DavidMFlynn/SerialMRRC/Parts.txt

Parts

Controller
===================================================
PIC16F15345-I/SO	Microcontroller	20SOIC
THVD1550DR		RS485 Transciever 8SOIC

296-14844-1-ND	SN74HC251DR 1 of 8 selector
296-14847-1-ND	SN74HC259DR IC 8BIT ADDRESSABLE LATCH 16SOIC

MCP2200T-I/SOCT-ND	USB to Serial 20-SOIC
X1037-ND	ECS-120-20-4X 12MHz
ED2982-ND	USB-B1HSW6 USB B

TB001-500-08BE		Terminal Block 8-pos 5mm pitch
ED2739-ND	OSTTE160104	Terminal Block 16-pos 3.5mm pitch

WM4902-ND	0705530003	Connector Header R/A 4 pin
WM2902-ND	0050579404	Connector Recepticle 4 pin
WM2512-ND	0016020103	Conn Socket 22-24AWG Crimp Gold
WM2512CT-ND	0016020087	Conn Socket 22-24AWG Crimp Gold

2449-J114AF2CS12VDC.53-ND  J114AF2CS12VDC.53 12VDC DPDT Relay
SSM6N7002CFULFCT-ND		SSM6N7002CFU,LF		MOSFET 2N-CH 60V 0.17A US6

Signal Head
===================================================
XZM2MR53W-1	Red 0603 LED
XZM2DG53W-1	Green 0603 LED
XZM2ACY53W-1	Yellow 0603 LED
