DavidMFlynn/SerialMRRC/Datasheets/8-bit PIC MCU-2025-03-23.csv

Device Name | Status | 5K Pricing | Program Memory Size (Kbytes) | RAM (bytes) | EEPROM / HEF | Pin count | Max. CPU Speed MHz | Peripheral Pin Select (PPS) | Internal Oscillator | # of Comparators | Operational Amplifier | Total # of A/D channels | Max A/D Resolution (bits) | ADCC with Computation | Number of D/A Converters | Max D/A Resolution (bits) | Internal Voltage Reference (Bandgap) | Zero Cross detect | Slope Compensation / Programmable Ramp Generator | Data Signal Modulator (DSM) | Max 8 Bit Digital Timers | Max 16 Bit Digital Timers | Signal Measurement Timer | Hardware Limit Timer | Max # PWM outputs (including complementary outputs) | Max PWM Resolution (bits) | Angular Timer | Math Accelerator | UART | SPI? | I2C | Number of USB Modules | Windowed Watchdog Timer (WWDT) | CRC/Scan | Configurable Logic Cell Modules (CLC) | Complementary Waveform Generator (CWG) / Complementary Output Generator (COG) | Numerically Controlled Oscillator (NCO) | Programmable switched mode controller | Cap. Touch Channels | Segment LCD | Temp. Range Min. | Temp. Range Max. | Operation Voltage Min.(V) | Operation Voltage Max.(V) | High Voltage Capable | Packages
PIC10F200 | In Production | $0.43 | 0.375 | 16 | 0 | 6 | 44 | No | 4 MHz | 0 | 0 | 0 | 0 | No | 0 | 0 | No | No | 0 | 0 | 1 | 0 | 0 | 0 | 0 | 0 | No | No | 0 | 0 | 0 | 0 | No | No | 0 | 0 | 0 | 0 | 0 | 0 | -40 | 125 | 2 | 5.5 | No | 6/SOT-23,8/DFN,8/PDIP
PIC10F202 | In Production | $0.47 | 0.75 | 24 | 0 | 6 | 4 | No | 4 MHz | 0 | 0 | 0 | 0 | No | 0 | 0 | No | No | 0 | 0 | 1 | 0 | 0 | 0 | 0 | 0 | No | No | 0 | 0 | 0 | 0 | No | No | 0 | 0 | 0 | 0 | 0 | 0 | -40 | 125 | 2 | 5.5 | No | 6/SOT-23,8/DFN,8/PDIP
PIC10F204 | In Production,Please consider device: PIC10F322 | $0.47 | 0.375 | 16 | 0 | 6 | 4 | No | 4 MHz | 1 | 0 | 0 | 0 | No | 0 | 0 | Yes | No | 0 | 0 | 1 | 0 | 0 | 0 | 0 | 0 | No | No | 0 | 0 | 0 | 0 | No | No | 0 | 0 | 0 | 0 | 0 | 0 | -40 | 125 | 2 | 5.5 | No | 6/SOT-23,8/DFN,8/PDIP
PIC10F220 | In Production | $0.47 | 0.375 | 16 | 0 | 6 | 8 | No | 4 MHz, 8 MHz | 0 | 0 | 2 | 8 | No | 0 | 0 | Yes | No | 0 | 0 | 1 | 0 | 0 | 0 | 0 | 0 | No | No | 0 | 0 | 0 | 0 | No | No | 0 | 0 | 0 | 0 | 2 | 0 | -40 | 125 | 2 | 5.5 | No | 6/SOT-23,8/DFN,8/PDIP
PIC10F320 | In Production | $0.47 | 0.448 | 64 | 0 / HEF | 6 | 16 | No | 16 MHz, 32 kHz | 0 | 0 | 3 | 8 | No | 0 | 0 | Yes | No | 0 | 0 | 2 | 0 | 0 | 0 | 4 | 10 | No | No | 0 | 0 | 0 | 0 | No | No | 1 |  | 1 | 0 | 3 | 0 | -40 | 125 | 1.8 | 5.5 | No | 6/SOT-23,8/DFN,8/PDIP
PIC10F206 | In Production | $0.49 | 0.75 | 24 | 0 | 6 | 4 | No | 4 MHz | 1 | 0 | 0 | 0 | No | 0 | 0 | Yes | No | 0 | 0 | 1 | 0 | 0 | 0 | 0 | 0 | No | No | 0 | 0 | 0 | 0 | No | No | 0 | 0 | 0 | 0 | 1 | 0 | -40 | 125 | 2 | 5.5 | No | 6/SOT-23,8/DFN,8/PDIP
PIC10F222 | In Production,Please consider device: PIC10F322 | $0.49 | 0.75 | 23 | 0 | 6 | 8 | No | 4 MHz, 8 MHz | 0 | 0 | 2 | 8 | No | 0 | 0 | Yes | No | 0 | 0 | 1 | 0 | 0 | 0 | 0 | 0 | No | No | 0 | 0 | 0 | 0 | No | No | 0 | 0 | 0 | 0 | 2 | 0 | -40 | 125 | 2 | 5.5 | No | 6/SOT-23,8/DFN,8/PDIP
PIC10F322 | In Production | $0.50 | 0.896 | 64 | 0 / HEF | 6 | 16 | No | 16 MHz, 32 kHz | 0 | 0 | 3 | 8 | No | 0 | 0 | Yes | No | 0 | 0 | 2 | 0 | 0 | 0 | 4 | 10 | No | No | 0 | 0 | 0 | 0 | No | No | 1 |  | 1 | 0 | 3 | 0 | -40 | 125 | 1.8 | 5.5 | No | 6/SOT-23,8/DFN,8/PDIP,14/PDIP
PIC12F1571 | In Production | $0.50 | 1.75 | 128 | 0 / HEF | 8 | 32 | No | 32 MHz, 32 kHz | 1 | 0 | 4 | 10 | No | 1 | 5 | Yes | No | 0 | 0 | 2 | 4 | 0 | 0 | 4 | 16 | No | No | 0 | 0 | 0 | 0 | No | No | 0 |  | 0 | 0 | 4 | 0 | -40 | 125 | 1.8 | 5.5 | No | 8/DFN,8/MSOP,8/PDIP,8/SOIC,8/UDFN
PIC16F54 | In Production | $0.55 | 0.75 | 25 | 0 | 18 | 20 | No | No | 0 | 0 | 0 | 0 | No | 0 | 0 | No | No | 0 | 0 | 1 | 0 | 0 | 0 | 0 | 0 | No | No | 0 | 0 | 0 | 0 | No | No | 0 | 0 | 0 | 0 | 0 | 0 | -40 | 125 | 2 | 5.5 | No | 18/PDIP,18/SOIC,20/SSOP
PIC12F1501 | In Production | $0.56 | 1.75 | 64 | 0 / HEF | 8 | 20 | No | 16 MHz, 32 kHz | 1 | 0 | 4 | 10 | No | 1 | 5 | Yes | No | 0 | 0 | 2 | 1 | 0 | 0 | 5 | 10 | No | No | 0 | 0 | 0 | 0 | No | No | 2 |  | 1 | 0 | 4 | 0 | -40 | 125 | 1.8 | 5.5 | No | 8/DFN,8/MSOP,8/PDIP,8/SOIC,8/UDFN
PIC12F1572 | In Production | $0.56 | 3.5 | 256 | 0 / HEF | 8 | 32 | No | 32 MHz, 32 kHz | 1 | 0 | 4 | 10 | No | 1 | 5 | Yes | No | 0 | 0 | 2 | 4 | 0 | 0 | 4 | 16 | No | No | 1 | 0 | 0 | 0 | No | No | 0 |  | 0 | 0 | 4 | 0 | -40 | 125 | 1.8 | 5.5 | No | 8/DFN,8/MSOP,8/PDIP,8/SOIC,8/UDFN
PIC16F15313 | In Production | $0.56 | 3.5 | 256 | 0 / HEF | 8 | 32 | Yes | 32 MHz, 32 kHz | 1 | 0 | 5 | 10 | No | 1 | 5 | No | Yes | 0 | 0 | 1 | 2 | 0 | 1 | 10 | 10 | No | No | 1 | 1 | 1 | 0 | No | No | 4 | 1 | 1 | 0 | 0 | 0 | -40 | 125 | 1.8 | 5.5 | No | 8/PDIP,8/SOIC,8/UDFN
PIC12F508 | In Production,Please consider device: PIC16F15313 | $0.57 | 0.75 | 25 | 0 | 8 | 4 | No | 4 MHz | 0 | 0 | 0 | 0 | No | 0 | 0 | No | No | 0 | 0 | 1 | 0 | 0 | 0 | 0 | 0 | No | No | 0 | 0 | 0 | 0 | No | No | 0 | 0 | 0 | 0 | 0 | 0 | -40 | 125 | 2 | 5.5 | No | 8/DFN,8/MSOP,8/PDIP,8/SOIC
PIC16F527 | In Production | $0.59 | 1.5 | 68 | 64 / HEF | 20 | 20 | No | 4 MHz, 8 MHz | 2 | 2 | 8 | 8 | No | 0 | 0 | Yes | No | 0 | 0 | 1 | 0 | 0 | 0 | 0 | 0 | No | No | 0 | 0 | 0 | 0 | No | No | 0 | 0 | 0 | 0 | 8 | 0 | -40 | 125 | 2 | 5.5 | No | 20/PDIP,20/QFN,20/SOIC,20/SSOP,20/UQFN
PIC16F15323 | In Production | $0.61 | 3.5 | 256 | 0 / HEF | 14 | 32 | Yes | 32 MHz, 32 kHz | 2 | 0 | 11 | 10 | No | 1 | 5 | No | Yes | 0 | 0 | 1 | 2 | 0 | 1 | 10 | 10 | No | No | 1 | 1 | 1 | 0 | No | No | 4 | 1 | 1 | 0 | 0 | 0 | -40 | 125 | 1.8 | 5.5 | No | 14/PDIP,14/SOIC,14/TSSOP,16/UQFN,16/VQFN
PIC12F509 | In Production,Please consider device: PIC16F15313 | $0.62 | 1.5 | 41 | 0 | 8 | 4 | No | 4 MHz | 0 | 0 | 0 | 0 | No | 0 | 0 | No | No | 0 | 0 | 1 | 0 | 0 | 0 | 0 | 0 | No | No | 0 | 0 | 0 | 0 | No | No | 0 | 0 | 0 | 0 | 0 | 0 | -40 | 125 | 2 | 5.5 | No | 8/DFN,8/MSOP,8/PDIP,8/SOIC,8/SOIJ
PIC12F519 | In Production | $0.64 | 1.5 | 41 | 64 | 8 | 8 | No | 4 MHz, 8 MHz | 0 | 0 | 0 | 0 | No | 0 | 0 | No | No | 0 | 0 | 1 | 0 | 0 | 0 | 0 | 0 | No | No | 0 | 0 | 0 | 0 | No | No | 0 | 0 | 0 | 0 | 0 | 0 | -40 | 125 | 2 | 5.5 | No | 8/DFN,8/MSOP,8/PDIP,8/SOIC
PIC12LF1552 | In Production | $0.64 | 3.5 | 256 | 0 / HEF | 8 | 32 | No | 16 MHz, 32 kHz | 0 | 0 | 5 | 10 | No | 0 | 0 | No | No | 0 | 0 | 1 | 0 | 0 | 0 | 0 | 0 | No | No | 0 | 1 | 1 | 0 | No | No | 0 | 0 | 0 | 0 | 4 | 0 | -40 | 85 | 1.8 | 3.6 | No | 8/MSOP,8/PDIP,8/SOIC,8/UDFN
PIC16F18313 | In Production | $0.64 | 3.5 | 256 | 256 | 8 | 32 | Yes | 32 MHz, 32 kHz | 1 | 0 | 5 | 10 | No | 1 | 5 | Yes | No | 0 | 2 | 2 | 1 | 0 | 0 | 8 | 10 | No | No | 1 | 1 | 1 | 0 | No | No | 2 |  | 1 | 0 | 5 | 0 | -40 | 125 | 1.8 | 5.5 | No | 8/PDIP,8/SOIC,8/UDFN
PIC18F24Q10 | In Production | $0.65 | 16 | 1024 | 256 | 28 | 64 | Yes | 64MHZ, 64KHz | 2 | 0 | 24 | 10 | Yes | 1 | 5 | Yes | Yes | 0 | 1 | 3 | 4 | 0 | 1 | 0 | 10 | No | No | 1 | 1 | 1 | 0 | No | Yes | 0 | 1 | 0 | 0 | 24 | 0 | -40 | 125 | 1.8 | 5.5 | No | 28/QFN,28/SOIC,28/SPDIP,28/SSOP,28/UQFN,28/VQFN
PIC16F15324 | In Production | $0.67 | 7 | 512 | 0 / HEF | 14 | 32 | Yes | 32 MHz, 32 kHz | 2 | 0 | 11 | 10 | No | 1 | 5 | No | Yes | 0 | 0 | 1 | 2 | 0 | 1 | 10 | 10 | No | No | 2 | 1 | 1 | 0 | No | No | 4 | 1 | 1 | 0 | 0 | 0 | -40 | 125 | 1.8 | 5.5 | No | 14/PDIP,14/SOIC,14/TSSOP,16/UQFN,16/VQFN
PIC16F505 | In Production,Please consider device: PIC16F15324 | $0.67 | 1.5 | 72 | 0 | 14 | 20 | No | 4 MHz | 0 | 0 | 0 | 0 | No | 0 | 0 | No | No | 0 | 0 | 1 | 0 | 0 | 0 | 0 | 0 | No | No | 0 | 0 | 0 | 0 | No | No | 0 | 0 | 0 | 0 | 0 | 0 | -40 | 125 | 2 | 5.5 | No | 14/PDIP,14/SOIC,14/TSSOP,16/QFN
PIC12F510 | In Production,Please consider device: PIC16F15313 | $0.68 | 1.5 | 38 | 0 | 8 | 8 | No | 4 MHz, 8 MHz | 1 | 0 | 3 | 8 | No | 0 | 0 | Yes | No | 0 | 0 | 1 | 0 | 0 | 0 | 0 | 0 | No | No | 0 | 0 | 0 | 0 | No | No | 0 | 0 | 0 | 0 | 3 | 0 | -40 | 125 | 2 | 5.5 | No | 8/DFN,8/MSOP,8/PDIP,8/SOIC
PIC12F609 | In Production | $0.68 | 1.75 | 64 | 0 | 8 | 20 | No | 4 MHz, 8 MHz | 1 | 0 | 0 | 0 | No | 0 | 0 | Yes | No | 0 | 0 | 1 | 1 | 0 | 0 | 0 | 0 | No | No | 0 | 0 | 0 | 0 | No | No | 0 | 0 | 0 | 0 | 0 | 0 | -40 | 125 | 2 | 15 | Yes | 8/DFN,8/MSOP,8/PDIP,8/SOIC
PIC16F506 | In Production,Please consider device: PIC16F15324 | $0.68 | 1.5 | 67 | 0 | 14 | 20 | No | 4 MHz, 8 MHz | 2 | 0 | 3 | 8 | No | 0 | 0 | Yes | No | 0 | 0 | 1 | 0 | 0 | 0 | 0 | 0 | No | No | 0 | 0 | 0 | 0 | No | No | 0 | 0 | 0 | 0 | 3 | 0 | -40 | 125 | 2 | 5.5 | No | 14/PDIP,14/SOIC,14/TSSOP
PIC16F1503 | In Production | $0.70 | 3.5 | 128 | 0 / HEF | 14 | 20 | No | 16 MHz | 2 | 0 | 8 | 10 | No | 1 | 5 | Yes | No | 0 | 0 | 2 | 1 | 0 | 0 | 5 | 10 | No | No | 0 | 1 | 1 | 0 | No | No | 2 |  | 1 | 0 | 8 | 0 | -40 | 125 | 1.8 | 5.5 | No | 14/PDIP,14/SOIC,14/TSSOP,16/QFN,16/UQFN
PIC16F18323 | In Production | $0.70 | 3.5 | 256 | 256 | 14 | 32 | Yes | 32 MHz, 32 kHz | 2 | 0 | 11 | 10 | No | 1 | 5 | Yes | No | 0 | 2 | 2 | 1 | 0 | 0 | 8 | 10 | No | No | 1 | 1 | 1 | 0 | No | No | 2 |  | 1 | 0 | 8 | 0 | -40 | 125 | 1.8 | 5.5 | No | 14/PDIP,14/SOIC,14/TSSOP,16/UQFN,16/VQFN
PIC18F25Q10 | In Production | $0.70 | 32 | 2048 | 256 | 28 | 64 | Yes | 64MHZ, 64KHz | 2 | 0 | 24 | 10 | Yes | 1 | 5 | Yes | Yes | 0 | 1 | 3 | 4 | 0 | 1 | 0 | 10 | No | No | 1 | 1 | 1 | 0 | No | Yes | 0 | 1 | 0 | 0 | 24 | 0 | -40 | 125 | 1.8 | 5.5 | No | 28/QFN,28/SOIC,28/SPDIP,28/SSOP,28/VQFN
PIC16F526 | In Production,Please consider device: PIC16F15323 | $0.71 | 1.5 | 67 | 64 | 14 | 20 | No | 4 MHz, 8 MHz | 2 | 0 | 3 | 8 | No | 0 | 0 | Yes | No | 0 | 0 | 1 | 0 | 0 | 0 | 0 | 0 | No | No | 0 | 0 | 0 | 0 | No | No | 0 | 0 | 0 | 0 | 3 | 0 | -40 | 125 | 2 | 5.5 | No | 14/PDIP,14/SOIC,14/TSSOP,16/QFN
PIC16F57 | In Production | $0.71 | 3 | 72 | 0 | 28 | 20 | No | No | 0 | 0 | 0 | 0 | No | 0 | 0 | No | No | 0 | 0 | 1 | 0 | 0 | 0 | 0 | 0 | No | No | 0 | 0 | 0 | 0 | No | No | 0 | 0 | 0 | 0 | 0 | 0 | -40 | 125 | 2 | 5.5 | No | 28/PDIP,28/SOIC,28/SPDIP,28/SSOP
PIC12F1612 | In Production | $0.72 | 3.5 | 256 | 0 / HEF | 8 | 32 | No | 32 MHz, 32 kHz | 1 | 0 | 4 | 10 | No | 0 | 0 | No | Yes | 0 | 0 | 4 | 1 | 2 | 3 | 0 | 0 | No | No | 0 | 0 | 0 | 0 | Yes | Yes | 0 |  | 0 | 0 | 0 | 0 | -40 | 125 | 2.3 | 5.5 | No | 8/DFN,8/PDIP,8/SOIC
PIC12F615 | In Production | $0.77 | 1.75 | 64 | 0 | 8 | 20 | No | 4 MHz, 8 MHz | 1 | 0 | 4 | 10 | No | 0 | 0 | Yes | No | 0 | 0 | 2 | 1 | 0 | 0 | 0 | 10 | No | No | 0 | 0 | 0 | 0 | No | No | 0 | 0 | 0 | 0 | 4 | 0 | -40 | 150 | 2 | 15 | Yes | 8/DFN,8/MSOP,8/PDIP,8/SOIC
PIC12F617 | In Production | $0.77 | 3.5 | 128 | 0 / HEF | 8 | 20 | No | 4 MHz, 8 MHz | 1 | 0 | 4 | 10 | No | 0 | 0 | Yes | No | 0 | 0 | 2 | 1 | 0 | 0 | 0 | 10 | No | No | 0 | 0 | 0 | 0 | No | No | 0 | 0 | 0 | 0 | 4 | 0 | -40 | 125 | 2 | 5.5 | No | 8/DFN,8/MSOP,8/PDIP,8/SOIC
PIC12F752 | In Production,Please consider device: PIC16F1703 | $0.77 | 1.8 | 64 | 0 / HEF | 8 | 20 | No | 8 MHz | 2 | 0 | 4 | 10 | No | 1 | 5 | Yes | No | 0 | 0 | 2 | 1 | 0 | 1 | 2 | 0 | No | No | 0 | 0 | 0 | 0 | No | No | 0 |  | 0 | 0 | 4 | 0 | -40 | 125 | 2 | 5.5 | Yes | 8/DFN,8/PDIP,8/SOIC
PIC16F15325 | In Production | $0.77 | 14 | 1024 | 0 / HEF | 14 | 32 | Yes | 32 MHz, 32 kHz | 2 | 0 | 11 | 10 | No | 1 | 5 | No | Yes | 0 | 0 | 1 | 2 | 0 | 1 | 10 | 10 | No | No | 2 | 1 | 1 | 0 | No | No | 4 | 1 | 1 | 0 | 0 | 0 | -40 | 125 | 1.8 | 5.5 | No | 14/PDIP,14/SOIC,14/TSSOP,16/UQFN,16/VQFN
PIC16F15344 | In Production | $0.77 | 7 | 512 | 0 / HEF | 20 | 32 | Yes | 32 MHz, 32 kHz | 2 | 0 | 17 | 10 | No | 1 | 5 | No | Yes | 0 | 0 | 1 | 2 | 0 | 1 | 10 | 10 | No | No | 2 | 1 | 1 | 0 | No | No | 4 | 1 | 1 | 0 | 0 | 0 | -40 | 125 | 1.8 | 5.5 | No | 20/PDIP,20/QFN,20/SOIC,20/SSOP,20/UQFN
PIC16F1613 | In Production | $0.78 | 3.5 | 256 | 0 / HEF | 14 | 32 | No | 32 MHz, 32 kHz | 2 | 0 | 8 | 10 | No | 1 | 8 | Yes | Yes | 0 | 0 | 4 | 1 | 2 | 3 | 6 | 10 | No | No | 0 | 0 | 0 | 0 | Yes | Yes | 0 | 1 | 0 | 0 | 8 | 0 | -40 | 125 | 1.8 | 5.5 | No | 14/PDIP,14/SOIC,14/TSSOP,16/QFN
PIC16F18324 | In Production | $0.78 | 7 | 512 | 256 | 14 | 32 | Yes | 32 MHz, 32 kHz | 2 | 0 | 11 | 10 | No | 1 | 5 | Yes | No | 0 | 4 | 4 | 3 | 0 | 0 | 14 | 10 | No | No | 1 | 1 | 1 | 0 | No | No | 4 |  | 1 | 0 | 11 | 0 | -40 | 125 | 1.8 | 5.5 | No | 14/PDIP,14/SOIC,14/TSSOP,16/UQFN
PIC16F570 | In Production,Please consider device: PIC16F15354 | $0.78 | 3 | 132 | 64 / HEF | 28 | 20 | No | 4 MHz, 8 MHz | 2 | 2 | 8 | 8 | No | 0 | 0 | Yes | No | 0 | 0 | 1 | 0 | 0 | 0 | 0 | 0 | No | No | 0 | 0 | 0 | 0 | No | No | 0 | 0 | 0 | 0 | 8 | 0 | -40 | 125 | 2 | 5.5 | No | 28/SOIC,28/SPDIP,28/SSOP,28/UQFN
PIC16LF1554 | In Production | $0.78 | 7 | 256 | 0 / HEF | 14 | 32 | No | 32 MHz, 32 kHz | 0 | 0 | 11 | 10 | No | 0 | 0 | No | No | 0 | 0 | 2 | 1 | 0 | 0 | 0 | 0 | No | No | 1 | 1 | 1 | 0 | No | No | 0 | 0 | 0 | 0 | 11 | 0 | -40 | 85 | 1.8 | 3.6 | No | 14/PDIP,14/SOIC,14/TSSOP,16/QFN
PIC18F26Q10 | In Production | $0.78 | 64 | 3615 | 1024 | 28 | 64 | Yes | 64MHZ, 64KHz | 2 | 0 | 24 | 10 | Yes | 1 | 5 | Yes | Yes | 0 | 1 | 3 | 4 | 0 | 1 | 0 | 10 | No | No | 2 | 2 | 2 | 0 | No | Yes | 8 | 1 | 0 | 0 | 24 | 0 | -40 | 125 | 1.8 | 5.5 | No | 28/QFN,28/SOIC,28/SPDIP,28/SSOP,28/VQFN
PIC16F1703 | In Production | $0.81 | 3.5 | 256 | 0 / HEF | 14 | 32 | Yes | 32 MHz, 32 kHz | 0 | 2 | 8 | 10 | No | 0 | 0 | Yes | Yes | 0 | 0 | 2 | 1 | 0 | 0 | 2 | 10 | No | No | 0 | 1 | 1 | 0 | No | No | 0 | 0 | 0 | 0 | 8 | 0 | -40 | 125 | 1.8 | 5.5 | No | 14/PDIP,14/SOIC,14/TSSOP,16/QFN
PIC16F610 | In Production | $0.82 | 1.75 | 64 | 0 | 14 | 20 | No | 4 MHz, 8 MHz | 2 | 0 | 0 | 0 | No | 0 | 0 | Yes | No | 0 | 0 | 1 | 1 | 0 | 0 | 0 | 0 | No | No | 0 | 0 | 0 | 0 | No | No | 0 | 0 | 0 | 0 | 4 | 0 | -40 | 125 | 2 | 15 | Yes | 14/PDIP,14/SOIC,14/TSSOP,16/QFN
PIC16F753 | In Production,Please consider device: PIC16F1703 | $0.82 | 3.5 | 128 | 0 / HEF | 14 | 20 | No | 8 MHz | 2 | 1 | 8 | 10 | No | 1 | 9 | Yes | No | Yes | 0 | 3 | 1 | 0 | 2 | 0 | 0 | No | No | 0 | 0 | 0 | 0 | No | No | 0 | 1 | 0 | 0 | 8 | 0 | -40 | 125 | 2 | 5.5 | Yes | 14/PDIP,14/SOIC,14/TSSOP,16/QFN
PIC16F1574 | In Production | $0.83 | 7 | 512 | 0 / HEF | 14 | 32 | Yes | 32 MHz, 32 kHz | 2 | 0 | 8 | 10 | No | 1 | 5 | Yes | No | 0 | 0 | 2 | 9 | 0 | 0 | 6 | 16 | No | No | 1 | 0 | 0 | 0 | No | No | 0 |  | 0 | 0 | 8 | 0 | -40 | 125 | 1.8 | 5.5 | No | 14/PDIP,14/SOIC,14/TSSOP,16/UQFN
PIC16F15345 | In Production | $0.85 | 14 | 1024 | 0 / HEF | 20 | 32 | Yes | 32 MHz, 32 kHz | 2 | 0 | 17 | 10 | No | 1 | 5 | No | Yes | 0 | 0 | 1 | 2 | 0 | 1 | 10 | 10 | No | No | 2 | 1 | 1 | 0 | No | No | 4 | 1 | 1 | 0 | 0 | 0 | -40 | 125 | 1.8 | 5.5 | No | 20/PDIP,20/QFN,20/SOIC,20/SSOP,20/UQFN,20/VQFN
PIC16F18344 | In Production | $0.85 | 7 | 512 | 256 | 20 | 32 | Yes | 32 MHz, 32 kHz | 2 | 0 | 17 | 10 | No | 1 | 5 | Yes | No | 0 | 4 | 4 | 3 | 0 | 0 | 14 | 10 | No | No | 1 | 1 | 1 | 0 | Yes | No | 4 |  | 1 | 0 | 17 | 0 | -40 | 125 | 1.8 | 5.5 | No | 0/SSOP,20/PDIP,20/SOIC,20/SSOP,20/UQFN,20/VQFN
PIC16F18325 | In Production | $0.86 | 14 | 1024 | 256 | 14 | 32 | Yes | 32 MHz, 32 kHz | 2 | 0 | 11 | 10 | No | 1 | 5 | Yes | No | 0 | 4 | 4 | 3 | 0 | 0 | 14 | 10 | No | No | 1 | 2 | 2 | 0 | Yes | No | 4 |  | 1 | 0 | 11 | 0 | -40 | 125 | 1.8 | 5.5 | No | 14/PDIP,14/SOIC,14/TSSOP,16/UQFN,16/VQFN
PIC16F18424 | In Production | $0.86 | 7 | 512 | 256 | 14 | 32 | Yes | 32 MHz, 32 kHz | 2 | 0 | 11 | 12 | Yes | 1 | 5 | Yes | Yes | 0 | 1 | 4 | 4 | 1 | 3 | 0 | 10 | No | No | 1 | 1 | 1 | 0 | No | No | 4 | 2 | 1 | 0 | 0 | 0 | -40 | 125 | 1.8 | 5.5 | No | 14/PDIP,14/SOIC,14/TSSOP,16/UQFN
PIC12F1822 | In Production | $0.87 | 3.5 | 128 | 256 | 8 | 32 | No | 32 MHz, 32 kHz | 1 | 0 | 4 | 10 | No | 1 | 5 | Yes | No | 0 | 0 | 2 | 1 | 0 | 0 | 2 | 10 | No | No | 1 | 1 | 1 | 0 | No | No | 0 | 0 | 0 | 0 | 4 | 0 | -40 | 125 | 1.8 | 5.5 | No | 8/DFN,8/PDIP,8/SOIC,8/UDFN
PIC16F1704 | In Production | $0.87 | 7 | 512 | 0 / HEF | 14 | 32 | Yes | 32 MHz, 32 kHz | 2 | 2 | 8 | 10 | No | 1 | 8 | Yes | Yes | 0 | 0 | 4 | 1 | 0 | 0 | 8 | 10 | No | No | 1 | 1 | 1 | 0 | No | No | 3 | 1 | 0 | 0 | 8 | 0 | -40 | 125 | 1.8 | 5.5 | No | 14/PDIP,14/SOIC,14/TSSOP,16/QFN
PIC16F1507 | In Production | $0.88 | 3.5 | 128 | 0 / HEF | 20 | 20 | No | 16 MHz, 32 kHz | 0 | 0 | 12 | 10 | No | 1 | 5 | Yes | No | 0 | 0 | 2 | 1 | 0 | 0 | 5 | 10 | No | No | 0 | 0 | 0 | 0 | No | No | 2 |  | 1 | 0 | 12 | 0 | -40 | 125 | 1.8 | 5.5 | No | 20/PDIP,20/QFN,20/SOIC,20/SSOP,20/UQFN
PIC16F15354 | In Production | $0.88 | 7 | 512 | 0 / HEF | 28 | 32 | Yes | 32 MHz, 32 kHz | 2 | 0 | 24 | 10 | No | 1 | 5 | No | Yes | 0 | 0 | 1 | 2 | 0 | 1 | 10 | 10 | No | No | 2 | 2 | 2 | 0 | Yes | No | 4 | 1 | 1 | 0 | 0 | 0 | -40 | 125 | 1.8 | 5.5 | No | 28/QFN,28/SOIC,28/SPDIP,28/SSOP,28/UQFN,28/VQFN
PIC18F27Q10 | In Production | $0.89 | 128 | 3615 | 1024 | 28 | 64 | Yes | 64MHZ, 64KHz | 2 | 0 | 24 | 10 | Yes | 1 | 5 | Yes | Yes | 0 | 1 | 3 | 4 | 0 | 1 | 0 | 10 | No | No | 2 | 2 | 2 | 0 | No | Yes | 8 | 1 | 0 | 0 | 24 | 0 | -40 | 125 | 1.8 | 5.5 | No | 28/QFN,28/SOIC,28/SPDIP,28/SSOP,28/VQFN
PIC12F629 | In Production,Please consider device: PIC16F18313 | $0.91 | 1.75 | 64 | 128 | 8 | 20 | No | 4 MHz | 1 | 0 | 0 | 0 | No | 0 | 0 | No | No | 0 | 0 | 1 | 1 | 0 | 0 | 0 | 0 | No | No | 0 | 0 | 0 | 0 | No | No | 0 | 0 | 0 | 0 | 0 | 0 | -40 | 125 | 2 | 5.5 | No | 8/DFN,8/DFN-S,8/PDIP,8/SOIC
PIC16F1578 | In Production | $0.91 | 7 | 512 | 0 / HEF | 20 | 32 | Yes | 32 MHz, 32 kHz | 2 | 0 | 12 | 10 | No | 1 | 5 | Yes | No | 0 | 0 | 2 | 9 | 0 | 0 | 6 | 16 | No | No | 1 | 0 | 0 | 0 | No | No | 0 |  | 0 | 0 | 12 | 0 | -40 | 125 | 1.8 | 5.5 | No | 20/PDIP,20/SOIC,20/SSOP,20/UQFN
PIC16F1614 | In Production | $0.91 | 7 | 512 | 0 / HEF | 14 | 32 | Yes | 32 MHz, 32 kHz | 2 | 0 | 8 | 10 | No | 1 | 8 | Yes | Yes | 0 | 0 | 4 | 3 | 2 | 3 | 8 | 10 | Yes | Yes | 1 | 1 | 1 | 0 | Yes | Yes | 2 | 1 | 0 | 0 | 8 | 0 | -40 | 125 | 1.8 | 5.5 | No | 14/PDIP,14/SOIC,14/TSSOP,16/QFN
PIC12HV615 | In Production | $0.92 | 1.75 | 64 | 0 | 8 | 20 | No | 4 MHz, 8 MHz | 1 | 0 | 4 | 10 | No | 0 | 0 | Yes | No | 0 | 0 | 2 | 1 | 0 | 0 | 0 | 10 | No | No | 0 | 0 | 0 | 0 | No | No | 0 | 0 | 0 | 0 | 4 | 0 | -40 | 125 | 2 | 15 | Yes | 8/SOIC
PIC16F1575 | In Production | $0.92 | 14 | 1024 | 0 / HEF | 14 | 32 | Yes | 32 MHz, 32 kHz | 2 | 0 | 8 | 10 | No | 1 | 5 | Yes | No | 0 | 0 | 2 | 9 | 0 | 0 | 6 | 16 | No | No | 1 | 0 | 0 | 0 | No | No | 0 |  | 0 | 0 | 8 | 0 | -40 | 125 | 1.8 | 5.5 | No | 14/PDIP,14/SOIC,14/TSSOP,16/UQFN
PIC16F720 | In Production | $0.92 | 3.5 | 128 | 0 / HEF | 20 | 16 | No | 16 MHz | 0 | 0 | 12 | 8 | No | 0 | 0 | Yes | No | 0 | 0 | 2 | 1 | 0 | 0 | 0 | 10 | No | No | 0 | 1 | 1 | 0 | No | No | 0 | 0 | 0 | 0 | 12 | 0 | -40 | 125 | 1.8 | 5.5 | No | 20/PDIP,20/QFN,20/SOIC,20/SSOP
PIC18F25Q43 | In Production | $0.92 | 32 | 2048 | 1024 | 28 | 64 | Yes | 64MHZ | 2 | 0 | 24 | 12 | Yes | 1 | 8 | Yes | Yes | 0 | 1 | 3 | 4 | 1 | 3 | 6 | 16 | No | No | 5 | 2 | 1 | 0 | No | Yes | 8 | 3 | 3 | 0 |  | 0 | -40 | 125 | 1.8 | 5.5 | No | 28/SOIC,28/SPDIP,28/SSOP,28/VQFN
PIC16F18345 | In Production | $0.93 | 14 | 1024 | 256 | 20 | 32 | Yes | 32 MHz, 32 kHz | 2 | 0 | 17 | 10 | No | 1 | 5 | Yes | No | 0 | 4 | 4 | 3 | 0 | 0 | 14 | 10 | No | No | 1 | 2 | 2 | 0 | Yes | No | 4 |  | 1 | 0 | 17 | 0 | -40 | 125 | 1.8 | 5.5 | No | 20/PDIP,20/SOIC,20/SSOP,20/UQFN,20/VQFN
PIC16F18425 | In Production | $0.94 | 14 | 1024 | 256 | 14 | 32 | Yes | 32 MHz, 32 kHz | 2 | 0 | 11 | 12 | Yes | 1 | 5 | Yes | Yes | 0 | 1 | 4 | 4 | 1 | 3 | 0 | 10 | No | No | 1 | 2 | 2 | 0 | No | No | 4 | 2 | 1 | 0 | 0 | 0 | -40 | 125 | 1.8 | 5.5 | No | 14/PDIP,14/SOIC,14/TSSOP,16/UQFN
PIC16F18854 | In Production | $0.94 | 7 | 512 | 256 | 28 | 32 | Yes | 32 MHz, 32 kHz | 2 | 0 | 24 | 10 | Yes | 1 | 5 | Yes | Yes | 0 | 1 | 3 | 4 | 2 | 3 | 19 | 10 | No | No | 1 | 2 | 2 | 0 | No | Yes | 4 | 3 | 1 | 0 | 24 | 0 | -40 | 125 | 1.8 | 5.5 | No | 28/QFN,28/SOIC,28/SPDIP,28/SSOP,28/UQFN,28/VQFN
PIC16F1705 | In Production | $0.95 | 14 | 1024 | 0 / HEF | 14 | 32 | Yes | 32 MHz, 32 kHz | 2 | 2 | 8 | 10 | No | 1 | 8 | Yes | Yes | 0 | 0 | 4 | 1 | 0 | 0 | 8 | 10 | No | No | 1 | 1 | 1 | 0 | No | No | 3 | 1 | 0 | 0 | 8 | 0 | -40 | 125 | 1.8 | 5.5 | No | 0/TSSOP,14/PDIP,14/SOIC,14/TSSOP,16/QFN
PIC16F616 | In Production,Please consider device: PIC16F15323 | $0.95 | 3.5 | 128 | 0 | 14 | 20 | No | 4 MHz, 8 MHz | 2 | 0 | 8 | 10 | No | 0 | 0 | Yes | No | 0 | 0 | 2 | 1 | 0 | 0 | 0 | 10 | No | No | 0 | 0 | 0 | 0 | No | No | 0 | 0 | 0 | 0 | 4 | 0 | -40 | 150 | 2 | 15 | Yes | 14/PDIP,14/SOIC,14/TSSOP,16/QFN
PIC16LF1559 | In Production | $0.95 | 14 | 512 | 0 | 20 | 32 | No | 16 MHz | 0 | 0 | 17 | 10 | No | 0 | 0 | No | No | 0 | 0 | 2 | 1 | 0 | 0 | 0 | 0 | No | No | 1 | 1 | 1 | 0 | No | No | 0 | 0 | 0 | 0 | 17 | 0 | -40 | 85 | 1.8 | 3.6 | No | 20/PDIP,20/QFN,20/SSOP,20/UQFN
PIC16F15355 | In Production | $0.96 | 14 | 1024 | 0 / HEF | 28 | 32 | Yes | 32 MHz, 32 kHz | 2 | 0 | 24 | 10 | No | 1 | 5 | No | Yes | 0 | 0 | 1 | 2 | 0 | 1 | 10 | 10 | No | No | 2 | 2 | 2 | 0 | No | No | 4 | 1 | 1 | 0 | 0 | 0 | -40 | 125 | 1.8 | 5.5 | No | 28/QFN,28/SOIC,28/SPDIP,28/SSOP,28/UQFN,28/VQFN
PIC16F1618 | In Production | $0.96 | 7 | 512 | 0 / HEF | 20 | 32 | Yes | 32 MHz, 32 kHz | 2 | 0 | 12 | 10 | No | 1 | 8 | Yes | Yes | 0 | 0 | 4 | 3 | 2 | 3 | 8 | 10 | Yes | Yes | 1 | 1 | 1 | 0 | Yes | Yes | 2 | 1 | 0 | 0 | 12 | 0 | -40 | 125 | 1.8 | 5.5 | No | 14/PDIP,20/PDIP,20/QFN,20/SOIC,20/SSOP,20/UQFN
PIC16F721 | In Production | $0.96 | 7 | 256 | 0 / HEF | 20 | 16 | No | 16 MHz | 0 | 0 | 12 | 8 | No | 0 | 0 | Yes | No | 0 | 0 | 2 | 1 | 0 | 0 | 0 | 10 | No | No | 1 | 1 | 1 | 0 | No | No | 0 | 0 | 0 | 0 | 12 | 0 | -40 | 125 | 1.8 | 5.5 | No | 20/PDIP,20/QFN,20/SOIC,20/SSOP
PIC18F45Q10 | In Production | $0.97 | 32 | 2048 | 256 | 40 | 64 | Yes | 64MHZ, 64KHz | 2 | 0 | 35 | 10 | Yes | 1 | 5 | Yes | Yes | 0 | 1 | 3 | 4 | 0 | 1 | 0 | 10 | No | No | 2 | 2 | 2 | 0 | No | Yes | 8 | 1 | 0 | 0 | 35 | 0 | -40 | 125 | 1.8 | 5.5 | No | 40/PDIP,40/QFN,44/TQFP
PIC16F18444 | In Production | $0.98 | 7 | 512 | 256 | 20 | 32 | Yes | 32 MHz, 32 kHz | 2 | 0 | 17 | 12 | Yes | 1 | 5 | Yes | Yes | 0 | 1 | 4 | 4 | 1 | 3 | 0 | 10 | No | No | 1 | 1 | 1 | 0 | No | No | 4 | 2 | 1 | 0 | 0 | 0 | -40 | 125 | 1.8 | 5.5 | No | 20/PDIP,20/SOIC,20/SSOP,20/UQFN
PIC16F1508 | In Production | $1.00 | 7 | 256 | 0 / HEF | 20 | 20 | No | 16 MHz, 32 kHz | 2 | 0 | 12 | 10 | No | 1 | 5 | Yes | No | 0 | 0 | 2 | 1 | 0 | 0 | 5 | 10 | No | No | 1 | 1 | 1 | 0 | No | No | 4 |  | 1 | 0 | 12 | 0 | -40 | 125 | 1.8 | 5.5 | No | 20/PDIP,20/QFN,20/SOIC,20/SSOP,20/UQFN
PIC16F1824 | In Production | $1.00 | 7 | 256 | 256 | 14 | 32 | No | 32 MHz, 32 kHz | 2 | 0 | 8 | 10 | No | 1 | 5 | Yes | No | 0 | 1 | 4 | 1 | 0 | 0 | 8 | 0 | No | No | 1 | 1 | 1 | 0 | Yes | No | 0 | 0 | 0 | 0 | 8 | 0 | -40 | 150 | 1.8 | 5.5 | No | 14/PDIP,14/SOIC,14/TSSOP,16/QFN,16/UQFN,28/UQFN
PIC18F46Q10 | In Production | $1.00 | 64 | 3615 | 1024 | 40 | 64 | Yes | 64MHZ, 64KHz | 2 | 0 | 35 | 10 | Yes | 1 | 5 | Yes | Yes | 0 | 1 | 3 | 4 | 0 | 1 | 0 | 10 | No | No | 2 | 2 | 2 | 0 | No | Yes | 8 | 1 | 0 | 0 | 35 | 0 | -40 | 125 | 1.8 | 5.5 | No | 40/PDIP,40/QFN,44/TQFP
PIC12F1840 | In Production | $1.01 | 7 | 256 | 256 | 8 | 32 | No | 32 MHz, 32 kHz | 1 | 0 | 4 | 10 | No | 1 | 5 | Yes | No | 0 | 0 | 2 | 1 | 0 | 0 | 2 | 10 | No | No | 1 | 1 | 1 | 0 | No | No | 0 | 0 | 0 | 0 | 4 | 0 | -40 | 125 | 1.8 | 5.5 | No | 8/DFN,8/PDIP,8/SOIC,8/UDFN
PIC12F675 | In Production,Please consider device: PIC16F18313 | $1.01 | 1.75 | 64 | 128 | 8 | 20 | No | 4 MHz | 1 | 0 | 4 | 10 | No | 0 | 0 | No | No | 0 | 0 | 1 | 1 | 0 | 0 | 0 | 0 | No | No | 0 | 0 | 0 | 0 | No | No | 0 | 0 | 0 | 0 | 4 | 0 | -40 | 125 | 2 | 5.5 | No | 8/DFN,8/DFN-S,8/PDIP,8/SOIC
PIC16F1579 | In Production | $1.01 | 14 | 1024 | 0 / HEF | 20 | 32 | Yes | 32 MHz, 32 kHz | 2 | 0 | 12 | 10 | No | 1 | 5 | Yes | No | 0 | 0 | 2 | 9 | 0 | 0 | 6 | 16 | No | No | 1 | 0 | 0 | 0 | No | No | 0 |  | 0 | 0 | 12 | 0 | -40 | 125 | 1.8 | 5.5 | No | 20/PDIP,20/SOIC,20/SSOP,20/UQFN
PIC16F1707 | In Production | $1.01 | 3.5 | 256 | 0 / HEF | 20 | 32 | Yes | 32 MHz, 32 kHz | 0 | 2 | 12 | 10 | No | 0 | 0 | Yes | Yes | 0 | 0 | 2 | 1 | 0 | 0 | 2 | 10 | No | No | 0 | 1 | 1 | 0 | No | No | 0 | 0 | 0 | 0 | 12 | 0 | -40 | 125 | 1.8 | 5.5 | No | 20/PDIP,20/QFN,20/SOIC,20/SSOP
PIC16F1823 | In Production | $1.01 | 3.5 | 128 | 256 | 14 | 32 | No | 32 MHz, 32 kHz | 2 | 0 | 8 | 10 | No | 1 | 5 | Yes | No | 0 | 1 | 2 | 1 | 0 | 0 | 4 | 0 | No | No | 1 | 1 | 1 | 0 | No | No | 0 | 0 | 0 | 0 | 8 | 0 | -40 | 125 | 1.8 | 5.5 | No | 14/PDIP,14/SOIC,14/TSSOP,16/QFN,16/UQFN
PIC16F18346 | In Production | $1.02 | 28 | 2048 | 256 | 20 | 32 | Yes | 32 MHz, 32 kHz | 2 | 0 | 17 | 10 | Yes | 1 | 5 | Yes | Yes | 0 | 1 | 4 | 3 | 1 | 3 | 0 | 10 | No | No | 1 | 2 | 2 | 0 | No | No | 4 | 2 | 1 | 0 | 17 | 0 | -40 | 125 | 1.8 | 5.5 | No | 0/SSOP,20/PDIP,20/QFN,20/SOIC,20/SSOP,20/UQFN,20/VQFN
PIC16F722A | In Production | $1.02 | 3.5 | 128 | 0 / HEF | 28 | 20 | No | 16 MHz | 0 | 0 | 11 | 8 | No | 0 | 0 | Yes | No | 0 | 0 | 2 | 1 | 0 | 0 | 0 | 10 | No | No | 1 | 1 | 1 | 0 | No | No | 0 | 0 | 0 | 0 | 8 | 0 | -40 | 125 | 1.8 | 5.5 | No | 28/QFN,28/SOIC,28/SPDIP,28/SSOP,28/UQFN
PIC16LF1902 | In Production | $1.02 | 3.5 | 128 | 0 / HEF | 28 | 20 | No | 16 MHz, 32 kHz | 0 | 0 | 11 | 10 | No | 0 | 0 | No | No | 0 | 0 | 1 | 1 | 0 | 0 | 0 | 0 | No | No | 0 | 0 | 0 | 0 | No | No | 0 | 0 | 0 | 0 | 11 | 72 | -40 | 125 | 1.8 | 3.6 | No | 28/SOIC,28/SPDIP,28/SSOP,28/UQFN
PIC18F26Q43 | In Production | $1.02 | 64 | 4096 | 1024 | 28 | 64 | Yes | 64MHZ | 2 | 0 | 24 | 12 | Yes | 1 | 8 | Yes | Yes | 0 | 1 | 3 | 4 | 1 | 3 | 6 | 16 | No | No | 5 | 2 | 1 | 0 | No | Yes | 8 | 3 | 3 | 0 |  | 0 | -40 | 125 | 1.8 | 5.5 | No | 28/SOIC,28/SPDIP,28/SSOP,28/VQFN
PIC16F1509 | In Production | $1.04 | 14 | 512 | 0 / HEF | 20 | 20 | No | 16 MHz, 32 kHz | 2 | 0 | 12 | 10 | No | 1 | 5 | Yes | No | 0 | 0 | 2 | 1 | 0 | 0 | 5 | 10 | No | No | 1 | 1 | 1 | 0 | No | No | 4 |  | 1 | 0 | 12 | 0 | -40 | 125 | 1.8 | 5.5 | No | 20/PDIP,20/QFN,20/SOIC,20/SSOP,20/UQFN,28/SPDIP
PIC16F18426 | In Production | $1.04 | 28 | 2048 | 256 | 14 | 32 | Yes | 32 MHz, 32 kHz | 2 | 0 | 11 | 12 | Yes | 1 | 5 | Yes | Yes | 0 | 1 | 4 | 4 | 1 | 3 | 0 | 10 | No | No | 1 | 2 | 2 | 0 | No | No | 4 | 2 | 1 | 0 | 0 | 0 | -40 | 125 | 1.8 | 5.5 | No | 14/PDIP,14/SOIC,14/TSSOP,16/QFN,16/UQFN
PIC16F18855 | In Production | $1.04 | 14 | 1024 | 256 | 28 | 32 | Yes | 32 MHz, 32 kHz | 2 | 0 | 24 | 10 | Yes | 1 | 5 | Yes | Yes | 0 | 1 | 3 | 4 | 2 | 3 | 19 | 10 | No | No | 1 | 2 | 2 | 0 | No | Yes | 4 | 3 | 1 | 0 | 24 | 0 | -40 | 125 | 1.8 | 5.5 | No | 28/QFN,28/SOIC,28/SPDIP,28/SSOP,28/UQFN
PIC16F1512 | In Production | $1.05 | 3.5 | 128 | 0 / HEF | 28 | 20 | No | 16 MHz, 32 kHz | 0 | 0 | 17 | 10 | No | 0 | 0 | Yes | No | 0 | 0 | 2 | 1 | 0 | 0 | 0 | 0 | No | No | 1 | 1 | 1 | 0 | No | No | 0 | 0 | 0 | 0 | 17 | 0 | -40 | 125 | 1.8 | 5.5 | No | 28/SOIC,28/SPDIP,28/SSOP,28/UQFN
PIC16F1615 | In Production | $1.05 | 14 | 1024 | 0 / HEF | 14 | 32 | Yes | 32 MHz, 32 kHz | 2 | 0 | 8 | 10 | No | 1 | 8 | Yes | Yes | 0 | 0 | 4 | 3 | 2 | 3 | 8 | 10 | Yes | Yes | 1 | 1 | 1 | 0 | Yes | Yes | 4 | 1 | 0 | 0 | 8 | 0 | -40 | 125 | 1.8 | 5.5 | No | 14/PDIP,14/SOIC,14/TSSOP,16/QFN
PIC16F15356 | In Production | $1.06 | 28 | 2048 | 0 / HEF | 28 | 32 | Yes | 32 MHz, 32 kHz | 2 | 0 | 24 | 10 | No | 1 | 5 | No | Yes | 0 | 0 | 1 | 2 | 0 | 1 | 10 | 10 | No | No | 2 | 2 | 2 | 0 | No | No | 4 | 1 | 1 | 0 | 0 | 0 | -40 | 125 | 1.8 | 5.5 | No | 28/QFN,28/SOIC,28/SPDIP,28/SSOP,28/UQFN,28/VQFN
PIC16F18445 | In Production | $1.06 | 14 | 1024 | 256 | 20 | 32 | Yes | 32 MHz, 32 kHz | 2 | 0 | 17 | 12 | Yes | 1 | 5 | Yes | Yes | 0 | 1 | 4 | 4 | 1 | 3 | 0 | 10 | No | No | 1 | 2 | 2 | 0 | No | No | 4 | 2 | 1 | 0 | 0 | 0 | -40 | 125 | 1.8 | 5.5 | No | 20/PDIP,20/SOIC,20/SSOP,20/UQFN
PIC18F24K40 | In Production | $1.06 | 16 | 1024 | 256 | 28 | 64 | Yes | 64MHZ, 64KHz | 2 | 0 | 24 | 10 | Yes | 1 | 5 | Yes | Yes | 0 | 1 | 3 | 4 | 0 | 1 | 0 | 10 | No | No | 1 | 1 | 1 | 0 | Yes | Yes | 0 | 1 | 0 | 0 | 24 | 0 | -40 | 125 | 1.8 | 5.5 | No | 28/QFN,28/SOIC,28/SPDIP,28/SSOP,28/UQFN
PIC16F1708 | In Production | $1.07 | 7 | 512 | 0 / HEF | 20 | 32 | Yes | 32 MHz, 32 kHz | 2 | 2 | 12 | 10 | No | 1 | 8 | Yes | Yes | 0 | 0 | 4 | 1 | 0 | 0 | 8 | 10 | No | No | 1 | 1 | 1 | 0 | No | No | 3 | 1 | 0 | 0 | 12 | 0 | -40 | 125 | 1.8 | 5.5 | No | 20/PDIP,20/QFN,20/SOIC,20/SSOP,20/UQFN
PIC16LF1566 | In Production | $1.08 | 14 | 1024 | 0 | 28 | 32 | No | 16 MHz | 0 | 0 | 23 | 10 | No | 0 | 0 | No | No | 0 | 0 | 3 | 1 | 0 | 0 | 0 | 0 | No | No | 1 | 2 | 2 | 0 | No | No | 0 | 0 | 0 | 0 | 23 | 0 | -40 | 85 | 1.8 | 3.6 | No | 28/SOIC,28/SPDIP,28/SSOP,28/UQFN
PIC18F47Q10 | In Production | $1.08 | 128 | 3615 | 1024 | 40 | 64 | Yes | 64MHZ, 64KHz | 2 | 0 | 35 | 10 | Yes | 1 | 5 | Yes | Yes | 0 | 1 | 3 | 4 | 0 | 1 | 6 | 10 | No | No | 2 | 2 | 2 | 0 | No | Yes | 8 | 1 | 0 | 0 | 35 | 0 | -40 | 125 | 1.8 | 5.5 | No | 40/PDIP,40/QFN,44/TQFP
PIC16F18446 | In Production | $1.09 | 28 | 2048 | 256 | 20 | 32 | Yes | 32 MHz, 32 kHz | 2 | 0 | 17 | 12 | Yes | 1 | 5 | Yes | Yes | 0 | 1 | 4 | 4 | 1 | 3 | 0 | 10 | No | No | 1 | 2 | 2 | 0 | No | No | 4 | 2 | 1 | 0 | 0 | 0 | -40 | 125 | 1.8 | 5.5 | No | 20/PDIP,20/SOIC,20/SSOP,20/UQFN
PIC16F1619 | In Production | $1.10 | 14 | 1024 | 0 / HEF | 20 | 32 | Yes | 32 MHz, 32 kHz | 2 | 0 | 12 | 10 | No | 1 | 8 | Yes | Yes | 0 | 0 | 4 | 3 | 2 | 3 | 8 | 10 | Yes | Yes | 1 | 1 | 1 | 0 | Yes | Yes | 4 | 1 | 0 | 0 | 12 | 0 | -40 | 125 | 1.8 | 5.5 | No | 20/PDIP,20/QFN,20/SOIC,20/SSOP,20/UQFN,100/TQFP
PIC16F723A | In Production | $1.10 | 7 | 192 | 0 / HEF | 28 | 20 | No | 16 MHz | 0 | 0 | 11 | 8 | No | 0 | 0 | Yes | No | 0 | 0 | 2 | 1 | 0 | 0 | 0 | 10 | No | No | 1 | 1 | 1 | 0 | No | No | 0 | 0 | 0 | 0 | 8 | 0 | -40 | 125 | 1.8 | 5.5 | No | 28/QFN,28/SOIC,28/SPDIP,28/SSOP,28/UQFN
PIC16LF1903 | In Production | $1.10 | 7 | 256 | 0 / HEF | 28 | 20 | No | 16 MHz, 32 kHz | 0 | 0 | 11 | 10 | No | 0 | 0 | No | No | 0 | 0 | 1 | 1 | 0 | 0 | 0 | 0 | No | No | 0 | 0 | 0 | 0 | No | No | 0 | 0 | 0 | 0 | 11 | 72 | -40 | 125 | 1.8 | 3.6 | No | 28/SOIC,28/SPDIP,28/SSOP,28/UQFN
PIC12C508A | Not Recommended for new designs,Please consider device: PIC12F508 | $1.12 | 0.75 | 25 | 0 | 8 | 4 | No | 5 MHz | 0 | 0 | 0 | 0 | No | 0 | 0 | No | No | 0 | 0 | 1 | 0 | 0 | 0 | 0 | 0 | No | No | 0 | 0 | 0 | 0 | No | No | 0 | 0 | 0 | 0 | 0 | 0 | -40 | 125 | 2.5 | 5.5 | No | 8/PDIP,8/SOIC,8/SOIJ
PIC16F1454 | In Production | $1.12 | 14 | 1024 | 0 / HEF | 14 | 48 | No | 16 MHz, 32 kHz | 0 | 0 | 0 | 0 | No | 0 | 0 | No | No | 0 | 0 | 1 | 1 | 0 | 0 | 2 | 0 | No | No | 1 | 1 | 1 | 1 | No | No | 0 | 0 | 0 | 0 | 0 | 0 | -40 | 125 | 1.8 | 5.5 | No | 14/PDIP,14/SOIC,14/TSSOP,16/QFN,16/UQFN
PIC16F15385 | In Production | $1.12 | 14 | 1024 | 0 / HEF | 48 | 32 | Yes | 32 MHz, 32 kHz | 2 | 0 | 43 | 10 | No | 1 | 5 | No | Yes | 0 | 0 | 1 | 2 | 0 | 1 | 10 | 10 | No | No | 2 | 2 | 2 | 0 | No | No | 4 | 1 | 1 | 0 | 0 | 0 | -40 | 125 | 1.8 | 5.5 | No | 48/TQFP,48/UQFN
PIC16F15386 | In Production | $1.12 | 28 | 2048 | 0 / HEF | 48 | 32 | Yes | 32 MHz, 32 kHz | 2 | 0 | 43 | 10 | No | 1 | 5 | No | Yes | 0 | 0 | 1 | 2 | 0 | 1 | 10 | 10 | No | No | 2 | 2 | 2 | 0 | No | No | 4 | 1 | 1 | 0 | 0 | 0 | -40 | 125 | 1.8 | 5.5 | No | 48/TQFP,48/UQFN,48/VQFN
PIC16F1513 | In Production | $1.13 | 7 | 256 | 0 / HEF | 28 | 20 | No | 16 MHz, 32 kHz | 0 | 0 | 17 | 10 | No | 0 | 0 | Yes | No | 0 | 0 | 2 | 1 | 0 | 0 | 0 | 0 | No | No | 1 | 1 | 1 | 0 | No | No | 0 | 0 | 0 | 0 | 17 | 0 | -40 | 125 | 1.8 | 5.5 | No | 28/SOIC,28/SPDIP,28/SSOP,28/UQFN
PIC16F1709 | In Production | $1.13 | 14 | 1024 | 0 / HEF | 20 | 32 | Yes | 32 MHz, 32 kHz | 2 | 2 | 12 | 10 | No | 1 | 8 | Yes | Yes | 0 | 0 | 4 | 1 | 0 | 0 | 8 | 10 | No | No | 1 | 1 | 1 | 0 | No | No | 3 | 1 | 0 | 0 | 12 | 0 | -40 | 125 | 1.8 | 5.5 | No | 20/PDIP,20/QFN,20/SOIC,20/SSOP
PIC16F18326 | In Production | $1.13 | 28 | 2048 | 256 | 14 | 32 | Yes | 32 MHz, 32 kHz | 2 | 0 | 11 | 10 | No | 1 | 5 | Yes | No | 0 | 4 | 4 | 3 | 0 | 0 | 14 | 10 | No | No | 1 | 2 | 2 | 0 | No | No | 4 |  | 1 | 0 | 15 | 0 | -40 | 125 | 1.8 | 5.5 | No | 14/PDIP,14/SOIC,14/TSSOP,16/UQFN,16/VQFN
PIC16F18856 | In Production | $1.13 | 28 | 2048 | 256 | 28 | 32 | Yes | 32 MHz, 32 kHz | 2 | 0 | 24 | 10 | Yes | 1 | 5 | Yes | Yes | 0 | 1 | 3 | 4 | 2 | 3 | 19 | 10 | No | No | 1 | 2 | 2 | 0 | No | Yes | 4 | 3 | 1 | 0 | 24 | 0 | -40 | 125 | 1.8 | 5.5 | No | 28/QFN,28/SOIC,28/SPDIP,28/SSOP,28/UQFN,28/VQFN
PIC18F25K40 | In Production | $1.13 | 32 | 2048 | 256 | 28 | 64 | Yes | 64MHZ, 64KHz | 2 | 0 | 24 | 10 | Yes | 1 | 5 | Yes | Yes | 0 | 1 | 3 | 4 | 0 | 1 | 0 | 10 | No | No | 1 | 1 | 1 | 0 | Yes | Yes | 0 | 1 | 0 | 0 | 24 | 0 | -40 | 125 | 1.8 | 5.5 | No | 28/QFN,28/SOIC,28/SPDIP,28/SSOP,28/UQFN
PIC16F15375 | In Production | $1.14 | 14 | 1024 | 0 / HEF | 40 | 32 | Yes | 32 MHz, 32 kHz | 2 | 0 | 35 | 10 | No | 1 | 5 | No | Yes | 0 | 0 | 1 | 2 | 0 | 1 | 10 | 10 | No | No | 2 | 2 | 2 | 0 | No | No | 4 | 1 | 1 | 0 | 0 | 0 | -40 | 125 | 1.8 | 5.5 | No | 40/PDIP,40/UQFN,44/QFN,44/TQFP
PIC18F27Q43 | In Production | $1.14 | 128 | 8192 | 1024 | 28 | 64 | Yes | 64MHZ | 2 | 0 | 24 | 12 | Yes | 1 | 8 | Yes | Yes | 0 | 1 | 3 | 4 | 1 | 3 | 6 | 16 | No | No | 5 | 2 | 1 | 0 | No | Yes | 8 | 3 | 3 | 0 |  | 0 | -40 | 125 | 1.8 | 5.5 | No | 28/SOIC,28/SPDIP,28/SSOP,28/VQFN
PIC12F635 | In Production,Please consider device: PIC16F18323 | $1.16 | 1.75 | 64 | 128 | 8 | 20 | No | 8 MHz, 32 kHz | 1 | 0 | 0 | 0 | No | 0 | 0 | No | No | 0 | 0 | 1 | 1 | 0 | 0 | 0 | 0 | No | No | 0 | 0 | 0 | 0 | No | No | 0 | 0 | 0 | 0 | 0 | 0 | -40 | 125 | 2 | 5.5 | No | 8/DFN,8/DFN-S,8/PDIP,8/SOIC
PIC16F18455 | In Production | $1.16 | 14 | 1024 | 256 | 28 | 32 | Yes | 32 MHz, 32 kHz | 2 | 0 | 24 | 12 | Yes | 1 | 5 | Yes | Yes | 0 | 1 | 4 | 4 | 2 | 3 | 0 | 10 | No | No | 2 | 2 | 2 | 0 | No | No | 4 | 3 | 1 | 0 | 0 | 0 | -40 | 125 | 1.8 | 5.5 | No | 28/SOIC,28/SPDIP,28/SSOP,28/VQFN
PIC18F45Q43 | In Production | $1.16 | 32 | 2048 | 1024 | 40 | 64 | Yes | 64MHZ | 2 | 0 | 35 | 12 | Yes | 1 | 8 | Yes | Yes | 0 | 1 | 3 | 4 | 1 | 3 | 6 | 16 | No | No | 5 | 2 | 1 | 0 | No | Yes | 8 | 3 | 3 | 0 |  | 0 | -40 | 125 | 1.8 | 5.5 | No | 40/PDIP,40/QFN,44/TQFP
PIC12C509A | Not Recommended for new designs,Please consider device: PIC12F509 | $1.18 | 1.5 | 41 | 0 | 8 | 4 | No | 7 MHz | 0 | 0 | 0 | 0 | No | 0 | 0 | No | No | 0 | 0 | 1 | 0 | 0 | 0 | 0 | 0 | No | No | 0 | 0 | 0 | 0 | No | No | 0 | 0 | 0 | 0 | 0 | 0 | -40 | 125 | 2.5 | 5.5 | No | 8/PDIP,8/SOIC,8/SOIJ
PIC16F1764 | In Production | $1.19 | 7 | 512 | 0 / HEF | 14 | 32 | Yes | 32 MHz, 32 kHz | 2 | 1 | 8 | 10 | No | 2 | 10 | Yes | Yes | Yes | 1 | 4 | 3 | 0 | 3 | 6 | 16 | No | No | 1 | 1 | 1 | 0 | No | No | 3 | 1 | 0 | 0 | 0 | 0 | -40 | 125 | 1.8 | 5.5 | No | 14/PDIP,14/SOIC,14/TSSOP,16/QFN
PIC16F1825 | In Production | $1.19 | 14 | 1024 | 256 | 14 | 32 | No | 32 MHz, 32 kHz | 2 | 0 | 8 | 10 | No | 1 | 5 | Yes | No | 0 | 1 | 4 | 1 | 0 | 0 | 8 | 10 | No | No | 1 | 1 | 1 | 0 | No | No | 0 | 0 | 0 | 0 | 12 | 0 | -40 | 125 | 1.8 | 5.5 | No | 14/PDIP,14/SOIC,14/TSSOP,16/QFN,16/UQFN
PIC16LF1906 | In Production | $1.19 | 14 | 512 | 0 / HEF | 28 | 20 | No | 16 MHz, 32 kHz | 0 | 0 | 11 | 10 | No | 0 | 0 | No | No | 0 | 0 | 1 | 1 | 0 | 0 | 0 | 0 | No | No | 1 | 0 | 0 | 0 | No | No | 0 | 0 | 0 | 0 | 11 | 72 | -40 | 125 | 1.8 | 3.6 | No | 28/SOIC,28/SPDIP,28/SSOP,28/UQFN
PIC16F1713 | In Production | $1.20 | 7 | 512 | 0 / HEF | 28 | 32 | Yes | 32 MHz, 32 kHz | 2 | 2 | 17 | 10 | No | 2 | 8 | Yes | Yes | 0 | 0 | 4 | 1 | 0 | 0 | 0 | 10 | No | No | 1 | 1 | 1 | 0 | No | No | 4 | 1 | 1 | 0 | 17 | 0 | -40 | 125 | 1.8 | 5.5 | No | 28/QFN,28/SOIC,28/SPDIP,28/SSOP,28/UQFN
PIC16F59 | In Production | $1.22 | 3 | 134 | 0 | 40 | 20 | No | No | 0 | 0 | 0 | 0 | No | 0 | 0 | No | No | 0 | 0 | 1 | 0 | 0 | 0 | 0 | 0 | No | No | 0 | 0 | 0 | 0 | No | No | 0 | 0 | 0 | 0 | 0 | 0 | -40 | 125 | 2 | 5.5 | No | 40/PDIP,44/TQFP
PIC16F1516 | In Production | $1.24 | 14 | 512 | 0 / HEF | 28 | 20 | No | 16 MHz, 32 kHz | 0 | 0 | 17 | 10 | No | 0 | 0 | Yes | No | 0 | 0 | 2 | 1 | 0 | 0 | 0 | 0 | No | No | 1 | 1 | 1 | 0 | No | No | 0 | 0 | 0 | 0 | 17 | 0 | -40 | 125 | 1.8 | 5.5 | No | 28/QFN,28/SOIC,28/SPDIP,28/SSOP,28/UQFN
PIC16F18456 | In Production | $1.24 | 28 | 2048 | 256 | 28 | 32 | Yes | 32 MHz, 32 kHz | 2 | 0 | 24 | 12 | Yes | 1 | 5 | Yes | Yes | 0 | 1 | 4 | 4 | 2 | 3 | 0 | 10 | No | No | 2 | 2 | 2 | 0 | No | No | 4 | 3 | 1 | 0 | 0 | 0 | -40 | 125 | 1.8 | 5.5 | No | 28/SOIC,28/SPDIP,28/SSOP,28/VQFN
PIC16F18875 | In Production | $1.24 | 14 | 1024 | 256 | 40 | 32 | Yes | 32 MHz, 32 kHz | 2 | 0 | 35 | 10 | Yes | 1 | 5 | Yes | Yes | 0 | 1 | 3 | 4 | 2 | 3 | 19 | 10 | No | No | 1 | 2 | 2 | 0 | No | Yes | 4 | 3 | 1 | 0 | 35 | 0 | -40 | 125 | 1.8 | 5.5 | No | 40/PDIP,40/UQFN,44/QFN,44/TQFP
PIC16F722 | In Production,Please consider device: PIC16F722A | $1.24 | 3.5 | 128 | 0 / HEF | 28 | 20 | No | 16 MHz | 0 | 0 | 11 | 8 | No | 0 | 0 | Yes | No | 0 | 0 | 2 | 1 | 0 | 0 | 0 | 10 | No | No | 1 | 1 | 1 | 0 | No | No | 0 | 0 | 0 | 0 | 8 | 0 | -40 | 125 | 1.8 | 5.5 | No | 28/QFN,28/SOIC,28/SPDIP,28/SSOP
PIC18F26K40 | In Production | $1.24 | 64 | 3728 | 1024 | 28 | 64 | Yes | 64MHZ, 64KHz | 2 | 0 | 24 | 10 | Yes | 1 | 5 | Yes | Yes | 0 | 1 | 3 | 4 | 0 | 1 | 0 | 10 | No | No | 2 | 2 | 2 | 0 | Yes | Yes | 0 | 1 | 0 | 0 | 24 | 0 | -40 | 125 | 1.8 | 5.5 | No | 28/QFN,28/SOIC,28/SPDIP,28/SSOP,28/UQFN
PIC18F55Q43 | In Production | $1.24 | 32 | 8192 | 1024 | 48 | 64 | Yes | 64MHZ | 2 | 0 | 43 | 12 | Yes | 1 | 8 | Yes | Yes | 0 | 1 | 3 | 4 | 1 | 3 | 6 | 16 | No | No | 5 | 2 | 1 | 0 | No | Yes | 8 | 3 | 3 | 0 |  | 0 | -40 | 125 | 1.8 | 5.5 | No | 48/TQFP,48/VQFN
PIC16F15376 | In Production | $1.25 | 28 | 2048 | 0 / HEF | 40 | 32 | Yes | 32 MHz, 32 kHz | 2 | 0 | 35 | 10 | No | 1 | 5 | No | Yes | 0 | 0 | 1 | 2 | 0 | 1 | 10 | 10 | No | No | 2 | 2 | 2 | 0 | No | No | 4 | 1 | 1 | 0 | 0 | 0 | -40 | 125 | 1.8 | 5.5 | No | 40/PDIP,40/QFN,40/UQFN,40/VQFN,44/QFN,44/TQFP
PIC18F46Q43 | In Production | $1.25 | 64 | 4096 | 1024 | 40 | 64 | Yes | 64MHZ | 2 | 0 | 35 | 12 | Yes | 1 | 8 | Yes | Yes | 0 | 1 | 3 | 4 | 1 | 3 | 6 | 16 | No | No | 5 | 2 | 1 | 0 | No | Yes | 8 | 3 | 3 | 0 |  | 0 | -40 | 125 | 1.8 | 5.5 | No | 0/QFN,0/TQFP,40/PDIP,40/QFN,44/TQFP
PIC12F683 | In Production,Please consider device: PIC16F18323 | $1.26 | 3.5 | 128 | 256 | 8 | 20 | No | 8 MHz, 32 kHz | 1 | 0 | 4 | 10 | No | 0 | 0 | No | No | 0 | 0 | 2 | 1 | 0 | 0 | 0 | 10 | No | No | 0 | 0 | 0 | 0 | No | No | 0 | 0 | 0 | 0 | 4 | 0 | -40 | 125 | 2 | 5.5 | No | 8/DFN,8/DFN-S,8/PDIP,8/SOIC
PIC16F1826 | In Production | $1.26 | 3.5 | 256 | 256 | 18 | 32 | No | 32 MHz, 32 kHz | 2 | 0 | 12 | 10 | No | 1 | 5 | Yes | No | 0 | 1 | 2 | 1 | 0 | 0 | 4 | 10 | No | No | 1 | 1 | 1 | 0 | No | No | 0 | 0 | 0 | 0 | 12 | 0 | -40 | 125 | 1.8 | 5.5 | No | 18/PDIP,18/SOIC,20/SSOP,28/QFN,28/UQFN
PIC16F630 | In Production,Please consider device: PIC16F18324 | $1.26 | 1.75 | 64 | 128 | 14 | 20 | No | 4 MHz | 1 | 0 | 0 | 0 | No | 0 | 0 | No | No | 0 | 0 | 1 | 1 | 0 | 0 | 0 | 0 | No | No | 0 | 0 | 0 | 0 | No | No | 0 | 0 | 0 | 0 | 0 | 0 | -40 | 125 | 2 | 5.5 | No | 14/PDIP,14/SOIC,14/TSSOP,16/QFN
PIC16F631 | In Production,Please consider device: PIC16F18344 | $1.26 | 1.75 | 64 | 128 | 20 | 20 | No | 8 MHz, 32 kHz | 2 | 0 | 0 | 0 | No | 0 | 0 | Yes | No | 0 | 0 | 1 | 1 | 0 | 0 | 0 | 0 | No | No | 0 | 0 | 0 | 0 | No | No | 0 | 0 | 0 | 0 | 0 | 0 | -40 | 125 | 2 | 5.5 | No | 20/PDIP,20/QFN,20/SOIC,20/SSOP
PIC16F1455 | In Production | $1.27 | 14 | 1024 | 0 / HEF | 14 | 48 | No | 16 MHz, 32 kHz | 2 | 0 | 5 | 10 | No | 1 | 5 | Yes | No | 0 | 0 | 2 | 1 | 0 | 0 | 3 | 10 | No | No | 1 | 1 | 1 | 1 | No | No | 0 |  | 0 | 0 | 5 | 0 | -40 | 125 | 1.8 | 5.5 | No | 14/PDIP,14/SOIC,14/TSSOP,16/QFN,16/UQFN
PIC16F1716 | In Production | $1.27 | 14 | 1024 | 0 / HEF | 28 | 32 | Yes | 32 MHz, 32 kHz | 2 | 2 | 17 | 10 | No | 2 | 8 | Yes | Yes | 0 | 0 | 4 | 1 | 0 | 0 | 0 | 10 | No | No | 1 | 1 | 1 | 0 | No | No | 4 | 1 | 1 | 0 | 17 | 0 | -40 | 125 | 1.8 | 5.5 | No | 28/QFN,28/SOIC,28/SPDIP,28/SSOP,28/UQFN
PIC16F1765 | In Production | $1.27 | 14 | 1024 | 0 / HEF | 14 | 32 | Yes | 32 MHz, 32 kHz | 2 | 1 | 8 | 10 | No | 2 | 10 | Yes | Yes | Yes | 1 | 4 | 3 | 0 | 3 | 6 | 16 | No | No | 1 | 1 | 1 | 0 | No | No | 3 | 1 | 0 | 0 | 0 | 0 | -40 | 125 | 1.8 | 5.5 | No | 14/PDIP,14/SOIC,14/TSSOP,16/QFN
PIC16F1828 | In Production | $1.27 | 7 | 256 | 256 | 20 | 32 | No | 32 MHz, 32 kHz | 2 | 0 | 12 | 10 | No | 1 | 5 | Yes | No | 0 | 1 | 4 | 1 | 0 | 0 | 8 | 10 | No | No | 1 | 1 | 1 | 0 | Yes | No | 0 | 0 | 0 | 0 | 12 | 0 | -40 | 125 | 1.8 | 5.5 | No | 20/PDIP,20/QFN,20/SOIC,20/SSOP,20/UQFN
PIC16F636 | In Production,Please consider device: PIC16F18323 | $1.27 | 3.5 | 128 | 256 | 14 | 20 | No | 8 MHz, 32 kHz | 2 | 0 | 0 | 0 | No | 0 | 0 | No | No | 0 | 0 | 1 | 1 | 0 | 0 | 0 | 0 | No | No | 0 | 0 | 0 | 0 | No | No | 0 | 0 | 0 | 0 | 0 | 0 | -40 | 125 | 2 | 5.5 | No | 14/PDIP,14/SOIC,14/TSSOP ,16/QFN
PIC16F676 | In Production,Please consider device: PIC16F18324 | $1.27 | 1.75 | 64 | 128 | 14 | 20 | No | 4 MHz | 1 | 0 | 8 | 10 | No | 0 | 0 | No | No | 0 | 0 | 1 | 1 | 0 | 0 | 0 | 0 | No | No | 0 | 0 | 0 | 0 | No | No | 0 | 0 | 0 | 0 | 8 | 0 | -40 | 125 | 2 | 5.5 | No | 14/PDIP,14/SOIC,14/TSSOP,16/QFN
PIC16LF1567 | In Production | $1.27 | 14 | 1024 | 0 | 40 | 32 | No | 16 MHz | 0 | 0 | 23 | 10 | No | 0 | 0 | No | No | 0 | 0 | 3 | 1 | 0 | 0 | 0 | 0 | No | No | 1 | 2 | 2 | 0 | No | No | 0 | 0 | 0 | 0 | 34 | 0 | -40 | 85 | 1.8 | 3.6 | No | 40/PDIP,40/UQFN,44/TQFP
PIC12F529T39A | Not Recommended for new designs | $1.29 | 2.3 | 201 | 64 | 8 | 8 | No | 8 MHz | 0 | 0 | 0 | 0 | No | 0 | 0 | No | No | 0 | 0 | 1 | 0 | 0 | 0 | 0 | 0 | No | No | 0 | 0 | 0 | 0 | No | No | 0 | 0 | 0 | 0 | 0 | 0 | -40 | 85 | 2 | 3.7 | No | 14/TSSOP
PIC16F19155 | In Production | $1.29 | 14 | 1024 | 256 | 28 | 32 | Yes | 32 MHz, 32 kHz | 2 | 0 | 20 | 12 | Yes | 1 | 5 | No | Yes |  | 0 | 2 | 2 | 0 | 0 | 0 | 0 | No | No | 2 | 1 | 1 | 0 | No | No | 4 | 1 | 0 | 0 | 0 | 96 | -40 | 125 | 1.8 | 5.5 | No | 28/SOIC,28/SPDIP,28/SSOP,28/UQFN
PIC18F56Q43 | In Production | $1.29 | 64 | 4096 | 1024 | 48 | 64 | Yes | 64MHZ | 2 | 0 | 43 | 12 | Yes | 1 | 8 | Yes | Yes | 0 | 1 | 3 | 4 | 1 | 3 | 6 | 16 | No | No | 5 | 2 | 1 | 0 | No | Yes | 8 | 3 | 3 | 0 |  | 0 | -40 | 125 | 1.8 | 5.5 | No | 48/TQFP,48/VQFN
PIC16F716 | In Production,Please consider device: PIC16F18344 | $1.30 | 3.5 | 128 | 0 | 18 | 20 | No | None | 0 | 0 | 4 | 8 | No | 0 | 0 | No | No | 0 | 0 | 2 | 1 | 0 | 0 | 4 | 10 | No | No | 0 | 0 | 0 | 0 | No | No | 0 | 0 | 0 | 0 | 0 | 0 | -40 | 125 | 2 | 5.5 | No | 18/PDIP,18/SOIC,20/SSOP,28/QFN
PIC16F18857 | In Production | $1.31 | 56 | 4096 | 256 | 28 | 32 | Yes | 32 MHz, 32 kHz | 2 | 0 | 24 | 10 | Yes | 1 | 5 | Yes | Yes | 0 | 1 | 3 | 4 | 2 | 3 | 19 | 10 | No | No | 1 | 2 | 2 | 0 | No | Yes | 4 | 3 | 1 | 0 | 24 | 0 | -40 | 125 | 1.8 | 5.5 | No | 28/QFN,28/SOIC,28/SPDIP,28/SSOP
PIC18F24K42 | In Production | $1.32 | 16 | 1024 | 256 | 28 | 64 | Yes | 64MHZ, 64KHz | 2 | 0 | 24 | 12 | Yes | 1 | 5 | Yes | Yes | 0 | 1 | 3 | 4 | 1 | 3 | 0 | 10 | No | No | 2 | 1 | 2 | 0 | Yes | Yes | 4 | 3 | 1 | 0 | 24 | 0 | -40 | 125 | 1.8 | 5.5 | No | 28/QFN,28/SOIC,28/SPDIP,28/SSOP,28/UQFN,28/VQFN
PIC16F18876 | In Production | $1.34 | 28 | 2048 | 256 | 40 | 32 | Yes | 32 MHz, 32 kHz | 2 | 0 | 35 | 10 | Yes | 1 | 5 | Yes | Yes | 0 | 1 | 3 | 4 | 2 | 3 | 19 | 10 | No | No | 1 | 2 | 2 | 0 | No | Yes | 4 | 3 | 1 | 0 | 35 | 0 | -40 | 125 | 1.8 | 5.5 | No | 40/PDIP,40/UQFN,44/QFN,44/TQFP
PIC16F1827 | In Production | $1.35 | 7 | 384 | 256 | 18 | 32 | No | 32 MHz, 32 kHz | 2 | 0 | 12 | 10 | No | 1 | 5 | Yes | No | 0 | 1 | 4 | 1 | 0 | 0 | 8 | 10 | No | No | 1 | 2 | 2 | 0 | No | No | 0 | 0 | 0 | 0 | 12 | 0 | -40 | 125 | 1.8 | 5.5 | No | 18/PDIP,18/SOIC,20/SSOP,28/QFN,28/UQFN
PIC16F1829 | In Production | $1.35 | 14 | 1024 | 256 | 20 | 32 | No | 32 MHz, 32 kHz | 2 | 0 | 12 | 10 | No | 1 | 5 | Yes | No | 0 | 1 | 4 | 1 | 0 | 0 | 8 | 10 | No | No | 1 | 2 | 2 | 0 | Yes | No | 0 | 0 | 0 | 0 | 12 | 0 | -40 | 125 | 1.8 | 5.5 | No | 20/PDIP,20/QFN,20/SOIC,20/SSOP,20/UQFN,28/SPDIP
PIC16F684 | In Production,Please consider device: PIC16F18324 | $1.35 | 3.5 | 128 | 256 | 14 | 20 | No | 8 MHz, 32 kHz | 2 | 0 | 8 | 10 | No | 0 | 0 | No | No | 0 | 0 | 2 | 1 | 0 | 0 | 4 | 10 | No | No | 0 | 0 | 0 | 0 | No | No | 0 | 0 | 0 | 0 | 8 | 0 | -40 | 125 | 2 | 5.5 | No | 14/PDIP,14/SOIC,14/TSSOP,16/QFN
PIC16F1718 | In Production | $1.37 | 28 | 2048 | 0 / HEF | 28 | 32 | Yes | 32 MHz, 32 kHz | 2 | 2 | 17 | 10 | No | 2 | 8 | Yes | Yes | 0 | 0 | 4 | 1 | 0 | 0 | 0 | 10 | No | No | 1 | 1 | 1 | 0 | No | No | 4 | 1 | 1 | 0 | 17 | 0 | -40 | 125 | 1.8 | 5.5 | No | 28/QFN,28/SOIC,28/SPDIP,28/SSOP,28/UQFN
PIC16F677 | In Production | $1.37 | 3.5 | 128 | 256 | 20 | 20 | No | 8 MHz, 32 kHz | 2 | 0 | 12 | 10 | No | 0 | 0 | Yes | No | 0 | 0 | 1 | 1 | 0 | 0 | 0 | 0 | No | No | 0 | 1 | 1 | 0 | No | No | 0 | 0 | 0 | 0 | 12 | 0 | -40 | 125 | 2 | 5.5 | No | 20/PDIP,20/QFN,20/SOIC,20/SSOP
PIC16F19156 | In Production | $1.38 | 28 | 2048 | 256 | 28 | 32 | Yes | 32 MHz, 32 kHz | 2 | 0 | 20 | 12 | Yes | 1 | 5 | No | Yes |  | 0 | 2 | 2 | 0 | 0 | 0 | 0 | No | No | 2 | 1 | 1 | 0 | No | No | 4 | 1 | 0 | 0 | 0 | 96 | -40 | 125 | 1.8 | 5.5 | No | 28/SOIC,28/SPDIP,28/SSOP,28/UQFN
PIC18F25K42 | In Production | $1.38 | 32 | 2048 | 256 | 28 | 64 | Yes | 64MHZ | 2 | 0 | 24 | 12 | Yes | 1 | 8 | Yes | Yes | 0 | 1 | 3 | 4 | 1 | 3 | 0 | 10 | No | No | 2 | 1 | 2 | 0 | No | Yes | 4 | 3 | 1 | 0 | 24 | 0 | -40 | 125 | 1.8 | 5.5 | No | 28/QFN,28/SOIC,28/SPDIP,28/SSOP,28/UQFN
PIC16F1768 | In Production | $1.40 | 7 | 512 | 0 / HEF | 20 | 32 | Yes | 32 MHz, 32 kHz | 4 | 2 | 12 | 10 | No | 4 | 10 | Yes | Yes | Yes | 2 | 4 | 3 | 0 | 3 | 12 | 16 | No | No | 1 | 1 | 1 | 0 | No | No | 3 | 2 | 0 | 0 | 0 | 0 | -40 | 125 | 1.8 | 5.5 | No | 20/PDIP,20/QFN,20/SOIC,20/SSOP,20/VQFN
PIC18F47Q43 | In Production | $1.40 | 128 | 8192 | 1024 | 40 | 64 | Yes | 64MHZ | 2 | 0 | 35 | 12 | Yes | 1 | 8 | Yes | Yes | 0 | 1 | 3 | 4 | 1 | 3 | 6 | 16 | No | No | 5 | 2 | 1 | 0 | No | Yes | 8 | 3 | 3 | 0 |  | 0 | -40 | 125 | 1.8 | 5.5 | No | 40/PDIP,40/QFN,44/TQFP
PIC16F1847 | In Production | $1.41 | 14 | 1024 | 256 | 18 | 32 | No | 32 MHz, 32 kHz | 2 | 0 | 12 | 10 | No | 1 | 5 | Yes | No | 0 | 1 | 4 | 1 | 0 | 0 | 8 | 10 | No | No | 1 | 2 | 2 | 0 | No | No | 0 | 0 | 0 | 0 | 12 | 0 | -40 | 125 | 1.8 | 5.5 | No | 18/PDIP,18/SOIC,20/SSOP,28/QFN,28/SPDIP,28/UQFN,28/VQFN
PIC16F723 | In Production,Please consider device: PIC16F723A | $1.41 | 7 | 192 | 0 / HEF | 28 | 20 | No | 16 MHz | 0 | 0 | 11 | 8 | No | 0 | 0 | Yes | No | 0 | 0 | 2 | 1 | 0 | 0 | 0 | 10 | No | No | 1 | 1 | 1 | 0 | No | No | 0 | 0 | 0 | 0 | 8 | 0 | -40 | 125 | 1.8 | 5.5 | No | 28/SOIC,28/SPDIP,28/SSOP
PIC18F57Q43 | In Production | $1.41 | 128 | 8196 | 1024 | 48 | 64 | Yes | 64MHZ | 2 | 0 | 43 | 12 | Yes | 1 | 8 | Yes | Yes | 0 | 1 | 2 | 3 | 1 | 2 | 6 | 16 | No | No | 5 | 2 | 1 | 0 | Yes | Yes | 8 | 3 | 1 | 0 |  | 0 | -40 | 125 | 1.8 | 5.5 | No | 48/TQFP,48/VQFN
PIC18F45K40 | In Production | $1.42 | 32 | 2048 | 256 | 40 | 64 | Yes | 64MHZ, 64KHz | 2 | 0 | 35 | 10 | Yes | 1 | 5 | Yes | Yes | 0 | 1 | 3 | 4 | 0 | 1 | 0 | 10 | No | No | 2 | 2 | 2 | 0 | Yes | Yes | 0 | 1 | 0 | 0 | 35 | 0 | -40 | 125 | 1.8 | 5.5 | No | 40/PDIP,40/UQFN,44/QFN,44/TQFP
PIC16F688 | In Production,Please consider device: PIC16F18325 | $1.45 | 7 | 256 | 256 | 14 | 20 | No | 8 MHz, 32 kHz | 2 | 0 | 8 | 10 | No | 0 | 0 | No | No | 0 | 0 | 1 | 1 | 0 | 0 | 0 | 0 | No | No | 1 | 1 | 1 | 0 | No | No | 0 | 0 | 0 | 0 | 8 | 0 | -40 | 125 | 2 | 5.5 | No | 14/PDIP,14/SOIC,14/TSSOP,16/QFN
PIC16F1459 | In Production | $1.46 | 14 | 1024 | 0 / HEF | 20 | 48 | No | 16 MHz, 32 kHz | 2 | 0 | 9 | 10 | No | 1 | 5 | Yes | No | 0 | 0 | 2 | 1 | 0 | 0 | 3 | 10 | No | No | 1 | 1 | 1 | 1 | No | No | 0 |  | 0 | 0 | 9 | 0 | -40 | 125 | 1.8 | 5.5 | No | 20/PDIP,20/QFN,20/SOIC,20/SSOP,20/UQFN,28/SOIC
PIC16C505 | Not Recommended for new designs,Please consider device: PIC16F505 | $1.47 | 1.5 | 72 | 0 | 14 | 20 | No | 4 MHz | 0 | 0 | 0 | 0 | No | 0 | 0 | No | No | 0 | 0 | 1 | 0 | 0 | 0 | 0 | 0 | No | No | 0 | 0 | 0 | 0 | No | No | 0 | 0 | 0 | 0 | 0 | 0 | -40 | 85 | 2.5 | 5.5 | No | 14/PDIP,14/SOIC
PIC16F18877 | In Production | $1.48 | 56 | 4096 | 256 | 40 | 32 | Yes | 32 MHz, 32 kHz | 2 | 0 | 35 | 10 | Yes | 1 | 5 | Yes | Yes | 0 | 1 | 3 | 4 | 2 | 3 | 19 | 10 | No | No | 1 | 2 | 2 | 0 | No | Yes | 4 | 3 | 1 | 0 | 35 | 0 | -40 | 125 | 1.8 | 5.5 | No | 40/PDIP,40/UQFN,40/VQFN,44/QFN,44/TQFP
PIC16F1938 | In Production,Please consider device: PIC16F19156 | $1.48 | 28 | 1024 | 256 | 28 | 32 | No | 32 MHz, 32 kHz | 2 | 0 | 11 | 10 | No | 1 | 5 | Yes | No | 0 | 0 | 4 | 1 | 0 | 0 | 14 | 10 | No | No | 1 | 1 | 1 | 0 | Yes | No | 0 | 0 | 0 | 0 | 8 | 60 | -40 | 125 | 1.8 | 5.5 | No | 28/QFN,28/SOIC,28/SPDIP,28/SSOP,28/UQFN,28/VQFN
PIC16F687 | In Production,Please consider device: PIC16F18344 | $1.48 | 3.5 | 128 | 256 | 20 | 20 | No | 8 MHz, 32 kHz | 2 | 0 | 12 | 10 | No | 0 | 0 | Yes | No | 0 | 0 | 1 | 1 | 0 | 0 | 0 | 0 | No | No | 1 | 1 | 1 | 0 | No | No | 0 | 0 | 0 | 0 | 12 | 0 | -40 | 125 | 2 | 5.5 | No | 20/PDIP,20/QFN,20/SOIC,20/SSOP
PIC16F1518 | In Production | $1.49 | 28 | 1024 | 0 / HEF | 28 | 20 | No | 16 MHz, 32 kHz | 0 | 0 | 17 | 10 | No | 0 | 0 | Yes | No | 0 | 0 | 2 | 1 | 0 | 0 | 2 | 10 | No | No | 1 | 1 | 1 | 0 | Yes | No | 0 | 0 | 0 | 0 | 17 | 0 | -40 | 125 | 1.8 | 5.5 | No | 0/SSOP,28/QFN,28/SOIC,28/SPDIP,28/SSOP,28/UQFN
PIC16F1769 | In Production | $1.49 | 14 | 1024 | 0 / HEF | 20 | 32 | Yes | 32 MHz, 32 kHz | 4 | 2 | 12 | 10 | No | 4 | 10 | Yes | Yes | Yes | 2 | 4 | 3 | 0 | 3 | 12 | 16 | No | No | 1 | 1 | 1 | 0 | No | No | 3 | 2 | 0 | 0 | 0 | 0 | -40 | 125 | 1.8 | 5.5 | No | 20/PDIP,20/QFN,20/SOIC,20/SSOP,20/VQFN
PIC18F46K40 | In Production | $1.49 | 64 | 3728 | 1024 | 40 | 64 | Yes | 64MHZ, 64KHz | 2 | 0 | 35 | 10 | Yes | 1 | 5 | Yes | Yes | 0 | 1 | 3 | 4 | 0 | 1 | 0 | 10 | No | No | 2 | 2 | 2 | 0 | Yes | Yes | 0 | 1 | 0 | 0 | 35 | 0 | -40 | 125 | 1.8 | 5.5 | No | 40/PDIP,40/UQFN,44/QFN,44/TQFP
PIC12CE518 | Not Recommended for new designs,Please consider device: PIC12F629 | $1.51 | 0.75 | 25 | 16 | 8 | 4 | No | 10 MHz | 0 | 0 | 0 | 0 | No | 0 | 0 | No | No | 0 | 0 | 1 | 0 | 0 | 0 | 0 | 0 | No | No | 0 | 0 | 0 | 0 | No | No | 0 | 0 | 0 | 0 | 0 | 0 | -40 | 125 | 3 | 5.5 | No | 8/PDIP,8/SOIC,8/SOIJ
PIC16F19175 | In Production | $1.51 | 14 | 1024 | 256 | 40 | 32 | Yes | 32 MHz, 32 kHz | 2 | 0 | 35 | 12 | Yes | 1 | 5 | No | Yes |  | 0 | 2 | 2 | 0 | 0 | 0 | 0 | No | No | 2 | 1 | 1 | 0 | No | No | 4 | 1 | 0 | 0 | 0 | 184 | -40 | 125 | 1.8 | 5.5 | No | 40/PDIP,40/UQFN,44/TQFP
PIC16F882 | In Production | $1.51 | 3.5 | 128 | 128 | 28 | 20 | No | 8 MHz, 32 kHz | 2 | 0 | 11 | 10 | No | 0 | 0 | Yes | No | 0 | 0 | 2 | 1 | 0 | 0 | 0 | 10 | No | No | 1 | 1 | 1 | 0 | No | No | 0 | 0 | 0 | 0 | 11 | 0 | -40 | 125 | 2 | 5.5 | No | 28/QFN,28/SOIC,28/SPDIP,28/SSOP
PIC18F13K22 | In Production,Please consider device: PIC18F24Q10 | $1.51 | 8 | 256 | 256 / HEF | 20 | 64 | No | 16 MHz, 32 kHz | 2 | 0 | 12 | 10 | No | 0 | 0 | Yes | No | 0 | 0 | 1 | 3 | 0 | 0 | 0 | 10 | No | No | 1 | 1 | 1 | 0 | No | No | 0 | 0 | 0 | 0 | 12 | 0 | -40 | 125 | 1.8 | 5.5 | No | 20/PDIP,20/QFN,20/SOIC,20/SSOP
PIC18F27K40 | In Production | $1.52 | 128 | 3728 | 1024 | 28 | 64 | Yes | 64MHZ, 64KHz | 2 | 0 | 24 | 10 | Yes | 1 | 5 | Yes | Yes | 0 | 1 | 3 | 4 | 0 | 1 | 0 | 10 | No | No | 2 | 2 | 2 | 0 | Yes | Yes | 0 | 1 | 0 | 0 | 24 | 0 | -40 | 125 | 1.8 | 5.5 | No | 28/QFN,28/SOIC,28/SPDIP,28/SSOP
PIC16LF1904 | In Production | $1.53 | 7 | 256 | 0 / HEF | 40 | 20 | No | 16 MHz, 32 kHz | 0 | 0 | 14 | 10 | No | 0 | 0 | No | No | 0 | 0 | 1 | 1 | 0 | 0 | 0 | 0 | No | No | 1 | 0 | 0 | 0 | No | No | 0 | 0 | 0 | 0 | 14 | 116 | -40 | 125 | 1.8 | 3.6 | No | 40/PDIP,40/UQFN,44/TQFP
PIC16F19176 | In Production | $1.54 | 28 | 2048 | 256 | 40 | 32 | Yes | 32 MHz, 32 kHz | 2 | 0 | 35 | 12 | Yes | 1 | 5 | No | Yes |  | 0 | 2 | 2 | 0 | 0 | 0 | 0 | No | No | 2 | 1 | 1 | 0 | No | No | 4 | 1 | 0 | 0 | 0 | 184 | -40 | 125 | 1.8 | 5.5 | No | 40/PDIP,40/UQFN,44/TQFP
PIC16F785 | In Production,Please consider device: PIC16F1709 | $1.54 | 3.5 | 128 | 256 | 20 | 20 | No | 8 MHz, 32 kHz | 2 | 2 | 12 | 10 | No | 0 | 0 | Yes | No | 0 | 0 | 2 | 1 | 0 | 0 | 0 | 10 | No | No | 0 | 0 | 0 | 0 | No | No | 0 | 0 | 0 | 0 | 12 | 0 | -40 | 125 | 2 | 5.5 | No | 20/PDIP,20/QFN,20/SOIC,20/SSOP
PIC16F685 | In Production,Please consider device: PIC16F18344 | $1.56 | 7 | 256 | 256 | 20 | 20 | No | 8 MHz, 32 kHz | 2 | 0 | 12 | 10 | No | 0 | 0 | Yes | No | 0 | 0 | 2 | 1 | 0 | 0 | 4 | 10 | No | No | 0 | 0 | 0 | 0 | No | No | 0 | 0 | 0 | 0 | 12 | 0 | -40 | 125 | 2 | 5.5 | No | 20/PDIP,20/QFN,20/SOIC,20/SSOP
PIC16F689 | In Production,Please consider device: PIC16F18344 | $1.56 | 7 | 256 | 256 | 20 | 20 | No | 8 MHz, 32 kHz | 2 | 0 | 12 | 10 | No | 0 | 0 | Yes | No | 0 | 0 | 1 | 1 | 0 | 0 | 0 | 0 | No | No | 1 | 1 | 1 | 0 | No | No | 0 | 0 | 0 | 0 | 12 | 0 | -40 | 125 | 2 | 5.5 | No | 20/PDIP,20/QFN,20/SOIC,20/SSOP
PIC18F26K42 | In Production | $1.56 | 64 | 4096 | 1024 | 28 | 64 | Yes | 64MHZ, 64KHz | 2 | 0 | 24 | 12 | Yes | 1 | 5 | Yes | Yes | 0 | 1 | 3 | 4 | 1 | 3 | 0 | 10 | No | No | 2 | 1 | 2 | 0 | Yes | Yes | 4 | 3 | 1 | 0 | 24 | 0 | -40 | 125 | 1.8 | 5.5 | No | 28/QFN,28/SOIC,28/SPDIP,28/SSOP,28/UQFN
PIC16F1717 | In Production | $1.58 | 14 | 1024 | 0 / HEF | 40 | 32 | Yes | 32 MHz, 32 kHz | 2 | 2 | 28 | 10 | No | 2 | 8 | Yes | Yes | 0 | 0 | 4 | 1 | 0 | 0 | 0 | 10 | No | No | 1 | 1 | 1 | 0 | No | No | 4 | 1 | 1 | 0 | 28 | 0 | -40 | 125 | 1.8 | 5.5 | No | 40/PDIP,40/QFN,40/UQFN,44/QFN,44/TQFP
PIC12CE519 | Not Recommended for new designs,Please consider device: PIC12F629 | $1.59 | 1.5 | 41 | 16 | 8 | 4 | No | 11 MHz | 0 | 0 | 0 | 0 | No | 0 | 0 | No | No | 0 | 0 | 1 | 0 | 0 | 0 | 0 | 0 | No | No | 0 | 0 | 0 | 0 | No | No | 0 | 0 | 0 | 0 | 0 | 0 | -40 | 125 | 3 | 5.5 | No | 8/PDIP,8/SOIC,8/SOIJ
PIC16F1782 | In Production | $1.60 | 3.5 | 256 | 256 | 28 | 32 | No | 32 MHz, 32 kHz | 3 | 2 | 11 | 12 | No | 1 | 8 | Yes | No | 0 | 0 | 2 | 1 | 0 | 0 | 14 | 16 | No | No | 0 | 0 | 0 | 0 | No | No | 0 | 0 | 0 | 2 | 11 | 0 | -40 | 125 | 1.8 | 5.5 | No | 28/QFN,28/SOIC,28/SPDIP,28/SSOP,28/UQFN
PIC16F1933 | In Production,Please consider device: PIC16F19155 | $1.60 | 7 | 256 | 256 | 28 | 32 | No | 32 MHz, 32 kHz | 2 | 0 | 11 | 10 | No | 1 | 5 | Yes | No | 0 | 0 | 4 | 1 | 0 | 0 | 14 | 10 | No | No | 1 | 1 | 1 | 0 | No | No | 0 | 0 | 0 | 0 | 8 | 60 | -40 | 125 | 1.8 | 5.5 | No | 28/QFN,28/SOIC,28/SPDIP,28/SSOP,28/UQFN
PIC16F726 | In Production | $1.60 | 14 | 368 | 0 / HEF | 28 | 20 | No | 16 MHz | 0 | 0 | 11 | 8 | No | 0 | 0 | Yes | No | 0 | 0 | 2 | 1 | 0 | 0 | 0 | 10 | No | No | 1 | 1 | 1 | 0 | No | No | 0 | 0 | 0 | 0 | 8 | 0 | -40 | 125 | 1.8 | 5.5 | No | 28/QFN,28/SOIC,28/SPDIP,28/SSOP,28/UQFN
PIC16LF1907 | In Production | $1.60 | 14 | 512 | 0 / HEF | 40 | 20 | No | 16 MHz, 32 kHz | 0 | 0 | 14 | 10 | No | 0 | 0 | No | No | 0 | 0 | 1 | 1 | 0 | 0 | 0 | 0 | No | No | 1 | 0 | 0 | 0 | No | No | 0 | 0 | 0 | 0 | 14 | 116 | -40 | 125 | 1.8 | 3.6 | No | 40/PDIP,40/UQFN,44/TQFP
PIC18F23K20 | In Production | $1.60 | 8 | 512 | 256 / HEF | 28 | 64 | No | 16 MHz, 32 kHz | 2 | 0 | 10 | 10 | No | 0 | 0 | Yes | No | 0 | 0 | 1 | 3 | 0 | 0 | 0 | 10 | No | No | 1 | 1 | 1 | 0 | No | No | 0 | 0 | 0 | 0 | 10 | 0 | -40 | 125 | 1.8 | 3.6 | No | 28/QFN,28/SOIC,28/SPDIP,28/SSOP,28/UQFN
PIC16F627A | In Production,Please consider device: PIC16F18444 | $1.61 | 1.75 | 224 | 128 | 18 | 20 | No | 4 MHz | 2 | 0 | 0 | 0 | No | 0 | 0 | No | No | 0 | 0 | 2 | 1 | 0 | 0 | 1 | 10 | No | No | 1 | 0 | 0 | 0 | No | No | 0 | 0 | 0 | 0 | 0 | 0 | -40 | 125 | 2 | 5.5 | No | 18/PDIP,18/SOIC,20/SSOP,28/QFN
PIC18F14K22 | In Production,Please consider device: PIC18F24Q10 | $1.63 | 16 | 512 | 256 / HEF | 20 | 64 | No | 16 MHz, 32 kHz | 2 | 0 | 12 | 10 | No | 0 | 0 | Yes | No | 0 | 0 | 1 | 3 | 0 | 0 | 0 | 10 | No | No | 1 | 1 | 1 | 0 | No | No | 0 | 0 | 0 | 0 | 12 | 0 | -40 | 125 | 1.8 | 5.5 | No | 20/PDIP,20/QFN,20/SOIC,20/SSOP,28/SOIC
PIC16C620A | Not Recommended for new designs,Please consider device: PIC16F627A | $1.64 | 0.875 | 96 | 0 | 18 | 40 | No | 4 MHz | 2 | 0 | 0 | 0 | No | 0 | 0 | No | No | 0 | 0 | 1 | 0 | 0 | 0 | 0 | 0 | No | No | 0 | 0 | 0 | 0 | No | No | 0 | 0 | 0 | 0 | 0 | 0 | -40 | 85 | 2.5 | 5.5 | No | 18/PDIP,18/SOIC,20/SSOP
PIC18F45K42 | In Production | $1.64 | 32 | 2048 | 256 | 40 | 64 | Yes | 64MHZ, 64KHz | 2 | 0 | 35 | 12 | Yes | 1 | 5 | Yes | Yes | 0 | 1 | 3 | 4 | 1 | 3 | 0 | 10 | No | No | 2 | 1 | 2 | 0 | Yes | Yes | 4 | 3 | 1 | 0 | 24 | 0 | -40 | 125 | 1.8 | 5.5 | No | 40/PDIP,40/UQFN,44/QFN,44/TQFP
PIC16F690 | In Production,Please consider device: PIC16F18344 | $1.65 | 7 | 256 | 256 | 20 | 20 | No | 8 MHz, 32 kHz | 2 | 0 | 12 | 10 | No | 0 | 0 | Yes | No | 0 | 0 | 2 | 1 | 0 | 0 | 4 | 10 | No | No | 1 | 1 | 1 | 0 | No | No | 0 | 0 | 0 | 0 | 12 | 0 | -40 | 125 | 2 | 5.5 | No | 20/PDIP,20/QFN,20/SOIC,20/SSOP
PIC16C54C | Not Recommended for new designs,Please consider device: PIC16F54 | $1.70 | 0.75 | 25 | 0 | 18 | 40 | No | 4 MHz | 0 | 0 | 0 | 0 | No | 0 | 0 | No | No | 0 | 0 | 1 | 0 | 0 | 0 | 0 | 0 | No | No | 0 | 0 | 0 | 0 | No | No | 0 | 0 | 0 | 0 | 0 | 0 | -40 | 85 | 2.5 | 5.5 | No | 18/PDIP,18/SOIC,20/SSOP
PIC16F1783 | In Production | $1.70 | 7 | 512 | 256 | 28 | 32 | No | 32 MHz, 32 kHz | 3 | 2 | 11 | 12 | No | 1 | 8 | Yes | No | 0 | 0 | 2 | 1 | 0 | 0 | 14 | 16 | No | No | 1 | 1 | 1 | 0 | Yes | No | 0 | 0 | 0 | 2 | 11 | 0 | -40 | 125 | 1.8 | 5.5 | No | 28/QFN,28/SOIC,28/SPDIP,28/SSOP,28/UQFN
PIC16F1936 | In Production,Please consider device: PIC16F19155 | $1.70 | 14 | 512 | 256 / HEF | 28 | 32 | No | 32 MHz, 32 kHz | 2 | 0 | 11 | 10 | No | 1 | 5 | Yes | No | 0 | 0 | 4 | 1 | 0 | 0 | 14 | 10 | No | No | 1 | 1 | 1 | 0 | No | No | 0 | 0 | 0 | 0 | 8 | 60 | -40 | 125 | 1.8 | 5.5 | No | 28/QFN,28/SOIC,28/SPDIP,28/SSOP,28/UQFN
PIC18F24K20 | In Production | $1.70 | 16 | 768 | 256 / HEF | 28 | 64 | No | 16 MHz, 32 kHz | 2 | 0 | 10 | 10 | No | 0 | 0 | Yes | No | 0 | 0 | 1 | 3 | 0 | 0 | 0 | 10 | No | No | 1 | 1 | 1 | 0 | No | No | 0 | 0 | 0 | 0 | 10 | 0 | -40 | 125 | 1.8 | 3.6 | No | 28/QFN,28/SOIC,28/SPDIP,28/SSOP
PIC18F47K40 | In Production | $1.70 | 128 | 3728 | 1024 | 40 | 64 | Yes | 64MHZ, 64KHz | 2 | 0 | 35 | 10 | Yes | 1 | 5 | Yes | Yes | 0 | 1 | 3 | 4 | 0 | 1 | 0 | 10 | No | No | 2 | 2 | 2 | 0 | Yes | Yes | 0 | 1 | 0 | 0 | 35 | 0 | -40 | 125 | 1.8 | 5.5 | No | 40/PDIP,40/UQFN,44/QFN,44/TQFP
PIC18F55K42 | In Production | $1.70 | 32 | 2048 | 256 | 48 | 64 | Yes | 64MHZ, 64KHz | 2 | 0 | 43 | 12 | Yes | 1 | 5 | Yes | Yes | 0 | 1 | 3 | 4 | 1 | 3 | 0 | 10 | No | No | 2 | 1 | 2 | 0 | Yes | Yes | 4 | 3 | 1 | 0 | 24 | 0 | -40 | 125 | 1.8 | 5.5 | No | 48/TQFP,48/UQFN
PIC16F1517 | In Production | $1.72 | 14 | 512 | 0 / HEF | 40 | 20 | No | 16 MHz, 32 kHz | 0 | 0 | 28 | 10 | No | 0 | 0 | Yes | No | 0 | 0 | 2 | 1 | 0 | 0 | 2 | 10 | No | No | 1 | 1 | 1 | 0 | No | No | 0 | 0 | 0 | 0 | 28 | 0 | -40 | 125 | 1.8 | 5.5 | No | 40/PDIP,40/UQFN,44/TQFP
PIC16F19185 | In Production | $1.72 | 14 | 1024 | 256 | 48 | 32 | Yes | 32 MHz, 32 kHz | 2 | 0 | 43 | 12 | Yes | 1 | 5 | No | Yes |  | 0 | 2 | 2 | 0 | 0 | 0 | 0 | No | No | 2 | 1 | 1 | 0 | No | No | 4 | 1 | 0 | 0 | 0 | 248 | -40 | 125 | 1.8 | 5.5 | No | 48/TQFP,48/UQFN
PIC18F27K42 | In Production | $1.72 | 128 | 8192 | 1024 | 28 | 64 | Yes | 64MHZ, 64KHz | 2 | 0 | 24 | 12 | Yes | 1 | 5 | Yes | Yes | 0 | 1 | 3 | 4 | 1 | 3 | 0 | 10 | No | No | 2 | 1 | 2 | 0 | Yes | Yes | 4 | 3 | 1 | 0 | 24 | 0 | -40 | 125 | 1.8 | 5.5 | No | 0/QFN,28/QFN,28/SOIC,28/SPDIP,28/SSOP
PIC18F23K22 | In Production,Please consider device: PIC18F24Q10 | $1.74 | 8 | 512 | 256 / HEF | 28 | 64 | No | 16 MHz, 32 kHz | 2 | 0 | 17 | 10 | No | 1 | 5 | Yes | No | 0 | 0 | 1 | 3 | 0 | 0 | 0 | 0 | No | No | 2 | 2 | 2 | 0 | No | No | 0 | 0 | 0 | 0 | 17 | 0 | -40 | 125 | 1.8 | 5.5 | No | 28/QFN,28/SOIC,28/SPDIP,28/SSOP,28/UQFN
PIC18F44K22 | In Production,Please consider device: PIC18F45Q10 | $1.74 | 16 | 768 | 256 / HEF | 40 | 64 | No | 16 MHz, 32 kHz | 2 | 0 | 28 | 10 | No | 1 | 5 | Yes | No | 0 | 0 | 1 | 3 | 0 | 0 | 0 | 0 | No | No | 2 | 2 | 2 | 0 | No | No | 0 | 0 | 0 | 0 | 28 | 0 | -40 | 125 | 1.8 | 5.5 | No | 40/PDIP,40/UQFN,44/QFN,44/TQFP
PIC16F1519 | In Production | $1.77 | 28 | 1024 | 0 / HEF | 40 | 20 | No | 16 MHz, 32 kHz | 0 | 0 | 28 | 10 | No | 0 | 0 | Yes | No | 0 | 0 | 2 | 1 | 0 | 0 | 2 | 10 | No | No | 1 | 1 | 1 | 0 | No | No | 0 | 0 | 0 | 0 | 28 | 0 | -40 | 125 | 1.8 | 5.5 | No | 40/PDIP,40/UQFN,44/TQFP
PIC16F1786 | In Production | $1.77 | 14 | 1024 | 256 | 28 | 32 | No | 32 MHz, 32 kHz | 4 | 2 | 11 | 12 | No | 1 | 8 | Yes | No | 0 | 0 | 2 | 1 | 0 | 0 | 21 | 16 | No | No | 1 | 1 | 1 | 0 | No | No | 0 | 0 | 0 | 3 | 11 | 0 | -40 | 125 | 1.8 | 5.5 | No | 28/QFN,28/SOIC,28/SPDIP,28/SSOP
PIC18F25K20 | In Production | $1.77 | 32 | 1536 | 256 / HEF | 28 | 64 | No | 16 MHz, 32 kHz | 2 | 0 | 10 | 10 | No | 0 | 0 | Yes | No | 0 | 0 | 1 | 3 | 0 | 0 | 0 | 10 | No | No | 1 | 1 | 1 | 0 | No | No | 0 | 0 | 0 | 0 | 10 | 0 | -40 | 125 | 1.8 | 3.6 | No | 28/QFN,28/SOIC,28/SPDIP,28/SSOP
PIC18F46K42 | In Production | $1.77 | 64 | 4096 | 1024 | 40 | 64 | Yes | 64MHZ, 64KHz | 2 | 0 | 35 | 12 | Yes | 1 | 5 | Yes | Yes | 0 | 1 | 3 | 4 | 1 | 3 | 0 | 10 | No | No | 2 | 1 | 2 | 0 | Yes | Yes | 4 | 3 | 1 | 0 | 24 | 0 | -40 | 125 | 1.8 | 5.5 | No | 40/PDIP,40/UQFN,44/QFN,44/TQFP
PIC16HV540 | In Production | $1.80 | 1.5 | 25 | 0 | 18 | 20 | No | No | 0 | 0 | 0 | 0 | No | 0 | 0 | No | No | 0 | 0 | 1 | 0 | 0 | 0 | 0 | 0 | No | No | 1 | 1 | 1 | 0 | No | No | 0 | 0 | 0 | 0 | 0 | 0 | -40 | 85 | 3.5 | 15 | No | 18/PDIP,18/SOIC,20/SSOP
PIC18F13K50 | In Production | $1.81 | 8 | 512 | 256 / HEF | 20 | 48 | No | 16 MHz, 32 kHz | 2 | 0 | 9 | 10 | No | 0 | 0 | Yes | No | 0 | 0 | 1 | 3 | 0 | 0 | 0 | 10 | No | No | 1 | 1 | 1 | 1 | No | No | 0 | 0 | 0 | 0 | 9 | 0 | -40 | 125 | 1.8 | 5.5 | No | 20/PDIP,20/QFN,20/SOIC,20/SSOP
PIC18F24J10 | In Production | $1.81 | 16 | 1024 | 0 / HEF | 28 | 40 | No | 32 kHz | 2 | 0 | 10 | 10 | No | 0 | 0 | No | No | 0 | 0 | 1 | 2 | 0 | 0 | 0 | 10 | No | No | 1 | 1 | 1 | 0 | No | No | 0 | 0 | 0 | 0 | 0 | 0 | -40 | 85 | 2 | 3.6 | No | 28/QFN,28/SOIC,28/SPDIP,28/SSOP
PIC12C508 | Not Recommended for new designs,Please consider device: PIC12F508 | $1.82 | 0.75 | 25 | 0 | 8 | 4 | No | 4 MHz | 0 | 0 | 0 | 0 | No | 0 | 0 | No | No | 0 | 0 | 1 | 0 | 0 | 0 | 0 | 0 | No | No | 0 | 0 | 0 | 0 | No | No | 0 | 0 | 0 | 0 | 0 | 0 | -40 | 125 | 2.5 | 5.5 | No | 8/PDIP,8/SOIJ
PIC16F724 | In Production | $1.82 | 7 | 192 | 0 / HEF | 40 | 20 | No | 16 MHz | 0 | 0 | 14 | 8 | No | 0 | 0 | Yes | No | 0 | 0 | 2 | 1 | 0 | 0 | 0 | 10 | No | No | 1 | 1 | 1 | 0 | No | No | 0 | 0 | 0 | 0 | 16 | 0 | -40 | 125 | 1.8 | 5.5 | No | 40/PDIP,44/QFN,44/TQFP
PIC16F1719 | In Production | $1.83 | 28 | 2048 | 0 / HEF | 40 | 32 | Yes | 32 MHz, 32 kHz | 2 | 2 | 28 | 10 | No | 2 | 8 | Yes | Yes | 0 | 0 | 4 | 1 | 0 | 0 | 0 | 10 | No | No | 1 | 1 | 1 | 0 | No | No | 4 | 1 | 1 | 0 | 28 | 0 | -40 | 125 | 1.8 | 5.5 | No | 40/PDIP,40/QFN,40/UQFN,44/QFN,44/TQFP
PIC16F1773 | In Production | $1.83 | 7 | 512 | 0 / HEF | 28 | 32 | Yes | 32 MHz, 32 kHz | 6 | 3 | 17 | 10 | No | 6 | 10 | Yes | Yes | Yes | 3 | 5 | 3 | 0 | 4 | 21 | 16 | No | No | 1 | 1 | 1 | 0 | No | No | 4 | 3 | 0 | 0 | 17 | 0 | -40 | 125 | 1.8 | 5.5 | No | 28/SOIC,28/SPDIP,28/SSOP,28/UQFN
PIC18F56K42 | In Production | $1.83 | 64 | 4096 | 1024 | 48 | 64 | Yes | 64MHZ, 64KHz | 2 | 0 | 43 | 12 | Yes | 1 | 5 | Yes | Yes | 0 | 1 | 3 | 4 | 1 | 3 | 0 | 10 | No | No | 2 | 1 | 2 | 0 | Yes | Yes | 4 | 3 | 1 | 0 | 24 | 0 | -40 | 125 | 1.8 | 5.5 | No | 48/TQFP,48/UQFN
PIC16C621A | Not Recommended for new designs,Please consider device: PIC16F627A | $1.84 | 1.75 | 96 | 0 | 18 | 40 | No | 4 MHz | 2 | 0 | 0 | 0 | No | 0 | 0 | No | No | 0 | 0 | 1 | 0 | 0 | 0 | 0 | 0 | No | No | 0 | 0 | 0 | 0 | No | No | 0 | 0 | 0 | 0 | 0 | 0 | -40 | 85 | 2.5 | 5.5 | No | 18/PDIP,18/SOIC,20/SSOP
PIC16F19186 | In Production | $1.84 | 28 | 2048 | 256 | 48 | 32 | Yes | 32 MHz, 32 kHz | 2 | 0 | 43 | 12 | Yes | 1 | 5 | No | Yes |  | 0 | 2 | 2 | 0 | 0 | 0 | 0 | No | No | 2 | 1 | 1 | 0 | No | No | 4 | 1 | 0 | 0 | 0 | 248 | -40 | 125 | 1.8 | 5.5 | No | 48/TQFP,48/UQFN
PIC18F65K40 | In Production | $1.84 | 32 | 2048 | 1024 | 64 | 64 | Yes | 64MHZ, 64KHz | 3 | 0 | 47 | 10 | Yes | 1 | 5 | Yes | Yes | 0 | 1 | 5 | 4 | 2 | 1 | 0 | 10 | No | No | 5 | 2 | 2 | 0 | Yes | Yes | 0 | 1 | 0 | 0 | 47 | 0 | -40 | 125 | 1.8 | 5.5 | No | 64/QFN,64/TQFP
PIC16F1788 | In Production | $1.87 | 28 | 2048 | 256 | 28 | 32 | No | 32 MHz, 32 kHz | 4 | 2 | 11 | 12 | No | 4 | 8 | Yes | No | 0 | 0 | 2 | 1 | 0 | 0 | 21 | 16 | No | No | 1 | 1 | 1 | 0 | No | No | 0 | 0 | 0 | 4 | 11 | 0 | -40 | 125 | 1.8 | 5.5 | No | 28/QFN,28/SOIC,28/SPDIP,28/SSOP
PIC16C56A | Not Recommended for new designs,Please consider device: PIC16F54 | $1.89 | 1.5 | 25 | 0 | 18 | 40 | No | 4 MHz | 0 | 0 | 0 | 0 | No | 0 | 0 | No | No | 0 | 0 | 1 | 0 | 0 | 0 | 0 | 0 | No | No | 0 | 0 | 0 | 0 | No | No | 0 | 0 | 0 | 0 | 0 | 0 | -40 | 85 | 2.5 | 5.5 | No | 18/PDIP,18/SOIC,20/SSOP
PIC16F1934 | In Production,Please consider device: PIC16F19175 | $1.89 | 7 | 256 | 256 / HEF | 40 | 32 | No | 32 MHz, 32 kHz | 2 | 0 | 14 | 10 | No | 1 | 5 | Yes | No | 0 | 0 | 4 | 1 | 0 | 0 | 14 | 10 | No | No | 1 | 1 | 1 | 0 | No | No | 0 | 0 | 0 | 0 | 16 | 96 | -40 | 125 | 1.8 | 5.5 | No | 40/PDIP,40/UQFN,44/QFN,44/TQFP
PIC16F883 | In Production | $1.89 | 7 | 256 | 256 / HEF | 28 | 20 | No | 8 MHz, 32 kHz | 2 | 0 | 11 | 10 | No | 0 | 0 | Yes | No | 0 | 0 | 2 | 1 | 0 | 0 | 0 | 10 | No | No | 1 | 1 | 1 | 0 | No | No | 0 | 0 | 0 | 0 | 11 | 0 | -40 | 125 | 2 | 5.5 | No | 28/QFN,28/SOIC,28/SPDIP,28/SSOP
PIC18F46K20 | In Production | $1.90 | 64 | 3936 | 1024 | 40 | 64 | No | 16 MHz, 32 kHz | 2 | 0 | 13 | 10 | No | 0 | 0 | Yes | No | 0 | 0 | 1 | 3 | 0 | 0 | 0 | 10 | No | No | 1 | 1 | 1 | 0 | No | No | 0 | 0 | 0 | 0 | 14 | 0 | -40 | 125 | 1.8 | 3.6 | No | 40/PDIP,40/UQFN,44/QFN,44/TQFP
PIC18F66K40 | In Production | $1.90 | 64 | 3562 | 1024 | 64 | 64 | Yes | 64MHZ, 64KHz | 3 | 0 | 47 | 10 | Yes | 1 | 5 | Yes | Yes | 0 | 1 | 5 | 4 | 2 | 1 | 5 | 10 | No | No | 5 | 2 | 2 | 0 | Yes | Yes | 0 | 1 | 0 | 0 | 47 | 0 | -40 | 125 | 1.8 | 5.5 | No | 64/QFN,64/TQFP
PIC16F1526 | In Production | $1.91 | 14 | 768 | 0 / HEF | 64 | 20 | No | 16 MHz, 32 kHz | 0 | 0 | 30 | 10 | No | 0 | 0 | Yes | No | 0 | 0 | 6 | 3 | 0 | 0 | 10 | 10 | No | No | 2 | 2 | 2 | 0 | No | No | 0 | 0 | 0 | 0 | 30 | 0 | -40 | 125 | 1.8 | 5.5 | No | 64/QFN,64/TQFP
PIC16F1937 | In Production,Please consider device: PIC16F19175 | $1.91 | 14 | 512 | 256 / HEF | 40 | 32 | No | 32 MHz, 32 kHz | 2 | 0 | 14 | 10 | No | 1 | 5 | Yes | No | 0 | 0 | 4 | 1 | 0 | 0 | 14 | 10 | No | No | 1 | 1 | 1 | 0 | No | No | 0 | 0 | 0 | 0 | 16 | 96 | -40 | 125 | 1.8 | 5.5 | No | 40/PDIP,40/QFN,40/UQFN,44/QFN,44/TQFP
PIC18F25J10 | In Production | $1.91 | 32 | 1024 | 0 / HEF | 28 | 40 | No | 32 kHz | 2 | 0 | 10 | 10 | No | 0 | 0 | No | No | 0 | 0 | 1 | 2 | 0 | 0 | 0 | 10 | No | No | 1 | 1 | 1 | 0 | No | No | 0 | 0 | 0 | 0 | 0 | 0 | -40 | 85 | 2 | 3.6 | No | 28/QFN,28/SOIC,28/SPDIP,28/SSOP
PIC18F43K20 | In Production | $1.91 | 8 | 512 | 256 / HEF | 40 | 64 | No | 16 MHz, 32 kHz | 2 | 0 | 13 | 10 | No | 0 | 0 | Yes | No | 0 | 0 | 1 | 3 | 0 | 0 | 0 | 10 | No | No | 1 | 1 | 1 | 0 | No | No | 0 | 0 | 0 | 0 | 14 | 0 | -40 | 125 | 1.8 | 3.6 | No | 40/PDIP,44/QFN,44/TQFP
PIC16F1776 | In Production | $1.92 | 14 | 1024 | 0 / HEF | 28 | 32 | Yes | 32 MHz, 32 kHz | 6 | 3 | 17 | 10 | No | 6 | 10 | Yes | Yes | Yes | 3 | 5 | 3 | 0 | 4 | 21 | 16 | No | No | 1 | 1 | 1 | 0 | No | No | 4 | 3 | 0 | 0 | 17 | 0 | -40 | 125 | 1.8 | 5.5 | No | 28/SOIC,28/SPDIP,28/SSOP,28/UQFN
PIC18F24K22 | In Production | $1.92 | 16 | 768 | 256 / HEF | 28 | 64 | No | 16 MHz, 32 kHz | 2 | 0 | 17 | 10 | No | 1 | 5 | Yes | No | 0 | 0 | 1 | 3 | 0 | 0 | 0 | 0 | No | No | 2 | 2 | 2 | 0 | No | No | 0 | 0 | 0 | 0 | 17 | 0 | -40 | 125 | 1.8 | 5.5 | No | 28/QFN,28/SOIC,28/SPDIP,28/SSOP,28/UQFN
PIC18F47K42 | In Production | $1.95 | 128 | 8192 | 1024 | 40 | 64 | Yes | 64MHZ, 64KHz | 2 | 0 | 35 | 12 | Yes | 1 | 5 | Yes | Yes | 0 | 1 | 3 | 4 | 1 | 3 | 0 | 10 | No | No | 2 | 1 | 2 | 0 | Yes | Yes | 4 | 3 | 1 | 0 | 24 | 0 | -40 | 125 | 1.8 | 5.5 | No | 40/PDIP,40/UQFN,44/QFN,44/TQFP
PIC16F19195 | In Production | $1.98 | 14 | 1024 | 256 | 64 | 32 | Yes | 32 MHz, 32 kHz | 2 | 0 | 45 | 12 | Yes | 1 | 5 | No | Yes |  | 0 | 2 | 2 | 0 | 0 | 0 | 0 | No | No | 2 | 1 | 1 | 0 | No | No | 4 | 1 | 0 | 0 | 0 | 360 | -40 | 125 | 1.8 | 5.5 | No | 64/QFN,64/TQFP
PIC16F727 | In Production | $1.98 | 14 | 368 | 0 / HEF | 40 | 20 | No | 16 MHz | 0 | 0 | 14 | 8 | No | 0 | 0 | Yes | No | 0 | 0 | 2 | 1 | 0 | 0 | 0 | 10 | No | No | 1 | 1 | 1 | 0 | No | No | 0 | 0 | 0 | 0 | 16 | 0 | -40 | 125 | 1.8 | 5.5 | No | 40/PDIP,40/UQFN,44/QFN,44/TQFP
PIC18F14K50 | In Production | $1.98 | 16 | 768 | 256 / HEF | 20 | 48 | No | 16 MHz, 32 kHz | 2 | 0 | 9 | 10 | No | 0 | 0 | Yes | No | 0 | 0 | 1 | 3 | 0 | 0 | 0 | 10 | No | No | 1 | 1 | 1 | 1 | No | No | 0 | 0 | 0 | 0 | 9 | 0 | -40 | 125 | 1.8 | 5.5 | No | 20/PDIP,20/QFN,20/SOIC,20/SSOP,28/SOIC
PIC16F1527 | In Production | $2.00 | 28 | 1536 | 0 / HEF | 64 | 20 | No | 16 MHz, 32 kHz | 0 | 0 | 30 | 10 | No | 0 | 0 | Yes | No | 0 | 0 | 6 | 3 | 0 | 0 | 10 | 10 | No | No | 2 | 2 | 2 | 0 | No | No | 0 | 0 | 0 | 0 | 30 | 0 | -40 | 125 | 1.8 | 5.5 | No | 64/QFN,64/TQFP
PIC16F1784 | In Production | $2.00 | 7 | 512 | 256 | 40 | 32 | No | 32 MHz, 32 kHz | 4 | 3 | 15 | 12 | No | 1 | 8 | Yes | No | 0 | 0 | 2 | 1 | 0 | 0 | 21 | 16 | No | No | 1 | 1 | 1 | 0 | No | No | 0 | 0 | 0 | 3 | 14 | 0 | -40 | 125 | 1.8 | 5.5 | No | 40/PDIP,40/UQFN,44/QFN,44/TQFP
PIC18F44K20 | In Production | $2.00 | 16 | 768 | 256 / HEF | 40 | 64 | No | 16 MHz, 32 kHz | 2 | 0 | 13 | 10 | No | 0 | 0 | Yes | No | 0 | 0 | 1 | 3 | 0 | 0 | 0 | 10 | No | No | 1 | 1 | 1 | 0 | No | No | 0 | 0 | 0 | 0 | 14 | 0 | -40 | 125 | 1.8 | 3.6 | No | 40/PDIP,44/QFN,44/TQFP
PIC12C509 | Not Recommended for new designs,Please consider device: PIC12F509 | $2.01 | 1.5 | 41 | 0 | 8 | 4 | No | 6 MHz | 0 | 0 | 0 | 0 | No | 0 | 0 | No | No | 0 | 0 | 1 | 0 | 0 | 0 | 0 | 0 | No | No | 0 | 0 | 0 | 0 | No | No | 0 | 0 | 0 | 0 | 0 | 0 | -40 | 125 | 2.5 | 5.5 | No | 8/PDIP,8/SOIJ
PIC16C58B | Not Recommended for new designs,Please consider device: PIC16F57 | $2.01 | 3 | 73 | 0 | 18 | 40 | No | 4 MHz | 0 | 0 | 0 | 0 | No | 0 | 0 | No | No | 0 | 0 | 1 | 0 | 0 | 0 | 0 | 0 | No | No | 0 | 0 | 0 | 0 | No | No | 0 | 0 | 0 | 0 | 0 | 0 | -40 | 85 | 2.5 | 5.5 | No | 18/PDIP,18/SOIC,20/SSOP
PIC18F57K42 | In Production | $2.01 | 128 | 8192 | 1024 | 48 | 64 | Yes | 64MHZ, 64KHz | 2 | 0 | 43 | 12 | Yes | 1 | 5 | Yes | Yes | 0 | 1 | 3 | 4 | 1 | 3 | 0 | 10 | No | No | 2 | 1 | 2 | 0 | Yes | Yes | 4 | 3 | 1 | 0 | 24 | 0 | -40 | 125 | 1.8 | 5.5 | No | 48/TQFP,48/UQFN
PIC16F19196 | In Production | $2.03 | 28 | 2048 | 256 | 64 | 32 | Yes | 32 MHz, 32 kHz | 2 | 0 | 45 | 12 | Yes | 1 | 5 | No | Yes |  | 0 | 2 | 2 | 0 | 0 | 0 | 0 | No | No | 2 | 1 | 1 | 0 | No | No | 4 | 1 | 0 | 0 | 0 | 360 | -40 | 125 | 1.8 | 5.5 | No | 64/QFN,64/TQFP,64/VQFN
PIC16F1939 | In Production,Please consider device: PIC16F19176 | $2.03 | 28 | 1024 | 256 | 40 | 32 | No | 32 MHz, 32 kHz | 2 | 0 | 14 | 10 | No | 1 | 5 | Yes | No | 0 | 0 | 4 | 1 | 0 | 0 | 14 | 10 | No | No | 1 | 1 | 1 | 0 | No | No | 0 | 0 | 0 | 0 | 16 | 96 | -40 | 125 | 1.8 | 5.5 | No | 40/PDIP,40/QFN,40/UQFN,44/QFN,44/TQFP,100/TQFP
PIC16F1778 | In Production | $2.05 | 28 | 2048 | 0 / HEF | 28 | 32 | Yes | 32 MHz, 32 kHz | 6 | 3 | 17 | 10 | No | 6 | 10 | Yes | Yes | Yes | 3 | 5 | 3 | 0 | 4 | 21 | 16 | No | No | 1 | 1 | 1 | 0 | Yes | No | 4 | 4 | 0 | 0 | 17 | 0 | -40 | 125 | 1.8 | 5.5 | No | 28/SOIC,28/SPDIP,28/SSOP,28/UQFN
PIC16F818 | In Production | $2.07 | 1.75 | 128 | 128 | 18 | 20 | No | None | 0 | 0 | 5 | 10 | No | 0 | 0 | No | No | 0 | 0 | 2 | 1 | 0 | 0 | 0 | 10 | No | No | 0 | 0 | 0 | 0 | No | No | 0 | 0 | 0 | 0 | 5 | 0 | -40 | 125 | 2 | 5.5 | No | 18/PDIP,18/SOIC,20/SSOP,28/QFN
PIC16F886 | In Production | $2.07 | 14 | 368 | 256 / HEF | 28 | 20 | No | 8 MHz, 32 kHz | 2 | 0 | 11 | 10 | No | 0 | 0 | Yes | No | 0 | 0 | 2 | 1 | 0 | 0 | 0 | 10 | No | No | 1 | 1 | 1 | 0 | No | No | 0 | 0 | 0 | 0 | 11 | 0 | -40 | 125 | 2 | 5.5 | No | 28/QFN,28/SOIC,28/SPDIP,28/SSOP
PIC16C622A | Not Recommended for new designs,Please consider device: PIC16F628A | $2.08 | 3.5 | 128 | 0 | 18 | 40 | No | 4 MHz | 2 | 0 | 0 | 0 | No | 0 | 0 | No | No | 0 | 0 | 1 | 0 | 0 | 0 | 0 | 0 | No | No | 0 | 0 | 0 | 0 | No | No | 0 | 0 | 0 | 0 | 0 | 0 | -40 | 85 | 2.5 | 5.5 | No | 18/PDIP,18/SOIC,20/SSOP
PIC16F628A | In Production,Please consider device: PIC16F18444 | $2.08 | 3.5 | 224 | 128 | 18 | 20 | No | 4 MHz | 2 | 0 | 0 | 0 | No | 0 | 0 | No | No | 0 | 0 | 2 | 1 | 0 | 0 | 1 | 10 | No | No | 1 | 0 | 0 | 0 | No | No | 0 | 0 | 0 | 0 | 0 | 0 | -40 | 125 | 2 | 5.5 | No | 18/PDIP,18/SOIC,20/SSOP,28/QFN
PIC18F43K22 | In Production,Please consider device: PIC18F45Q10 | $2.08 | 8 | 512 | 256 / HEF | 40 | 64 | No | 16 MHz, 32 kHz | 2 | 0 | 28 | 10 | No | 1 | 5 | No | No | 0 | 0 | 1 | 3 | 0 | 0 | 0 | 0 | No | No | 2 | 2 | 2 | 0 | No | No | 0 | 0 | 0 | 0 | 28 | 0 | -40 | 125 | 1.8 | 5.5 | No | 40/PDIP,40/QFN,40/UQFN,44/QFN,44/TQFP
PIC16F1787 | In Production | $2.09 | 14 | 1024 | 256 | 40 | 32 | No | 32 MHz, 32 kHz | 4 | 3 | 15 | 12 | No | 1 | 8 | Yes | No | 0 | 0 | 2 | 1 | 0 | 0 | 21 | 16 | No | No | 1 | 1 | 1 | 0 | No | No | 0 | 0 | 0 | 3 | 15 | 0 | -40 | 125 | 1.8 | 5.5 | No | 40/PDIP,40/UQFN,44/QFN,44/TQFP
PIC16F1789 | In Production | $2.09 | 28 | 2048 | 256 | 40 | 32 | No | 32 MHz, 32 kHz | 4 | 3 | 15 | 12 | No | 4 | 8 | Yes | No | 0 | 0 | 2 | 1 | 0 | 0 | 21 | 16 | No | No | 1 | 1 | 1 | 0 | No | No | 0 | 0 | 0 | 4 | 15 | 0 | -40 | 125 | 1.8 | 5.5 | No | 40/PDIP,40/UQFN,44/QFN,44/TQFP
PIC16C55A | Not Recommended for new designs,Please consider device: PIC16F57 | $2.10 | 0.75 | 24 | 0 | 28 | 40 | No | 4 MHz | 0 | 0 | 0 | 0 | No | 0 | 0 | No | No | 0 | 0 | 1 | 0 | 0 | 0 | 0 | 0 | No | No | 0 | 0 | 0 | 0 | No | No | 0 | 0 | 0 | 0 | 0 | 0 | -40 | 85 | 2.5 | 5.5 | No | 28/PDIP,28/SOIC,28/SPDIP,28/SSOP
PIC18F25K22 | In Production,Please consider device: PIC18F25Q10 | $2.10 | 32 | 1536 | 256 / HEF | 28 | 64 | No | 16 MHz, 32 kHz | 2 | 0 | 17 | 10 | No | 1 | 5 | Yes | No | 0 | 0 | 3 | 4 | 0 | 0 | 0 | 10 | No | No | 2 | 2 | 2 | 0 | No | No | 0 | 0 | 0 | 0 | 17 | 0 | -40 | 125 | 1.8 | 5.5 | No | 28/QFN,28/SOIC,28/SPDIP,28/SSOP
PIC18F45K20 | In Production | $2.11 | 32 | 1536 | 256 / HEF | 40 | 64 | No | 16 MHz, 32 kHz | 2 | 0 | 13 | 10 | No | 0 | 0 | Yes | No | 0 | 0 | 1 | 3 | 0 | 0 | 0 | 10 | No | No | 1 | 1 | 1 | 0 | No | No | 0 | 0 | 0 | 0 | 14 | 0 | -40 | 125 | 1.8 | 3.6 | No | 40/PDIP,40/UQFN,44/QFN,44/TQFP
PIC18F67K40 | In Production | $2.13 | 128 | 3562 | 1024 | 64 | 64 | Yes | 64MHZ, 64KHz | 3 | 0 | 47 | 10 | Yes | 1 | 5 | Yes | Yes | 0 | 1 | 5 | 4 | 2 | 1 | 5 | 10 | No | No | 5 | 2 | 2 | 0 | Yes | Yes | 0 | 1 | 0 | 0 | 47 | 0 | -40 | 125 | 1.8 | 5.5 | No | 64/QFN,64/TQFP
PIC18F24K50 | In Production | $2.14 | 16 | 2048 | 256 / HEF | 28 | 48 | No | 16 MHz, 32 kHz | 2 | 0 | 14 | 10 | No | 1 | 5 | Yes | No | 0 | 0 | 2 | 2 | 0 | 0 | 0 | 10 | No | No | 1 | 1 | 1 | 1 | No | No | 0 | 0 | 0 | 0 | 14 | 0 | -40 | 125 | 1.8 | 5.5 | No | 28/QFN,28/SOIC,28/SPDIP,28/SSOP
PIC18F26K20 | In Production | $2.14 | 64 | 3936 | 1024 | 28 | 64 | No | 16 MHz, 32 kHz | 2 | 0 | 10 | 10 | No | 0 | 0 | Yes | No | 0 | 0 | 1 | 3 | 0 | 0 | 0 | 10 | No | No | 1 | 1 | 1 | 0 | No | No | 0 | 0 | 0 | 0 | 10 | 0 | -40 | 125 | 1.8 | 3.6 | No | 28/QFN,28/SOIC,28/SPDIP,28/SSOP
PIC18F44J10 | In Production | $2.14 | 16 | 1024 | 0 / HEF | 40 | 40 | No | 32 kHz | 2 | 0 | 13 | 10 | No | 0 | 0 | No | No | 0 | 0 | 1 | 2 | 0 | 0 | 0 | 10 | No | No | 1 | 2 | 2 | 0 | No | No | 0 | 0 | 0 | 0 | 0 | 0 | -40 | 85 | 2 | 3.6 | No | 40/PDIP,44/QFN,44/TQFP
PIC12C671 | Not Recommended for new designs,Please consider device: PIC12F675 | $2.15 | 1.75 | 128 | 0 | 8 | 10 | No | 8 MHz | 0 | 0 | 4 | 8 | No | 0 | 0 | No | No | 0 | 0 | 1 | 0 | 0 | 0 | 0 | 0 | No | No | 0 | 0 | 0 | 0 | No | No | 0 | 0 | 0 | 0 | 0 | 0 | -40 | 125 | 2.5 | 5.5 | No | 8/PDIP,8/SOIJ
PIC16C712 | Not Recommended for new designs,Please consider device: PIC16F716 | $2.15 | 1.75 | 128 | 0 | 18 | 20 | No | 4 MHz | 0 | 0 | 4 | 8 | No | 0 | 0 | No | No | 0 | 0 | 2 | 1 | 0 | 0 | 0 | 0 | No | No | 0 | 0 | 0 | 0 | No | No | 0 | 0 | 0 | 0 | 0 | 0 | -40 | 85 | 2.5 | 5.5 | No | 18/PDIP,18/SOIC,20/SSOP
PIC16F19197 | In Production | $2.15 | 56 | 4096 | 256 | 64 | 32 | Yes | 32 MHz, 32 kHz | 2 | 0 | 45 | 12 | Yes | 1 | 5 | No | Yes |  | 0 | 2 | 2 | 0 | 0 | 0 | 0 | No | No | 2 | 1 | 1 | 0 | No | No | 4 | 1 | 0 | 0 | 0 | 360 | -40 | 125 | 1.8 | 5.5 | No | 64/QFN,64/TQFP,64/VQFN
PIC16F707 | In Production | $2.17 | 14 | 368 | 0 / HEF | 40 | 20 | No | 16 MHz | 0 | 0 | 14 | 8 | No | 0 | 0 | Yes | No | 0 | 0 | 3 | 1 | 0 | 0 | 2 | 10 | No | No | 1 | 1 | 1 | 0 | No | No | 0 | 0 | 0 | 0 | 32 | 0 | -40 | 125 | 1.8 | 5.5 | No | 40/PDIP,44/QFN,44/TQFP
PIC16F1946 | In Production,Please consider device: PIC16F19195 | $2.28 | 14 | 512 | 256 / HEF | 64 | 32 | No | 32 MHz, 32 kHz | 3 | 0 | 17 | 10 | No | 1 | 5 | Yes | No | 0 | 0 | 4 | 1 | 0 | 0 | 14 | 10 | No | No | 2 | 2 | 2 | 0 | No | No | 0 | 0 | 0 | 0 | 17 | 184 | -40 | 125 | 1.8 | 5.5 | No | 64/QFN,64/TQFP
PIC18F45J10 | In Production | $2.28 | 32 | 1024 | 0 / HEF | 40 | 40 | No | 32 kHz | 2 | 0 | 13 | 10 | No | 0 | 0 | No | No | 0 | 0 | 1 | 2 | 0 | 0 | 0 | 10 | No | No | 1 | 2 | 2 | 0 | No | No | 0 | 0 | 0 | 0 | 0 | 0 | -40 | 85 | 2 | 3.6 | No | 40/PDIP,44/QFN,44/TQFP
PIC16F884 | In Production | $2.29 | 7 | 256 | 256 / HEF | 40 | 20 | No | 8 MHz, 32 kHz | 2 | 0 | 14 | 10 | No | 0 | 0 | Yes | No | 0 | 0 | 2 | 1 | 0 | 0 | 0 | 10 | No | No | 1 | 1 | 1 | 0 | No | No | 0 | 0 | 0 | 0 | 11 | 0 | -40 | 125 | 2 | 5.5 | No | 40/PDIP,44/QFN,44/TQFP
PIC18F25K50 | In Production | $2.29 | 32 | 2048 | 256 / HEF | 28 | 48 | No | 16 MHz | 2 | 0 | 14 | 10 | No | 1 | 5 | Yes | No | 0 | 0 | 2 | 2 | 0 | 0 | 0 | 10 | No | No | 1 | 1 | 1 | 1 | No | No | 0 | 0 | 0 | 0 | 14 | 0 | -40 | 125 | 1.8 | 5.5 | No | 28/QFN,28/SOIC,28/SPDIP,28/SSOP
PIC12C672 | Not Recommended for new designs,Please consider device: PIC12F683 | $2.30 | 3.5 | 128 | 0 | 8 | 10 | No | 9 MHz | 0 | 0 | 4 | 8 | No | 0 | 0 | No | No | 0 | 0 | 1 | 0 | 0 | 0 | 0 | 0 | No | No | 0 | 0 | 0 | 0 | No | No | 0 | 0 | 0 | 0 | 0 | 0 | -40 | 125 | 2.5 | 5.5 | No | 8/PDIP,8/SOIJ
PIC16F627 | Not Recommended for new designs,Please consider device: PIC16F18444 | $2.33 | 1.75 | 224 | 128 | 18 | 20 | No | No | 2 | 0 | 0 | 0 | No | 0 | 0 | No | No | 0 | 0 | 2 | 1 | 0 | 0 | 0 | 0 | No | No | 0 | 0 | 0 | 0 | No | No | 0 | 0 | 0 | 0 | 0 | 0 | -40 | 85 | 3 | 5.5 | No | 18/PDIP,18/SOIC,20/SSOP
PIC16F819 | In Production | $2.33 | 3.5 | 256 | 256 | 18 | 20 | No | None | 0 | 0 | 5 | 10 | No | 0 | 0 | No | No | 0 | 0 | 2 | 1 | 0 | 0 | 0 | 10 | No | No | 0 | 1 | 1 | 0 | No | No | 0 | 0 | 0 | 0 | 5 | 0 | -40 | 125 | 2 | 5.5 | No | 18/PDIP,18/SOIC,20/SSOP,28/QFN
PIC18F24J11 | In Production | $2.33 | 16 | 3800 | 0 / HEF | 28 | 48 | Yes | 8 MHz, 32 kHz | 2 | 0 | 10 | 10 | No | 0 | 0 | No | No | 0 | 0 | 2 | 3 | 0 | 0 | 0 | 10 | No | No | 2 | 2 | 2 | 0 | No | No | 0 | 0 | 0 | 0 | 10 | 0 | -40 | 85 | 2 | 3.6 | No | 28/QFN,28/SOIC,28/SPDIP,28/SSOP
PIC16F1947 | In Production,Please consider device: PIC16F19196 | $2.35 | 28 | 1024 | 256 / HEF | 64 | 32 | No | 32 MHz, 32 kHz | 3 | 0 | 17 | 10 | No | 1 | 5 | Yes | No | 0 | 0 | 4 | 1 | 0 | 0 | 14 | 10 | No | No | 2 | 2 | 2 | 0 | No | No | 0 | 0 | 0 | 0 | 17 | 184 | -40 | 125 | 1.8 | 5.5 | No | 64/QFN,64/TQFP
PIC16F648A | In Production,Please consider device: PIC16F18444 | $2.35 | 7 | 256 | 256 | 18 | 20 | No | 4 MHz | 2 | 0 | 0 | 0 | No | 0 | 0 | No | No | 0 | 0 | 2 | 1 | 0 | 0 | 1 | 10 | No | No | 0 | 0 | 0 | 0 | No | No | 0 | 0 | 0 | 0 | 0 | 0 | -40 | 125 | 2 | 5.5 | No | 18/PDIP,18/SOIC,20/SSOP,28/QFN
PIC16F1777 | In Production | $2.37 | 14 | 1024 | 0 / HEF | 40 | 32 | Yes | 32 MHz, 32 kHz | 8 | 4 | 28 | 10 | No | 8 | 10 | Yes | Yes | Yes | 4 | 5 | 3 | 0 | 4 | 28 | 16 | No | No | 1 | 1 | 1 | 0 | No | No | 4 | 4 | 0 | 0 | 28 | 0 | -40 | 125 | 1.8 | 5.5 | No | 40/PDIP,40/UQFN,44/QFN,44/TQFP
PIC16F913 | In Production | $2.37 | 7 | 256 | 256 | 28 | 20 | No | 8 MHz, 32 kHz | 2 | 0 | 5 | 10 | No | 0 | 0 | No | No | 0 | 0 | 2 | 1 | 0 | 0 | 0 | 10 | No | No | 1 | 1 | 1 | 0 | No | No | 0 | 0 | 0 | 0 | 5 | 60 | -40 | 125 | 2 | 5.5 | No | 28/QFN,28/SOIC,28/SPDIP,28/SSOP
PIC16C716 | Not Recommended for new designs,Please consider device: PIC16F716 | $2.42 | 3.5 | 128 | 0 | 18 | 20 | No | 4 MHz | 0 | 0 | 4 | 8 | No | 0 | 0 | No | No | 0 | 0 | 2 | 1 | 0 | 0 | 0 | 0 | No | No | 0 | 0 | 0 | 0 | No | No | 0 | 0 | 0 | 0 | 0 | 0 | -40 | 85 | 2.5 | 5.5 | No | 18/PDIP,18/SOIC,20/SSOP
PIC18F45K22 | In Production,Please consider device: PIC18F45Q10 | $2.44 | 32 | 1536 | 256 / HEF | 40 | 64 | No | 16 MHz, 32 kHz | 2 | 0 | 28 | 10 | No | 1 | 5 | Yes | No | 0 | 0 | 3 | 4 | 0 | 0 | 0 | 10 | No | No | 2 | 2 | 2 | 0 | No | No | 0 | 0 | 0 | 0 | 28 | 0 | -40 | 125 | 1.8 | 5.5 | No | 40/PDIP,40/UQFN,44/QFN,44/TQFP
PIC16C57C | Not Recommended for new designs,Please consider device: PIC16F57 | $2.45 | 3 | 72 | 0 | 28 | 40 | No | 4 MHz | 0 | 0 | 0 | 0 | No | 0 | 0 | No | No | 0 | 0 | 1 | 0 | 0 | 0 | 0 | 0 | No | No | 0 | 0 | 0 | 0 | No | No | 0 | 0 | 0 | 0 | 0 | 0 | -40 | 85 | 2.5 | 5.5 | No | 28/PDIP,28/SOIC,28/SPDIP,28/SSOP
PIC16C770 | Not Recommended for new designs,Please consider device: PIC16F819 | $2.45 | 3.5 | 256 | 0 | 20 | 20 | No | 4 MHz | 0 | 0 | 6 | 12 | No | 0 | 0 | No | No | 0 | 0 | 2 | 1 | 0 | 0 | 0 | 0 | No | No | 0 | 1 | 1 | 0 | No | No | 0 | 0 | 0 | 0 | 0 | 0 | -40 | 85 | 2.5 | 5.5 | No | 20/PDIP,20/SOIC,20/SSOP
PIC18F25K80 | In Production | $2.47 | 32 | 3648 | 1024 | 28 | 64 | No | 16 MHz, 32 kHz | 2 | 0 | 8 | 12 | No | 0 | 0 | No | No | 0 | 0 | 2 | 3 | 0 | 0 | 0 | 10 | No | No | 2 | 1 | 1 | 0 | Yes | No | 0 | 0 | 0 | 0 | 8 | 0 | -40 | 125 | 1.8 | 5.5 | No | 28/QFN-S,28/SOIC,28/SPDIP,28/SSOP
PIC18F26K22 | In Production,Please consider device: PIC18F26Q10 | $2.47 | 64 | 3896 | 1024 | 28 | 64 | No | 16 MHz, 32 kHz | 2 | 0 | 17 | 10 | No | 1 | 5 | Yes | No | 0 | 0 | 3 | 4 | 0 | 0 | 0 | 0 | No | No | 2 | 2 | 2 | 0 | No | No | 0 | 0 | 0 | 0 | 17 | 0 | -40 | 125 | 1.8 | 5.5 | No | 28/QFN,28/SOIC,28/SPDIP,28/SSOP
PIC18F66J11 | In Production | $2.47 | 64 | 3904 | 0 / HEF | 64 | 48 | No | 8 MHz, 32 kHz | 2 | 0 | 11 | 10 | No | 0 | 0 | No | No | 0 | 0 | 2 | 3 | 0 | 0 | 14 | 10 | No | No | 2 | 2 | 2 | 0 | No | No | 0 | 0 | 0 | 0 | 0 | 0 | -40 | 85 | 2 | 3.6 | No | 64/TQFP
PIC16C717 | Not Recommended for new designs,Please consider device: PIC16F690 | $2.49 | 3.5 | 256 | 0 | 18 | 20 | No | 4 MHz | 0 | 0 | 6 | 10 | No | 0 | 0 | No | No | 0 | 0 | 2 | 1 | 0 | 0 | 0 | 0 | No | No | 0 | 1 | 1 | 0 | No | No | 0 | 0 | 0 | 0 | 0 | 0 | -40 | 85 | 2.5 | 5.5 | No | 18/PDIP,18/SOIC,20/SSOP
PIC16F72 | In Production | $2.49 | 3.5 | 128 | 0 | 28 | 20 | No | No | 0 | 0 | 5 | 8 | No | 0 | 0 | No | No | 0 | 0 | 2 | 1 | 0 | 0 | 0 | 10 | No | No | 0 | 0 | 0 | 0 | No | No | 0 | 0 | 0 | 0 | 0 | 0 | -40 | 125 | 2 | 5.5 | No | 28/QFN,28/SOIC,28/SPDIP,28/SSOP
PIC16F1779 | In Production | $2.50 | 28 | 2048 | 0 / HEF | 40 | 32 | Yes | 32 MHz, 32 kHz | 8 | 4 | 28 | 10 | No | 8 | 10 | Yes | Yes | Yes | 4 | 5 | 3 | 0 | 4 | 28 | 16 | No | No | 1 | 1 | 1 | 0 | No | No | 4 | 4 | 0 | 0 | 28 | 0 | -40 | 125 | 1.8 | 5.5 | No | 40/PDIP,40/QFN,40/UQFN,40/VQFN,44/QFN,44/TQFP
PIC16F887 | In Production,Please consider device: PIC16F18877 | $2.50 | 14 | 368 | 256 / HEF | 40 | 20 | No | 8 MHz, 32 kHz | 2 | 0 | 14 | 10 | No | 0 | 0 | Yes | No | 0 | 0 | 2 | 1 | 0 | 0 | 0 | 10 | No | No | 1 | 1 | 1 | 0 | No | No | 0 | 0 | 0 | 0 | 11 | 0 | -40 | 125 | 2 | 5.5 | No | 40/PDIP,44/QFN,44/TQFP
PIC18F25J11 | In Production | $2.53 | 32 | 3800 | 0 / HEF | 28 | 48 | Yes | 8 MHz, 32 kHz | 2 | 0 | 10 | 10 | No | 0 | 0 | No | No | 0 | 0 | 2 | 3 | 0 | 0 | 0 | 10 | No | No | 2 | 2 | 2 | 0 | No | No | 0 | 0 | 0 | 0 | 10 | 0 | -40 | 85 | 2 | 3.6 | No | 28/QFN,28/SOIC,28/SPDIP,28/SSOP
PIC18F1220 | In Production | $2.54 | 4 | 256 | 256 / HEF | 18 | 40 | No | 8 MHz, 32 kHz | 0 | 0 | 7 | 10 | No | 0 | 0 | No | No | 0 | 0 | 1 | 3 | 0 | 0 | 0 | 10 | No | No | 1 | 0 | 0 | 0 | No | No | 0 | 0 | 0 | 0 | 0 | 0 | -40 | 125 | 2 | 5.5 | No | 18/PDIP,18/SOIC,20/SSOP,28/QFN
PIC16CE623 | Not Recommended for new designs,Please consider device: PIC16F627A | $2.58 | 0.875 | 96 | 128 | 18 | 30 | No | 4 MHz | 2 | 0 | 0 | 0 | No | 0 | 0 | No | No | 0 | 0 | 1 | 0 | 0 | 0 | 0 | 0 | No | No | 0 | 0 | 0 | 0 | No | No | 0 | 0 | 0 | 0 | 0 | 0 | -40 | 85 | 2.5 | 5.5 | No | 18/PDIP,20/SSOP
PIC18F45K50 | In Production | $2.58 | 32 | 2048 | 256 | 40 | 48 | No | 16 MHz | 2 | 0 | 25 | 10 | No | 1 | 5 | Yes | No | 0 | 0 | 2 | 2 | 0 | 0 | 0 | 10 | No | No | 1 | 1 | 1 | 1 | No | No | 0 | 0 | 0 | 0 | 25 | 0 | -40 | 125 | 1.8 | 5.5 | No | 40/PDIP,40/UQFN,44/TQFP
PIC16C710 | Not Recommended for new designs,Please consider device: PIC16F716 | $2.61 | 0.875 | 36 | 0 | 18 | 20 | No | 4 MHz | 0 | 0 | 4 | 8 | No | 0 | 0 | No | No | 0 | 0 | 1 | 0 | 0 | 0 | 0 | 0 | No | No | 0 | 0 | 0 | 0 | No | No | 0 | 0 | 0 | 0 | 0 | 0 | -40 | 85 | 2.5 | 5.5 | No | 18/PDIP,18/SOIC,20/SSOP
PIC18F63J11 | In Production | $2.63 | 8 | 1024 | 0 / HEF | 64 | 40 | No | 8 MHz, 32 kHz | 2 | 0 | 12 | 10 | No | 0 | 0 | No | No | 0 | 0 | 1 | 3 | 0 | 0 | 0 | 10 | No | No | 2 | 1 | 1 | 0 | No | No | 0 | 0 | 0 | 0 | 0 | 0 | -40 | 85 | 2 | 3.6 | No | 64/TQFP
PIC18F24J50 | In Production | $2.64 | 16 | 3800 | 0 / HEF | 28 | 48 | Yes | 8 MHz, 32 kHz | 2 | 0 | 10 | 10 | No | 0 | 0 | No | No | 0 | 0 | 2 | 3 | 0 | 0 | 0 | 10 | No | No | 2 | 2 | 2 | 1 | No | No | 0 | 0 | 0 | 0 | 10 | 0 | -40 | 85 | 2 | 3.6 | No | 28/QFN,28/SOIC,28/SPDIP,28/SSOP
PIC18F66J16 | In Production | $2.64 | 96 | 3904 | 0 / HEF | 64 | 48 | No | 8 MHz, 32 kHz | 2 | 0 | 11 | 10 | No | 0 | 0 | No | No | 0 | 0 | 2 | 3 | 0 | 0 | 14 | 10 | No | No | 2 | 2 | 2 | 0 | No | No | 0 | 0 | 0 | 0 | 0 | 0 | -40 | 85 | 2 | 3.6 | No | 64/TQFP
PIC16F628 | Not Recommended for new designs,Please consider device: PIC16F18444 | $2.65 | 3.5 | 224 | 128 | 18 | 20 | No | No | 2 | 0 | 0 | 0 | No | 0 | 0 | No | No | 0 | 0 | 2 | 1 | 0 | 0 | 0 | 0 | No | No | 1 | 0 | 0 | 0 | No | No | 0 | 0 | 0 | 0 | 0 | 0 | -40 | 85 | 3 | 5.5 | No | 18/PDIP,18/SOIC,20/SSOP
PIC16C711 | Not Recommended for new designs,Please consider device: PIC16F716 | $2.67 | 1.75 | 68 | 0 | 18 | 20 | No | 4 MHz | 0 | 0 | 4 | 8 | No | 0 | 0 | No | No | 0 | 0 | 1 | 0 | 0 | 0 | 0 | 0 | No | No | 0 | 0 | 0 | 0 | No | No | 0 | 0 | 0 | 0 | 0 | 0 | -40 | 85 | 2.5 | 5.5 | No | 18/PDIP,18/SOIC,20/SSOP
PIC16F916 | In Production | $2.67 | 14 | 352 | 256 | 28 | 20 | No | 8 MHz, 32 kHz | 2 | 0 | 5 | 10 | No | 0 | 0 | No | No | 0 | 0 | 2 | 1 | 0 | 0 | 0 | 10 | No | No | 1 | 1 | 1 | 0 | No | No | 0 | 0 | 0 | 0 | 5 | 60 | -40 | 125 | 2 | 5.5 | No | 28/QFN,28/SOIC,28/SPDIP,28/SSOP
PIC18F2221 | In Production | $2.67 | 4 | 512 | 256 / HEF | 28 | 40 | No | 8 MHz, 32 kHz | 2 | 0 | 10 | 10 | No | 0 | 0 | No | No | 0 | 0 | 1 | 3 | 0 | 0 | 0 | 10 | No | No | 1 | 1 | 1 | 0 | No | No | 0 | 0 | 0 | 0 | 0 | 0 | -40 | 125 | 2 | 5.5 | No | 28/QFN,28/SOIC,28/SPDIP,28/SSOP
PIC18F1230 | In Production | $2.68 | 4 | 256 | 128 | 18 | 40 | No | 8 MHz, 32 kHz | 3 | 0 | 4 | 10 | No | 0 | 0 | No | No | 0 | 0 | 0 | 2 | 0 | 0 | 0 | 0 | No | No | 1 | 0 | 0 | 0 | No | No | 0 | 0 | 0 | 0 | 0 | 0 | -40 | 125 | 2 | 5.5 | No | 18/PDIP,18/SOIC,20/SSOP,28/QFN
PIC12CE673 | Not Recommended for new designs,Please consider device: PIC12F675 | $2.70 | 1.75 | 128 | 16 | 8 | 10 | No | 12 MHz | 0 | 0 | 4 | 8 | No | 0 | 0 | No | No | 0 | 0 | 1 | 0 | 0 | 0 | 0 | 0 | No | No | 0 | 0 | 0 | 0 | No | No | 0 | 0 | 0 | 0 | 0 | 0 | -40 | 125 | 2.5 | 5.5 | No | 8/PDIP
PIC12CE674 | Not Recommended for new designs,Please consider device: PIC12F683 | $2.70 | 3.5 | 128 | 16 | 8 | 10 | No | 13 MHz | 0 | 0 | 4 | 8 | No | 0 | 0 | No | No | 0 | 0 | 1 | 0 | 0 | 0 | 0 | 0 | No | No | 0 | 0 | 0 | 0 | No | No | 0 | 0 | 0 | 0 | 0 | 0 | -40 | 125 | 2.5 | 5.5 | No | 8/PDIP
PIC18F64J11 | In Production | $2.72 | 16 | 1024 | 0 / HEF | 64 | 40 | No | 8 MHz, 32 kHz | 2 | 0 | 12 | 10 | No | 0 | 0 | No | No | 0 | 0 | 1 | 3 | 0 | 0 | 0 | 10 | No | No | 2 | 1 | 1 | 0 | No | No | 0 | 0 | 0 | 0 | 0 | 0 | -40 | 85 | 2 | 3.6 | No | 64/TQFP
PIC16C771 | Not Recommended for new designs | $2.75 | 7 | 256 | 0 | 20 | 20 | No | 4 MHz | 0 | 0 | 6 | 12 | No | 0 | 0 | No | No | 0 | 0 | 2 | 1 | 0 | 0 | 0 | 0 | No | No | 0 | 1 | 1 | 0 | No | No | 0 | 0 | 0 | 0 | 0 | 0 | -40 | 85 | 2.5 | 5.5 | No | 20/PDIP,20/SOIC,20/SSOP
PIC18F65J10 | In Production | $2.75 | 32 | 2048 | 0 / HEF | 64 | 40 | No | 32 kHz | 2 | 0 | 11 | 10 | No | 0 | 0 | No | No | 0 | 0 | 2 | 3 | 0 | 0 | 0 | 10 | No | No | 2 | 2 | 2 | 0 | No | No | 0 | 0 | 0 | 0 | 0 | 0 | -40 | 85 | 2 | 3.6 | No | 64/TQFP
PIC18F44J11 | In Production | $2.76 | 16 | 3800 | 0 / HEF | 44 | 48 | Yes | 8 MHz, 32 kHz | 2 | 0 | 13 | 10 | No | 0 | 0 | No | No | 0 | 0 | 2 | 3 | 0 | 0 | 0 | 10 | No | No | 2 | 2 | 2 | 0 | No | No | 0 | 0 | 0 | 0 | 13 | 0 | -40 | 85 | 2 | 3.6 | No | 44/QFN,44/TQFP
PIC18F67J11 | In Production | $2.76 | 128 | 3904 | 0 / HEF | 64 | 48 | No | 8 MHz, 32 kHz | 2 | 0 | 11 | 10 | No | 0 | 0 | No | No | 0 | 0 | 2 | 3 | 0 | 0 | 14 | 10 | No | No | 2 | 2 | 2 | 0 | No | No | 0 | 0 | 0 | 0 | 0 | 0 | -40 | 85 | 2 | 3.6 | No | 64/TQFP
PIC16CE624 | Not Recommended for new designs,Please consider device: PIC16F627A | $2.80 | 1.75 | 96 | 128 | 18 | 30 | No | 4 MHz | 2 | 0 | 0 | 0 | No | 0 | 0 | No | No | 0 | 0 | 1 | 0 | 0 | 0 | 0 | 0 | No | No | 0 | 0 | 0 | 0 | No | No | 0 | 0 | 0 | 0 | 0 | 0 | -40 | 85 | 2.5 | 5.5 | No | 18/SOIC,20/SSOP
PIC16F914 | In Production | $2.80 | 7 | 256 | 256 | 40 | 20 | No | 8 MHz, 32 kHz | 2 | 0 | 8 | 10 | No | 0 | 0 | No | No | 0 | 0 | 2 | 1 | 0 | 0 | 0 | 10 | No | No | 1 | 1 | 1 | 0 | No | No | 0 | 0 | 0 | 0 | 8 | 96 | -40 | 125 | 2 | 5.5 | No | 40/PDIP,44/QFN,44/TQFP
PIC18F46K22 | In Production,Please consider device: PIC18F46Q10 | $2.80 | 64 | 3896 | 1024 | 40 | 64 | No | 16 MHz, 32 kHz | 2 | 0 | 28 | 10 | No | 1 | 5 | Yes | No | 0 | 0 | 3 | 4 | 0 | 0 | 0 | 0 | No | No | 2 | 2 | 2 | 0 | No | No | 0 | 0 | 0 | 0 | 28 | 0 | -40 | 125 | 1.8 | 5.5 | No | 40/PDIP,40/UQFN,44/QFN,44/TQFP
PIC18F1320 | In Production | $2.81 | 8 | 256 | 256 / HEF | 18 | 40 | No | 8 MHz, 32 kHz | 0 | 0 | 7 | 10 | No | 0 | 0 | No | No | 0 | 0 | 1 | 3 | 0 | 0 | 0 | 10 | No | No | 1 | 0 | 0 | 0 | No | No | 0 | 0 | 0 | 0 | 0 | 0 | -40 | 125 | 2 | 5.5 | No | 18/PDIP,18/SOIC,20/SSOP,28/QFN
PIC18F45K80 | In Production | $2.81 | 32 | 3648 | 1024 | 44 | 64 | No | 16 MHz, 32 kHz | 2 | 0 | 11 | 12 | No | 0 | 0 | No | No | 0 | 0 | 2 | 3 | 0 | 0 | 0 | 10 | No | No | 2 | 1 | 1 | 0 | No | No | 0 | 0 | 0 | 0 | 11 | 0 | -40 | 125 | 1.8 | 5.5 | No | 40/PDIP,44/QFN,44/TQFP
PIC18F25J50 | In Production | $2.84 | 32 | 3800 | 0 / HEF | 28 | 48 | Yes | 8 MHz, 32 kHz | 2 | 0 | 10 | 10 | No | 0 | 0 | No | No | 0 | 0 | 2 | 3 | 0 | 0 | 0 | 10 | No | No | 2 | 2 | 2 | 1 | No | No | 0 | 0 | 0 | 0 | 10 | 0 | -40 | 85 | 2 | 3.6 | No | 28/QFN,28/SOIC,28/SPDIP,28/SSOP
PIC18F26K80 | In Production | $2.84 | 64 | 3648 | 1024 | 28 | 64 | No | 16 MHz, 32 kHz | 2 | 0 | 8 | 12 | No | 0 | 0 | No | No | 0 | 0 | 2 | 3 | 0 | 0 | 0 | 10 | No | No | 2 | 1 | 1 | 0 | No | No | 0 | 0 | 0 | 0 | 8 | 0 | -40 | 125 | 1.8 | 5.5 | No | 28/QFN-S,28/SOIC,28/SPDIP,28/SSOP
PIC18F63J90 | In Production | $2.84 | 8 | 1024 | 0 / HEF | 64 | 40 | No | 8 MHz, 32 kHz | 2 | 0 | 12 | 10 | No | 0 | 0 | No | No | 0 | 0 | 1 | 3 | 0 | 0 | 0 | 10 | No | No | 2 | 1 | 1 | 0 | No | No | 0 | 0 | 0 | 0 | 0 | 132 | -40 | 85 | 2 | 3.6 | No | 64/TQFP
PIC18F2321 | In Production | $2.85 | 8 | 512 | 256 / HEF | 28 | 40 | No | 8 MHz, 32 kHz | 2 | 0 | 10 | 10 | No | 0 | 0 | No | No | 0 | 0 | 1 | 3 | 0 | 0 | 0 | 10 | No | No | 1 | 1 | 1 | 0 | No | No | 0 | 0 | 0 | 0 | 0 | 0 | -40 | 125 | 2 | 5.5 | No | 28/QFN,28/SOIC,28/SPDIP,28/SSOP
PIC18F65J11 | In Production | $2.86 | 32 | 2048 | 0 / HEF | 64 | 40 | No | 8 MHz, 32 kHz | 2 | 0 | 12 | 10 | No | 0 | 0 | No | No | 0 | 0 | 1 | 3 | 0 | 0 | 0 | 10 | No | No | 2 | 1 | 1 | 0 | No | No | 0 | 0 | 0 | 0 | 0 | 0 | -40 | 85 | 2 | 3.6 | No | 64/TQFP
PIC16C54A | Not Recommended for new designs,Please consider device: PIC16F54 | $2.89 | 0.75 | 25 | 0 | 18 | 20 | No | 4 MHz | 0 | 0 | 0 | 0 | No | 0 | 0 | No | No | 0 | 0 | 1 | 0 | 0 | 0 | 0 | 0 | No | No | 0 | 0 | 0 | 0 | No | No | 0 | 0 | 0 | 0 | 0 | 0 | -40 | 85 | 2 | 6.3 | No | 18/PDIP,18/SOIC,20/SSOP
PIC16F87 | In Production | $2.90 | 7 | 368 | 256 | 18 | 20 | No | 8 MHz | 2 | 0 | 0 | 0 | No | 0 | 0 | No | No | 0 | 0 | 2 | 1 | 0 | 0 | 0 | 10 | No | No | 0 | 0 | 0 | 0 | No | No | 0 | 0 | 0 | 0 | 0 | 0 | -40 | 125 | 2 | 5.5 | No | 18/PDIP,18/SOIC,20/SSOP,28/QFN
PIC18F64J90 | In Production | $2.91 | 16 | 1024 | 0 / HEF | 64 | 40 | No | 8 MHz, 32 kHz | 2 | 0 | 12 | 10 | No | 0 | 0 | No | No | 0 | 0 | 1 | 3 | 0 | 0 | 0 | 10 | No | No | 2 | 1 | 1 | 0 | No | No | 0 | 0 | 0 | 0 | 0 | 132 | -40 | 85 | 2 | 3.6 | No | 64/TQFP
PIC18F26J11 | In Production | $2.92 | 64 | 3800 | 0 / HEF | 28 | 48 | Yes | 8 MHz, 32 kHz | 2 | 0 | 10 | 10 | No | 0 | 0 | No | No | 0 | 0 | 2 | 3 | 0 | 0 | 0 | 10 | No | No | 2 | 2 | 2 | 0 | No | No | 0 | 0 | 0 | 0 | 10 | 0 | -40 | 85 | 2 | 3.6 | No | 28/QFN,28/SOIC,28/SPDIP,28/SSOP
PIC18F45J11 | In Production | $2.95 | 32 | 3800 | 0 / HEF | 44 | 48 | Yes | 8 MHz, 32 kHz | 2 | 0 | 13 | 10 | No | 0 | 0 | No | No | 0 | 0 | 2 | 3 | 0 | 0 | 0 | 10 | No | No | 2 | 2 | 2 | 0 | No | No | 0 | 0 | 0 | 0 | 13 | 0 | -40 | 85 | 2 | 3.6 | No | 44/QFN,44/TQFP
PIC18F65J15 | In Production | $2.95 | 48 | 2048 | 0 / HEF | 64 | 40 | No | 32 kHz | 2 | 0 | 11 | 10 | No | 0 | 0 | No | No | 0 | 0 | 2 | 3 | 0 | 0 | 0 | 10 | No | No | 2 | 2 | 2 | 0 | No | No | 0 | 0 | 0 | 0 | 0 | 0 | -40 | 85 | 2 | 3.6 | No | 64/TQFP
PIC18F1330 | In Production | $2.96 | 8 | 256 | 128 | 18 | 40 | No | 8 MHz, 32 kHz | 3 | 0 | 4 | 10 | No | 0 | 0 | No | No | 0 | 0 | 0 | 2 | 0 | 0 | 0 | 0 | No | No | 1 | 0 | 0 | 0 | No | No | 0 | 0 | 0 | 0 | 0 | 0 | -40 | 125 | 2 | 5.5 | No | 18/PDIP,18/SOIC,20/SSOP,28/QFN
PIC18F4221 | In Production | $2.96 | 4 | 512 | 256 / HEF | 40 | 40 | No | 8 MHz, 32 kHz | 2 | 0 | 13 | 10 | No | 0 | 0 | No | No | 0 | 0 | 1 | 3 | 0 | 0 | 0 | 10 | No | No | 1 | 1 | 1 | 0 | No | No | 0 | 0 | 0 | 0 | 0 | 0 | -40 | 85 | 2 | 5.5 | No | 40/PDIP,44/QFN,44/TQFP
PIC16F639 | In Production,Please consider device: PIC16F18344 | $3.00 | 3.5 | 128 | 256 | 20 | 20 | No | 8 MHz, 32 kHz | 2 | 0 | 0 | 0 | No | 0 | 0 | No | No | 0 | 0 | 1 | 1 | 0 | 0 | 0 | 0 | No | No | 0 | 0 | 0 | 0 | No | No | 0 | 0 | 0 | 0 | 0 | 0 | -40 | 125 | 2 | 5.5 | No | 20/SSOP
PIC16F917 | In Production | $3.00 | 14 | 352 | 256 | 40 | 20 | No | 8 MHz, 32 kHz | 2 | 0 | 8 | 10 | No | 0 | 0 | No | No | 0 | 0 | 2 | 1 | 0 | 0 | 0 | 10 | No | No | 1 | 1 | 1 | 0 | No | No | 0 | 0 | 0 | 0 | 8 | 96 | -40 | 125 | 2 | 5.5 | No | 40/PDIP,44/QFN,44/TQFP
PIC18F83J11 | In Production | $3.00 | 8 | 1024 | 0 / HEF | 80 | 40 | No | 8 MHz, 32 kHz | 2 | 0 | 12 | 10 | No | 0 | 0 | No | No | 0 | 0 | 1 | 3 | 0 | 0 | 2 | 10 | No | No | 2 | 1 | 1 | 0 | No | No | 0 | 0 | 0 | 0 | 0 | 0 | -40 | 85 | 2 | 3.6 | No | 80/TQFP
PIC16C715 | Not Recommended for new designs,Please consider device: PIC16F716 | $3.01 | 3.5 | 128 | 0 | 18 | 20 | No | 4 MHz | 0 | 0 | 4 | 8 | No | 0 | 0 | No | No | 0 | 0 | 1 | 0 | 0 | 0 | 0 | 0 | No | No | 0 | 0 | 0 | 0 | No | No | 0 | 0 | 0 | 0 | 0 | 0 | -40 | 85 | 2.5 | 5.5 | No | 18/PDIP,18/SOIC,20/SSOP
PIC18F2450 | In Production | $3.03 | 16 | 768 | 0 / HEF | 28 | 48 | No | 32 kHz | 0 | 0 | 10 | 10 | No | 0 | 0 | No | No | 0 | 0 | 1 | 2 | 0 | 0 | 0 | 10 | No | No | 1 | 0 | 0 | 1 | No | No | 0 | 0 | 0 | 0 | 0 | 0 | -40 | 85 | 2 | 5.5 | No | 28/QFN,28/SOIC,28/SPDIP
PIC18F44J50 | In Production | $3.07 | 16 | 3800 | 0 / HEF | 44 | 48 | Yes | 8 MHz, 32 kHz | 2 | 0 | 13 | 10 | No | 0 | 0 | No | No | 0 | 0 | 2 | 3 | 0 | 0 | 0 | 10 | No | No | 2 | 2 | 2 | 1 | No | No | 0 | 0 | 0 | 0 | 13 | 0 | -40 | 85 | 2 | 3.6 | No | 44/QFN,44/TQFP
PIC16C54 | Not Recommended for new designs,Please consider device: PIC16F54 | $3.08 | 0.75 | 25 | 0 | 18 | 20 | No | 4 MHz | 0 | 0 | 0 | 0 | No | 0 | 0 | No | No | 0 | 0 | 1 | 0 | 0 | 0 | 0 | 0 | No | No | 0 | 0 | 0 | 0 | No | No | 0 | 0 | 0 | 0 | 0 | 0 | -40 | 85 | 2.5 | 6.3 | No | 18/PDIP,18/SOIC,20/SSOP
PIC18F65J90 | In Production | $3.08 | 32 | 2048 | 0 / HEF | 64 | 40 | No | 8 MHz, 32 kHz | 2 | 0 | 12 | 10 | No | 0 | 0 | No | No | 0 | 0 | 1 | 3 | 0 | 0 | 0 | 10 | No | No | 2 | 1 | 1 | 0 | No | No | 0 | 0 | 0 | 0 | 0 | 132 | -40 | 85 | 2 | 3.6 | No | 64/TQFP
PIC18F84J11 | In Production | $3.09 | 16 | 1024 | 0 / HEF | 80 | 40 | No | 8 MHz, 32 kHz | 2 | 0 | 12 | 10 | No | 0 | 0 | No | No | 0 | 0 | 1 | 3 | 0 | 0 | 2 | 10 | No | No | 2 | 1 | 1 | 0 | No | No | 0 | 0 | 0 | 0 | 0 | 0 | -40 | 85 | 2 | 3.6 | No | 80/TQFP
PIC18F65J94 | In Production | $3.10 | 32 | 3862 | 0 / HEF | 64 | 64 | No | 8 MHz, 32 kHz | 3 | 0 | 16 | 12 | No | 0 | 0 | Yes | No | 0 | 0 | 0 | 4 | 0 | 0 | 0 | 0 | No | No | 4 | 2 | 2 | 1 | No | No | 0 | 0 | 0 | 0 | 0 | 256 | -40 | 85 | 2 | 3.6 | No | 64/QFN,64/TQFP
PIC18F85J10 | In Production | $3.10 | 32 | 2048 | 0 / HEF | 80 | 40 | No | 32 kHz | 2 | 0 | 15 | 10 | No | 0 | 0 | No | No | 0 | 0 | 2 | 3 | 0 | 0 | 14 | 10 | No | No | 2 | 2 | 2 | 0 | No | No | 0 | 0 | 0 | 0 | 0 | 0 | -40 | 85 | 2 | 3.6 | No | 80/TQFP
PIC18F65K22 | In Production | $3.11 | 32 | 2048 | 1024 | 64 | 64 | No | 16 MHz, 32 kHz | 3 | 0 | 16 | 12 | No | 0 | 0 | Yes | No | 0 | 0 | 4 | 4 | 0 | 0 | 0 | 0 | No | No | 2 | 2 | 2 | 0 | Yes | No | 0 | 0 | 0 | 0 | 16 | 0 | -40 | 125 | 1.8 | 5.5 | No | 64/QFN,64/TQFP
PIC16C554 | Not Recommended for new designs,Please consider device: PIC16F627A | $3.12 | 0.875 | 80 | 0 | 18 | 20 | No | 4 MHz | 0 | 0 | 0 | 0 | No | 0 | 0 | No | No | 0 | 0 | 1 | 0 | 0 | 0 | 0 | 0 | No | No | 0 | 0 | 0 | 0 | No | No | 0 | 0 | 0 | 0 | 0 | 0 | -40 | 85 | 2.5 | 5.5 | No | 18/PDIP,18/SOIC,20/SSOP
PIC16F88 | In Production | $3.12 | 7 | 368 | 256 | 18 | 20 | No | None | 2 | 0 | 7 | 10 | No | 0 | 0 | No | No | 0 | 0 | 2 | 1 | 0 | 0 | 0 | 10 | No | No | 1 | 1 | 1 | 0 | No | No | 0 | 0 | 0 | 0 | 0 | 0 | -40 | 125 | 2 | 5.5 | No | 18/PDIP,18/SOIC,20/SSOP,28/QFN
PIC18F26J13 | In Production | $3.13 | 64 | 3800 | 0 / HEF | 28 | 48 | Yes | 8 MHz, 32 kHz | 3 | 0 | 10 | 12 | No | 0 | 0 | No | No | 0 | 0 | 4 | 4 | 0 | 0 | 0 | 10 | No | No | 2 | 2 | 2 | 0 | No | No | 0 | 0 | 0 | 0 | 10 | 0 | -40 | 85 | 2 | 3.6 | No | 28/QFN,28/SOIC,28/SPDIP,28/SSOP
PIC16C62B | Not Recommended for new designs,Please consider device: PIC16F722A | $3.15 | 3.5 | 128 | 0 | 28 | 20 | No | 4 MHz | 0 | 0 | 0 | 0 | No | 0 | 0 | No | No | 0 | 0 | 2 | 1 | 0 | 0 | 0 | 0 | No | No | 0 | 1 | 1 | 0 | No | No | 0 | 0 | 0 | 0 | 0 | 0 | -40 | 85 | 2.5 | 6 | No | 28/SOIC,28/SPDIP,28/SSOP
PIC18F66J10 | In Production | $3.16 | 64 | 2048 | 0 / HEF | 64 | 40 | No | 32 kHz | 2 | 0 | 11 | 10 | No | 0 | 0 | No | No | 0 | 0 | 2 | 3 | 0 | 0 | 14 | 10 | No | No | 2 | 2 | 2 | 0 | No | No | 0 | 0 | 0 | 0 | 0 | 0 | -40 | 85 | 2 | 3.6 | No | 64/TQFP
PIC18F4321 | In Production | $3.18 | 8 | 512 | 256 / HEF | 40 | 40 | No | 8 MHz, 32 kHz | 2 | 0 | 13 | 10 | No | 0 | 0 | No | No | 0 | 0 | 1 | 3 | 0 | 0 | 0 | 10 | No | No | 1 | 1 | 1 | 0 | No | No | 0 | 0 | 0 | 0 | 0 | 0 | -40 | 85 | 2 | 5.5 | No | 40/PDIP,44/QFN,44/TQFP
PIC18F46K80 | In Production | $3.18 | 64 | 3648 | 1024 | 44 | 64 | No | 16 MHz, 32 kHz | 2 | 0 | 11 | 12 | No | 0 | 0 | No | No | 0 | 0 | 2 | 3 | 0 | 0 | 0 | 10 | No | No | 2 | 1 | 1 | 0 | No | No | 0 | 0 | 0 | 0 | 11 | 0 | -40 | 125 | 1.8 | 5.5 | No | 40/PDIP,44/QFN,44/TQFP
PIC16F946 | In Production | $3.19 | 14 | 336 | 256 | 64 | 20 | No | 8 MHz, 32 kHz | 2 | 0 | 8 | 10 | No | 0 | 0 | No | No | 0 | 0 | 2 | 1 | 0 | 0 | 0 | 10 | No | No | 1 | 1 | 1 | 0 | No | No | 0 | 0 | 0 | 0 | 8 | 168 | -40 | 125 | 2 | 5.5 | No | 64/TQFP
PIC18F83J90 | In Production | $3.21 | 8 | 1024 | 0 / HEF | 80 | 40 | No | 8 MHz, 32 kHz | 2 | 0 | 12 | 10 | No | 0 | 0 | No | No | 0 | 0 | 1 | 3 | 0 | 0 | 2 | 10 | No | No | 2 | 1 | 1 | 0 | No | No | 0 | 0 | 0 | 0 | 0 | 192 | -40 | 85 | 2 | 3.6 | No | 80/TQFP
PIC18F26J50 | In Production | $3.22 | 64 | 3800 | 0 / HEF | 28 | 48 | Yes | 8 MHz, 32 kHz | 2 | 0 | 10 | 10 | No | 0 | 0 | No | No | 0 | 0 | 2 | 3 | 0 | 0 | 0 | 10 | No | No | 2 | 2 | 2 | 1 | No | No | 0 | 0 | 0 | 0 | 10 | 0 | -40 | 85 | 2 | 3.6 | No | 28/QFN,28/SOIC,28/SPDIP,28/SSOP
PIC18F85J11 | In Production | $3.22 | 32 | 2048 | 0 / HEF | 80 | 40 | No | 8 MHz, 32 kHz | 2 | 0 | 12 | 10 | No | 0 | 0 | No | No | 0 | 0 | 1 | 3 | 0 | 0 | 2 | 10 | No | No | 2 | 1 | 1 | 0 | No | No | 0 | 0 | 0 | 0 | 0 | 0 | -40 | 85 | 2 | 3.6 | No | 80/TQFP
PIC18F45J50 | In Production | $3.27 | 32 | 3800 | 0 / HEF | 44 | 48 | Yes | 8 MHz, 32 kHz | 2 | 0 | 13 | 10 | No | 0 | 0 | No | No | 0 | 0 | 2 | 3 | 0 | 0 | 0 | 10 | No | No | 2 | 2 | 2 | 1 | No | No | 0 | 0 | 0 | 0 | 13 | 0 | -40 | 85 | 2 | 3.6 | No | 44/QFN,44/TQFP
PIC18F65J50 | In Production | $3.29 | 32 | 3904 | 0 / HEF | 64 | 48 | No | 8 MHz, 32 kHz | 2 | 0 | 8 | 10 | No | 0 | 0 | No | No | 0 | 0 | 2 | 3 | 0 | 0 | 0 | 10 | No | No | 2 | 2 | 2 | 1 | No | No | 0 | 0 | 0 | 0 | 0 | 0 | -40 | 85 | 2 | 3.6 | No | 64/TQFP
PIC18F84J90 | In Production | $3.29 | 16 | 1024 | 0 / HEF | 80 | 40 | No | 8 MHz, 32 kHz | 2 | 0 | 12 | 10 | No | 0 | 0 | No | No | 0 | 0 | 1 | 3 | 0 | 0 | 2 | 10 | No | No | 2 | 1 | 1 | 0 | No | No | 0 | 0 | 0 | 0 | 0 | 192 | -40 | 85 | 2 | 3.6 | No | 80/TQFP
PIC18F65K90 | In Production | $3.30 | 32 | 2048 | 1024 | 64 | 64 | No | 16 MHz, 32 kHz | 3 | 0 | 16 | 12 | No | 0 | 0 | Yes | No | 0 | 0 | 4 | 4 | 0 | 0 | 0 | 0 | No | No | 2 | 2 | 2 | 0 | No | No | 0 | 0 | 0 | 0 | 16 | 132 | -40 | 125 | 1.8 | 5.5 | No | 64/QFN,64/TQFP
PIC18F4450 | In Production | $3.32 | 16 | 768 | 0 / HEF | 40 | 48 | No | 32 kHz | 0 | 0 | 13 | 10 | No | 0 | 0 | No | No | 0 | 0 | 1 | 2 | 0 | 0 | 0 | 10 | No | No | 1 | 0 | 0 | 1 | No | No | 0 | 0 | 0 | 0 | 0 | 0 | -40 | 85 | 2 | 5.5 | No | 40/PDIP,44/TQFP
PIC18F66J15 | In Production | $3.32 | 96 | 3936 | 0 / HEF | 64 | 40 | No | 32 kHz | 2 | 0 | 11 | 10 | No | 0 | 0 | No | No | 0 | 0 | 2 | 3 | 0 | 0 | 14 | 10 | No | No | 2 | 2 | 2 | 0 | No | No | 0 | 0 | 0 | 0 | 0 | 0 | -40 | 85 | 2 | 3.6 | No | 64/TQFP
PIC18F85J15 | In Production | $3.32 | 48 | 2048 | 0 / HEF | 80 | 40 | No | 32 kHz | 2 | 0 | 15 | 10 | No | 0 | 0 | No | No | 0 | 0 | 2 | 3 | 0 | 0 | 14 | 10 | No | No | 2 | 2 | 2 | 0 | No | No | 0 | 0 | 0 | 0 | 0 | 0 | -40 | 85 | 2 | 3.6 | No | 80/TQFP
PIC16F870 | Not Recommended for new designs,Please consider device: 16F883 | $3.33 | 3.5 | 128 | 64 | 28 | 20 | No | No | 0 | 0 | 5 | 10 | No | 0 | 0 | No | No | 0 | 0 | 2 | 1 | 0 | 0 | 0 | 10 | No | No | 1 | 1 | 1 | 0 | No | No | 0 | 0 | 0 | 0 | 0 | 0 | -40 | 125 | 2 | 5.5 | No | 28/SOIC,28/SPDIP,28/SSOP
PIC16F872 | Not Recommended for new designs,Please consider device: PIC16F882 | $3.33 | 3.5 | 128 | 64 | 28 | 20 | No | No | 0 | 0 | 5 | 10 | No | 0 | 0 | No | No | 0 | 0 | 2 | 1 | 0 | 0 | 0 | 10 | No | No | 1 | 0 | 0 | 0 | No | No | 0 | 0 | 0 | 0 | 0 | 0 | -40 | 125 | 2 | 5.5 | No | 28/SOIC,28/SPDIP,28/SSOP
PIC18F2410 | In Production | $3.33 | 16 | 768 | 0 | 28 | 40 | No | 8 MHz, 32 kHz | 2 | 0 | 10 | 10 | No | 0 | 0 | No | No | 0 | 0 | 1 | 3 | 0 | 0 | 0 | 10 | No | No | 1 | 1 | 1 | 0 | No | No | 0 | 0 | 0 | 0 | 0 | 0 | -40 | 125 | 2 | 5.5 | No | 28/QFN,28/SOIC,28/SPDIP
PIC18F46J11 | In Production | $3.35 | 64 | 3800 | 0 / HEF | 44 | 48 | Yes | 8 MHz, 32 kHz | 2 | 0 | 13 | 10 | No | 0 | 0 | No | No | 0 | 0 | 2 | 3 | 0 | 0 | 0 | 10 | No | No | 2 | 2 | 2 | 0 | No | No | 0 | 0 | 0 | 0 | 13 | 0 | -40 | 85 | 2 | 3.6 | No | 44/QFN,44/TQFP
PIC18F26J53 | In Production | $3.42 | 64 | 3800 | 0 / HEF | 28 | 48 | No | 8 MHz, 32 kHz | 3 | 0 | 13 | 12 | No | 0 | 0 | No | No | 0 | 0 | 4 | 4 | 0 | 0 | 0 | 10 | No | No | 2 | 2 | 2 | 1 | No | No | 0 | 0 | 0 | 0 | 10 | 0 | -40 | 85 | 2 | 3.6 | No | 28/QFN,28/SOIC,28/SPDIP,28/SSOP
PIC18F85J94 | In Production | $3.43 | 32 | 3862 | 0 / HEF | 80 | 64 | No | 8 MHz, 32 kHz | 3 | 0 | 24 | 12 | No | 0 | 0 | Yes | No | 0 | 0 | 4 | 4 | 0 | 0 | 19 | 10 | No | No | 4 | 2 | 2 | 1 | No | No | 0 | 0 | 0 | 0 | 0 | 368 | -40 | 85 | 2 | 3.6 | No | 80/TQFP
PIC18F85J90 | In Production | $3.45 | 32 | 2048 | 0 / HEF | 80 | 40 | No | 8 MHz, 32 kHz | 2 | 0 | 12 | 10 | No | 0 | 0 | No | No | 0 | 0 | 1 | 3 | 0 | 0 | 2 | 10 | No | No | 2 | 1 | 1 | 0 | No | No | 0 | 0 | 0 | 0 | 0 | 192 | -40 | 85 | 2 | 3.6 | No | 80/TQFP
PIC18F85K22 | In Production | $3.45 | 32 | 2048 | 1024 | 80 | 64 | No | 16 MHz, 32 kHz | 3 | 0 | 24 | 12 | No | 0 | 0 | Yes | No | 0 | 0 | 4 | 4 | 0 | 0 | 17 | 10 | No | No | 2 | 2 | 2 | 0 | No | No | 0 | 0 | 0 | 0 | 24 | 0 | -40 | 125 | 1.8 | 5.5 | No | 80/TQFP
PIC18F27J13 | In Production | $3.47 | 128 | 3800 | 0 / HEF | 28 | 48 | Yes | 8 MHz, 32 kHz | 3 | 0 | 10 | 12 | No | 0 | 0 | No | No | 0 | 0 | 4 | 4 | 0 | 0 | 0 | 10 | No | No | 2 | 2 | 2 | 0 | No | No | 0 | 0 | 0 | 0 | 10 | 0 | -40 | 85 | 2 | 3.6 | No | 28/QFN,28/SOIC,28/SPDIP,28/SSOP
PIC18F6310 | In Production | $3.48 | 8 | 768 | 0 | 64 | 40 | No | 8 MHz, 32 kHz | 2 | 0 | 12 | 10 | No | 0 | 0 | No | No | 0 | 0 | 1 | 3 | 0 | 0 | 0 | 10 | No | No | 2 | 1 | 1 | 0 | No | No | 0 | 0 | 0 | 0 | 0 | 0 | -40 | 125 | 2 | 5.5 | No | 64/TQFP
PIC18F67J10 | In Production | $3.48 | 128 | 3936 | 0 / HEF | 64 | 40 | No | 32 kHz | 2 | 0 | 11 | 10 | No | 0 | 0 | No | No | 0 | 0 | 2 | 3 | 0 | 0 | 14 | 10 | No | No | 2 | 2 | 2 | 0 | No | No | 0 | 0 | 0 | 0 | 0 | 0 | -40 | 85 | 2 | 3.6 | No | 64/TQFP
PIC18F66J94 | In Production | $3.49 | 64 | 3862 | 0 / HEF | 64 | 64 | No | 8 MHz, 32 kHz | 3 | 0 | 16 | 12 | No | 0 | 0 | Yes | No | 0 | 0 | 4 | 4 | 0 | 0 | 19 | 10 | No | No | 4 | 2 | 2 | 1 | No | No | 0 | 0 | 0 | 0 | 16 | 256 | -40 | 85 | 2 | 3.6 | No | 64/QFN,64/TQFP
PIC18F86J10 | In Production | $3.49 | 64 | 2048 | 0 / HEF | 80 | 40 | No | 32 kHz | 2 | 0 | 15 | 10 | No | 0 | 0 | No | No | 0 | 0 | 2 | 3 | 0 | 0 | 14 | 10 | No | No | 2 | 2 | 2 | 0 | No | No | 0 | 0 | 0 | 0 | 0 | 0 | -40 | 85 | 2 | 3.6 | No | 80/TQFP
PIC18F65K80 | In Production | $3.51 | 32 | 3648 | 1024 | 64 | 64 | No | 16 MHz, 32 kHz | 2 | 0 | 11 | 12 | No | 0 | 0 | No | No | 0 | 0 | 2 | 3 | 0 | 0 | 0 | 10 | No | No | 2 | 1 | 1 | 0 | No | No | 0 | 0 | 0 | 0 | 11 | 0 | -40 | 125 | 1.8 | 5.5 | No | 64/QFN,64/TQFP
PIC18F66J90 | In Production | $3.51 | 64 | 3900 | 0 / HEF | 64 | 48 | No | 8 MHz, 32 kHz | 2 | 0 | 12 | 10 | No | 0 | 0 | No | No | 0 | 0 | 1 | 3 | 0 | 0 | 2 | 10 | No | No | 2 | 1 | 1 | 0 | No | No | 0 | 0 | 0 | 0 | 12 | 132 | -40 | 85 | 2 | 3.6 | No | 64/TQFP
PIC18F66K22 | In Production | $3.51 | 64 | 3862 | 1024 | 64 | 64 | No | 16 MHz, 32 kHz | 3 | 0 | 16 | 12 | No | 0 | 0 | Yes | No | 0 | 0 | 6 | 5 | 0 | 0 | 19 | 10 | No | No | 2 | 2 | 2 | 0 | No | No | 0 | 0 | 0 | 0 | 16 | 0 | -40 | 125 | 1.8 | 5.5 | No | 64/QFN,64/TQFP
PIC16C620 | Not Recommended for new designs,Please consider device: PIC16C620A | $3.55 | 0.875 | 80 | 0 | 18 | 20 | No | 4 MHz | 2 | 0 | 0 | 0 | No | 0 | 0 | No | No | 0 | 0 | 1 | 0 | 0 | 0 | 0 | 0 | No | No | 0 | 0 | 0 | 0 | No | No | 0 | 0 | 0 | 0 | 0 | 0 | -40 | 85 | 2.5 | 5.5 | No | 18/PDIP,18/SOIC
PIC18F46J13 | In Production | $3.58 | 64 | 3800 | 0 / HEF | 44 | 48 | Yes | 8 MHz, 32 kHz | 3 | 0 | 13 | 12 | No | 0 | 0 | No | No | 0 | 0 | 4 | 4 | 0 | 0 | 0 | 10 | No | No | 2 | 2 | 2 | 0 | No | No | 0 | 0 | 0 | 0 | 13 | 0 | -40 | 85 | 2 | 3.6 | No | 44/QFN,44/TQFP
PIC16C745 | Not Recommended for new designs,Please consider device: PIC18F4450 | $3.60 | 14 | 256 | 0 | 28 | 24 | No | 4 MHz | 0 | 0 | 5 | 8 | No | 0 | 0 | No | No | 0 | 0 | 2 | 1 | 0 | 0 | 0 | 0 | No | No | 1 | 0 | 0 | 0 | No | No | 0 | 0 | 0 | 0 | 0 | 0 | -40 | 85 | 2.5 | 5.5 | No | 28/SOIC,28/SPDIP
PIC18F85K90 | In Production | $3.64 | 32 | 2048 | 1024 | 80 | 64 | No | 16 MHz, 32 kHz | 3 | 0 | 24 | 12 | No | 0 | 0 | Yes | No | 0 | 0 | 4 | 4 | 0 | 0 | 17 | 10 | No | No | 2 | 2 | 2 | 0 | No | No | 0 | 0 | 0 | 0 | 24 | 192 | -40 | 125 | 1.8 | 5.5 | No | 80/TQFP
PIC18F46J50 | In Production | $3.65 | 64 | 3800 | 0 / HEF | 44 | 48 | Yes | 8 MHz, 32 kHz | 2 | 0 | 13 | 10 | No | 0 | 0 | No | No | 0 | 0 | 2 | 3 | 0 | 0 | 0 | 10 | No | No | 2 | 2 | 2 | 1 | No | No | 0 | 0 | 0 | 0 | 13 | 0 | -40 | 85 | 2 | 3.6 | No | 44/QFN,44/TQFP
PIC18F66J50 | In Production | $3.66 | 64 | 3904 | 0 / HEF | 64 | 48 | No | 8 MHz, 32 kHz | 2 | 0 | 8 | 10 | No | 0 | 0 | No | No | 0 | 0 | 2 | 3 | 0 | 0 | 14 | 10 | No | No | 2 | 2 | 2 | 1 | No | No | 0 | 0 | 0 | 0 | 0 | 0 | -40 | 85 | 2 | 3.6 | No | 64/TQFP
PIC18F85J50 | In Production | $3.66 | 32 | 3904 | 0 / HEF | 80 | 48 | No | 8 MHz, 32 kHz | 2 | 0 | 12 | 10 | No | 0 | 0 | No | No | 0 | 0 | 2 | 3 | 0 | 0 | 14 | 10 | No | No | 2 | 2 | 2 | 1 | No | No | 0 | 0 | 0 | 0 | 0 | 0 | -40 | 85 | 2 | 3.6 | No | 80/TQFP
PIC18F86J11 | In Production | $3.66 | 64 | 3904 | 0 / HEF | 80 | 48 | No | 8 MHz, 32 kHz | 2 | 0 | 12 | 10 | No | 0 | 0 | No | No | 0 | 0 | 2 | 3 | 0 | 0 | 14 | 10 | No | No | 2 | 2 | 2 | 0 | No | No | 0 | 0 | 0 | 0 | 0 | 0 | -40 | 85 | 2 | 3.6 | No | 80/TQFP
PIC18F6390 | In Production | $3.68 | 8 | 768 | 0 | 64 | 40 | No | 8 MHz, 32 kHz | 2 | 0 | 12 | 10 | No | 0 | 0 | No | No | 0 | 0 | 1 | 3 | 0 | 0 | 0 | 10 | No | No | 2 | 1 | 1 | 0 | No | No | 0 | 0 | 0 | 0 | 0 | 128 | -40 | 125 | 2 | 5.5 | No | 64/TQFP
PIC18F86J15 | In Production | $3.68 | 96 | 3936 | 0 / HEF | 80 | 40 | No | 32 kHz | 2 | 0 | 15 | 10 | No | 0 | 0 | No | No | 0 | 0 | 2 | 3 | 0 | 0 | 14 | 10 | No | No | 2 | 2 | 2 | 0 | No | No | 0 | 0 | 0 | 0 | 0 | 0 | -40 | 85 | 2 | 3.6 | No | 80/TQFP
PIC18F95J94 | In Production | $3.68 | 32 | 3862 | 0 / HEF | 100 | 64 | No | 8 MHz, 32 kHz | 3 | 0 | 24 | 12 | No | 0 | 0 | No | No | 0 | 0 | 4 | 4 | 0 | 0 | 19 | 10 | No | No | 4 | 2 | 2 | 1 | No | No | 0 | 0 | 0 | 0 | 24 | 480 | -40 | 85 | 2 | 3.6 | No | 100/TQFP
PIC18F66K90 | In Production | $3.69 | 64 | 3828 | 1024 | 64 | 64 | No | 16 MHz, 32 kHz | 3 | 0 | 16 | 12 | No | 0 | 0 | Yes | No | 0 | 0 | 6 | 5 | 0 | 0 | 19 | 10 | No | No | 2 | 2 | 2 | 0 | No | No | 0 | 0 | 0 | 0 | 16 | 132 | -40 | 125 | 1.8 | 5.5 | No | 64/QFN,64/TQFP
PIC18F66J93 | In Production | $3.71 | 64 | 3900 | 0 / HEF | 64 | 48 | No | 8 MHz, 32 kHz | 2 | 0 | 12 | 12 | No | 0 | 0 | No | No | 0 | 0 | 1 | 3 | 0 | 0 | 2 | 10 | No | No | 2 | 1 | 1 | 0 | No | No | 0 | 0 | 0 | 0 | 12 | 132 | -40 | 85 | 2 | 3.6 | No | 64/TQFP
PIC16C72A | Not Recommended for new designs,Please consider device: PIC16F72 | $3.74 | 3.5 | 128 | 0 | 28 | 20 | No | 4 MHz | 0 | 0 | 5 | 8 | No | 0 | 0 | No | No | 0 | 0 | 2 | 1 | 0 | 0 | 0 | 0 | No | No | 0 | 1 | 1 | 0 | No | No | 0 | 0 | 0 | 0 | 0 | 0 | -40 | 85 | 2.5 | 5.5 | No | 28/SOIC,28/SPDIP,28/SSOP
PIC16C781 | Not Recommended for new designs | $3.77 | 1.75 | 128 | 0 | 20 | 20 | No | 4 MHz | 2 | 1 | 8 | 8 | No | 0 | 0 | No | No | 0 | 0 | 2 | 1 | 0 | 0 | 0 | 0 | No | No | 0 | 0 | 0 | 0 | No | No | 0 | 0 | 0 | 0 | 0 | 0 | -40 | 85 | 2.5 | 5.5 | No | 20/PDIP,20/SOIC,20/SSOP
PIC18F27J53 | In Production | $3.77 | 128 | 3800 | 0 / HEF | 28 | 48 | Yes | 8 MHz, 32 kHz | 3 | 0 | 10 | 12 | No | 0 | 0 | No | No | 0 | 0 | 4 | 4 | 0 | 0 | 0 | 10 | No | No | 2 | 2 | 2 | 1 | No | No | 0 | 0 | 0 | 0 | 10 | 0 | -40 | 85 | 2 | 3.6 | No | 28/QFN,28/SOIC,28/SPDIP,28/SSOP
PIC18F2420 | In Production | $3.78 | 16 | 768 | 256 / HEF | 28 | 40 | No | 8 MHz, 32 kHz | 2 | 0 | 10 | 10 | No | 0 | 0 | No | No | 0 | 0 | 1 | 3 | 0 | 0 | 0 | 10 | No | No | 1 | 1 | 1 | 0 | No | No | 0 | 0 | 0 | 0 | 0 | 0 | -40 | 125 | 2 | 5.5 | No | 28/QFN,28/SOIC,28/SPDIP
PIC18F4410 | In Production | $3.78 | 16 | 768 | 0 | 40 | 40 | No | 8 MHz, 32 kHz | 2 | 0 | 13 | 10 | No | 0 | 0 | No | No | 0 | 0 | 1 | 3 | 0 | 0 | 0 | 10 | No | No | 1 | 1 | 1 | 0 | No | No | 0 | 0 | 0 | 0 | 0 | 0 | -40 | 125 | 2 | 5.5 | No | 40/PDIP,44/QFN,44/TQFP
PIC16C782 | Not Recommended for new designs | $3.79 | 3.5 | 128 | 0 | 20 | 20 | No | 4 MHz | 2 | 1 | 8 | 8 | No | 0 | 0 | No | No | 0 | 0 | 2 | 1 | 0 | 0 | 0 | 0 | No | No | 0 | 0 | 0 | 0 | No | No | 0 | 0 | 0 | 0 | 0 | 0 | -40 | 85 | 2.5 | 5.5 | No | 20/PDIP,20/SOIC
PIC18F67J94 | In Production | $3.81 | 128 | 3862 | 0 / HEF | 64 | 64 | No | 8 MHz, 32 kHz | 3 | 0 | 16 | 12 | No | 0 | 0 | Yes | No | 0 | 0 | 4 | 4 | 0 | 0 | 19 | 10 | No | No | 4 | 2 | 2 | 1 | No | No | 0 | 0 | 0 | 0 | 0 | 256 | -40 | 85 | 2 | 3.6 | No | 64/QFN,64/TQFP
PIC18F67K22 | In Production | $3.82 | 128 | 3862 | 1024 | 64 | 64 | No | 16 MHz, 32 kHz | 3 | 0 | 16 | 12 | No | 0 | 0 | Yes | No | 0 | 0 | 6 | 5 | 0 | 0 | 19 | 10 | No | No | 2 | 2 | 2 | 0 | No | No | 0 | 0 | 0 | 0 | 16 | 0 | -40 | 125 | 1.8 | 5.5 | No | 64/QFN,64/TQFP
PIC18F86J16 | In Production | $3.83 | 96 | 3904 | 0 / HEF | 80 | 48 | No | 8 MHz, 32 kHz | 2 | 0 | 12 | 10 | No | 0 | 0 | No | No | 0 | 0 | 2 | 3 | 0 | 0 | 14 | 10 | No | No | 2 | 2 | 2 | 0 | No | No | 0 | 0 | 0 | 0 | 0 | 0 | -40 | 85 | 2 | 3.6 | No | 80/TQFP
PIC18F86J94 | In Production | $3.83 | 64 | 3862 | 0 / HEF | 80 | 64 | No | 8 MHz, 32 kHz | 3 | 0 | 24 | 12 | No | 0 | 0 | Yes | No | 0 | 0 | 4 | 4 | 0 | 0 | 19 | 10 | No | No | 4 | 2 | 2 | 1 | No | No | 0 | 0 | 0 | 0 | 24 | 368 | -40 | 85 | 2 | 3.6 | No | 80/TQFP
PIC16C63A | Not Recommended for new designs,Please consider device: PIC16F723A | $3.85 | 7 | 192 | 0 | 28 | 20 | No | 4 MHz | 0 | 0 | 0 | 0 | No | 0 | 0 | No | No | 0 | 0 | 2 | 1 | 0 | 0 | 0 | 0 | No | No | 1 | 1 | 1 | 0 | No | No | 0 | 0 | 0 | 0 | 0 | 0 | -40 | 85 | 2.5 | 6 | No | 28/SOIC,28/SPDIP,28/SSOP
PIC16F73 | In Production | $3.85 | 7 | 192 | 0 | 28 | 20 | No | None | 0 | 0 | 5 | 8 | No | 0 | 0 | No | No | 0 | 0 | 2 | 1 | 0 | 0 | 0 | 10 | No | No | 1 | 1 | 1 | 0 | No | No | 0 | 0 | 0 | 0 | 0 | 0 | -40 | 125 | 2 | 5.5 | No | 28/QFN,28/SOIC,28/SPDIP,28/SSOP
PIC18F66J55 | In Production | $3.85 | 96 | 3904 | 0 / HEF | 64 | 48 | No | 8 MHz, 32 kHz | 2 | 0 | 8 | 10 | No | 0 | 0 | No | No | 0 | 0 | 2 | 3 | 0 | 0 | 14 | 10 | No | No | 2 | 2 | 2 | 1 | No | No | 0 | 0 | 0 | 0 | 0 | 0 | -40 | 85 | 2 | 3.6 | No | 64/TQFP
PIC18F67J90 | In Production | $3.85 | 128 | 3900 | 0 / HEF | 64 | 48 | No | 8 MHz, 32 kHz | 2 | 0 | 12 | 10 | No | 0 | 0 | No | No | 0 | 0 | 1 | 3 | 0 | 0 | 2 | 10 | No | No | 2 | 1 | 1 | 0 | No | No | 0 | 0 | 0 | 0 | 12 | 132 | -40 | 85 | 2 | 3.6 | No | 64/TQFP
PIC18F86K22 | In Production | $3.85 | 64 | 3862 | 1024 | 80 | 64 | No | 16 MHz, 32 kHz | 3 | 0 | 24 | 12 | No | 0 | 0 | Yes | No | 0 | 0 | 6 | 5 | 0 | 0 | 19 | 10 | No | No | 2 | 2 | 2 | 0 | No | No | 0 | 0 | 0 | 0 | 24 | 0 | -40 | 125 | 1.8 | 5.5 | No | 80/TQFP
PIC18F87J10 | In Production | $3.85 | 128 | 3936 | 0 / HEF | 80 | 40 | No | 32 kHz | 2 | 0 | 15 | 10 | No | 0 | 0 | No | No | 0 | 0 | 2 | 3 | 0 | 0 | 14 | 10 | No | No | 2 | 2 | 2 | 0 | No | No | 0 | 0 | 0 | 0 | 0 | 0 | -40 | 85 | 2 | 3.6 | No | 80/TQFP
PIC18F46J53 | In Production | $3.86 | 64 | 3800 | 0 / HEF | 44 | 48 | Yes | 8 MHz, 32 kHz | 3 | 0 | 13 | 12 | No | 0 | 0 | No | No | 0 | 0 | 4 | 4 | 0 | 0 | 0 | 10 | No | No | 2 | 2 | 2 | 1 | No | No | 0 | 0 | 0 | 0 | 13 | 0 | -40 | 85 | 2 | 3.6 | No | 44/QFN,44/TQFP
PIC18F86J90 | In Production | $3.86 | 64 | 3900 | 0 / HEF | 80 | 48 | No | 8 MHz, 32 kHz | 2 | 0 | 12 | 10 | No | 0 | 0 | No | No | 0 | 0 | 1 | 3 | 0 | 0 | 2 | 10 | No | No | 2 | 1 | 1 | 0 | No | No | 0 | 0 | 0 | 0 | 12 | 192 | -40 | 85 | 2 | 3.6 | No | 80/TQFP
PIC16C55 | Not Recommended for new designs,Please consider device: PIC16C55A | $3.87 | 0.75 | 24 | 0 | 28 | 20 | No | 4 MHz | 0 | 0 | 0 | 0 | No | 0 | 0 | No | No | 0 | 0 | 1 | 0 | 0 | 0 | 0 | 0 | No | No | 0 | 0 | 0 | 0 | No | No | 0 | 0 | 0 | 0 | 0 | 0 | -40 | 85 | 2.5 | 6.3 | No | 28/PDIP,28/SOIC,28/SPDIP
PIC18F66K80 | In Production | $3.87 | 64 | 3648 | 1024 | 64 | 64 | No | 16 MHz, 32 kHz | 2 | 0 | 11 | 12 | No | 0 | 0 | No | No | 0 | 0 | 2 | 3 | 0 | 0 | 8 | 10 | No | No | 2 | 1 | 1 | 0 | No | No | 0 | 0 | 0 | 0 | 11 | 0 | -40 | 125 | 1.8 | 5.5 | No | 64/QFN,64/TQFP
PIC18F47J13 | In Production | $3.91 | 128 | 3800 | 0 / HEF | 44 | 48 | Yes | 8 MHz, 32 kHz | 3 | 0 | 13 | 12 | No | 0 | 0 | No | No | 0 | 0 | 4 | 4 | 0 | 0 | 0 | 10 | No | No | 2 | 2 | 2 | 0 | No | No | 0 | 0 | 0 | 0 | 13 | 0 | -40 | 85 | 2 | 3.6 | No | 44/QFN,44/TQFP
PIC16F871 | Not Recommended for new designs,Please consider device: PIC16F884 | $3.92 | 3.5 | 128 | 64 | 40 | 20 | No | No | 0 | 0 | 8 | 10 | No | 0 | 0 | No | No | 0 | 0 | 2 | 1 | 0 | 0 | 0 | 10 | No | No | 1 | 0 | 0 | 0 | No | No | 0 | 0 | 0 | 0 | 0 | 0 | -40 | 125 | 2 | 5.5 | No | 40/PDIP,44/PLCC,44/TQFP
PIC16C56 | Not Recommended for new designs,Please consider device: PIC16F54 | $3.96 | 1.5 | 25 | 0 | 18 | 20 | No | 4 MHz | 0 | 0 | 0 | 0 | No | 0 | 0 | No | No | 0 | 0 | 1 | 0 | 0 | 0 | 0 | 0 | No | No | 0 | 0 | 0 | 0 | No | No | 0 | 0 | 0 | 0 | 0 | 0 | -40 | 85 | 2.5 | 6.3 | No | 18/PDIP,18/SOIC
PIC18F6410 | In Production | $3.96 | 16 | 768 | 0 | 64 | 40 | No | 8 MHz, 32 kHz | 2 | 0 | 12 | 10 | No | 0 | 0 | No | No | 0 | 0 | 1 | 3 | 0 | 0 | 0 | 10 | No | No | 2 | 1 | 1 | 0 | No | No | 0 | 0 | 0 | 0 | 0 | 0 | -40 | 125 | 2 | 5.5 | No | 64/TQFP
PIC18F67K90 | In Production | $4.00 | 128 | 3828 | 1024 | 64 | 64 | No | 16 MHz, 32 kHz | 3 | 0 | 16 | 12 | No | 0 | 0 | Yes | No | 0 | 0 | 6 | 5 | 0 | 0 | 19 | 10 | No | No | 2 | 2 | 2 | 0 | No | No | 0 | 0 | 0 | 0 | 16 | 132 | -40 | 125 | 1.8 | 5.5 | No | 64/QFN,64/TQFP
PIC18F67J50 | In Production | $4.01 | 128 | 3904 | 0 / HEF | 64 | 48 | No | 8 MHz, 32 kHz | 2 | 0 | 8 | 10 | No | 0 | 0 | No | No | 0 | 0 | 2 | 3 | 0 | 0 | 14 | 10 | No | No | 2 | 2 | 2 | 1 | No | No | 0 | 0 | 0 | 0 | 0 | 0 | -40 | 85 | 2 | 3.6 | No | 64/TQFP
PIC18F87J11 | In Production | $4.01 | 128 | 3904 | 0 / HEF | 80 | 48 | No | 8 MHz, 32 kHz | 2 | 0 | 12 | 10 | No | 0 | 0 | No | No | 0 | 0 | 2 | 3 | 0 | 0 | 14 | 10 | No | No | 2 | 2 | 2 | 0 | No | No | 0 | 0 | 0 | 0 | 0 | 0 | -40 | 85 | 2 | 3.6 | No | 80/TQFP
PIC18F67J93 | In Production | $4.04 | 128 | 3900 | 0 / HEF | 64 | 48 | No | 8 MHz, 32 kHz | 2 | 0 | 12 | 12 | No | 0 | 0 | No | No | 0 | 0 | 3 | 1 | 0 | 0 | 2 | 10 | No | No | 2 | 1 | 1 | 0 | No | No | 0 | 0 | 0 | 0 | 12 | 132 | -40 | 85 | 2 | 3.6 | No | 64/TQFP
PIC18F86J50 | In Production | $4.04 | 64 | 3904 | 0 / HEF | 80 | 48 | No | 8 MHz, 32 kHz | 2 | 0 | 12 | 10 | No | 0 | 0 | No | No | 0 | 0 | 2 | 3 | 0 | 0 | 14 | 10 | No | No | 2 | 2 | 2 | 1 | No | No | 0 | 0 | 0 | 0 | 0 | 0 | -40 | 85 | 2 | 3.6 | No | 80/TQFP
PIC18F86K90 | In Production | $4.04 | 64 | 3828 | 1024 | 80 | 64 | No | 16 MHz, 32 kHz | 3 | 0 | 24 | 12 | No | 0 | 0 | Yes | No | 0 | 0 | 6 | 5 | 0 | 0 | 19 | 10 | No | No | 2 | 2 | 2 | 0 | No | No | 0 | 0 | 0 | 0 | 24 | 192 | -40 | 125 | 1.8 | 5.5 | No | 80/TQFP
PIC18F4420 | In Production | $4.06 | 16 | 768 | 256 / HEF | 40 | 40 | No | 8 MHz, 32 kHz | 2 | 0 | 13 | 10 | No | 0 | 0 | No | No | 0 | 0 | 1 | 3 | 0 | 0 | 0 | 10 | No | No | 1 | 1 | 1 | 0 | No | No | 0 | 0 | 0 | 0 | 0 | 0 | -40 | 125 | 2 | 5.5 | No | 40/PDIP,44/QFN,44/TQFP
PIC16C558 | Not Recommended for new designs,Please consider device: PIC16F628A | $4.07 | 3.5 | 128 | 0 | 18 | 20 | No | 4 MHz | 0 | 0 | 0 | 0 | No | 0 | 0 | No | No | 0 | 0 | 1 | 0 | 0 | 0 | 0 | 0 | No | No | 0 | 0 | 0 | 0 | No | No | 0 | 0 | 0 | 0 | 0 | 0 | -40 | 85 | 2.5 | 5.5 | No | 18/PDIP,18/SOIC
PIC18F86J93 | In Production | $4.07 | 64 | 3900 | 0 / HEF | 80 | 48 | No | 8 MHz, 32 kHz | 2 | 0 | 12 | 12 | No | 0 | 0 | No | No | 0 | 0 | 1 | 3 | 0 | 0 | 2 | 10 | No | No | 2 | 1 | 1 | 0 | No | No | 0 | 0 | 0 | 0 | 12 | 192 | -40 | 85 | 2 | 3.6 | No | 80/TQFP
PIC18F96J94 | In Production | $4.07 | 64 | 3862 | 0 / HEF | 100 | 64 | No | 8 MHz, 32 kHz | 3 | 0 | 24 | 12 | No | 0 | 0 | Yes | No | 0 | 0 | 4 | 4 | 0 | 0 | 19 | 10 | No | No | 4 | 2 | 2 | 1 | No | No | 0 | 0 | 0 | 0 | 24 | 480 | -40 | 85 | 2 | 3.6 | No | 100/TQFP
PIC16F84A | In Production | $4.11 | 1.75 | 68 | 64 | 18 | 20 | No | No | 0 | 0 | 0 | 0 | No | 0 | 0 | No | No | 0 | 0 | 1 | 0 | 0 | 0 | 0 | 0 | No | No | 0 | 0 | 0 | 0 | No | No | 0 | 0 | 0 | 0 | 0 | 0 | -40 | 85 | 2 | 6 | No | 18/PDIP,18/SOIC,20/SSOP
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
