DavidMFlynn/SerialMRRC/USB PCB/MCP2200_DLL_2014-10-10/Unmanaged/Release Notes.txt

-------------------------------------------------------------------
              Readme for the MCP2200 DLL (Unmanaged)
-------------------------------------------------------------------

                  Microchip Technology, Inc.

-------------------------------------------------------------------
System Requirements
-------------------------------------------------------------------
Operating System: 	
	Windows XP SP3 or later
Other: 	
	Microsoft Visual C++ 2010 Redistributable Package

-------------------------------------------------------------------
Versioning History
-------------------------------------------------------------------
Version 1.4.0 (Released 10/10/2014):
 - Improvements to performance and memory management
 - Added function to set VID/PID of the part

Version 1.3.0 (Released 01/28/2013):
 - Added support for inverting UART polarity through ConfigureMCP2200() function
 - Added dedicated function for inverting UART polarity: fnInvertUartPol()

Version 1.2.1 (Released 08/16/2012):
 - Corrected issue that could cause incorrect number to be returned
   by the GetNoOfDevices() function on some systems
 - Resolved issue that caused baud rate to change when the function 
   ConfigureMCP2200() was used

Version 1.2.0:
 - Dropped requirement of Visual C++ 2010 redistributable to the 
   2008 version of the redistributable thereby expanding the
   compatibility of the DLL.

Version 1.1.0:
 - Resolved bug in DLL memory management

Version 1.0.0:
 - Initial release

-------------------------------------------------------------------
Contact Information
-------------------------------------------------------------------
Main Website: 		http://www.microchip.com
Technical Support: 	http://support.microchip.com
