DavidMFlynn/SerialMRRC/Block Relay PCB/BlockRelay.kicad_pcb.pdf

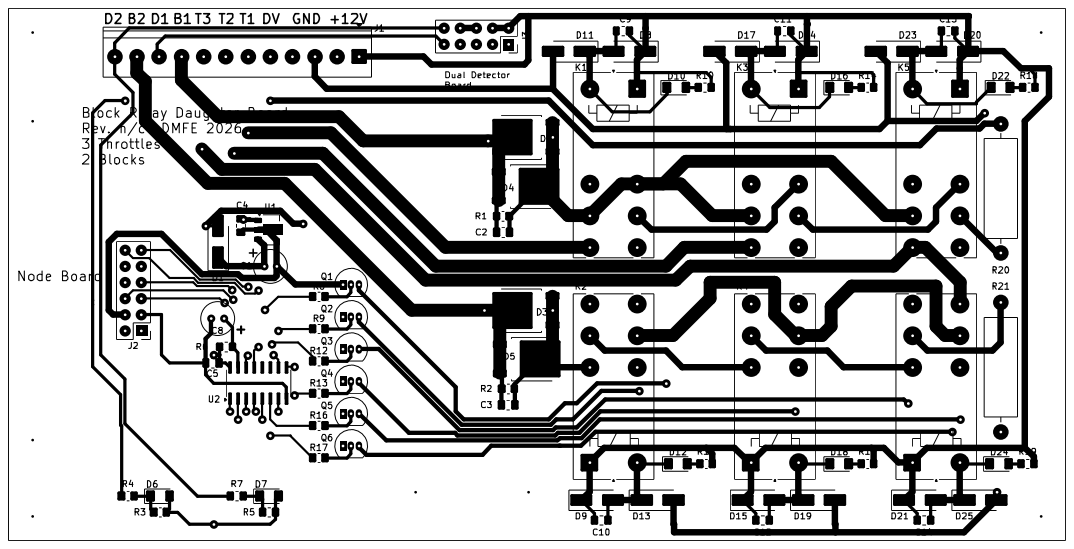
[picture p1: page 1]
