DavidMFlynn/SerialMRRC/Block Relay PCB/BlockRelay.kicad_sch.pdf

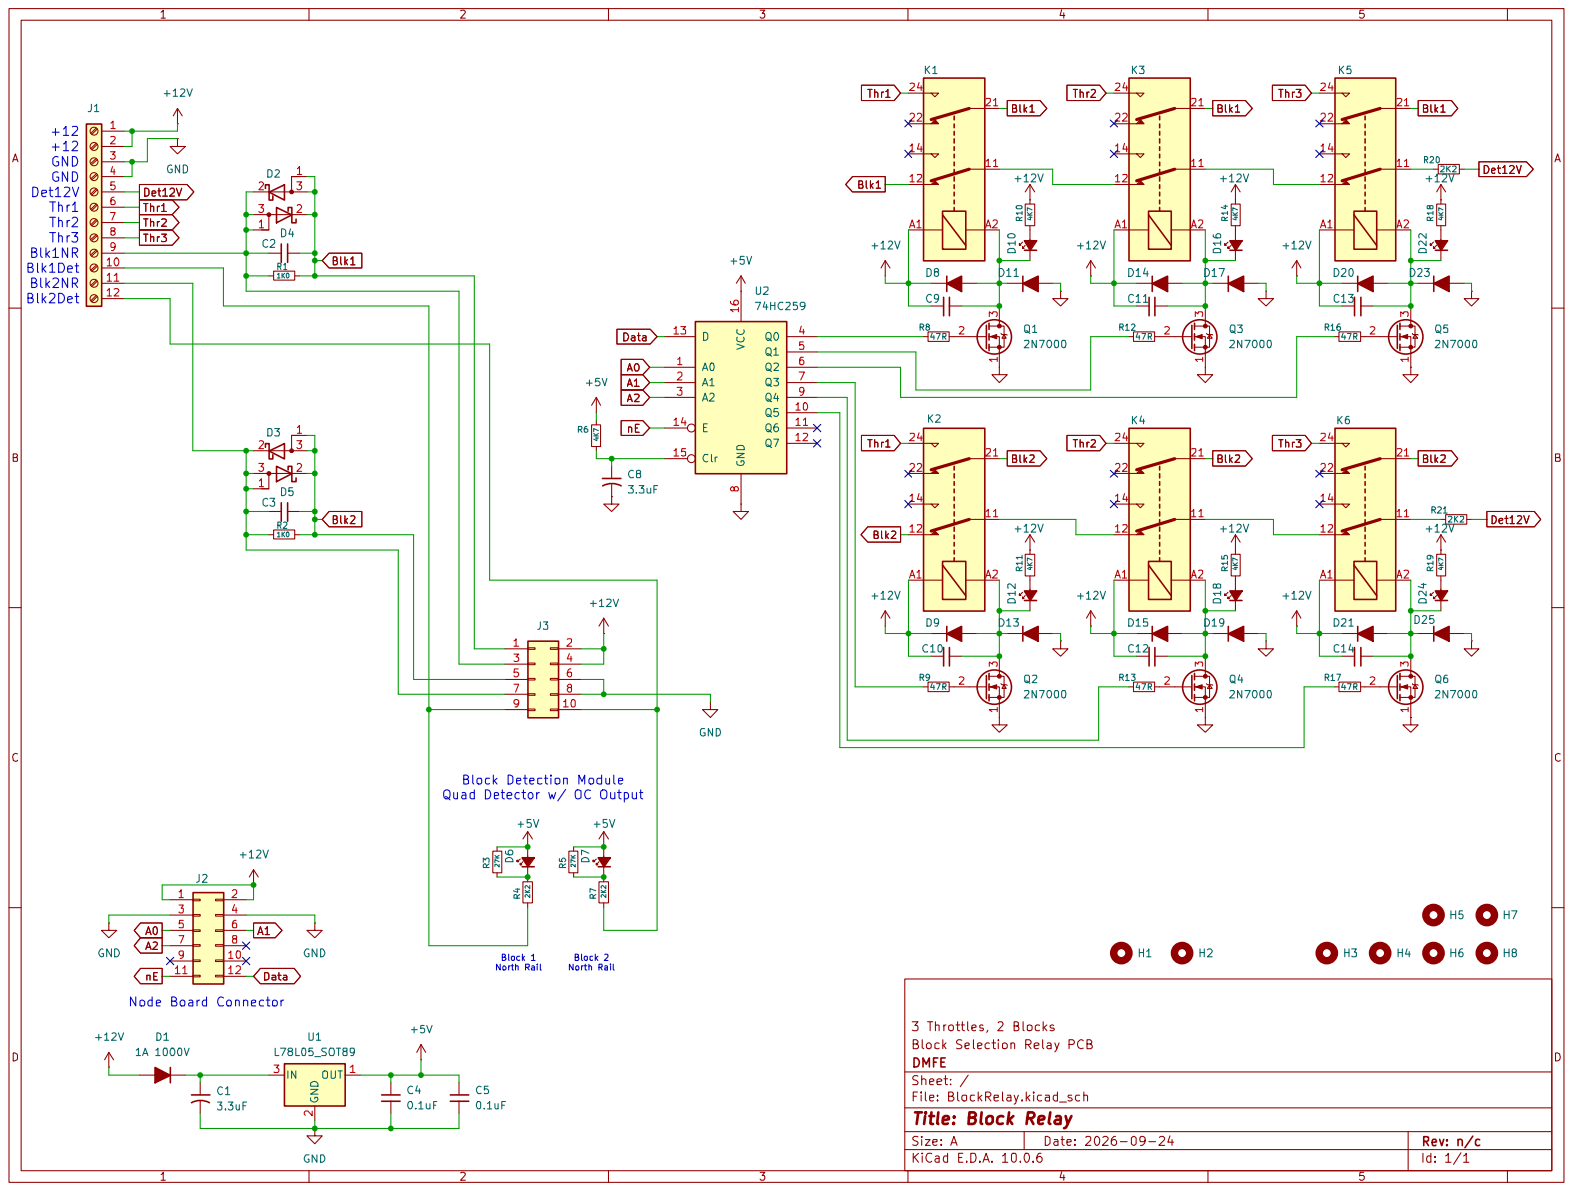
[picture p2: page 1]
