DavidMFlynn/SerialMRRC/Node Board PCB/SMRRCrA.kicad_sch.pdf

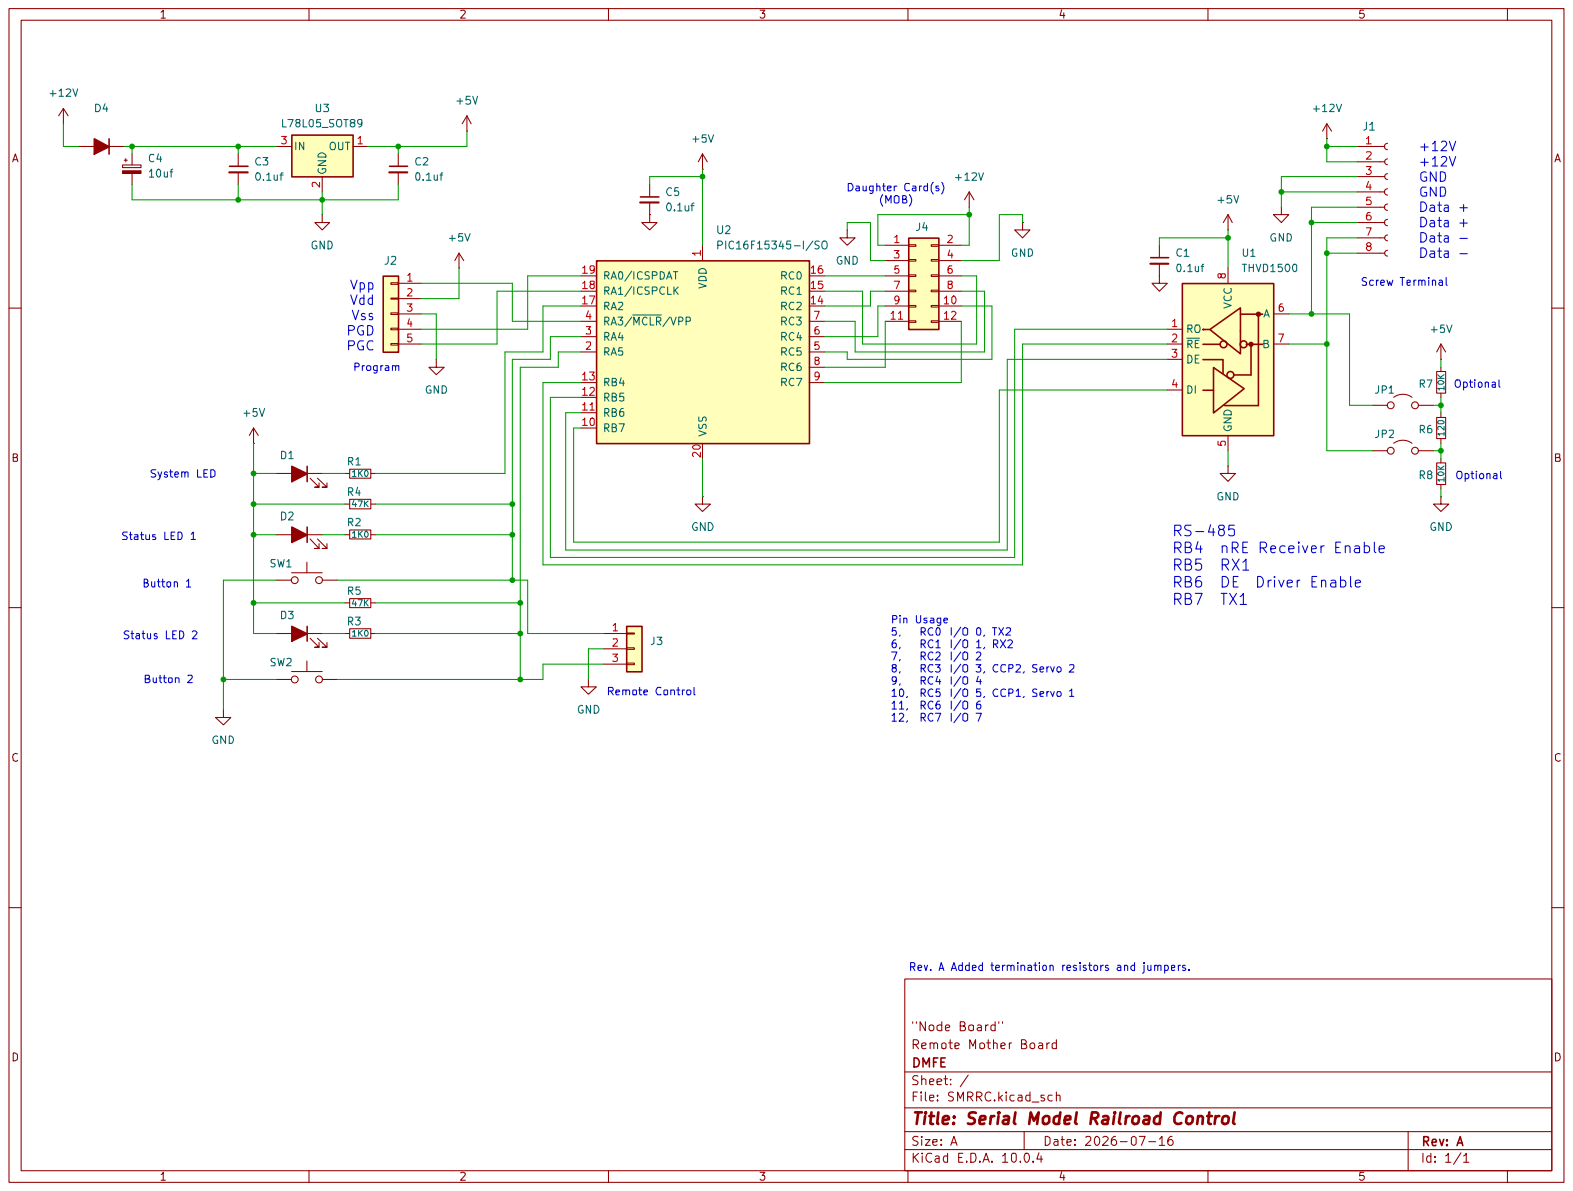
[picture p3: page 1]
