DavidMFlynn/SerialMRRC/Servo 8 Daughter PCB/SMRRC_Servo8.kicad_sch.pdf

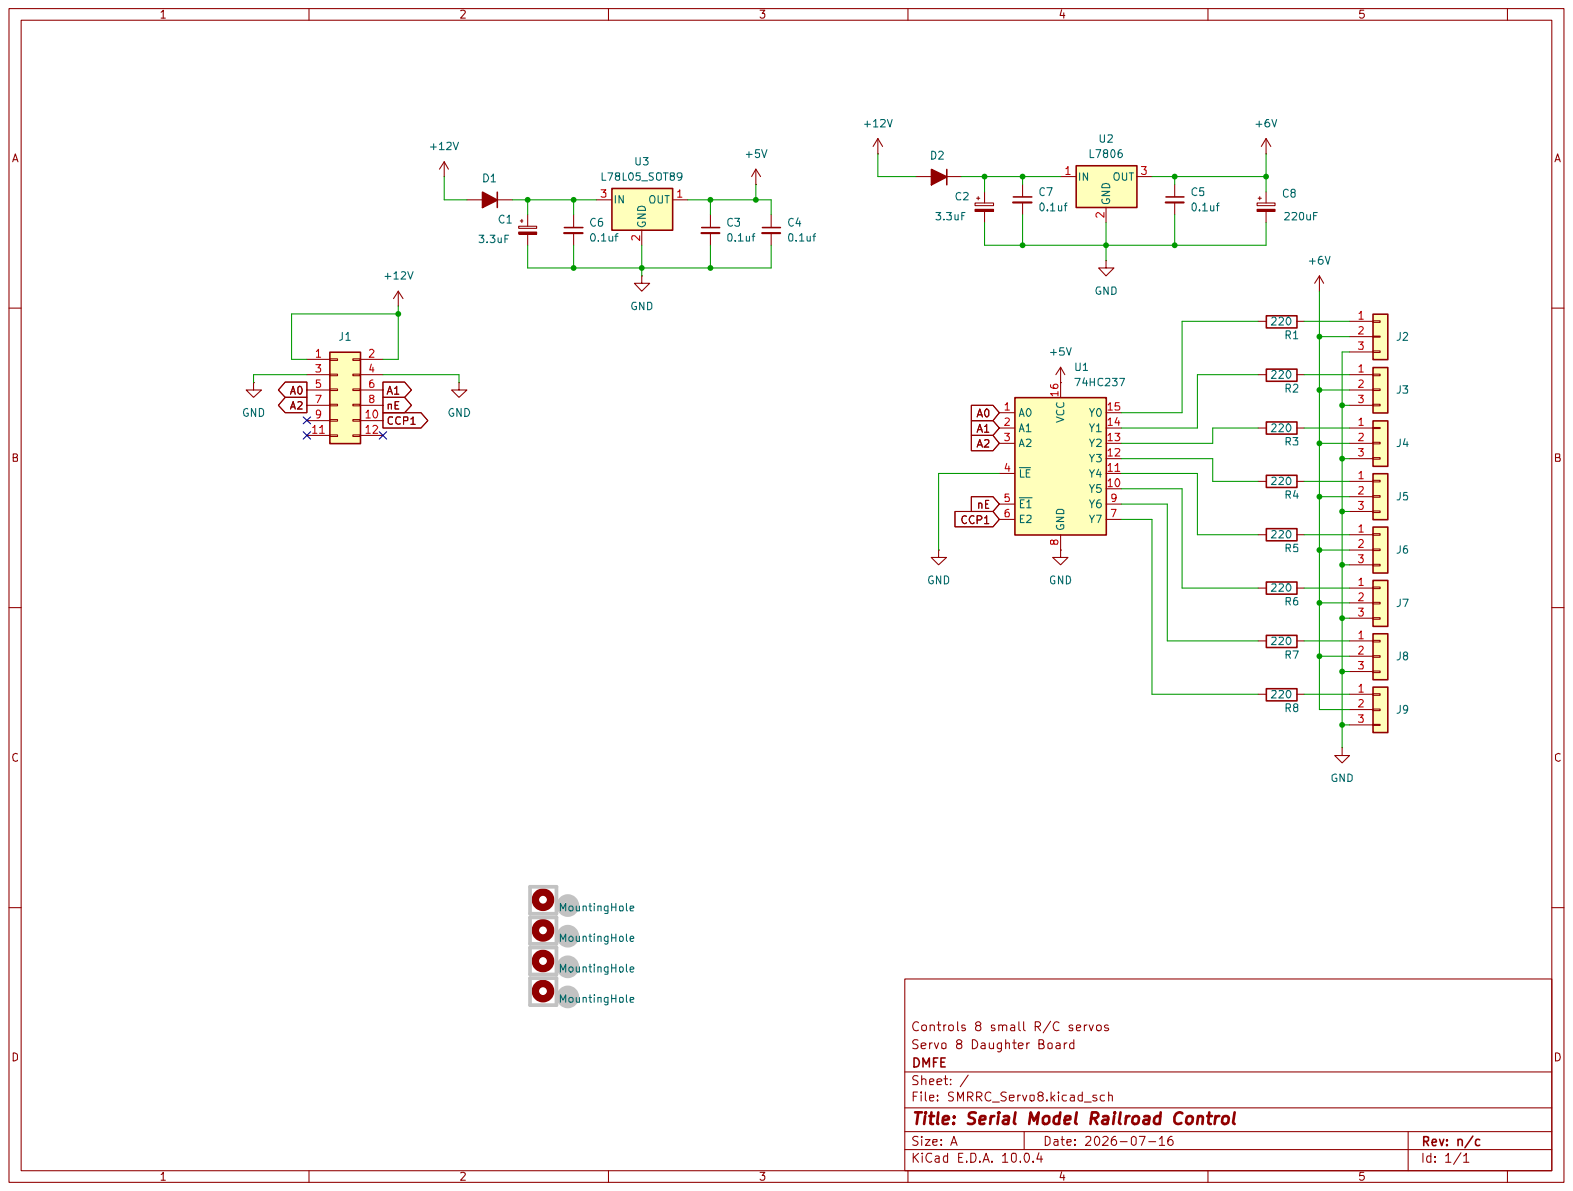
[picture p4: page 1]
