DavidMFlynn/SerialMRRC/Servo 8 Daughter PCB/SMRRC_Servo8Top.kicad_pcb.pdf

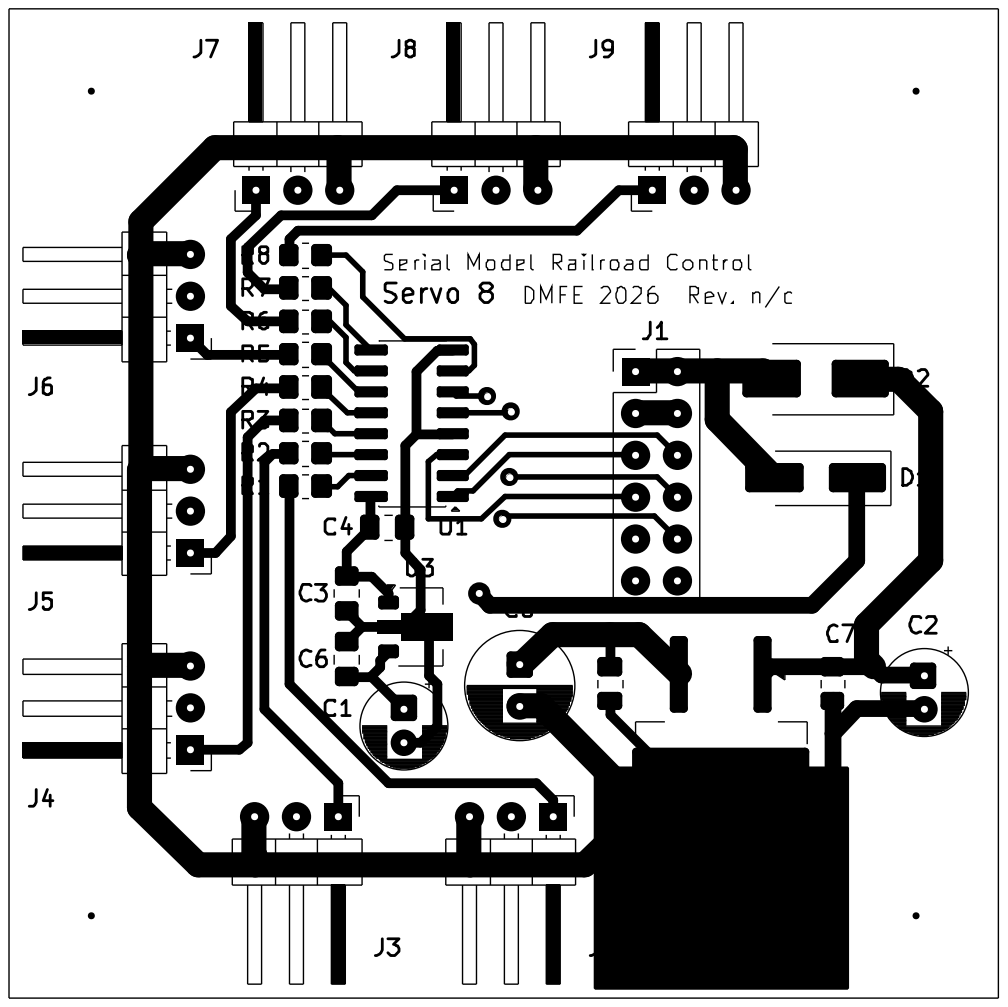
[picture p5: page 1]
