DavidMFlynn/SerialMRRC/Output 32 Daughter PCB/Output32DCBot.kicad_pcb.pdf

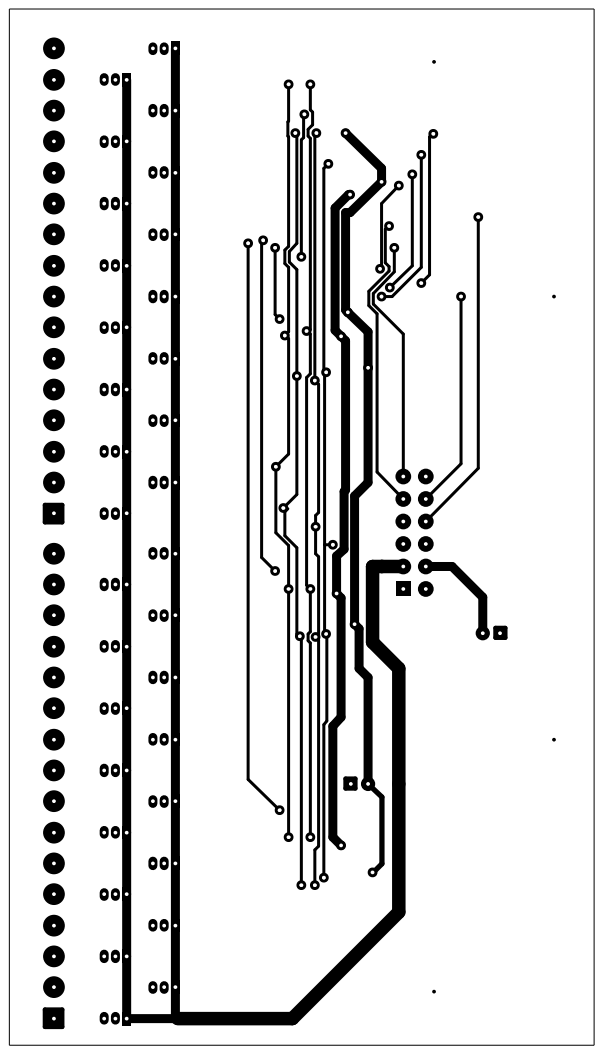
[picture p6: page 1]
