DavidMFlynn/SerialMRRC/Output 32 Daughter PCB/Output32DCTop.kicad_pcb.pdf

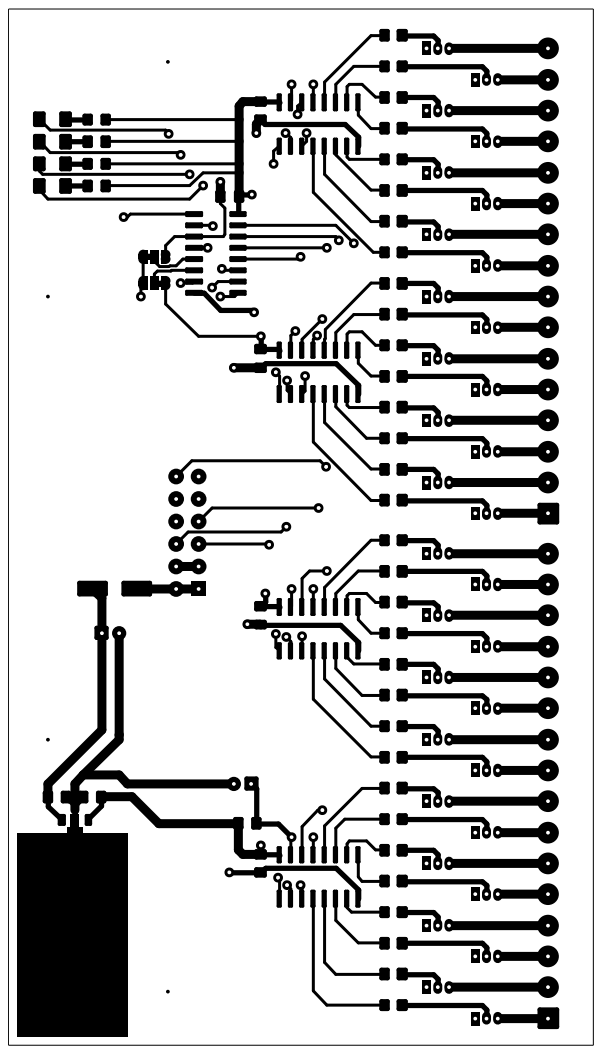
[picture p7: page 1]
