DavidMFlynn/SerialMRRC/Output 32 Daughter PCB/Output32DCTopS.kicad_pcb.pdf

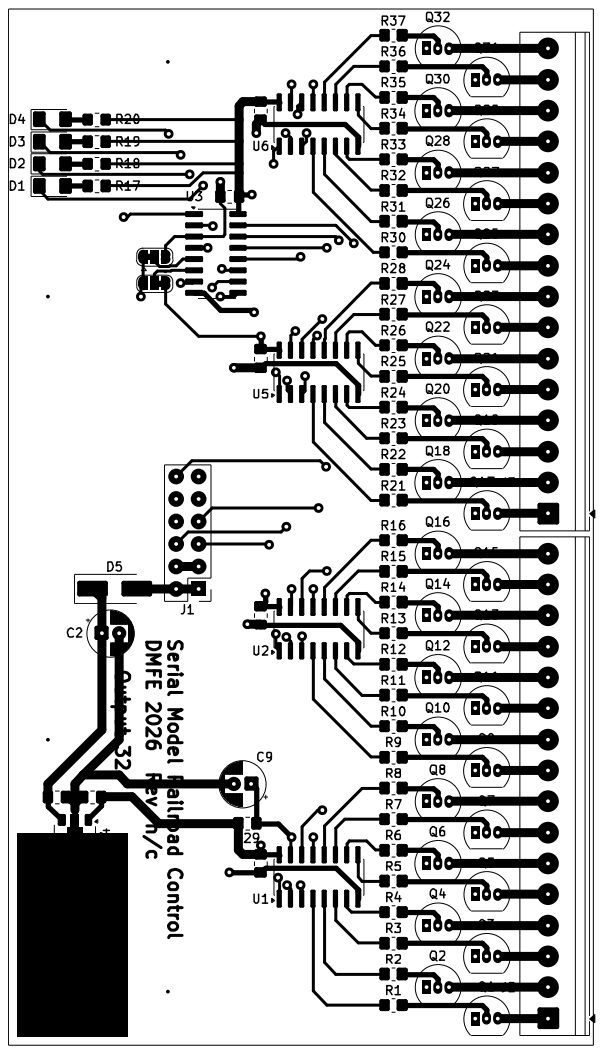
[picture p8: page 1]
