DavidMFlynn/SerialMRRC/Output 32 Daughter PCB/Output32DC.kicad_sch.pdf

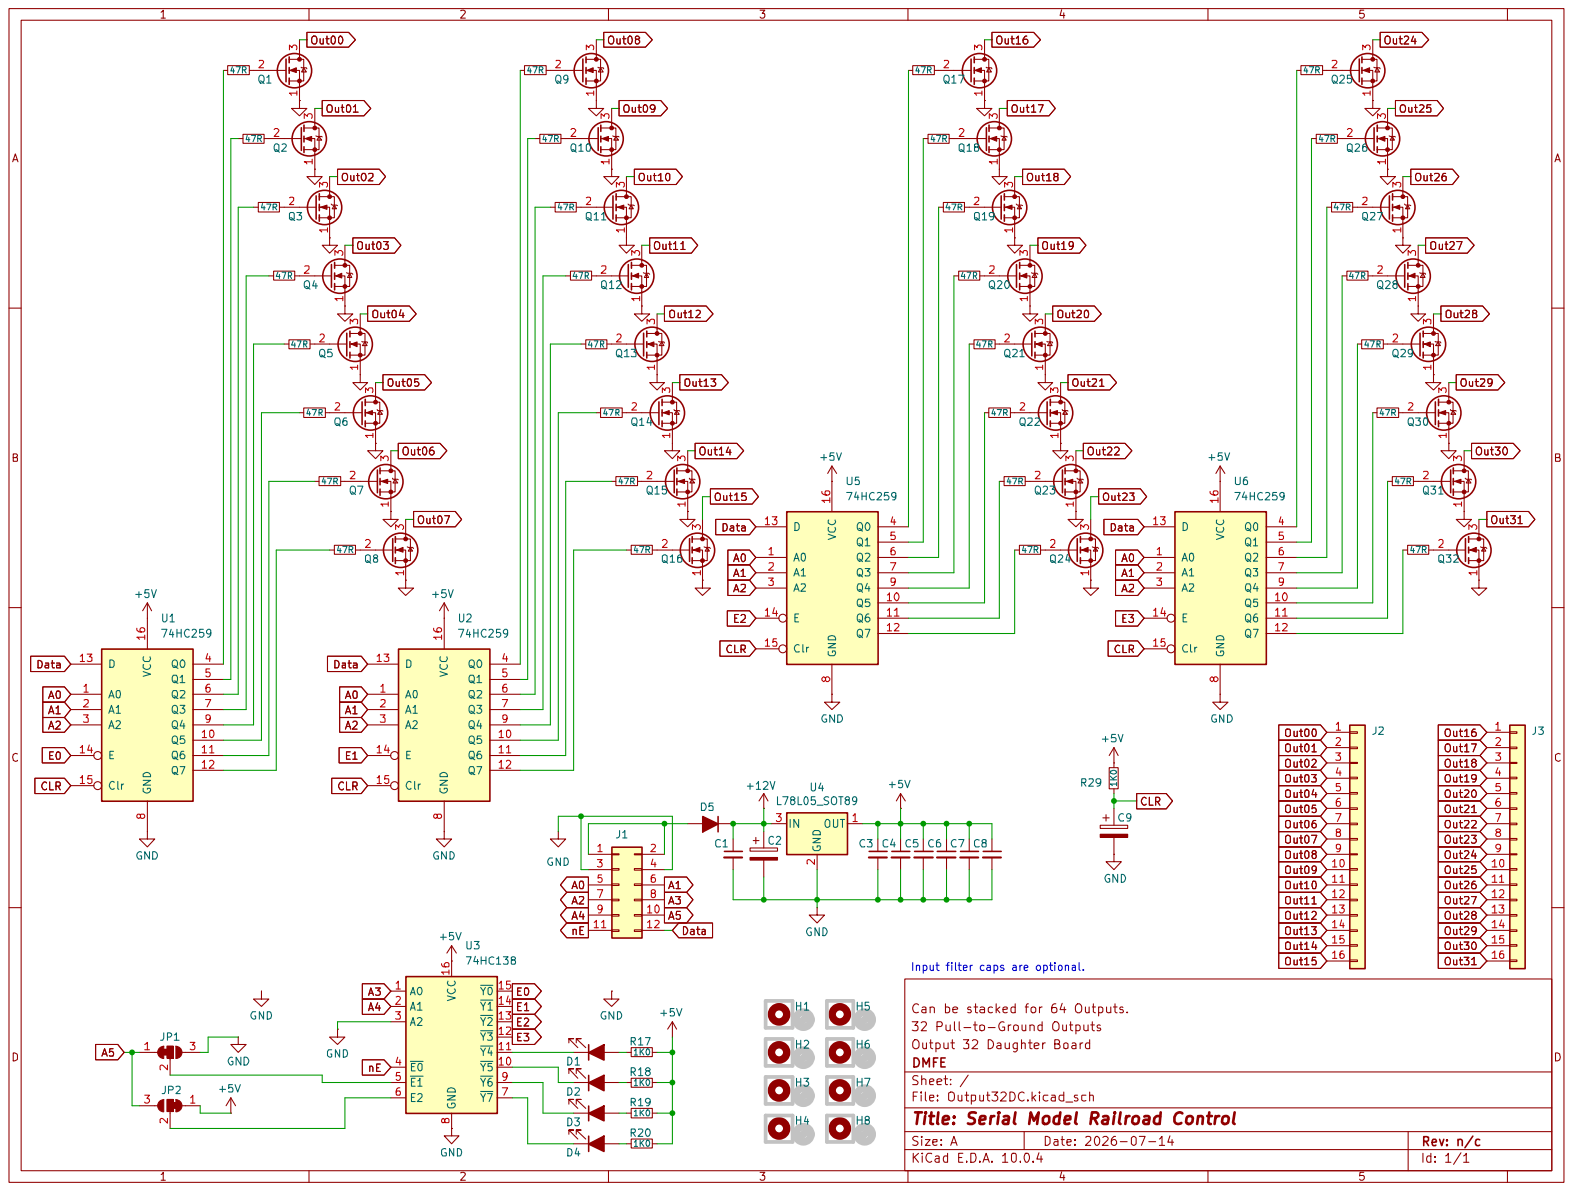
[picture p9: page 1]
