DavidMFlynn/SerialMRRC/Input 32 Daughter PCB/Input32DC.kicad_pcb.pdf

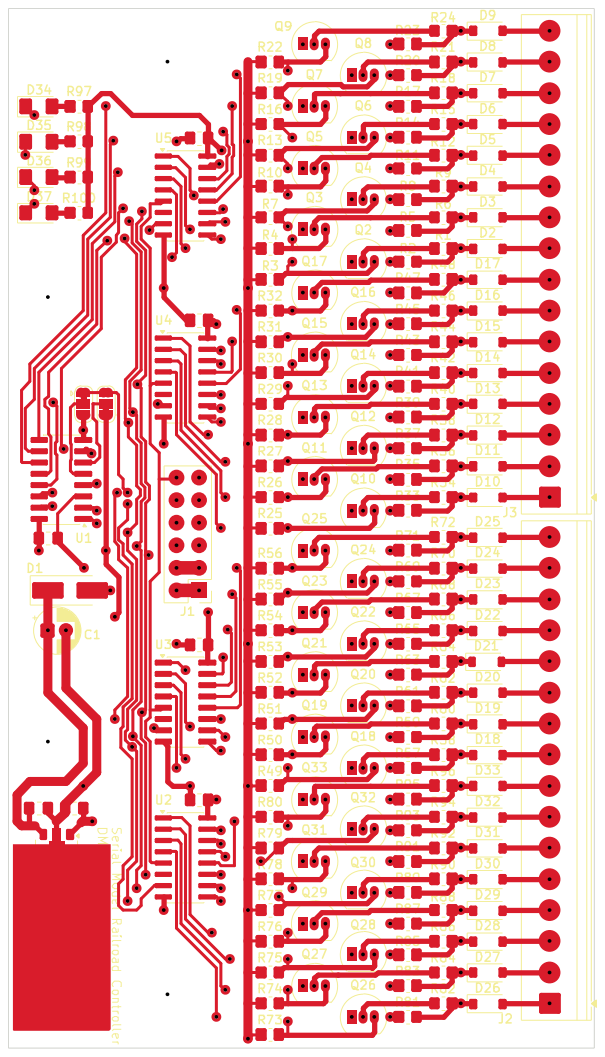
[picture p10: page 1]
