DavidMFlynn/SerialMRRC/Input 32 Daughter PCB/Input32DC.kicad_sch.pdf

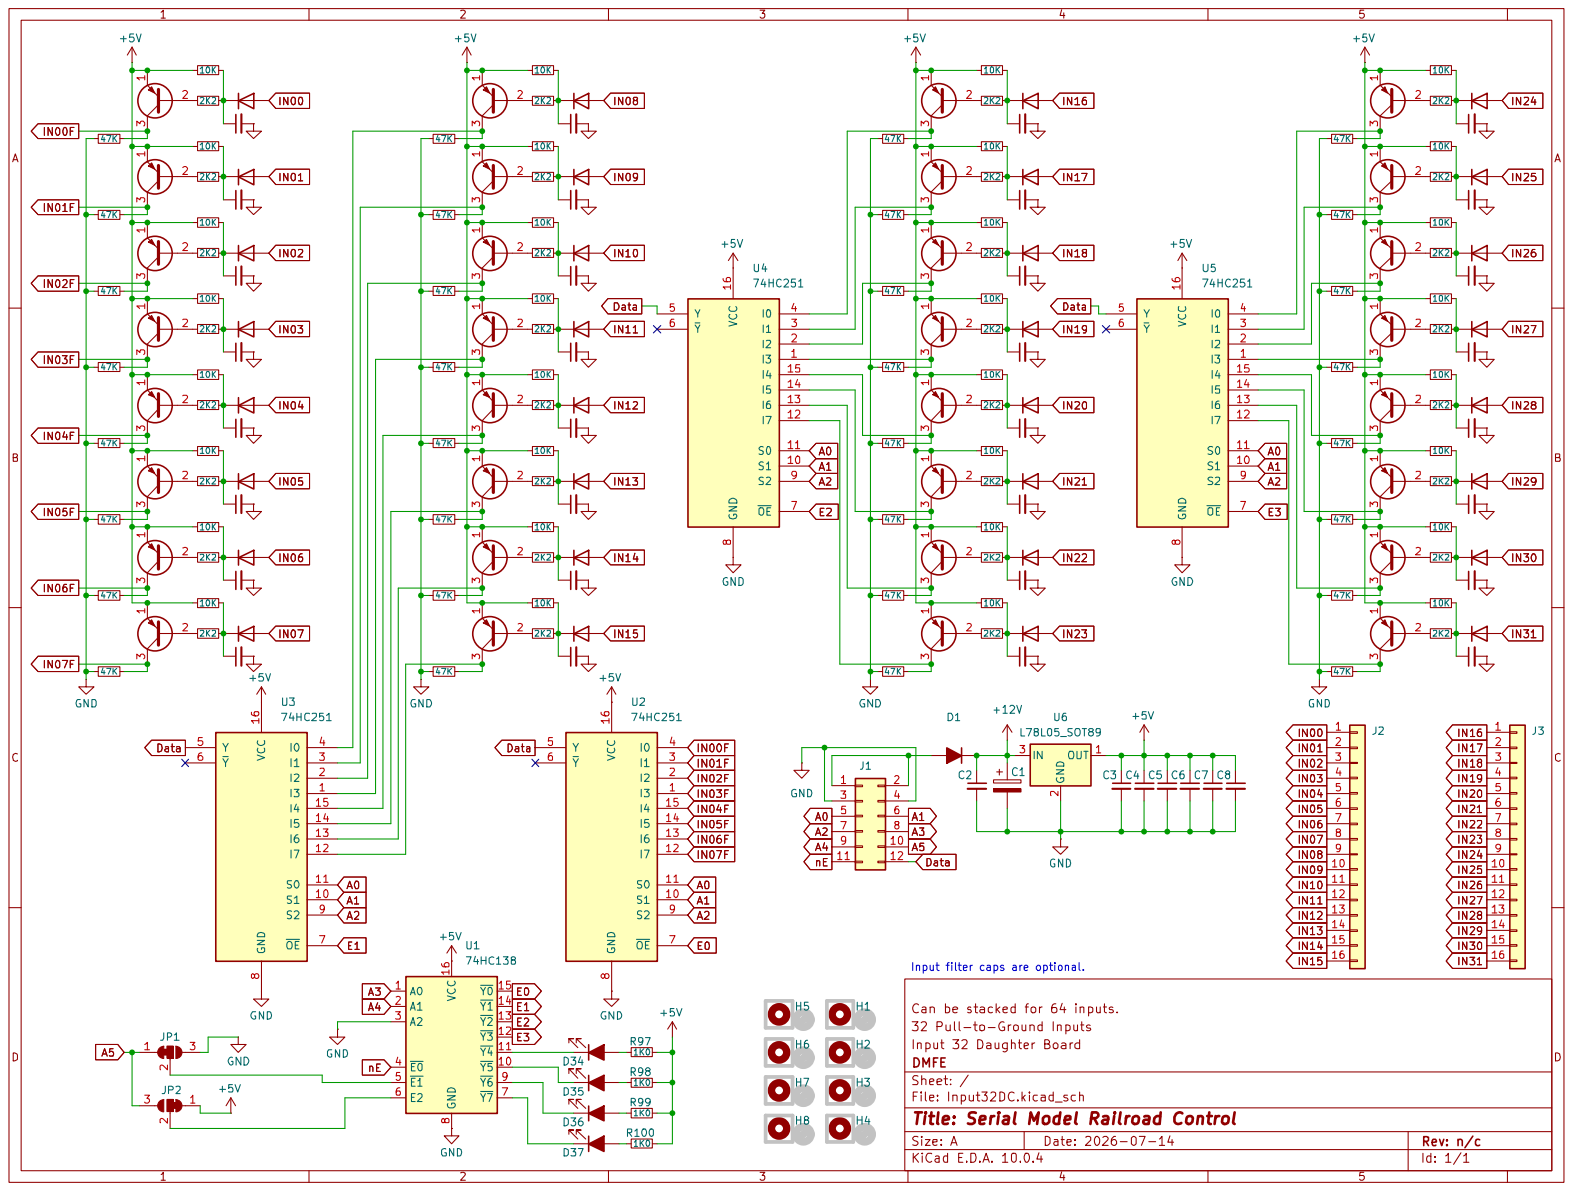
[picture p11: page 1]
