DavidMFlynn/SerialMRRC/Input 32 Daughter PCB/Input32DCBot.kicad_pcb.pdf

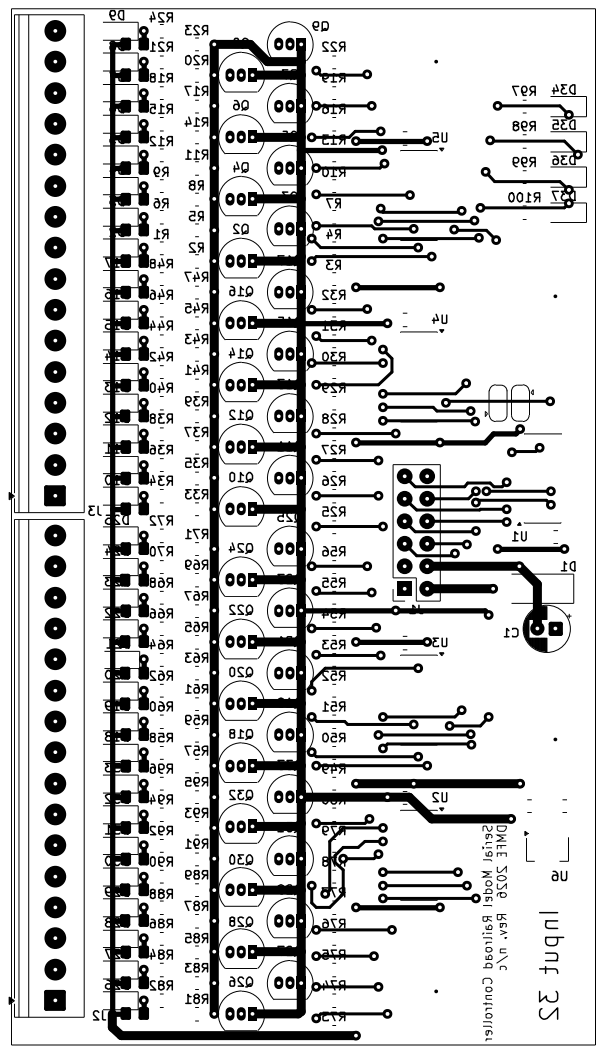
[picture p12: page 1]
