DavidMFlynn/SerialMRRC/Input 32 Daughter PCB/Input32DCTop.kicad_pcb.pdf

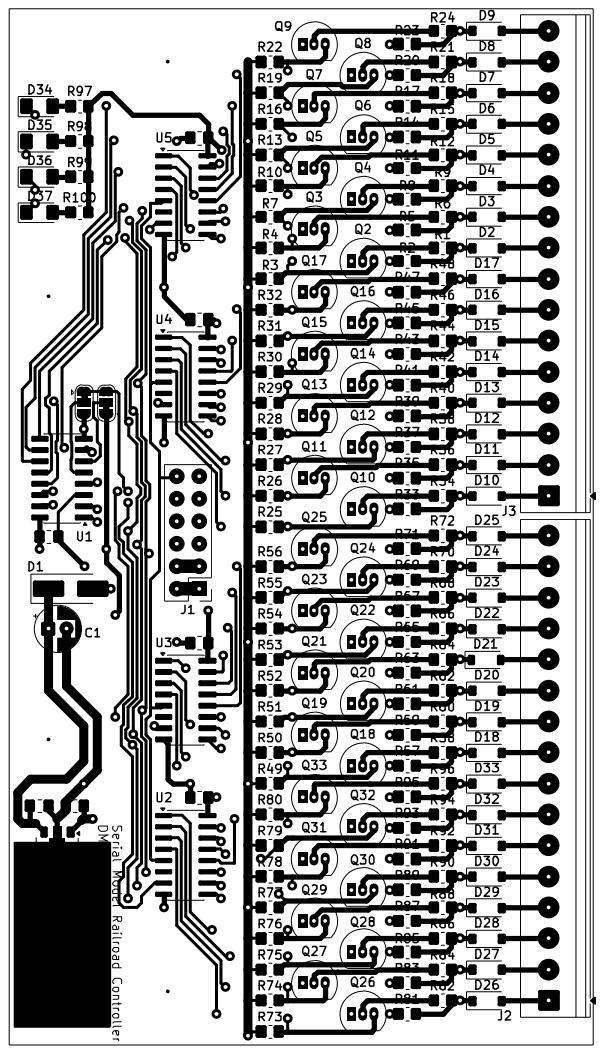
[picture p13: page 1]
