DavidMFlynn/SerialMRRC/Node Board PCB/SMRRC.kicad_sch.pdf

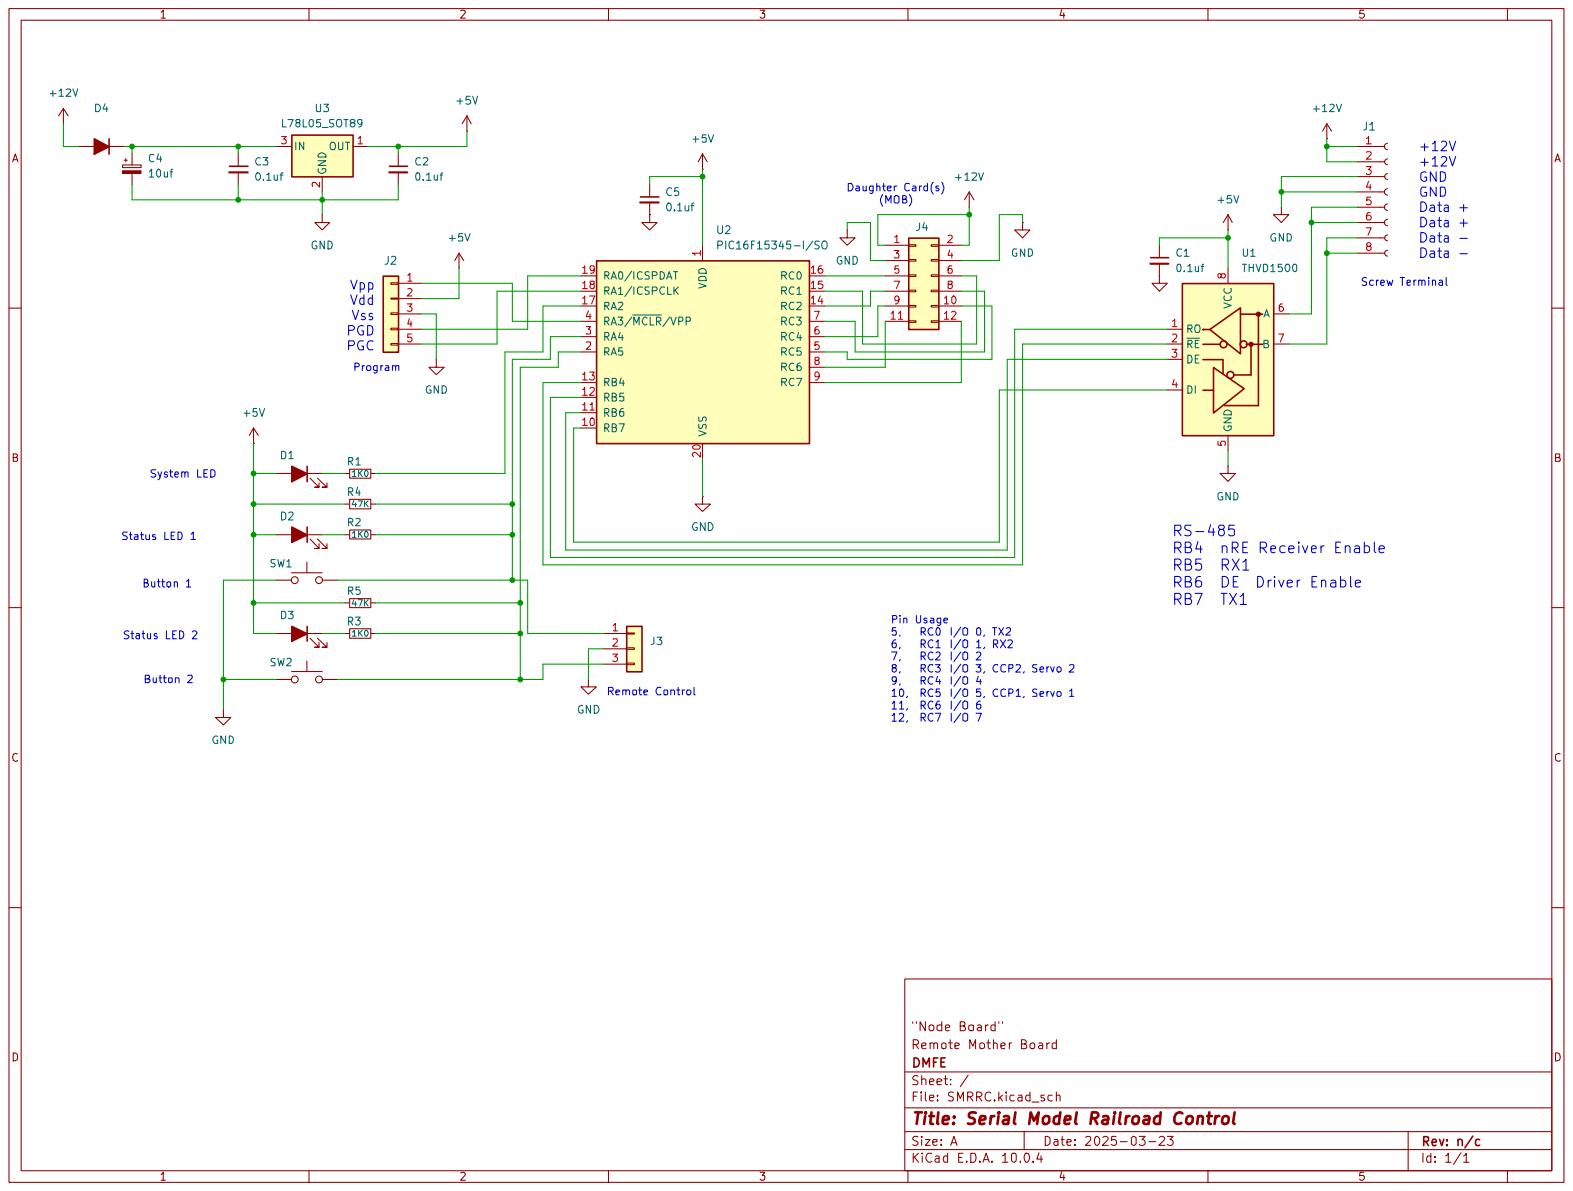
[picture p14: page 1]
