DavidMFlynn/SerialMRRC/Switch Machine PCB/SMRRC_Switch.kicad_sch.pdf

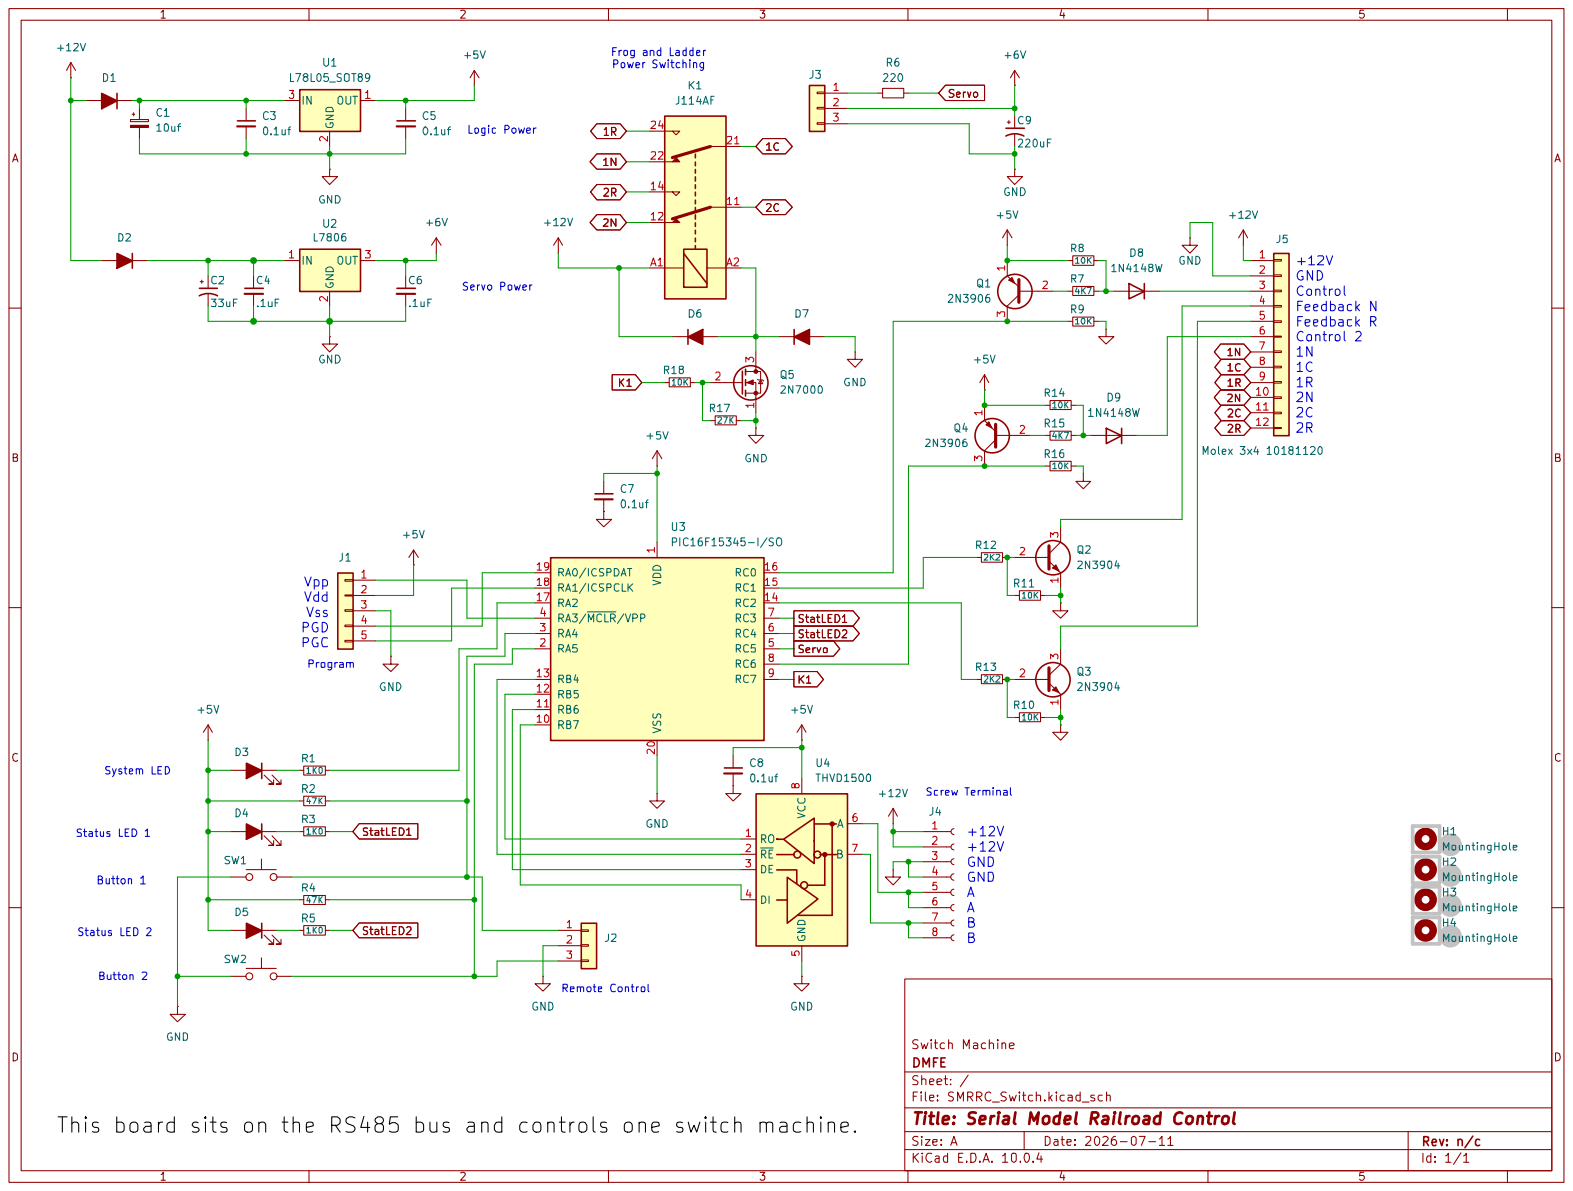
[picture p15: page 1]
