DavidMFlynn/SerialMRRC/Node Board PCB/PCB.pdf

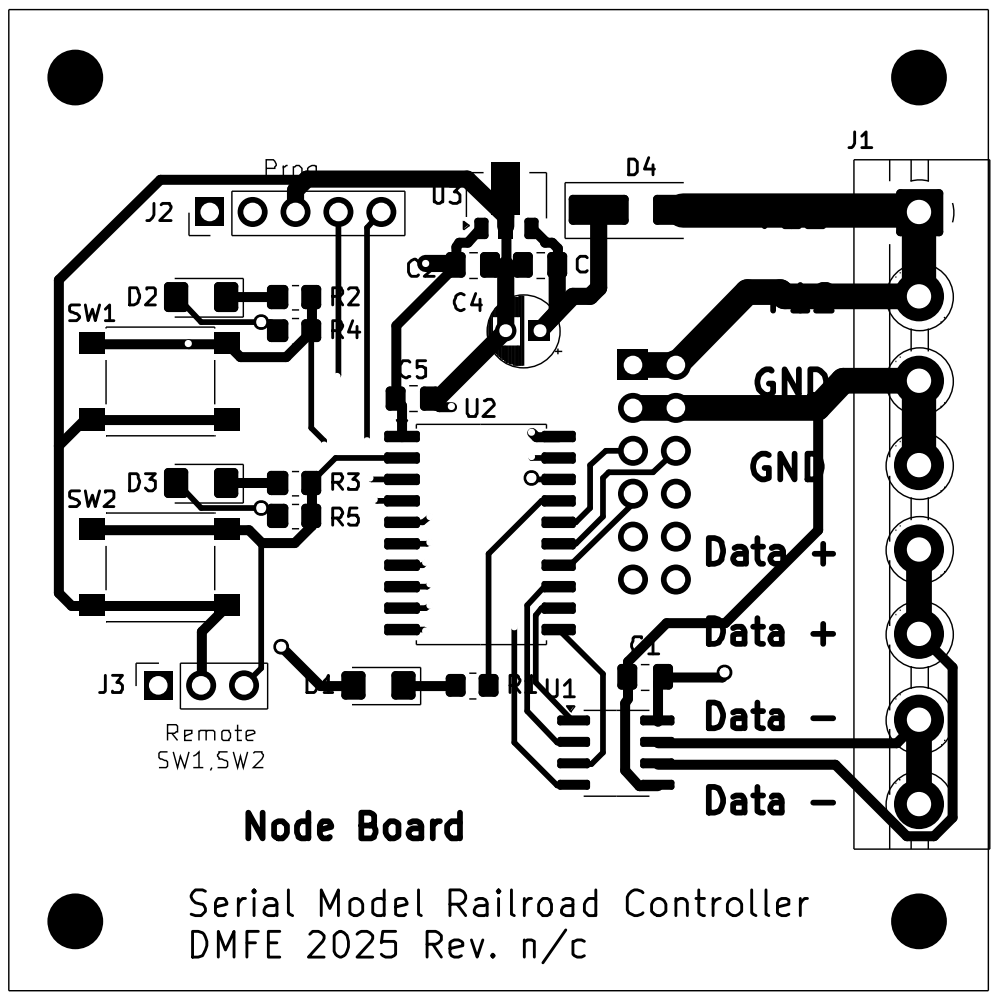
[picture p16: page 1]
