DavidMFlynn/SerialMRRC/Switch Machine and Signal PCB/SMRRC_SwitchAndSignal.kicad_sch.pdf

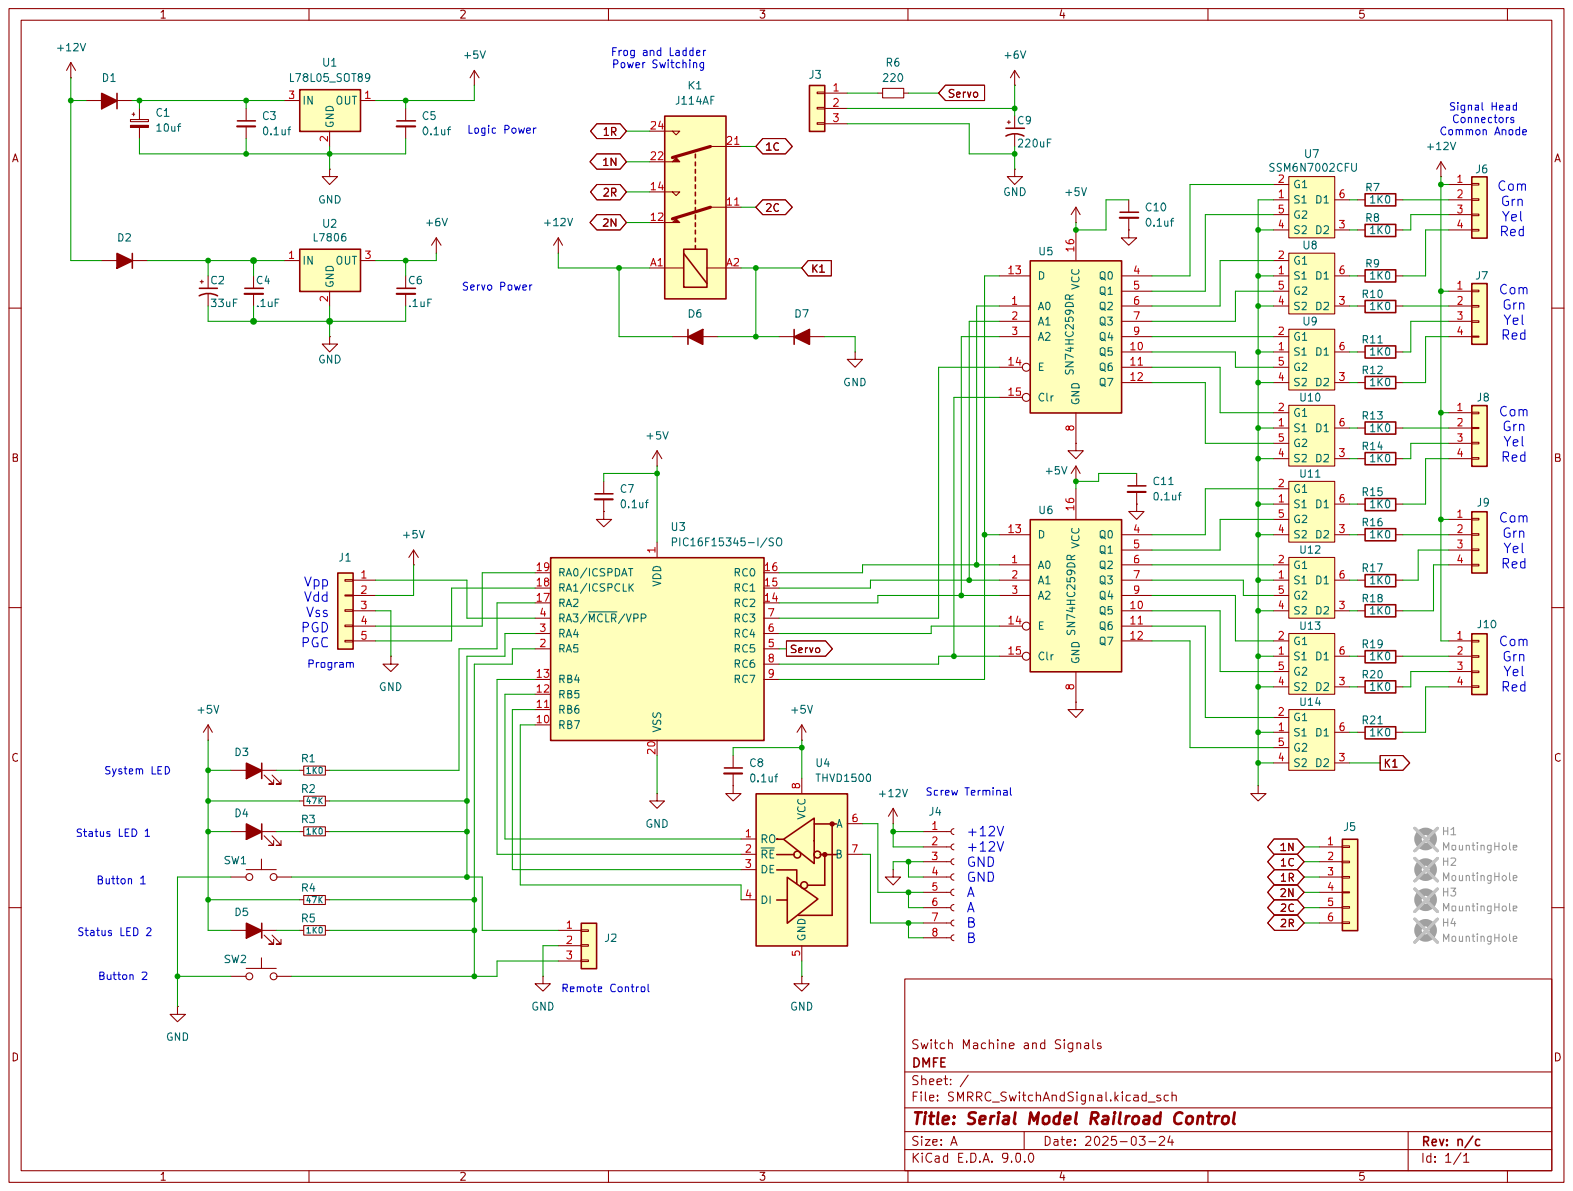
[picture p17: page 1]
