DavidMFlynn/SerialMRRC/Packet Serial Daughter Board/SMRRC_PacketSerial.kicad_sch.pdf

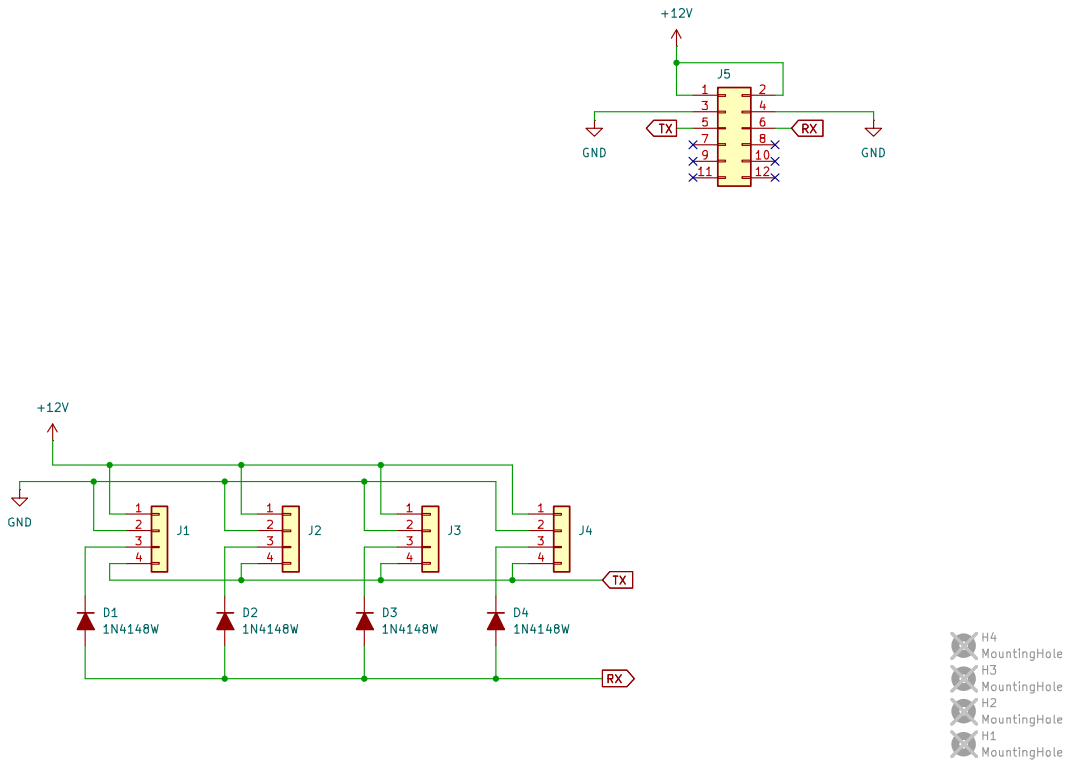
[picture p18: page 1]
