DavidMFlynn/SerialMRRC/Lights Daughter PCB/Lights Sch.pdf

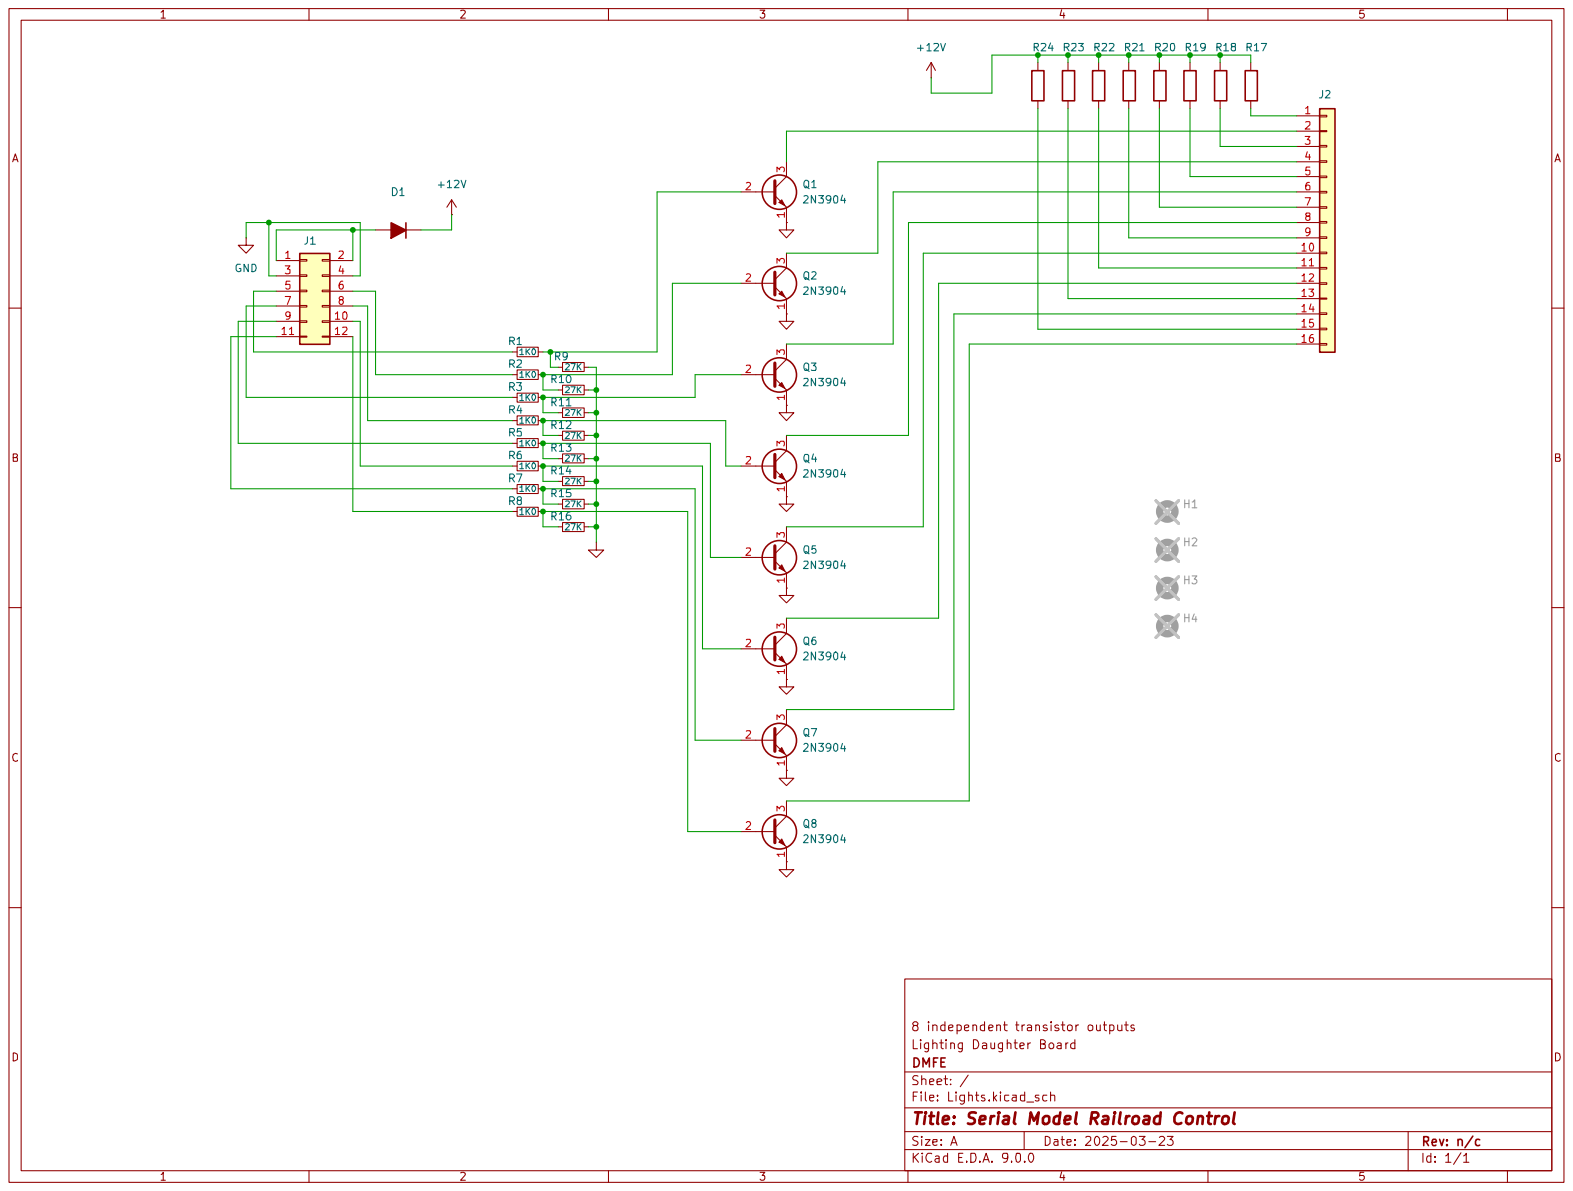
[picture p19: page 1]
