DavidMFlynn/SerialMRRC/USB PCB/SMRRC_USB.kicad_sch.pdf

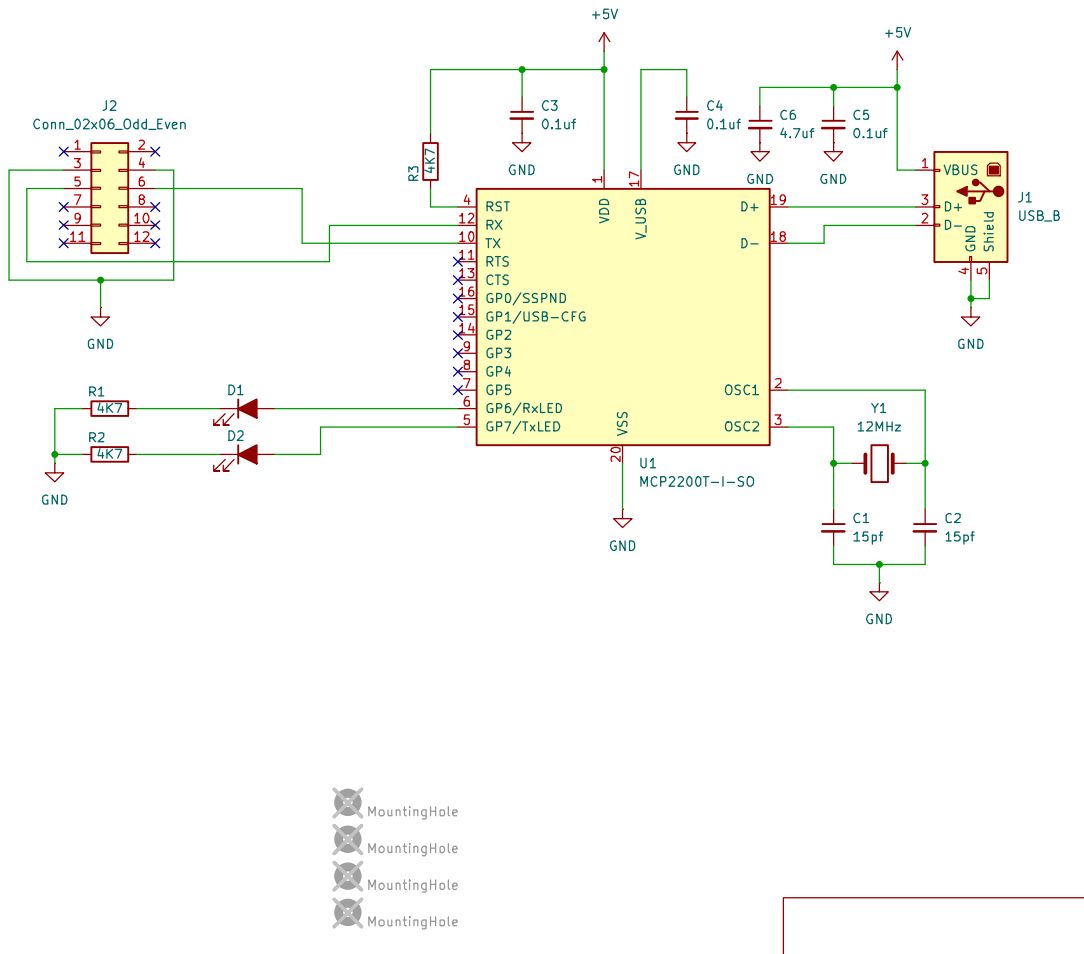
[picture p20: page 1]
