DavidMFlynn/SerialMRRC/Dual Detector Module/PCB/DCC_Detector.kicad_pcb.pdf

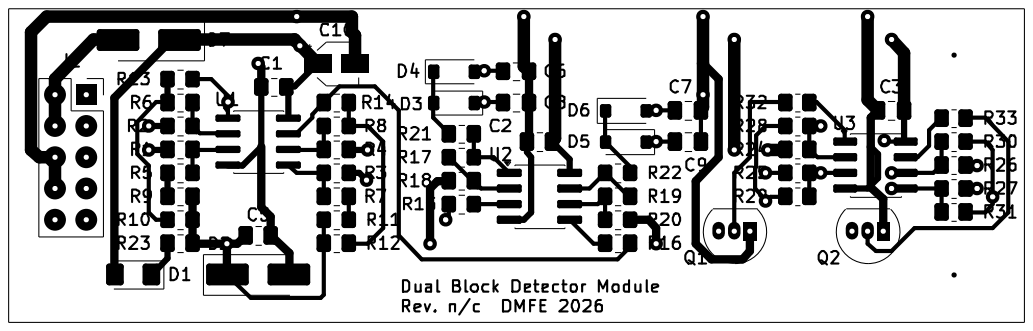
[picture p21: page 1]
