DavidMFlynn/SerialMRRC/Dual Detector Module/PCB/DCC_Detector.kicad_sch.pdf

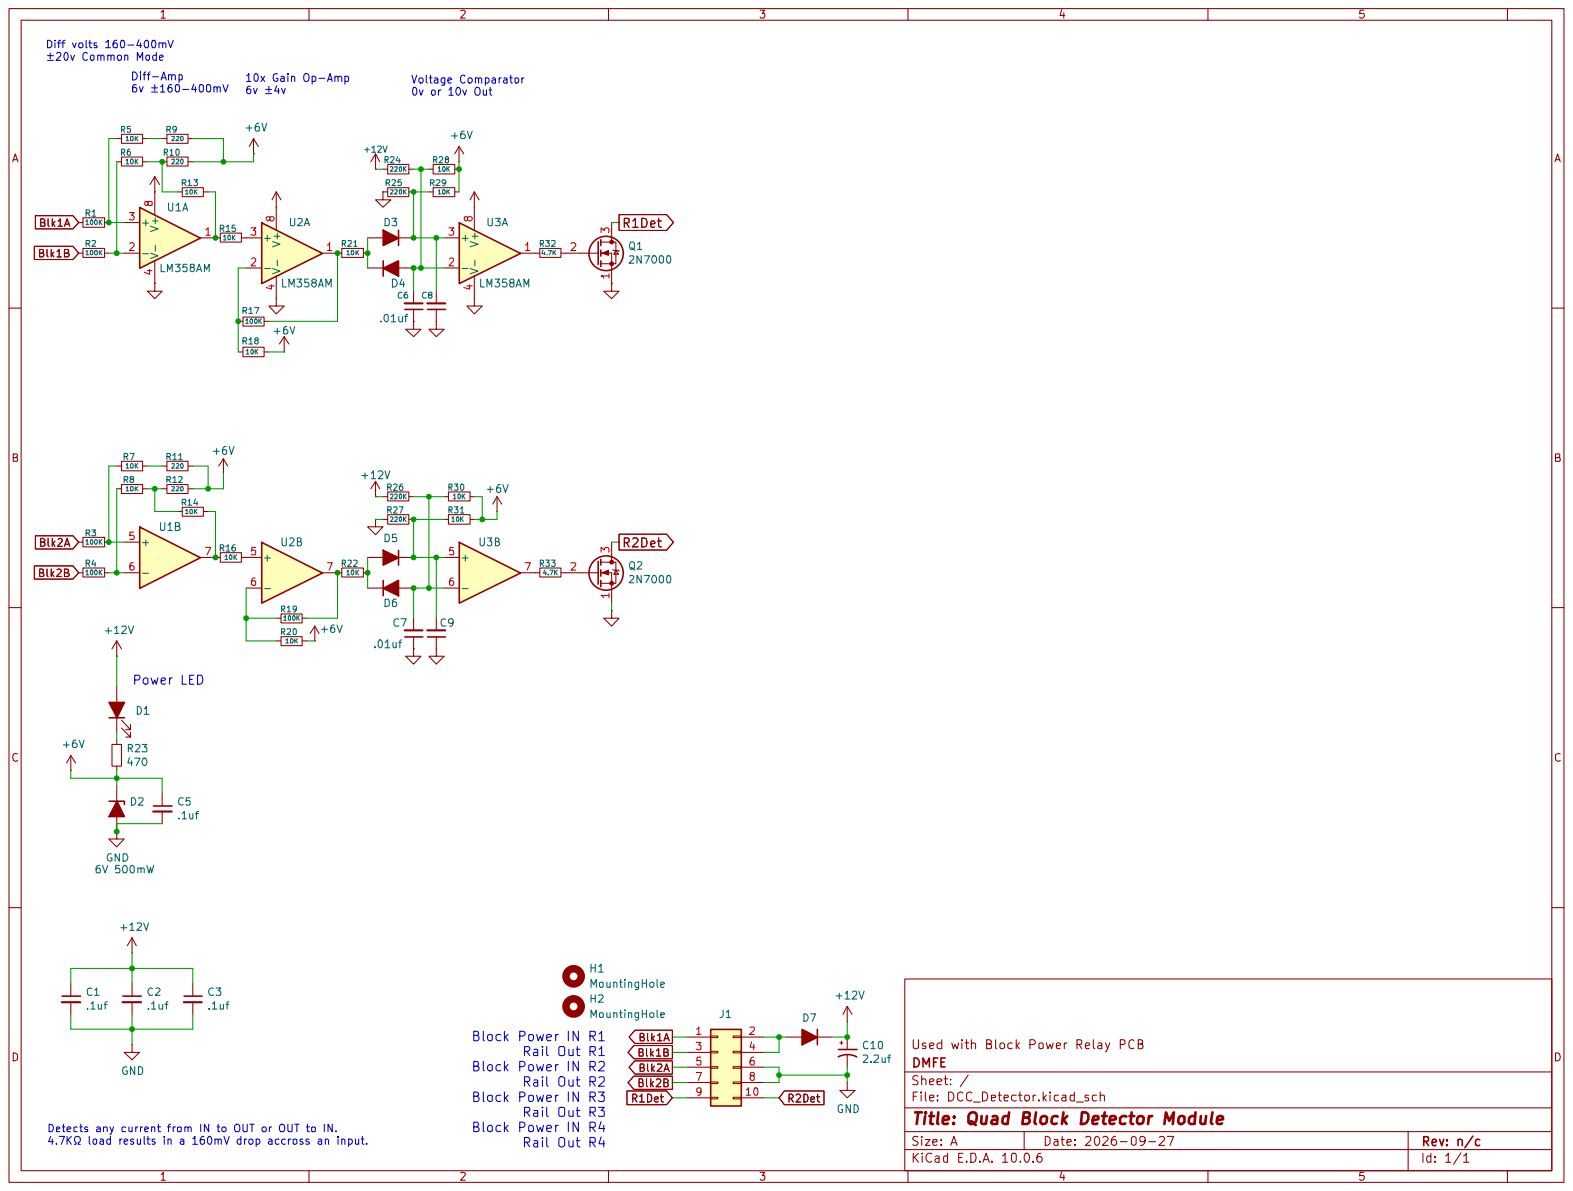
[picture p22: page 1]
