DavidMFlynn/SerialMRRC/Dual Detector Module/PCB/DCC_Detector.kicad_pcb

## KiCad design Dual Detector Module/PCB/DCC_Detector.kicad_pcb (2026-10-02)

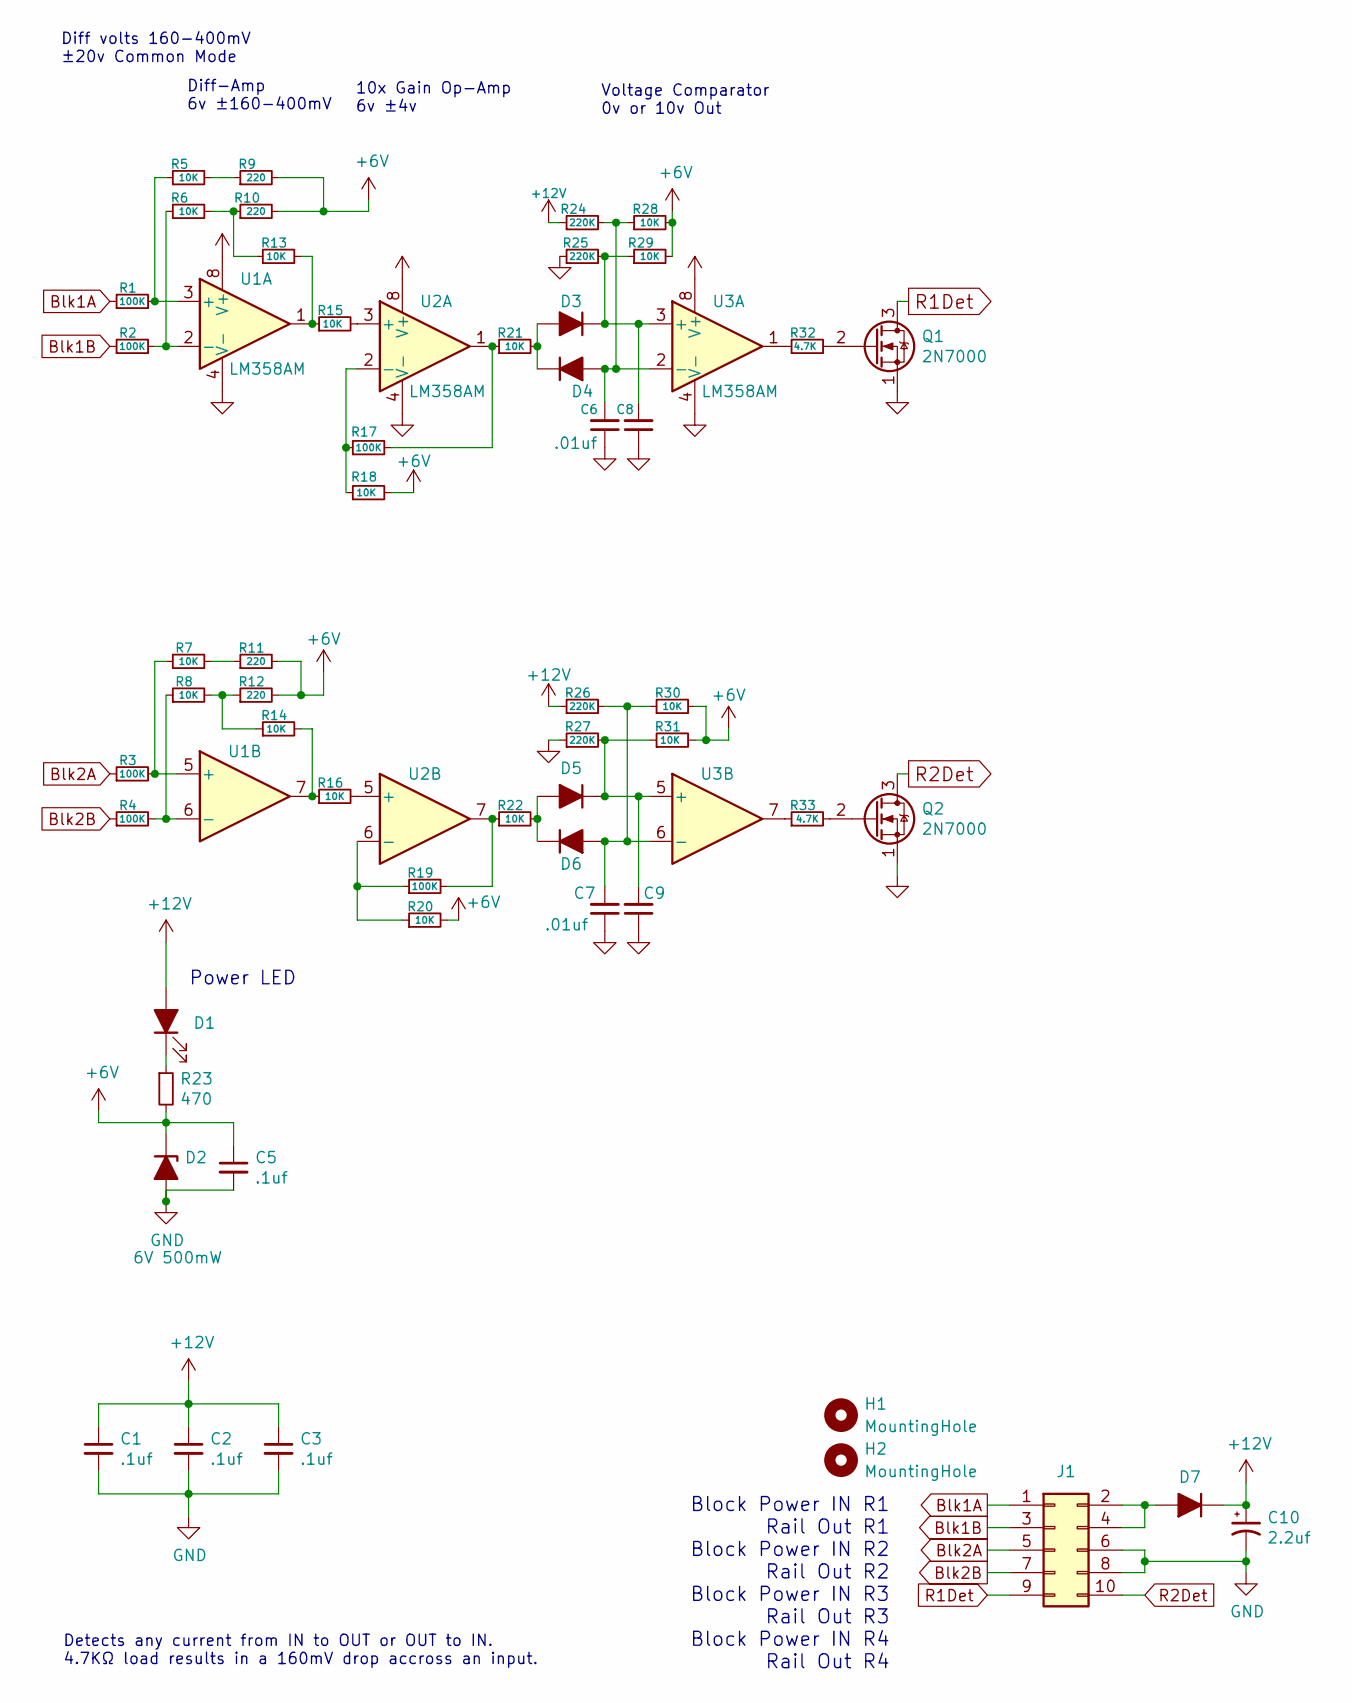
[picture p23: schematic DCC_Detector.kicad_sch, Quad Block Detector Module]

Parts:
C1, C2, C3, C5: .1uf; C_0805_2012Metric_Pad1.18x1.45mm_HandSolder
C6, C7, C8, C9: .01uf; C_0805_2012Metric_Pad1.18x1.45mm_HandSolder
C10: 2.2uf; CP_Elec_3x5.3
D1: 1206 LED; LED_1206_3216Metric_Pad1.42x1.75mm_HandSolder
D2: 6V 500mW; D_SMA_Handsoldering
D3, D4, D5, D6: 1N4148W; D_SOD-123
D7: D_ALT; D_SMA_Handsoldering
H1, H2: MountingHole; MountingHole_3.2mm_M3
J1: Conn_02x05_Odd_Even; PinSocket_2x05_P2.54mm_Vertical
Q1, Q2: 2N7000; TO-92_Inline
R1, R2, R3, R4, R17, R19: 100K; R_0805_2012Metric_Pad1.20x1.40mm_HandSolder
R5, R6, R7, R8, R13, R14, R15, R16, R18, R20, R21, R22, R28, R29, R30, R31: 10K; R_0805_2012Metric_Pad1.20x1.40mm_HandSolder
R9, R10, R11, R12: 220; R_0805_2012Metric_Pad1.20x1.40mm_HandSolder
R23: 470; R_0805_2012Metric_Pad1.20x1.40mm_HandSolder
R24, R25, R26, R27: 220K; R_0805_2012Metric_Pad1.20x1.40mm_HandSolder
R32, R33: 4.7K; R_0805_2012Metric_Pad1.20x1.40mm_HandSolder
U1, U2, U3: LM358AM; SOIC-8_3.9x4.9mm_P1.27mm

Connections:
+6V: C5.1, D2.1 (K), R9.2, R10.2, R11.2, R12.2, R18.2, R20.2, R23.2, R28.2, R29.2, R30.2, R31.2
+12V: C1.1, C2.1, C3.1, C10.1, D1.2 (A), D7.1 (K), R24.1, R26.1, U1.8 (V+), U2.8 (V+), U3.8 (V+)
Blk1A: J1.1, R1.1
Blk1B: J1.3, R2.1
Blk2A: J1.5, R3.1
Blk2B: J1.7, R4.1
GND: C1.2, C2.2, C3.2, C5.2, C6.1, C7.1, C8.1, C9.1, C10.2, D2.2 (A), J1.6, J1.8, Q1.1 (S), Q2.1 (S), R25.1, R27.1, U1.4 (V-), U2.4 (V-), U3.4 (V-)
unnamed: D1.1 (K), R23.1
unnamed: D3.2 (A), D4.1 (K), R21.2
unnamed: C8.2, D3.1 (K), R25.2, R29.1, U3.3 (+)
unnamed: C6.2, D4.2 (A), R24.2, R28.1, U3.2 (-)
unnamed: D5.2 (A), D6.1 (K), R22.2
unnamed: C9.2, D5.1 (K), R27.2, R31.1, U3.5 (+)
unnamed: C7.2, D6.2 (A), R26.2, R30.1, U3.6 (-)
unnamed: D7.2 (A), J1.2, J1.4
unnamed: Q1.2 (G), R32.2
unnamed: Q2.2 (G), R33.2
unnamed: R5.2, R9.1
unnamed: R6.2, R10.1, R13.1
unnamed: R7.2, R11.1
unnamed: R8.2, R12.1, R14.1
unnamed: R13.2, R15.1, U1.1
unnamed: R14.2, R16.1, U1.7
unnamed: R17.2, R21.1, U2.1
unnamed: R19.2, R22.1, U2.7
unnamed: R32.1, U3.1
unnamed: R33.1, U3.7
unnamed: R1.2, R5.1, U1.3 (+)
unnamed: R2.2, R6.1, U1.2 (-)
unnamed: R3.2, R7.1, U1.5 (+)
unnamed: R4.2, R8.1, U1.6 (-)
unnamed: R15.2, U2.3 (+)
unnamed: R17.1, R18.1, U2.2 (-)
unnamed: R16.2, U2.5 (+)
unnamed: R19.1, R20.1, U2.6 (-)
R1Det: J1.9, Q1.3 (D)
R2Det: J1.10, Q2.3 (D)

Notes on the sheet:
Detects any current from IN to OUT or OUT to IN. 4.7KΩ load results in a 160mV drop accross an input.
Voltage Comparator 0v or 10v Out
Block Power IN R1 Rail Out R1 Block Power IN R2 Rail Out R2 Block Power IN R3 Rail Out R3 Block Power IN R4 Rail Out R4
Diff-Amp 6v ±160-400mV
10x Gain Op-Amp 6v ±4v
Diff volts 160-400mV ±20v Common Mode
Power LED

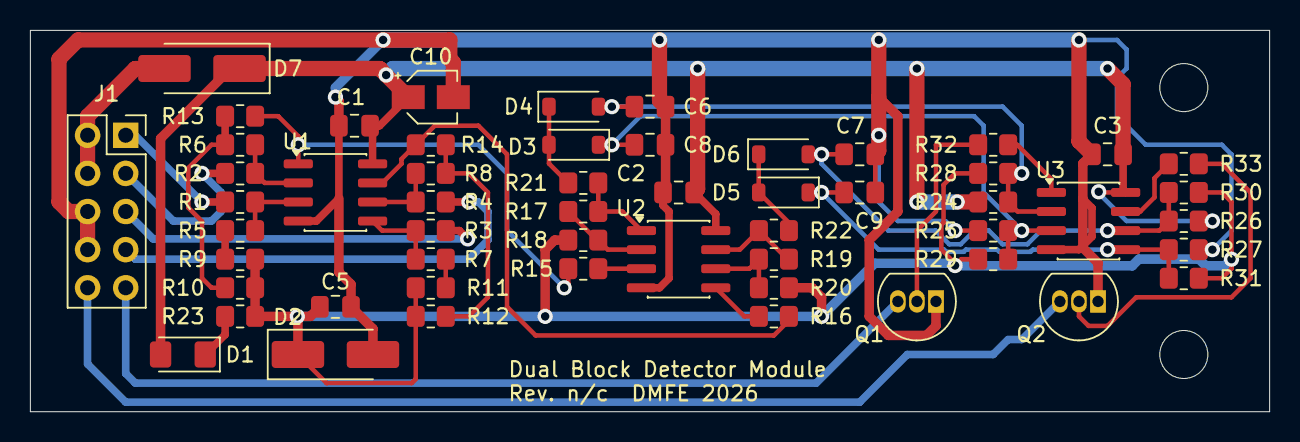
[picture p24: board DCC_Detector.kicad_pcb from above]

Board: 2 copper layers, 82.6 x 25.4 mm, 57 parts (0 on the bottom side), 37 nets.
