DavidMFlynn/SerialMRRC/Block Relay PCB/BlockRelay.kicad_pcb

## KiCad design Block Relay PCB/BlockRelay.kicad_pcb (2026-10-02)

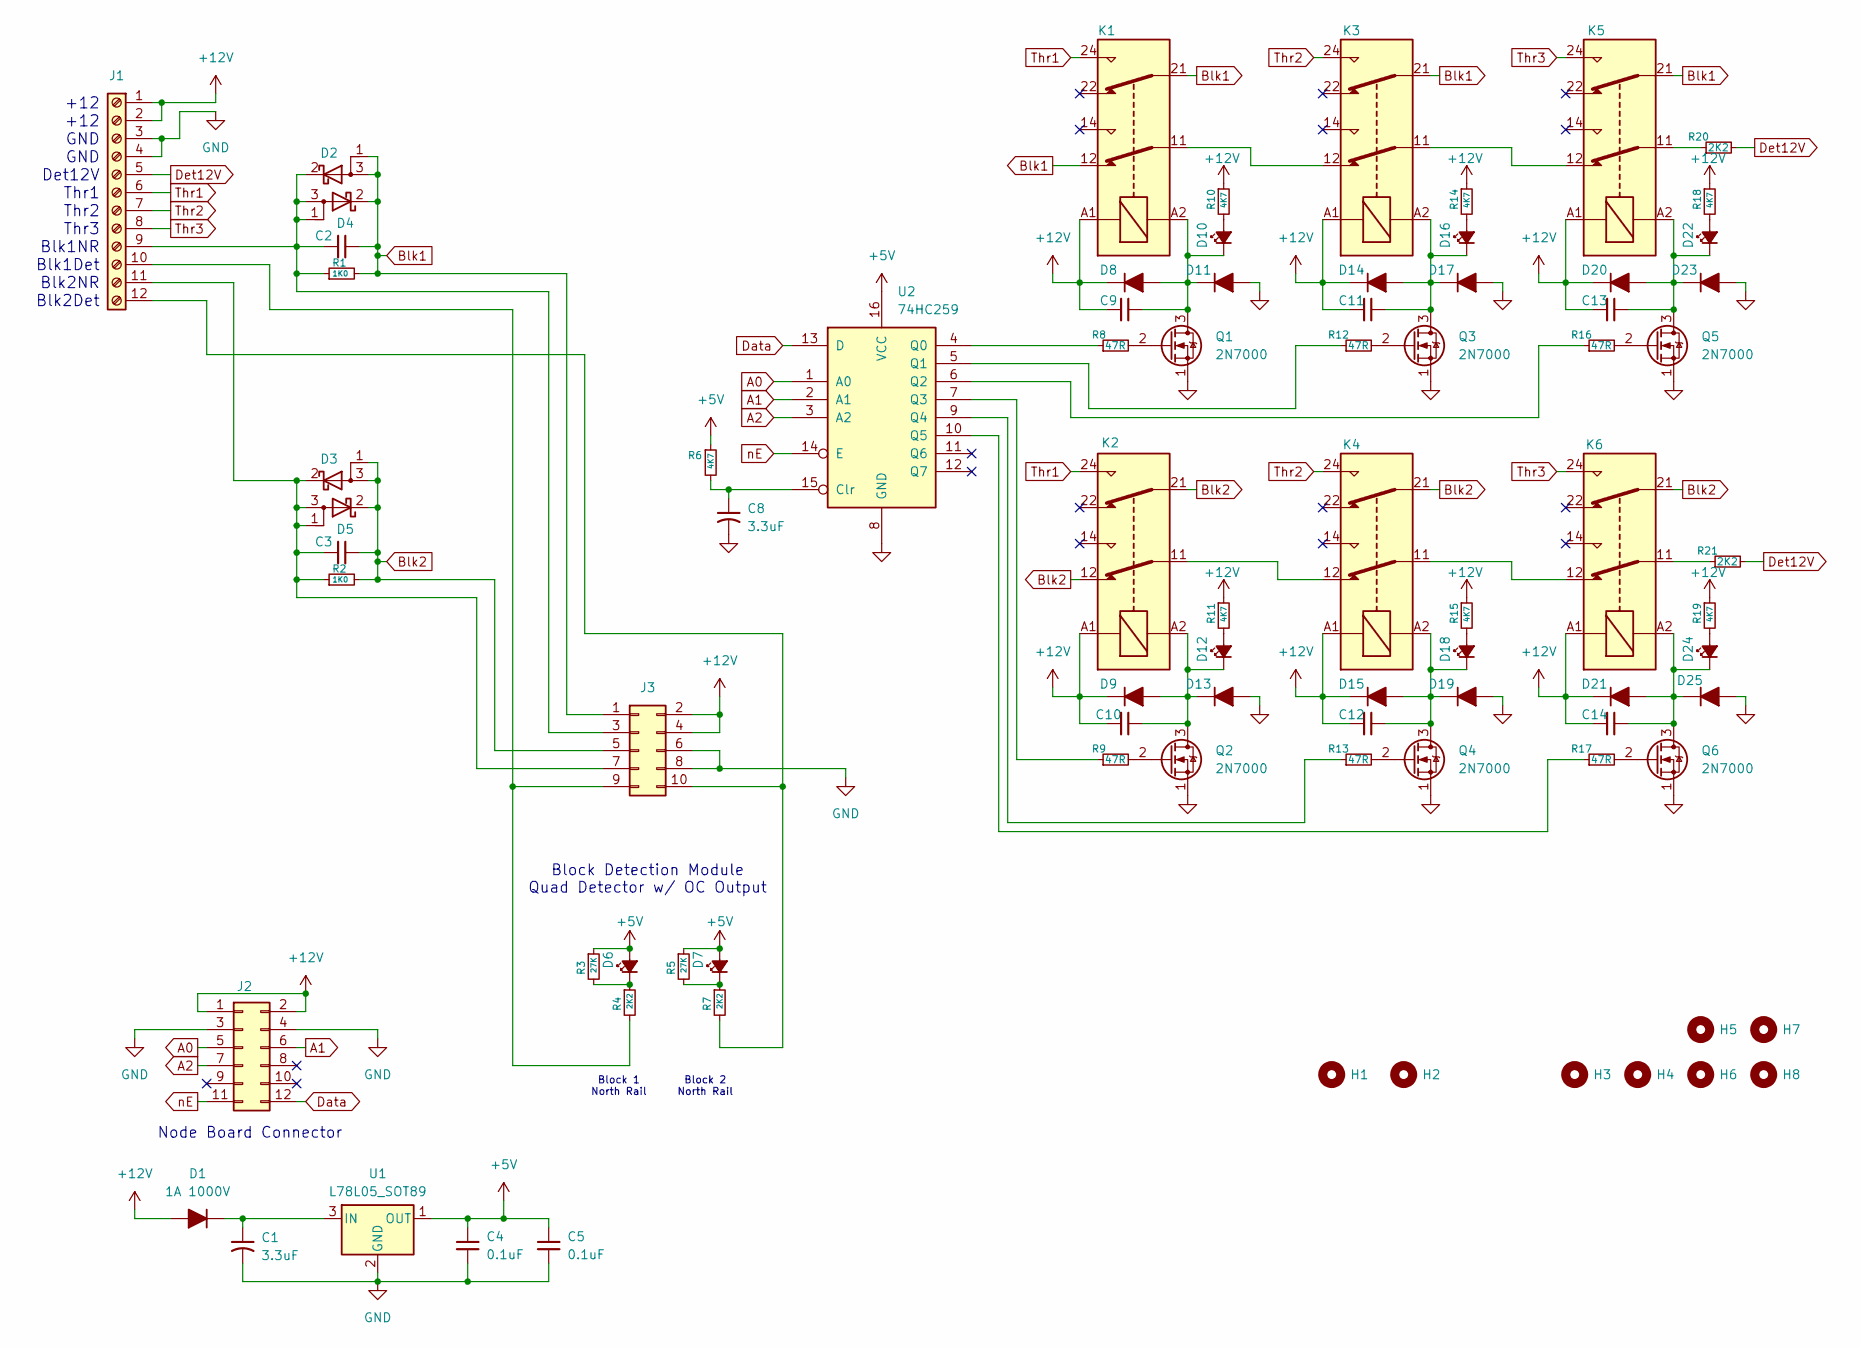
[picture p25: schematic BlockRelay.kicad_sch, Block Relay]

Parts:
C1, C8: 3.3uF; C_Radial_D5.0mm_H5.0mm_P2.00mm
C2, C3, C4, C5, C9, C10, C11, C12, C13, C14: 0.1uF; C_0805_2012Metric_Pad1.18x1.45mm_HandSolder
D1, D8, D9, D11, D13, D14, D15, D17, D19, D20, D21, D23, D25: 1A 1000V; D_SMA_Handsoldering
D2, D3, D4, D5: Schottky_AKA DPAK; TO-252-2
D6, D7, D10, D12, D16, D18, D22, D24: Yellow LED; LED_1206_3216Metric_Pad1.42x1.75mm_HandSolder
H1, H2, H3, H4, H5, H6, H7, H8: MountingHole; MountingHole_3.2mm_M3
J1: Screw_Terminal_01x12; TerminalBlock_Phoenix_PT-1,5-12-3.5-H_1x12_P3.50mm_Horizont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
J2: Conn_02x06_Odd_Even; PinHeader_2x06_P2.54mm_Vertical
J3: Conn_02x05_Odd_Even; PinSocket_2x05_P2.54mm_Vertical
K1, K2, K3, K4, K5, K6: Relay_DPDT; Relay_DPDT_Finder_40.52
Q1, Q2, Q3, Q4, Q5, Q6: 2N7000; TO-92_Inline
R1, R2: 1K0; R_0805_2012Metric_Pad1.20x1.40mm_HandSolder
R3, R5: 27K; R_0805_2012Metric_Pad1.20x1.40mm_HandSolder
R4, R7: 2K2; R_0805_2012Metric_Pad1.20x1.40mm_HandSolder
R6, R10, R11, R14, R15, R18, R19: 4K7; R_0805_2012Metric_Pad1.20x1.40mm_HandSolder
R8, R9, R12, R13, R16, R17: 47R; R_0805_2012Metric_Pad1.20x1.40mm_HandSolder
R20, R21: 2K2; R_Axial_DIN0516_L15.5mm_D5.0mm_P20.32mm_Horizontal
U1: L78L05_SOT89; SOT-89-3
U2: 74HC259; SOIC-16_3.9x9.9mm_P1.27mm

Connections:
+5V: C4.1, C5.1, D6.2 (A), D7.2 (A), R3.1, R5.1, R6.1, U1.1 (OUT), U2.16 (VCC)
+12V: C9.1, C10.1, C11.1, C12.1, C13.1, C14.1, D1.2 (A), D8.1 (K), D9.1 (K), D14.1 (K), D15.1 (K), D20.1 (K), D21.1 (K), J1.1, J1.2, J2.1, J2.2, J3.2, J3.4, K1.A1, K2.A1, K3.A1, K4.A1, K5.A1, K6.A1, R10.1, R11.1, R14.1, R15.1, R18.1, R19.1
A0: J2.5, U2.1 (A0)
A1: J2.6, U2.2 (A1)
A2: J2.7, U2.3 (A2)
Blk1: C2.2, D2.1 (A), D2.3 (A), D4.2 (K), J3.1, K1.12, K1.21, K3.21, K5.21, R1.2
Blk2: C3.2, D3.1 (A), D3.3 (A), D5.2 (K), J3.5, K2.12, K2.21, K4.21, K6.21, R2.2
Data: J2.12, U2.13 (D)
Det12V: J1.5, R20.2, R21.2
GND: C1.2, C4.2, C5.2, C8.2, D11.2 (A), D13.2 (A), D17.2 (A), D19.2 (A), D23.2 (A), D25.2 (A), J1.3, J1.4, J2.3, J2.4, J3.6, J3.8, Q1.1 (S), Q2.1 (S), Q3.1 (S), Q4.1 (S), Q5.1 (S), Q6.1 (S), U1.2 (GND), U2.8 (GND)
unnamed: C1.1, D1.1 (K), U1.3 (IN)
unnamed: C2.1, D2.2 (K), D4.1 (A), D4.3 (A), J1.9, J3.3, R1.1
unnamed: C3.1, D3.2 (K), D5.1 (A), D5.3 (A), J1.11, J3.7, R2.1
unnamed: D6.1 (K), R3.2, R4.1
unnamed: D7.1 (K), R5.2, R7.1
unnamed: D10.2 (A), R10.2
unnamed: C9.2, D8.2 (A), D10.1 (K), D11.1 (K), K1.A2, Q1.3 (D)
unnamed: D12.2 (A), R11.2
unnamed: C10.2, D9.2 (A), D12.1 (K), D13.1 (K), K2.A2, Q2.3 (D)
unnamed: C11.2, D14.2 (A), D16.1 (K), D17.1 (K), K3.A2, Q3.3 (D)
unnamed: C12.2, D15.2 (A), D18.1 (K), D19.1 (K), K4.A2, Q4.3 (D)
unnamed: D16.2 (A), R14.2
unnamed: D18.2 (A), R15.2
unnamed: C13.2, D20.2 (A), D22.1 (K), D23.1 (K), K5.A2, Q5.3 (D)
unnamed: C14.2, D21.2 (A), D24.1 (K), D25.1 (K), K6.A2, Q6.3 (D)
unnamed: D22.2 (A), R18.2
unnamed: D24.2 (A), R19.2
unnamed: J1.10, J3.9, R4.2
unnamed: J1.12, J3.10, R7.2
unnamed: K1.11, K3.12
unnamed: K2.11, K4.12
unnamed: K3.11, K5.12
unnamed: K4.11, K6.12
unnamed: K5.11, R20.1
unnamed: K6.11, R21.1
unnamed: Q1.2 (G), R8.2
unnamed: Q2.2 (G), R9.2
unnamed: Q3.2 (G), R12.2
unnamed: Q4.2 (G), R13.2
unnamed: Q5.2 (G), R16.2
unnamed: Q6.2 (G), R17.2
unnamed: C8.1, R6.2, U2.15 (Clr)
unnamed: R8.1, U2.4 (Q0)
unnamed: R12.1, U2.5 (Q1)
unnamed: R16.1, U2.6 (Q2)
unnamed: R9.1, U2.7 (Q3)
unnamed: R13.1, U2.9 (Q4)
unnamed: R17.1, U2.10 (Q5)
Thr1: J1.6, K1.24, K2.24
Thr2: J1.7, K3.24, K4.24
Thr3: J1.8, K5.24, K6.24
nE: J2.11, U2.14 (E)

Notes on the sheet:
Block Detection Module Quad Detector w/ OC Output
+12 +12 GND GND Det12V Thr1 Thr2 Thr3 Blk1NR Blk1Det Blk2NR Blk2Det
Block 2 North Rail
Node Board Connector
Block 1 North Rail

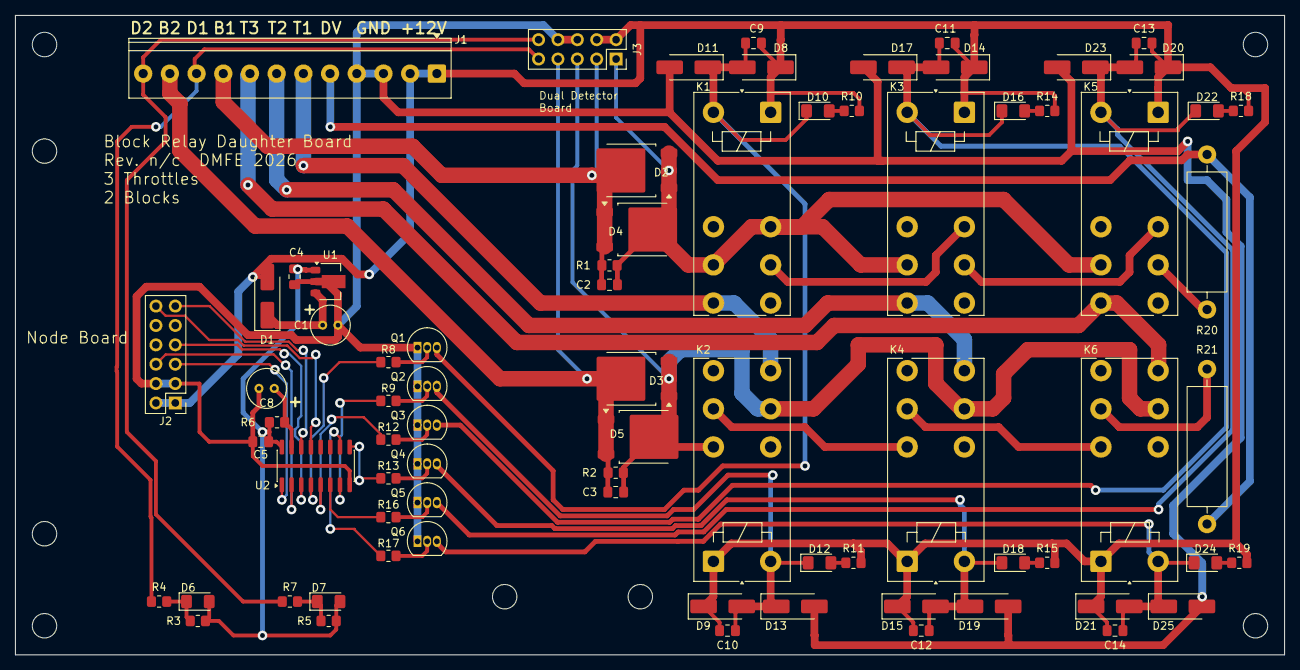
[picture p26: board BlockRelay.kicad_pcb from above]

Board: 2 copper layers, 166.4 x 83.8 mm, 83 parts (0 on the bottom side), 52 nets.
