DavidMFlynn/SerialMRRC/Node Board PCB/SMRRC.kicad_pcb

## KiCad design Node Board PCB/SMRRC.kicad_pcb (2026-07-25)

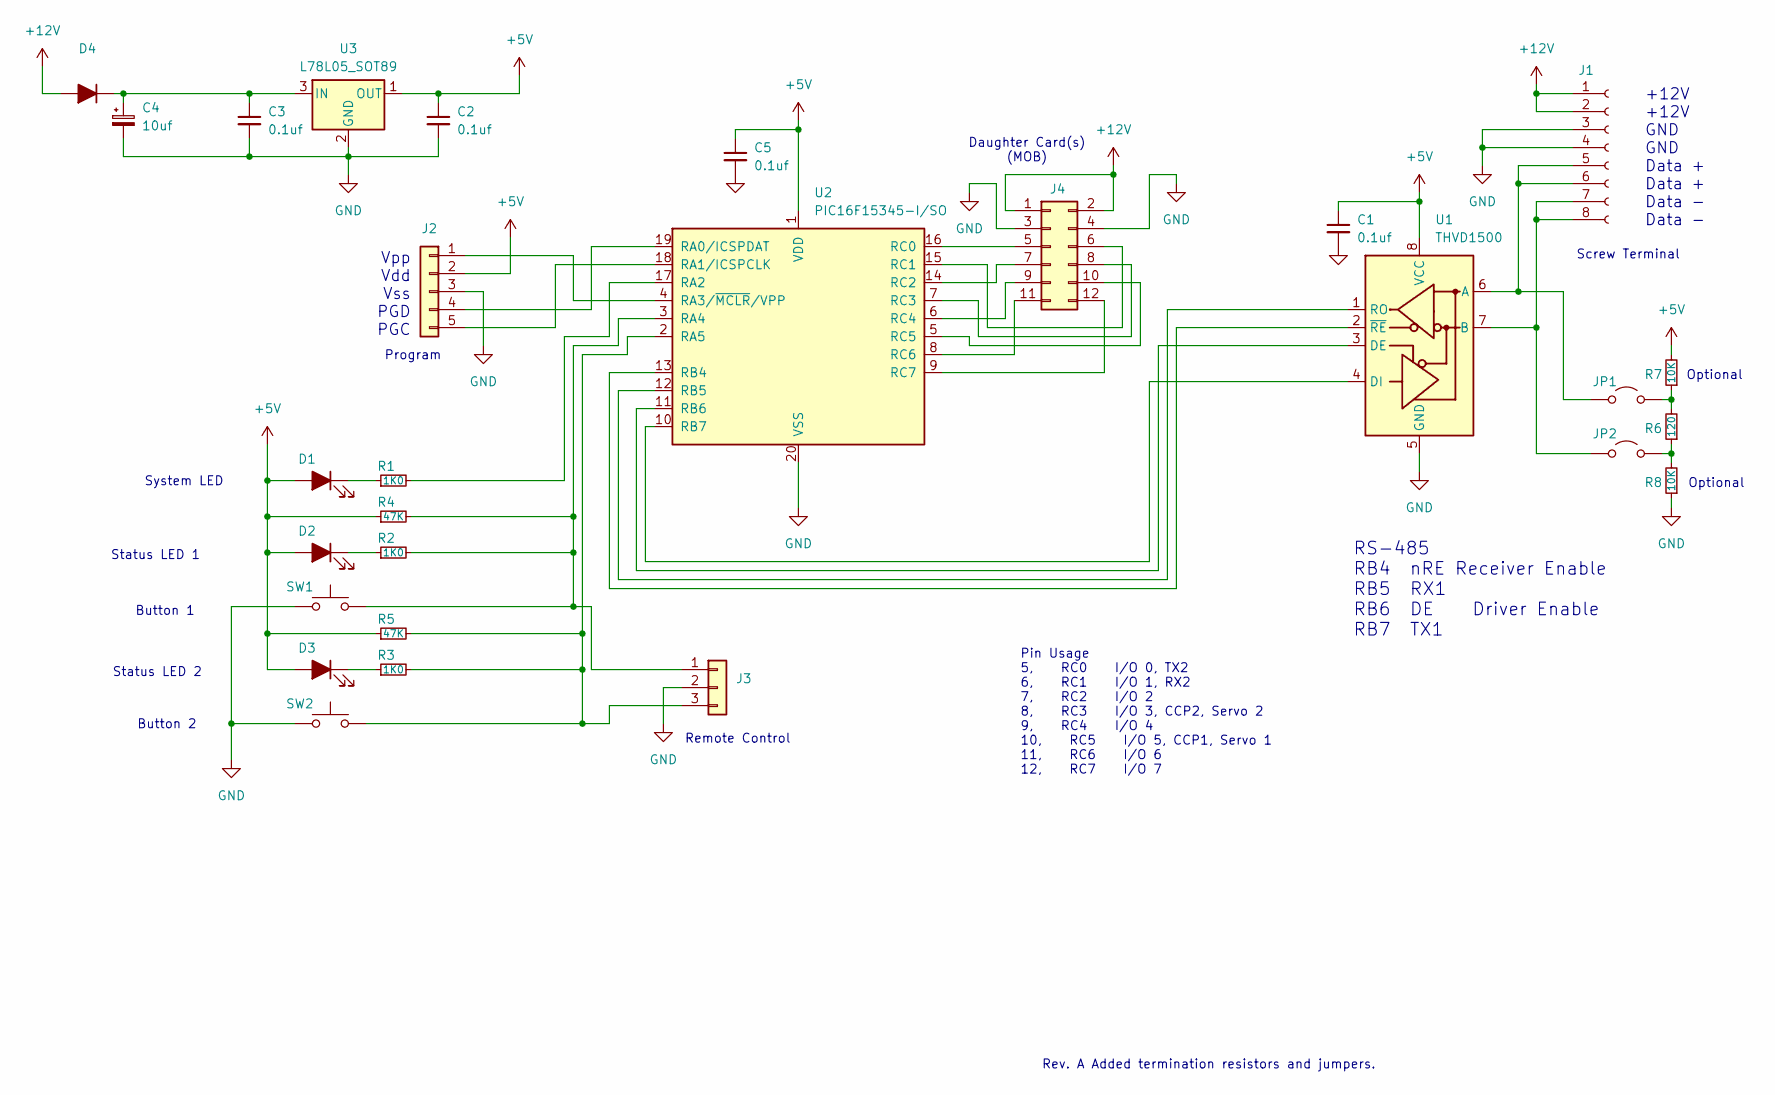
[picture p27: schematic SMRRC.kicad_sch, Serial Model Railroad Control]

Parts:
C1, C2, C3, C5: 0.1uf; C_0805_2012Metric_Pad1.18x1.45mm_HandSolder
C4: 10uf; CP_Radial_D4.0mm_P2.00mm
D1, D2, D3: LED_Filled; D_1206_3216Metric_Pad1.42x1.75mm_HandSolder
D4: SMA; D_SMA_Handsoldering
J1: Conn_01x08_Socket; TerminalBlock_MaiXu_MX126-5.0-08P_1x08_P5.00mm
J2: Conn_01x05; PinHeader_1x05_P2.54mm_Vertical
J3: Conn_01x03; PinSocket_1x03_P2.54mm_Vertical
J4: Conn_02x06_Odd_Even; PinSocket_2x06_P2.54mm_Vertical
JP1, JP2: Jumper_2_Open; SolderJumper-2_P1.3mm_Open_RoundedPad1.0x1.5mm
R1, R2, R3: 1K0; R_0805_2012Metric_Pad1.20x1.40mm_HandSolder
R4, R5: 47K; R_0805_2012Metric_Pad1.20x1.40mm_HandSolder
R6: 120; R_0805_2012Metric_Pad1.20x1.40mm_HandSolder
R7, R8: 10K; R_0805_2012Metric_Pad1.20x1.40mm_HandSolder
SW1, SW2: SW_Push; SW_SPST_PTS645
U1: THVD1500; SOIC-8_3.9x4.9mm_P1.27mm
U2: PIC16F15345-I/SO; SOIC-20W_7.5x12.8mm_P1.27mm
U3: L78L05_SOT89; SOT-89-3

Connections:
+5V: C1.1, C2.1, C5.1, D1.2 (A), D2.2 (A), D3.2 (A), J2.2, R4.1, R5.1, R7.2, U1.8 (VCC), U2.1 (VDD), U3.1 (OUT)
+12V: D4.2 (A), J1.1, J1.2, J4.1, J4.2
GND: C1.2, C2.2, C3.2, C4.2, C5.2, J1.3, J1.4, J2.3, J3.2, J4.3, J4.4, R8.1, SW1.1, SW2.1, U1.5 (GND), U2.20 (VSS), U3.2 (GND)
unnamed: D1.1 (K), R1.1
unnamed: D2.1 (K), R2.1
unnamed: D3.1 (K), R3.1
unnamed: C3.1, C4.1, D4.1 (K), U3.3 (IN)
unnamed: J1.5, J1.6, JP1.1 (A), U1.6 (A)
unnamed: J1.7, J1.8, JP2.1 (A), U1.7 (B)
unnamed: J2.1, U2.4 (RA3/~MCLR/VPP)
unnamed: J2.4, U2.19 (RA0/ICSPDAT)
unnamed: J2.5, U2.18 (RA1/ICSPCLK)
unnamed: J3.1, R2.2, R4.2, SW1.2, U2.3 (RA4)
unnamed: J3.3, R3.2, R5.2, SW2.2, U2.2 (RA5)
unnamed: J4.5, U2.16 (RC0)
unnamed: J4.6, U2.15 (RC1)
unnamed: J4.7, U2.14 (RC2)
unnamed: J4.8, U2.7 (RC3)
unnamed: J4.9, U2.6 (RC4)
unnamed: J4.10, U2.5 (RC5)
unnamed: J4.11, U2.8 (RC6)
unnamed: J4.12, U2.9 (RC7)
unnamed: JP1.2 (B), R6.2, R7.1
unnamed: JP2.2 (B), R6.1, R8.2
unnamed: U1.3 (DE), U2.11 (RB6)
unnamed: U1.4 (DI), U2.10 (RB7)
unnamed: U1.1 (RO), U2.12 (RB5)
unnamed: U1.2 (~RE), U2.13 (RB4)
unnamed: R1.2, U2.17 (RA2)

Notes on the sheet:
Daughter Card(s) (MOB)
Remote Control
RS-485 RB4 nRE Receiver Enable RB5 RX1 RB6 DE Driver Enable RB7 TX1
Status LED 1
Program
Vpp Vdd Vss PGD PGC
Optional
Rev. A Added termination resistors and jumpers.
Button 2
System LED
Screw Terminal
Status LED 2
Button 1
Pin Usage 5, RC0 I/O 0, TX2 6, RC1 I/O 1, RX2 7, RC2 I/O 2 8, RC3 I/O 3, CCP2, Servo 2 9, RC4 I/O 4 10, RC5 I/O 5, CCP1, Servo 1 11, RC6 I/O 6 12, RC7 I/O 7
+12V +12V GND GND Data + Data + Data - Data -

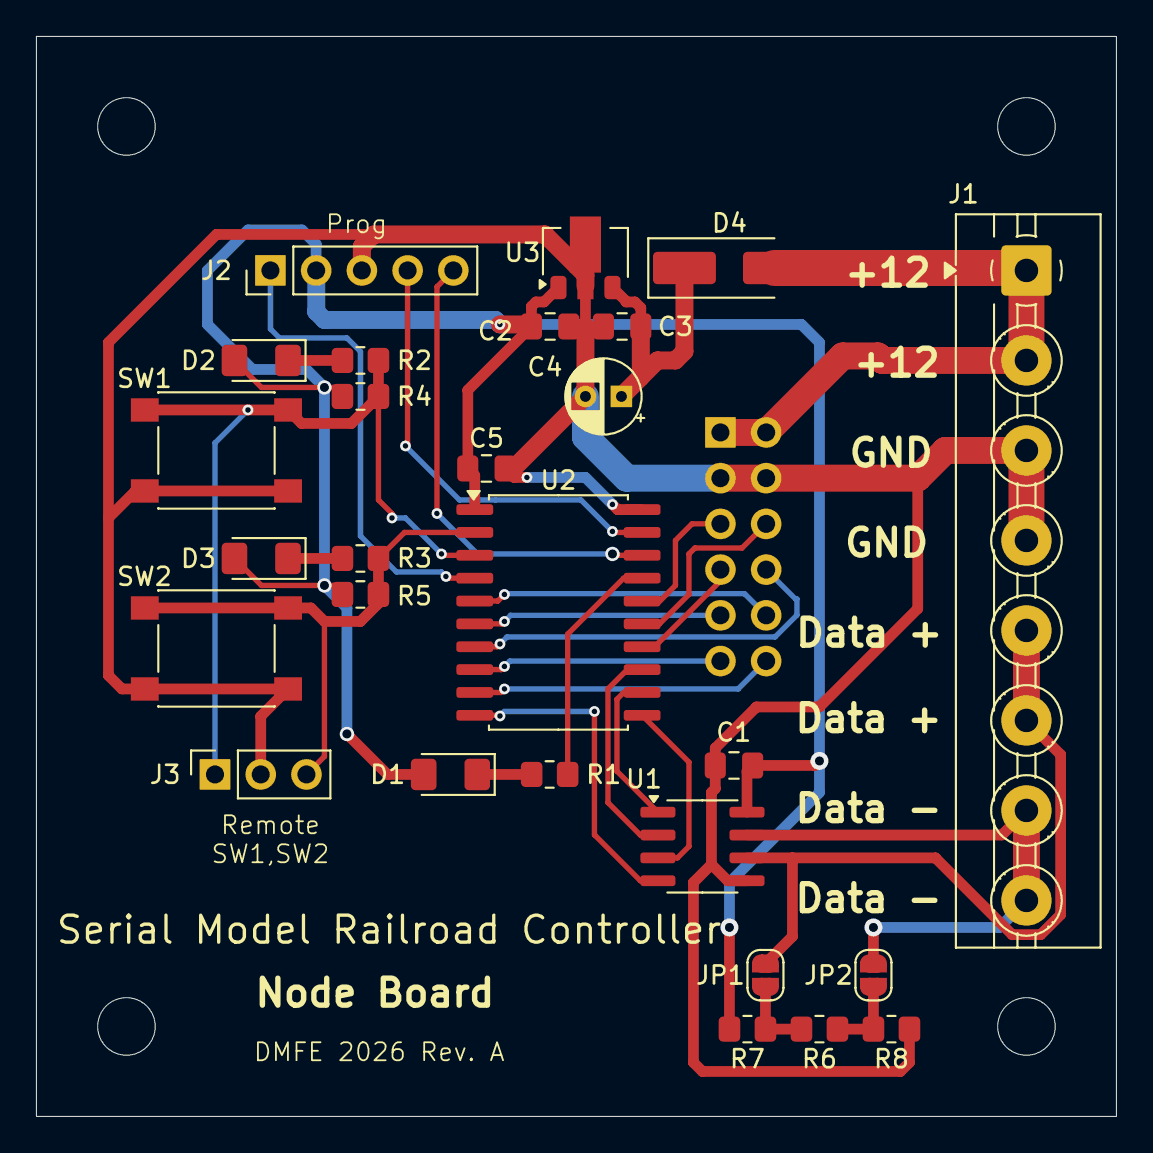
[picture p28: board SMRRC.kicad_pcb from above]

Board: 2 copper layers, 60.0 x 60.0 mm, 32 parts (1 on the bottom side), 29 nets.

Other parts of the board:
H1, H2, H3, H4: MountingHole_3.2mm_M3
