DavidMFlynn/SerialMRRC/USB PCB/SMRRC_USB.kicad_pcb

## KiCad design USB PCB/SMRRC_USB.kicad_pcb (2026-07-25)

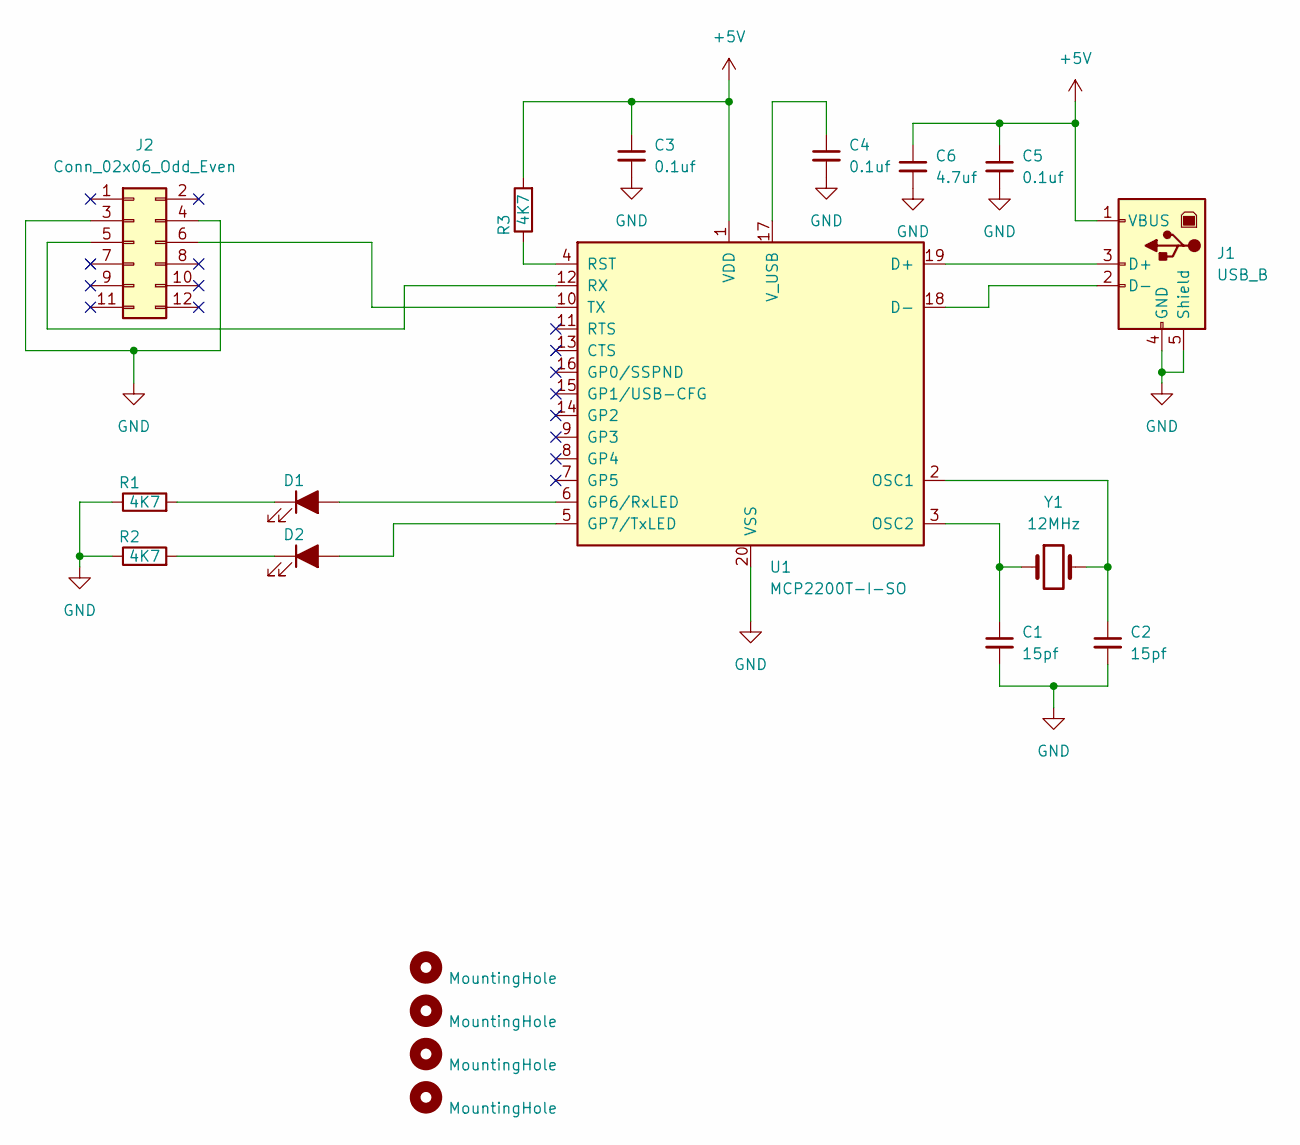
[picture p29: schematic SMRRC_USB.kicad_sch, Serial Model Railroad Control]

Parts:
C1, C2: 15pf; C_0805_2012Metric_Pad1.18x1.45mm_HandSolder
C3, C4, C5: 0.1uf; C_0805_2012Metric_Pad1.18x1.45mm_HandSolder
C6: 4.7uf; C_0805_2012Metric_Pad1.18x1.45mm_HandSolder
D1, D2: Green; LED_1206_3216Metric_Pad1.42x1.75mm_HandSolder
H1, H2, H3, H4: MountingHole; MountingHole_3.2mm_M3
J1: USB_B; USB_B_OST_USB-B1HSxx_Horizontal
J2: Conn_02x06_Odd_Even; PinHeader_2x06_P2.54mm_Vertical
R1, R2, R3: 4K7; R_0805_2012Metric_Pad1.20x1.40mm_HandSolder
U1: MCP2200T-I-SO; SOIC-20W_7.5x12.8mm_P1.27mm
Y1: 12MHz; Crystal_HC49-4H_Vertical

Connections:
+5V: C3.1, C5.1, C6.1, J1.1 (VBUS), R3.2, U1.1 (VDD)
GND: C1.2, C2.2, C3.2, C4.2, C5.2, C6.2, J1.4 (GND), J1.5 (Shield), J2.3, J2.4, R1.1, R2.1, U1.20 (VSS)
unnamed: D1.2 (A), U1.6 (GP6/RxLED)
unnamed: D1.1 (K), R1.2
unnamed: D2.2 (A), U1.5 (GP7/TxLED)
unnamed: D2.1 (K), R2.2
unnamed: J1.3 (D+), U1.19 (D+)
unnamed: J1.2 (D-), U1.18 (D-)
unnamed: J2.5, U1.12 (RX)
unnamed: J2.6, U1.10 (TX)
unnamed: C2.1, U1.2 (OSC1), Y1.2
unnamed: C1.1, U1.3 (OSC2), Y1.1
unnamed: R3.1, U1.4 (RST)
unnamed: C4.1, U1.17 (V_USB)

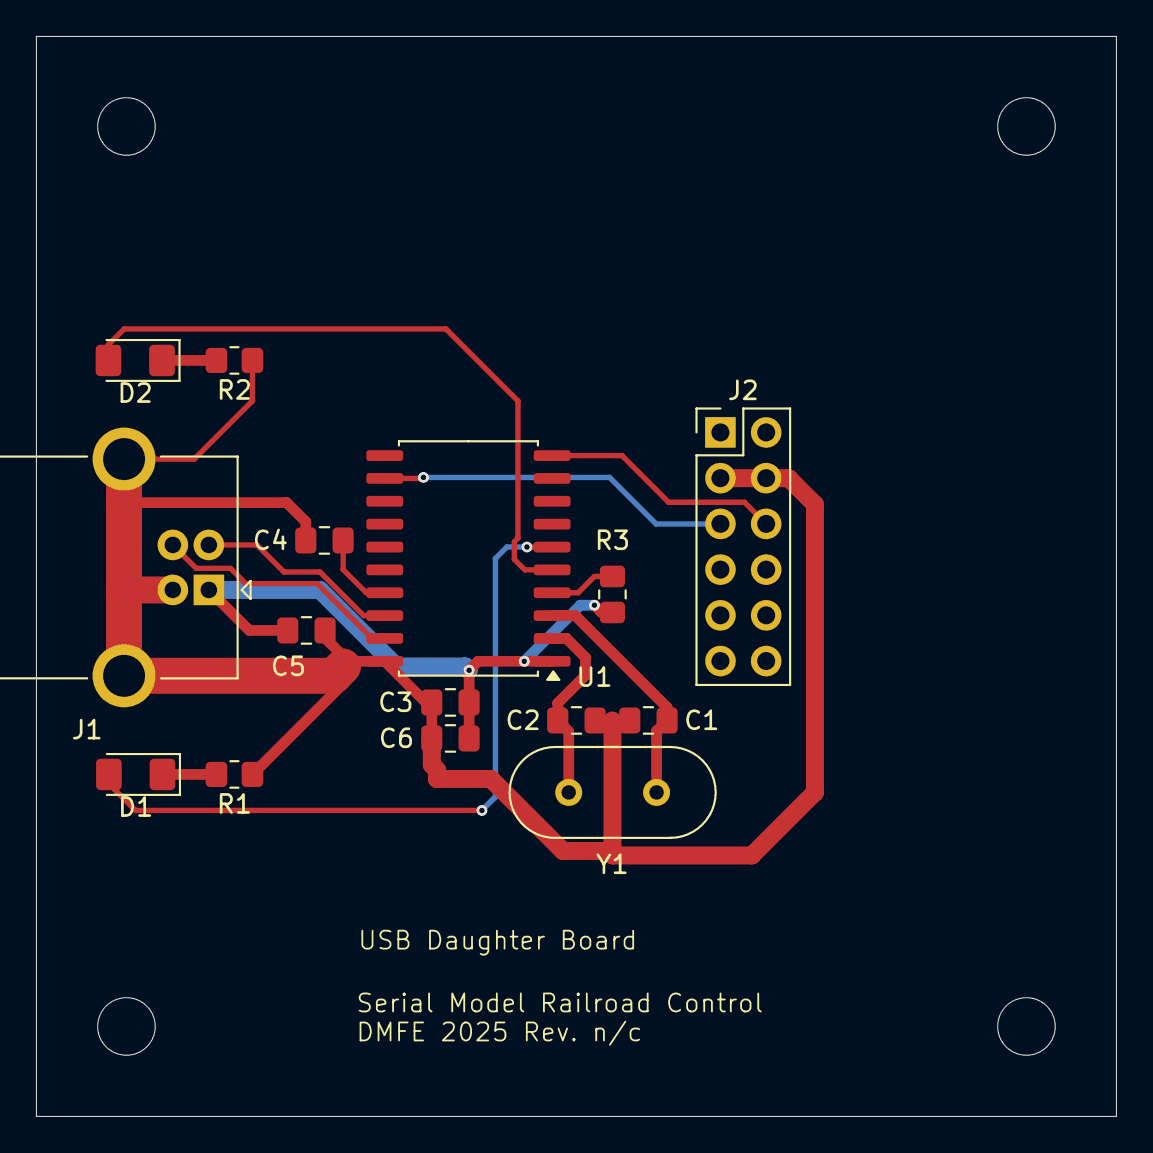
[picture p30: board SMRRC_USB.kicad_pcb from above]

Board: 2 copper layers, 60.0 x 60.0 mm, 19 parts (0 on the bottom side), 14 nets.
