DavidMFlynn/SerialMRRC/Servo 8 Daughter PCB/SMRRC_Servo8.kicad_pcb

## KiCad design Servo 8 Daughter PCB/SMRRC_Servo8.kicad_pcb (2026-07-25)

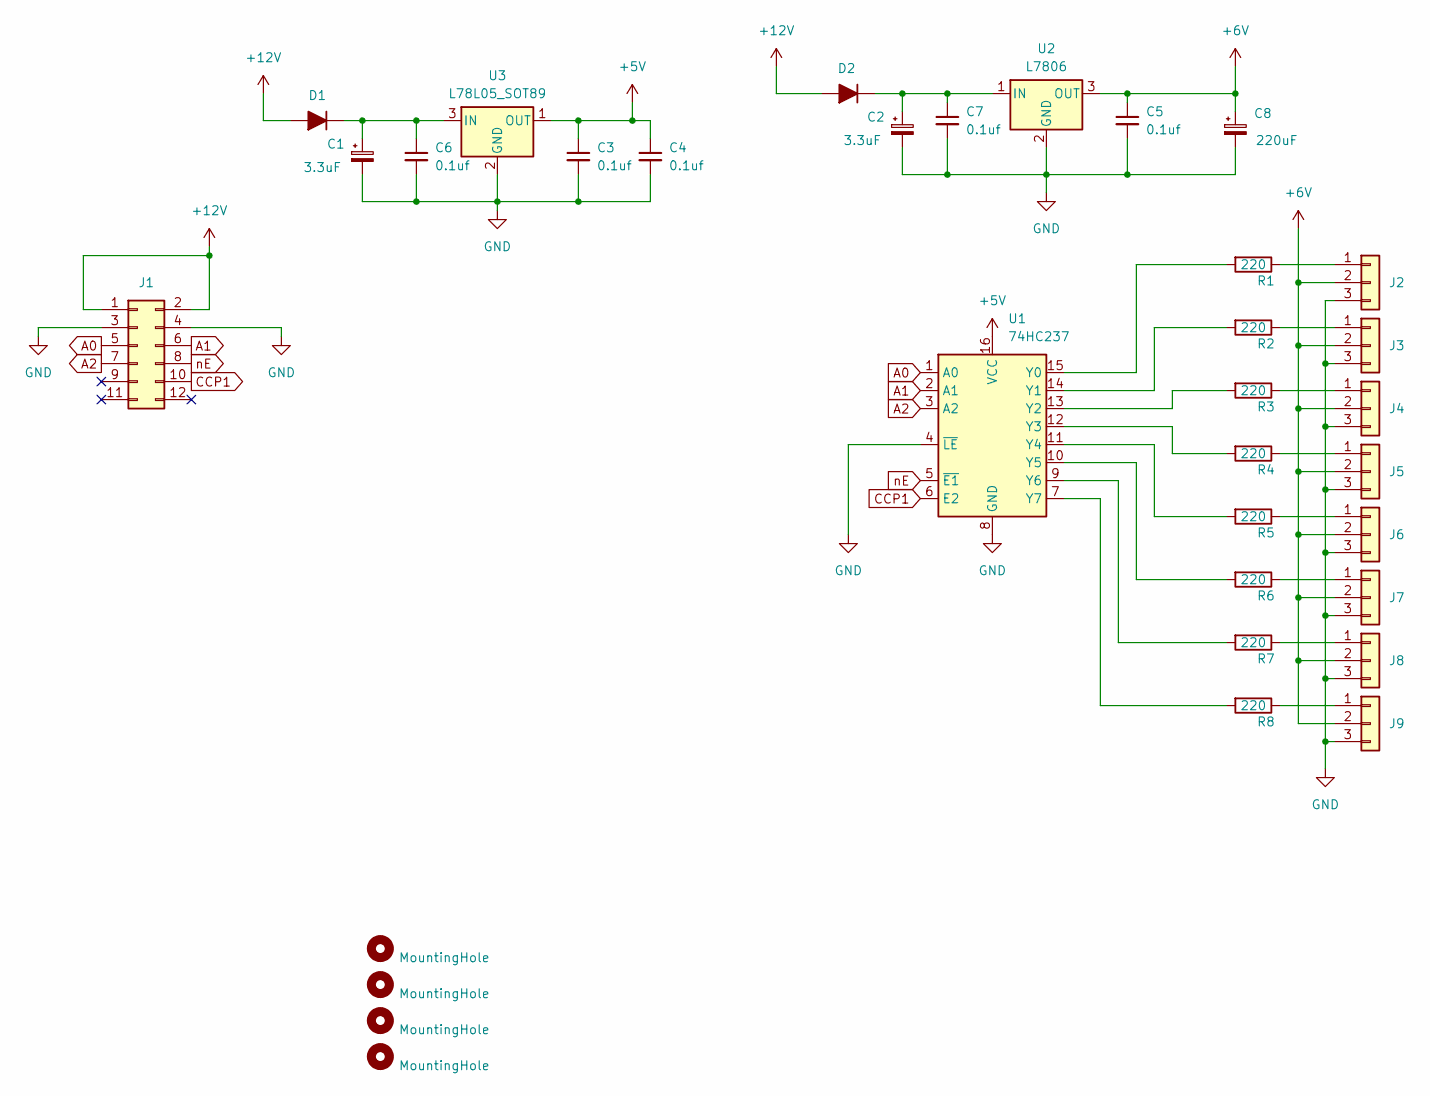
[picture p31: schematic SMRRC_Servo8.kicad_sch, Serial Model Railroad Control]

Parts:
C1, C2: 3.3uF; CP_Radial_D5.0mm_P2.00mm
C3, C4, C5, C6, C7: 0.1uf; C_0805_2012Metric_Pad1.18x1.45mm_HandSolder
C8: 220uF; CP_Radial_D6.3mm_P2.50mm
D1: SMA; D_SMA_Handsoldering
D2: SMB; D_SMB_Handsoldering
H1, H2, H3, H4: MountingHole; MountingHole_3.2mm_M3
J1: Conn_02x06_Odd_Even; PinHeader_2x06_P2.54mm_Vertical
J2, J3, J4, J5, J6, J7, J8, J9: Conn_01x03; PinHeader_1x03_P2.54mm_Horizontal
R1, R2, R3, R4, R5, R6, R7, R8: 220; R_0805_2012Metric_Pad1.20x1.40mm_HandSolder
U1: 74HC237; SOIC-16_3.9x9.9mm_P1.27mm
U2: L7806; TO-263-2
U3: L78L05_SOT89; SOT-89-3

Connections:
+5V: C3.1, C4.1, U1.16 (VCC), U3.1 (OUT)
+6V: C5.1, C8.1, J2.2, J3.2, J4.2, J5.2, J6.2, J7.2, J8.2, J9.2, U2.3 (OUT)
+12V: D1.2 (A), D2.2 (A), J1.1, J1.2
A0: J1.5, U1.1 (A0)
A1: J1.6, U1.2 (A1)
A2: J1.7, U1.3 (A2)
CCP1: J1.10, U1.6 (E2)
GND: C1.2, C2.2, C3.2, C4.2, C5.2, C6.2, C7.2, C8.2, J1.3, J1.4, J2.3, J3.3, J4.3, J5.3, J6.3, J7.3, J8.3, J9.3, U1.4 (~LE), U1.8 (GND), U2.2 (GND), U3.2 (GND)
unnamed: C1.1, C6.1, D1.1 (K), U3.3 (IN)
unnamed: C2.1, C7.1, D2.1 (K), U2.1 (IN)
unnamed: J2.1, R1.1
unnamed: J3.1, R2.1
unnamed: J4.1, R3.1
unnamed: J5.1, R4.1
unnamed: J6.1, R5.1
unnamed: J7.1, R6.1
unnamed: J8.1, R7.1
unnamed: J9.1, R8.1
unnamed: R1.2, U1.15 (Y0)
unnamed: R2.2, U1.14 (Y1)
unnamed: R3.2, U1.13 (Y2)
unnamed: R4.2, U1.12 (Y3)
unnamed: R5.2, U1.11 (Y4)
unnamed: R6.2, U1.10 (Y5)
unnamed: R7.2, U1.9 (Y6)
unnamed: R8.2, U1.7 (Y7)
nE: J1.8, U1.5 (~E1)

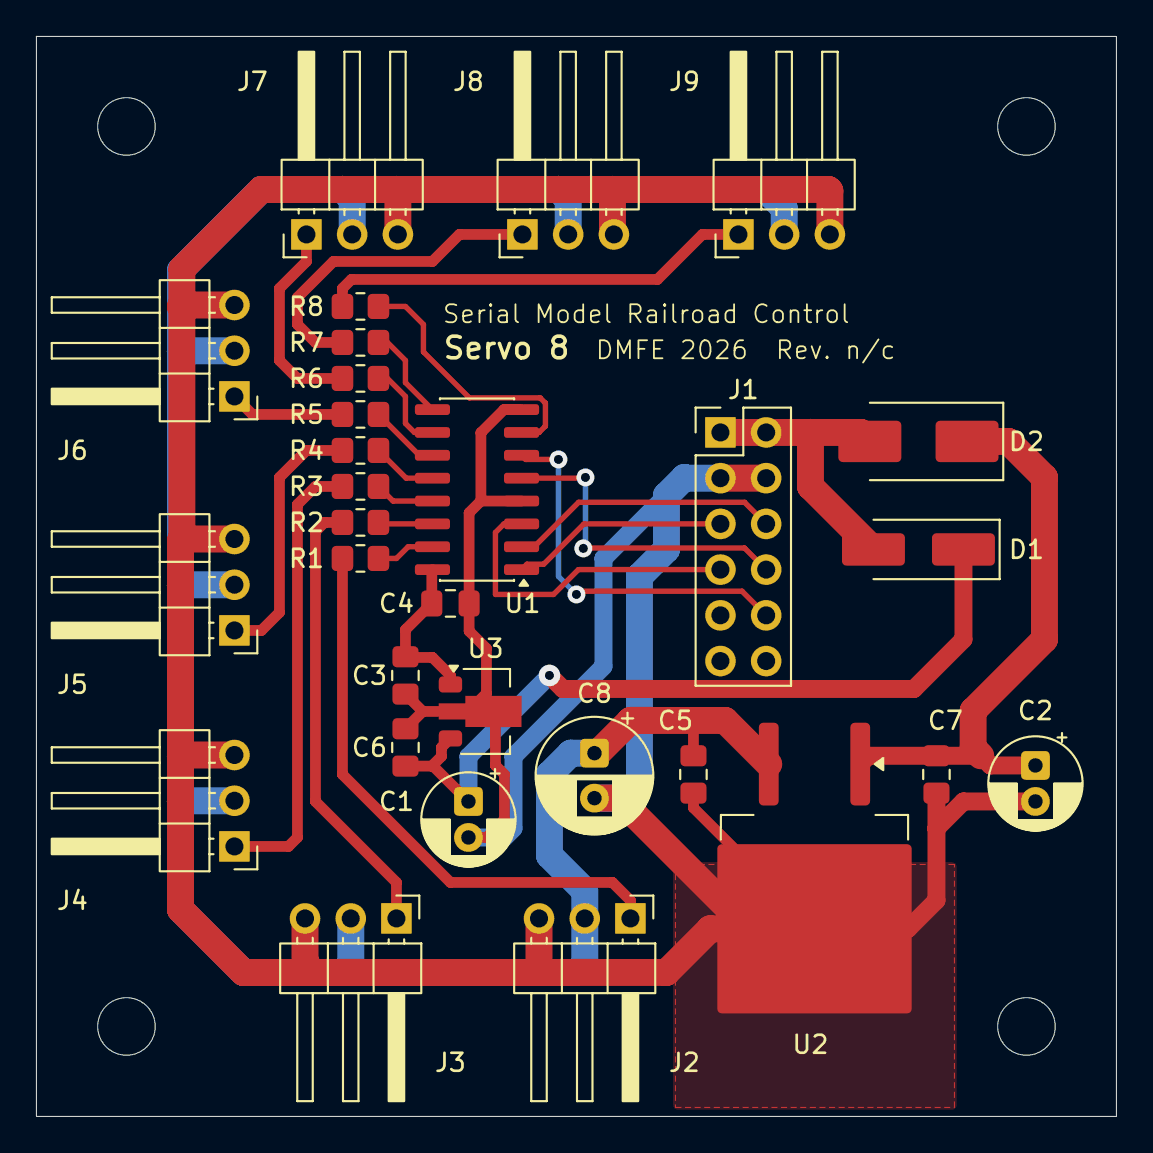
[picture p32: board SMRRC_Servo8.kicad_pcb from above]

Board: 2 copper layers, 60.0 x 60.0 mm, 34 parts (0 on the bottom side), 27 nets.
