DavidMFlynn/SerialMRRC/Output 32 Daughter PCB/Output32DC.kicad_pcb

## KiCad design Output 32 Daughter PCB/Output32DC.kicad_pcb (2026-07-15)

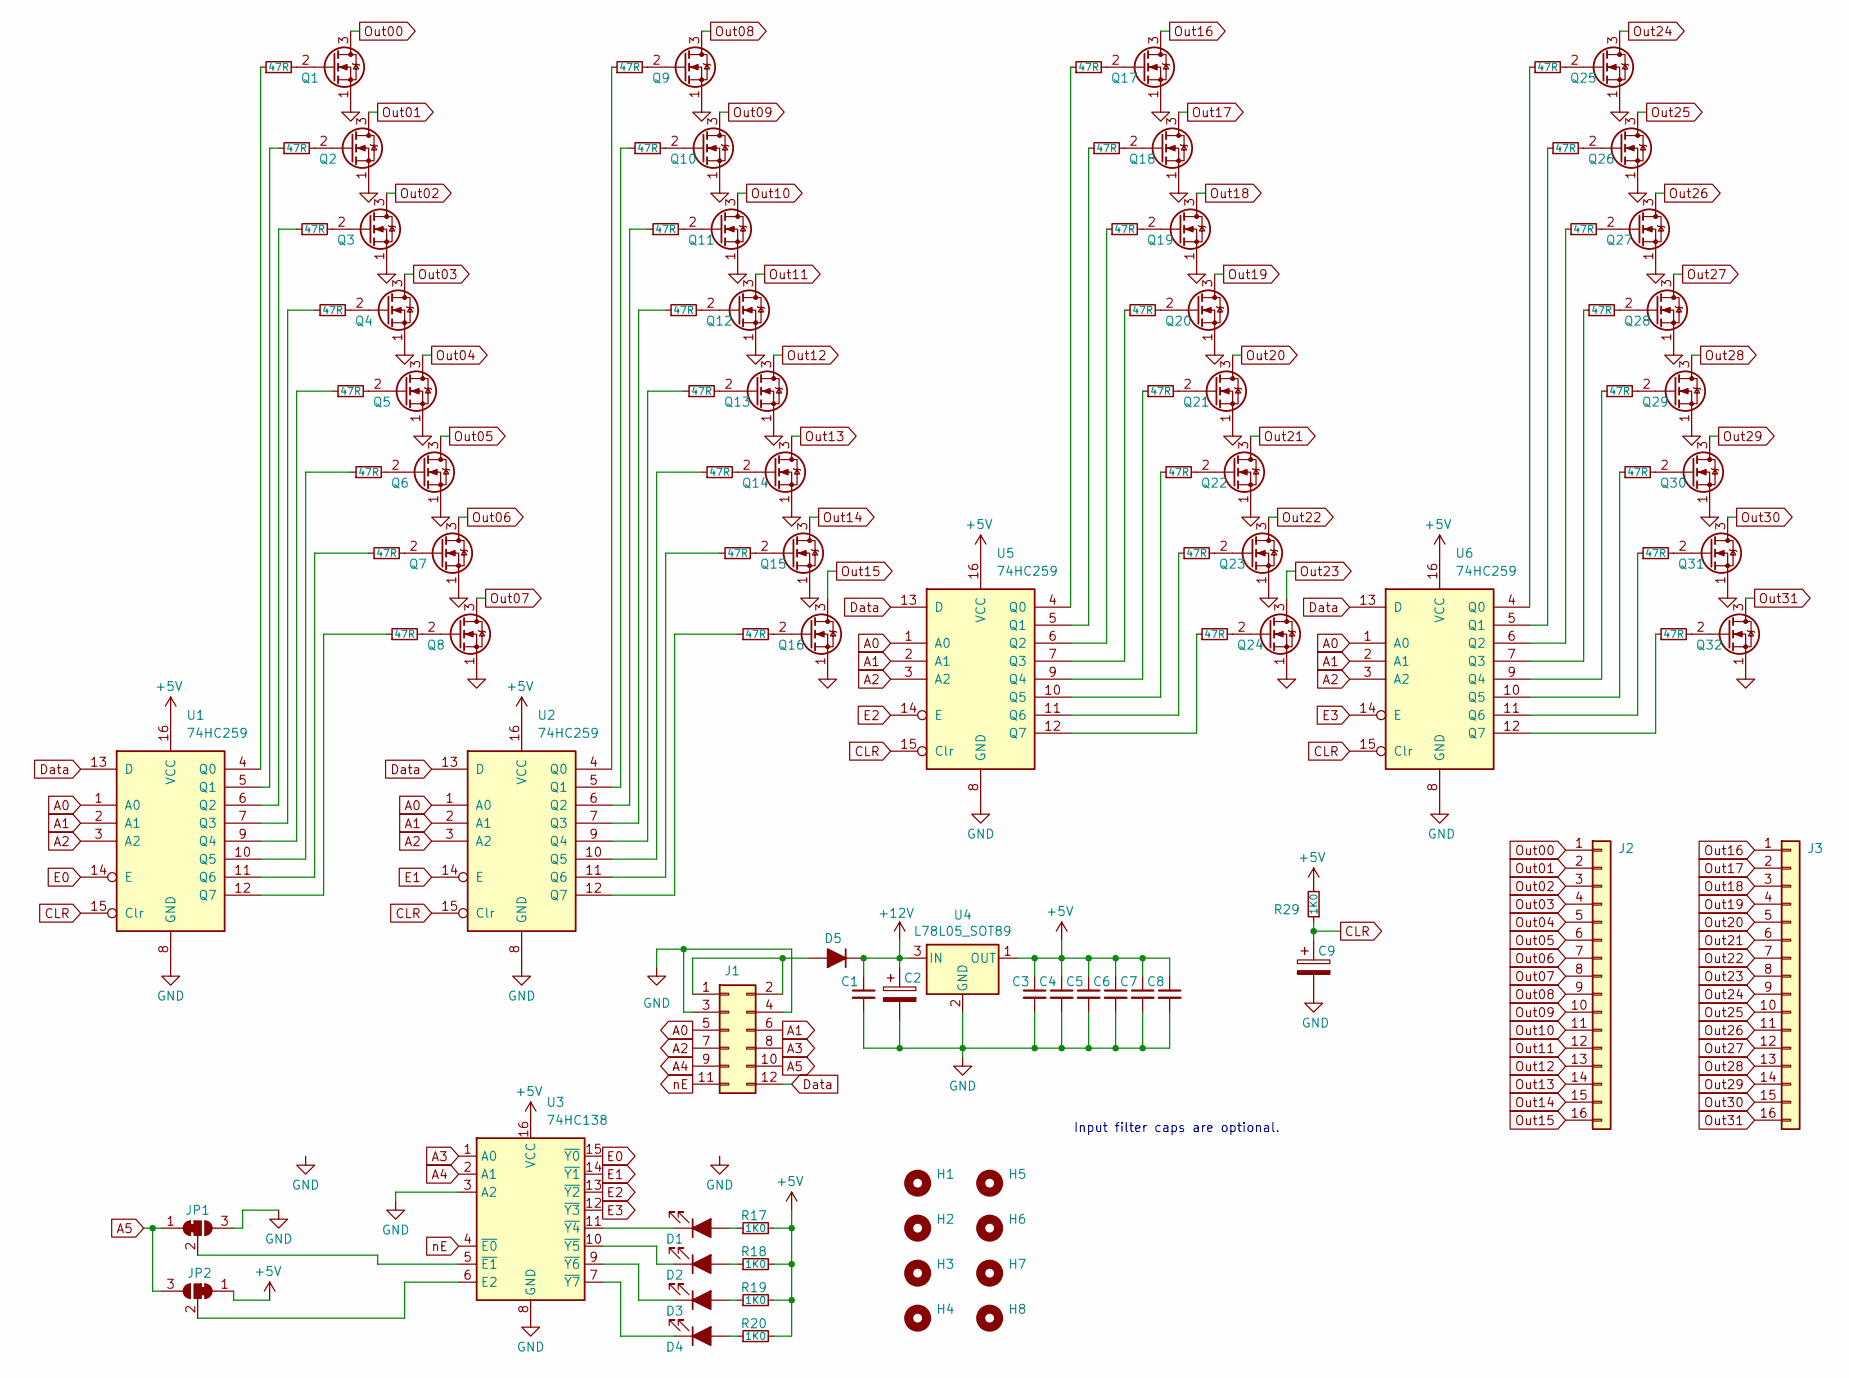
[picture p33: schematic Output32DC.kicad_sch, Serial Model Railroad Control]

Parts:
C1, C3, C4, C5, C6, C7, C8: 0.1uF; C_0805_2012Metric_Pad1.18x1.45mm_HandSolder
C2, C9: 10uF; CP_Radial_D5.0mm_P2.00mm
D1, D2, D3, D4: 1206 LED; LED_1206_3216Metric_Pad1.42x1.75mm_HandSolder
D5: SMA; D_SMA_Handsoldering
H1, H2, H3, H4: MountingHole; MountingHole_4.3mm_M4
H5, H6, H7, H8: MountingHole; MountingHole_3.2mm_M3
J1: Conn_02x06_Odd_Even; PinHeader_2x06_P2.54mm_Vertical
J2, J3: Conn_01x16; TerminalBlock_Phoenix_PT-1,5-16-3.5-H_1x16_P3.50mm_Horizont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
JP1, JP2: SolderJumper_3_Bridged12; SolderJumper-3_P1.3mm_Bridged12_RoundedPad1.0x1.5mm
Q1, Q2, Q3, Q4, Q5, Q6, Q7, Q8, Q9, Q10, Q11, Q12, Q13, Q14, Q15, Q16, Q17, Q18, Q19, Q20, Q21, Q22, Q23, Q24, Q25, Q26, Q27, Q28, Q29, Q30, Q31, Q32: 2N7000; TO-92_Inline
R1, R2, R3, R4, R5, R6, R7, R8, R9, R10, R11, R12, R13, R14, R15, R16, R21, R22, R23, R24, R25, R26, R27, R28, R30, R31, R32, R33, R34, R35, R36, R37: 47R; R_0805_2012Metric_Pad1.20x1.40mm_HandSolder
R17, R18, R19, R20, R29: 1K0; R_0805_2012Metric_Pad1.20x1.40mm_HandSolder
U1, U2, U5, U6: 74HC259; SOIC-16_3.9x9.9mm_P1.27mm
U3: 74HC138; SOIC-16_3.9x9.9mm_P1.27mm
U4: L78L05_SOT89; SOT-89-3

Connections:
+5V: C3.1, C4.1, C5.1, C6.1, C7.1, C8.1, JP2.1 (A), R17.2, R18.2, R19.2, R20.2, R29.2, U1.16 (VCC), U2.16 (VCC), U3.16 (VCC), U4.1 (OUT), U5.16 (VCC), U6.16 (VCC)
+12V: C1.1, C2.1, D5.1 (K), U4.3 (IN)
A0: J1.5, U1.1 (A0), U2.1 (A0), U5.1 (A0), U6.1 (A0)
A1: J1.6, U1.2 (A1), U2.2 (A1), U5.2 (A1), U6.2 (A1)
A2: J1.7, U1.3 (A2), U2.3 (A2), U5.3 (A2), U6.3 (A2)
A3: J1.8, U3.1 (A0)
A4: J1.9, U3.2 (A1)
A5: J1.10, JP1.1 (A), JP2.3 (B)
CLR: C9.1, R29.1, U1.15 (Clr), U2.15 (Clr), U5.15 (Clr), U6.15 (Clr)
Data: J1.12, U1.13 (D), U2.13 (D), U5.13 (D), U6.13 (D)
E0: U1.14 (E), U3.15 (~Y0)
E1: U2.14 (E), U3.14 (~Y1)
E2: U3.13 (~Y2), U5.14 (E)
E3: U3.12 (~Y3), U6.14 (E)
GND: C1.2, C2.2, C3.2, C4.2, C5.2, C6.2, C7.2, C8.2, C9.2, J1.3, J1.4, JP1.3 (B), Q1.1 (S), Q2.1 (S), Q3.1 (S), Q4.1 (S), Q5.1 (S), Q6.1 (S), Q7.1 (S), Q8.1 (S), Q9.1 (S), Q10.1 (S), Q11.1 (S), Q12.1 (S), Q13.1 (S), Q14.1 (S), Q15.1 (S), Q16.1 (S), Q17.1 (S), Q18.1 (S), Q19.1 (S), Q20.1 (S), Q21.1 (S), Q22.1 (S), Q23.1 (S), Q24.1 (S), Q25.1 (S), Q26.1 (S), Q27.1 (S), Q28.1 (S), Q29.1 (S), Q30.1 (S), Q31.1 (S), Q32.1 (S), U1.8 (GND), U2.8 (GND), U3.3 (A2), U3.8 (GND), U4.2 (GND), U5.8 (GND), U6.8 (GND)
unnamed: D1.2 (A), R17.1
unnamed: D1.1 (K), U3.11 (~Y4)
unnamed: D2.2 (A), R18.1
unnamed: D2.1 (K), U3.10 (~Y5)
unnamed: D3.2 (A), R19.1
unnamed: D3.1 (K), U3.9 (~Y6)
unnamed: D4.2 (A), R20.1
unnamed: D4.1 (K), U3.7 (~Y7)
unnamed: D5.2 (A), J1.1, J1.2
unnamed: JP1.2 (C), U3.5 (~E1)
unnamed: JP2.2 (C), U3.6 (E2)
unnamed: Q1.2 (G), R1.2
unnamed: Q2.2 (G), R2.2
unnamed: Q3.2 (G), R3.2
unnamed: Q4.2 (G), R4.2
unnamed: Q5.2 (G), R5.2
unnamed: Q6.2 (G), R6.2
unnamed: Q7.2 (G), R7.2
unnamed: Q8.2 (G), R8.2
unnamed: Q9.2 (G), R9.2
unnamed: Q10.2 (G), R10.2
unnamed: Q11.2 (G), R11.2
unnamed: Q12.2 (G), R12.2
unnamed: Q13.2 (G), R13.2
unnamed: Q14.2 (G), R14.2
unnamed: Q15.2 (G), R15.2
unnamed: Q16.2 (G), R16.2
unnamed: Q17.2 (G), R21.2
unnamed: Q18.2 (G), R22.2
unnamed: Q19.2 (G), R23.2
unnamed: Q20.2 (G), R24.2
unnamed: Q21.2 (G), R25.2
unnamed: Q22.2 (G), R26.2
unnamed: Q23.2 (G), R27.2
unnamed: Q24.2 (G), R28.2
unnamed: Q25.2 (G), R30.2
unnamed: Q26.2 (G), R31.2
unnamed: Q27.2 (G), R32.2
unnamed: Q28.2 (G), R33.2
unnamed: Q29.2 (G), R34.2
unnamed: Q30.2 (G), R35.2
unnamed: Q31.2 (G), R36.2
unnamed: Q32.2 (G), R37.2
unnamed: R1.1, U1.4 (Q0)
unnamed: R2.1, U1.5 (Q1)
unnamed: R3.1, U1.6 (Q2)
unnamed: R4.1, U1.7 (Q3)
unnamed: R5.1, U1.9 (Q4)
unnamed: R6.1, U1.10 (Q5)
unnamed: R7.1, U1.11 (Q6)
unnamed: R8.1, U1.12 (Q7)
unnamed: R9.1, U2.4 (Q0)
unnamed: R10.1, U2.5 (Q1)
unnamed: R11.1, U2.6 (Q2)
unnamed: R12.1, U2.7 (Q3)
unnamed: R13.1, U2.9 (Q4)
unnamed: R14.1, U2.10 (Q5)
unnamed: R15.1, U2.11 (Q6)
unnamed: R16.1, U2.12 (Q7)
unnamed: R21.1, U5.4 (Q0)
unnamed: R22.1, U5.5 (Q1)
unnamed: R23.1, U5.6 (Q2)
unnamed: R24.1, U5.7 (Q3)
unnamed: R25.1, U5.9 (Q4)
unnamed: R26.1, U5.10 (Q5)
unnamed: R27.1, U5.11 (Q6)
unnamed: R28.1, U5.12 (Q7)
unnamed: R30.1, U6.4 (Q0)
unnamed: R31.1, U6.5 (Q1)
unnamed: R32.1, U6.6 (Q2)
unnamed: R33.1, U6.7 (Q3)
unnamed: R34.1, U6.9 (Q4)
unnamed: R35.1, U6.10 (Q5)
unnamed: R36.1, U6.11 (Q6)
unnamed: R37.1, U6.12 (Q7)
Out00: J2.1, Q1.3 (D)
Out01: J2.2, Q2.3 (D)
Out02: J2.3, Q3.3 (D)
Out03: J2.4, Q4.3 (D)
Out04: J2.5, Q5.3 (D)
Out05: J2.6, Q6.3 (D)
Out06: J2.7, Q7.3 (D)
Out07: J2.8, Q8.3 (D)
Out08: J2.9, Q9.3 (D)
Out09: J2.10, Q10.3 (D)
Out10: J2.11, Q11.3 (D)
Out11: J2.12, Q12.3 (D)
Out12: J2.13, Q13.3 (D)
Out13: J2.14, Q14.3 (D)
Out14: J2.15, Q15.3 (D)
Out15: J2.16, Q16.3 (D)
Out16: J3.1, Q17.3 (D)
Out17: J3.2, Q18.3 (D)
Out18: J3.3, Q19.3 (D)
Out19: J3.4, Q20.3 (D)
Out20: J3.5, Q21.3 (D)
Out21: J3.6, Q22.3 (D)
Out22: J3.7, Q23.3 (D)
Out23: J3.8, Q24.3 (D)
Out24: J3.9, Q25.3 (D)
Out25: J3.10, Q26.3 (D)
Out26: J3.11, Q27.3 (D)
Out27: J3.12, Q28.3 (D)
Out28: J3.13, Q29.3 (D)
Out29: J3.14, Q30.3 (D)
Out30: J3.15, Q31.3 (D)
Out31: J3.16, Q32.3 (D)
nE: J1.11, U3.4 (~E0)

Notes on the sheet:
Input filter caps are optional.

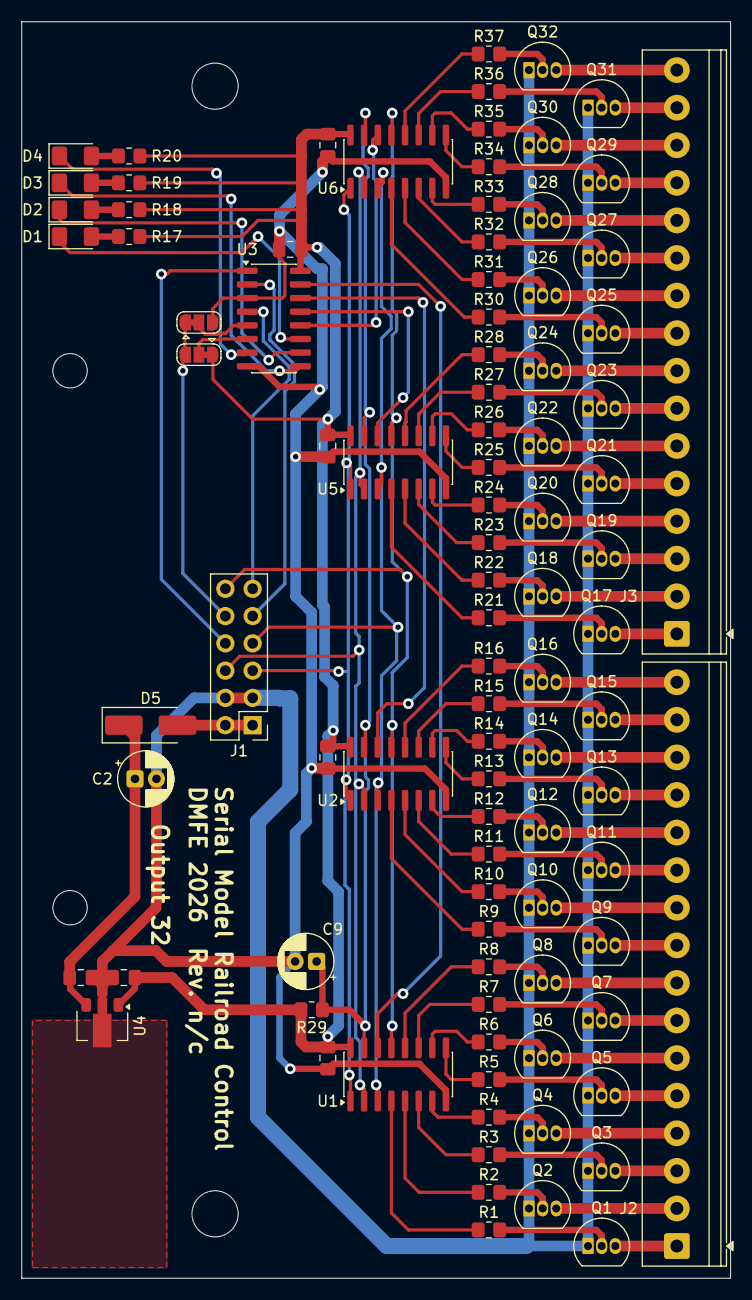
[picture p34: board Output32DC.kicad_pcb from above]

Board: 2 copper layers, 66.0 x 117.0 mm, 98 parts (0 on the bottom side), 123 nets.
