DavidMFlynn/SerialMRRC/Input 32 Daughter PCB/Input32DC.kicad_pcb

## KiCad design Input 32 Daughter PCB/Input32DC.kicad_pcb (2026-07-14)

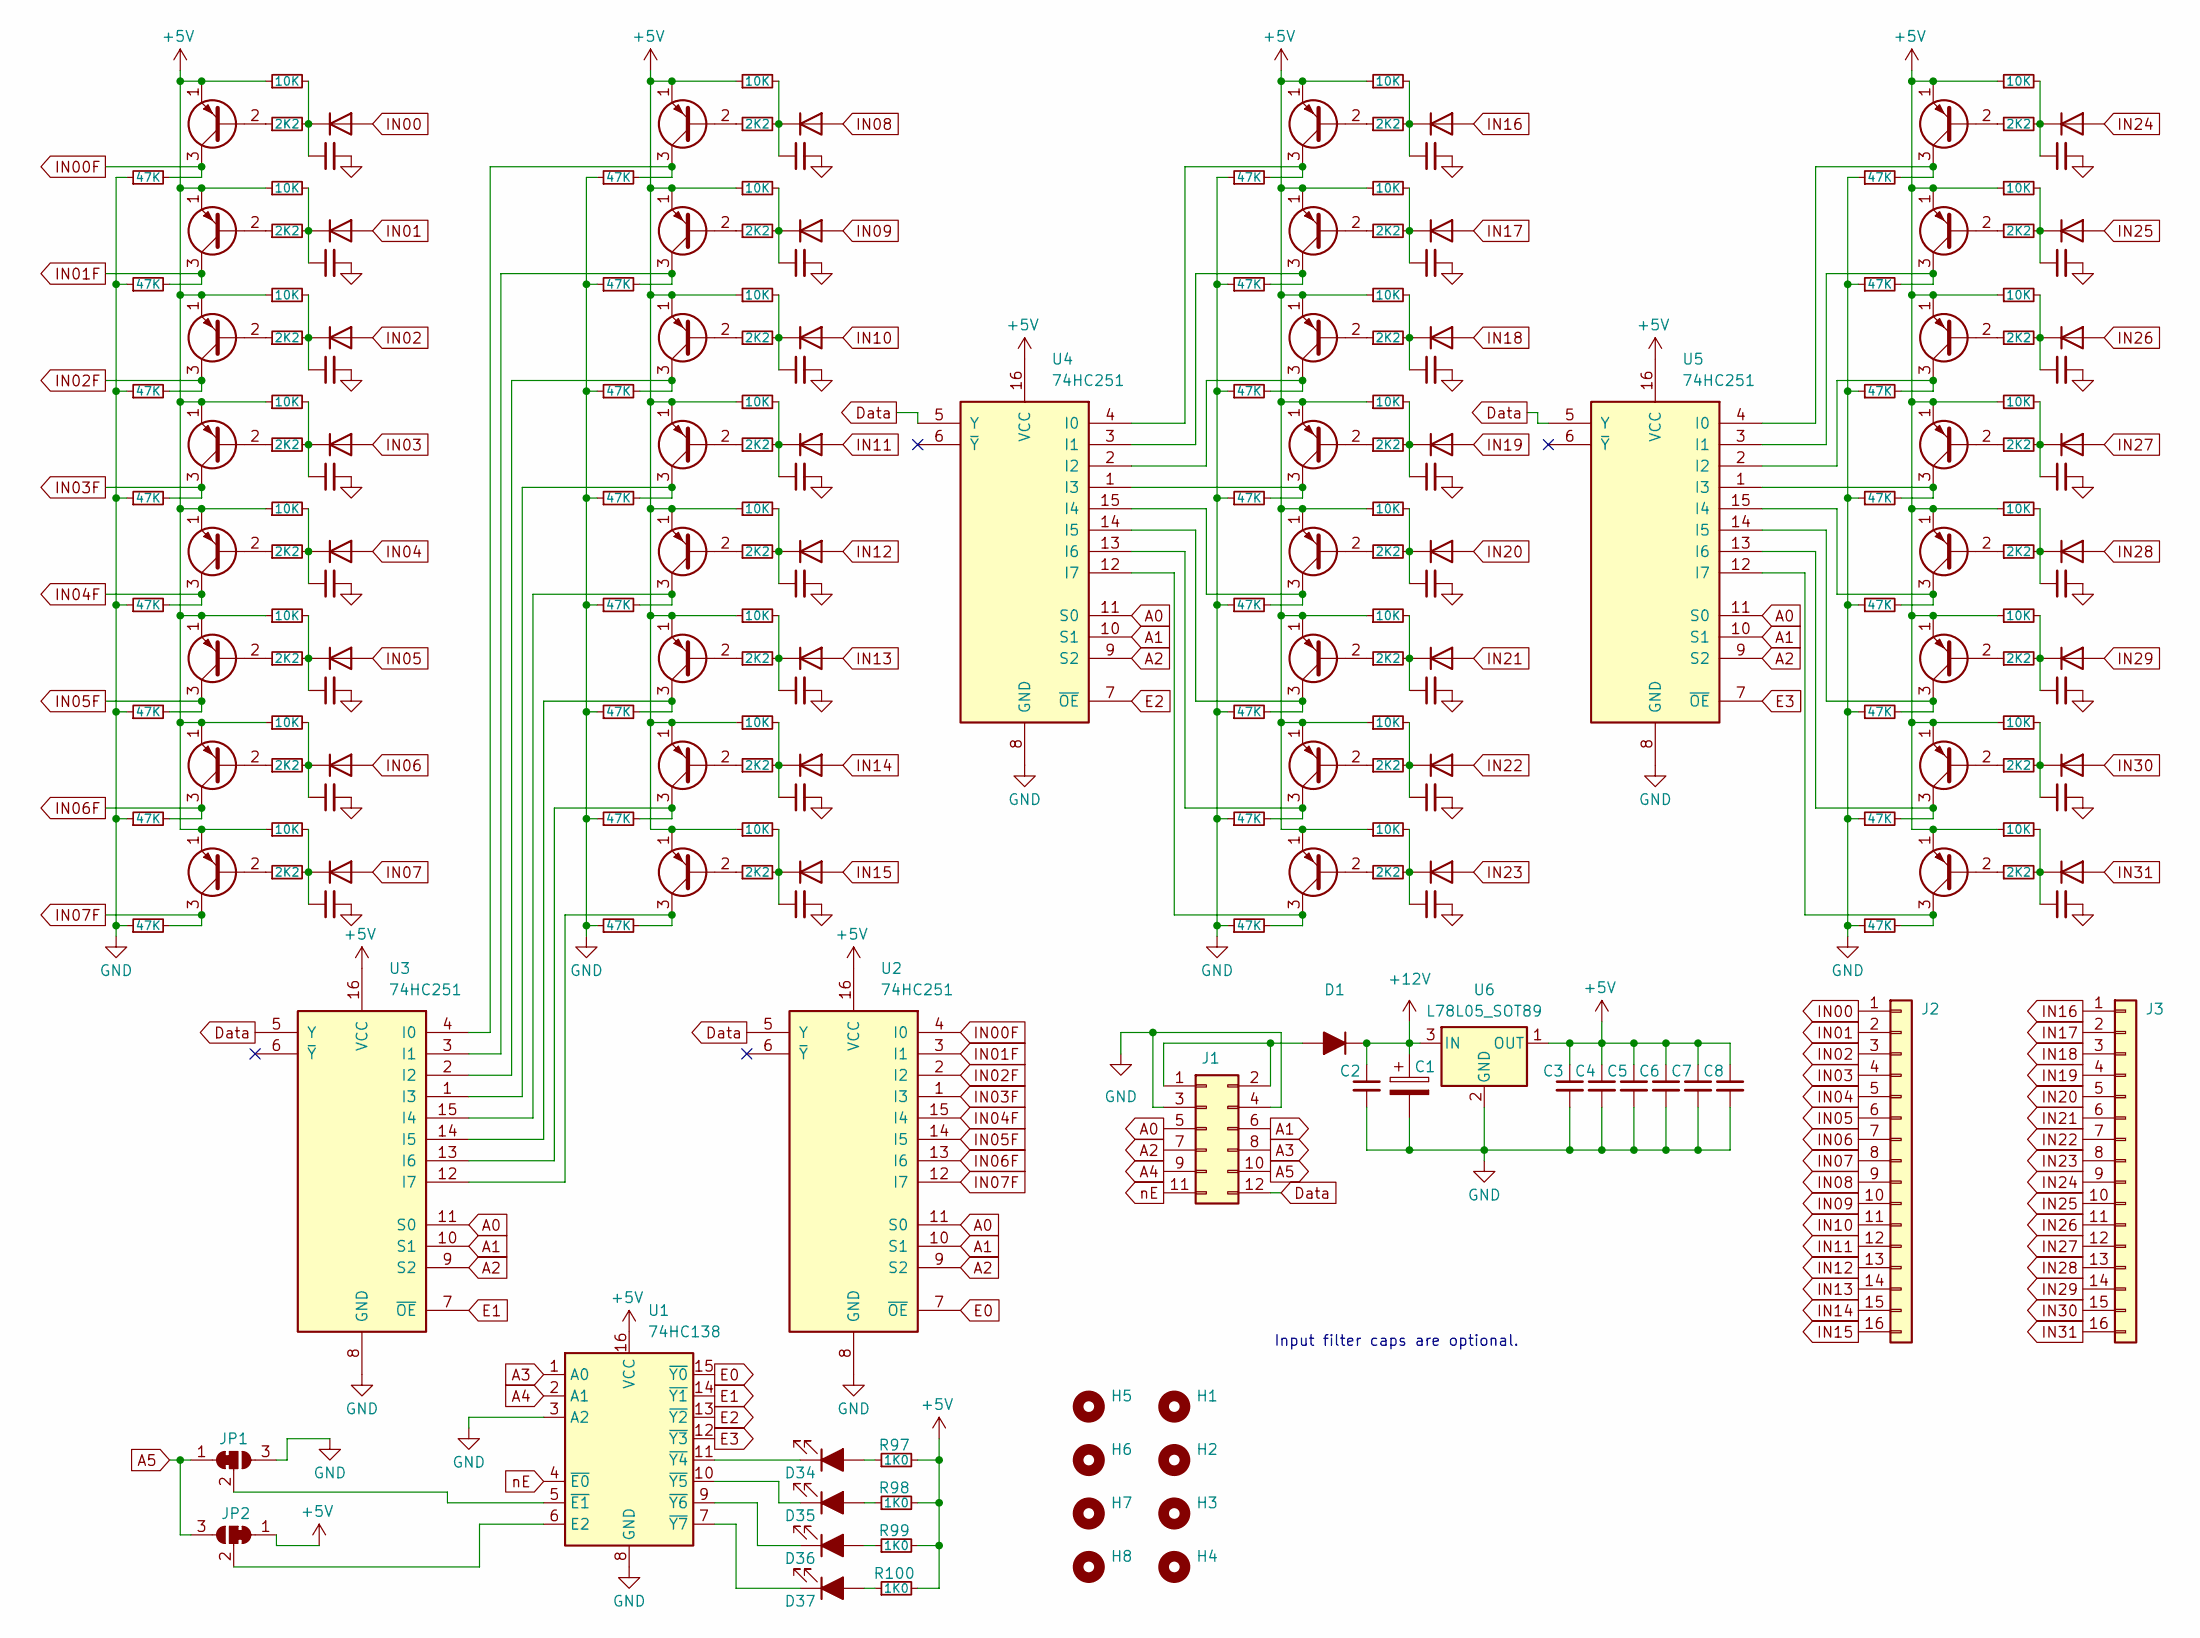
[picture p35: schematic Input32DC.kicad_sch, Serial Model Railroad Control]

Parts:
C1: 10uF; CP_Radial_D5.0mm_P2.00mm
C2, C3, C4, C5, C6, C7, C8, C9, C10, C11, C12, C13, C14, C15, C16, C17, C18, C19, C20, C21, C22, C23, C24, C25, C26, C27, C28, C29, C30, C31, C32, C33, C34, C35, C36, C37, C38, C39, C40: 0.1uF; C_0805_2012Metric_Pad1.18x1.45mm_HandSolder
D1: SMA; D_SMA_Handsoldering
D2, D3, D4, D5, D6, D7, D8, D9, D10, D11, D12, D13, D14, D15, D16, D17, D18, D19, D20, D21, D22, D23, D24, D25, D26, D27, D28, D29, D30, D31, D32, D33: 1N4148W; D_SOD-123
D34, D35, D36, D37: 1206 LED; LED_1206_3216Metric_Pad1.42x1.75mm_HandSolder
H1, H2, H3, H4: MountingHole; MountingHole_3.2mm_M3
H5, H6, H7, H8: MountingHole; MountingHole_4.3mm_M4
J1: Conn_02x06_Odd_Even; PinHeader_2x06_P2.54mm_Vertical
J2, J3: Conn_01x16; TerminalBlock_Phoenix_PT-1,5-16-3.5-H_1x16_P3.50mm_Horizont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
JP1, JP2: SolderJumper_3_Bridged12; SolderJumper-3_P1.3mm_Bridged12_RoundedPad1.0x1.5mm
Q2, Q3, Q4, Q5, Q6, Q7, Q8, Q9, Q10, Q11, Q12, Q13, Q14, Q15, Q16, Q17, Q18, Q19, Q20, Q21, Q22, Q23, Q24, Q25, Q26, Q27, Q28, Q29, Q30, Q31, Q32, Q33: 2N3906; TO-92_Inline
R1, R6, R9, R12, R15, R18, R21, R24, R34, R36, R38, R40, R42, R44, R46, R48, R58, R60, R62, R64, R66, R68, R70, R72, R82, R84, R86, R88, R90, R92, R94, R96: 2K2; R_0805_2012Metric_Pad1.20x1.40mm_HandSolder
R2, R5, R8, R11, R14, R17, R20, R23, R33, R35, R37, R39, R41, R43, R45, R47, R57, R59, R61, R63, R65, R67, R69, R71, R81, R83, R85, R87, R89, R91, R93, R95: 10K; R_0805_2012Metric_Pad1.20x1.40mm_HandSolder
R3, R4, R7, R10, R13, R16, R19, R22, R25, R26, R27, R28, R29, R30, R31, R32, R49, R50, R51, R52, R53, R54, R55, R56, R73, R74, R75, R76, R77, R78, R79, R80: 47K; R_0805_2012Metric_Pad1.20x1.40mm_HandSolder
R97, R98, R99, R100: 1K0; R_0805_2012Metric_Pad1.20x1.40mm_HandSolder
U1: 74HC138; SOIC-16_3.9x9.9mm_P1.27mm
U2, U3, U4, U5: 74HC251; SOIC-16_3.9x9.9mm_P1.27mm
U6: L78L05_SOT89; SOT-89-3

Connections:
+5V: C3.1, C4.1, C5.1, C6.1, C7.1, C8.1, JP2.1 (A), Q2.1 (E), Q3.1 (E), Q4.1 (E), Q5.1 (E), Q6.1 (E), Q7.1 (E), Q8.1 (E), Q9.1 (E), Q10.1 (E), Q11.1 (E), Q12.1 (E), Q13.1 (E), Q14.1 (E), Q15.1 (E), Q16.1 (E), Q17.1 (E), Q18.1 (E), Q19.1 (E), Q20.1 (E), Q21.1 (E), Q22.1 (E), Q23.1 (E), Q24.1 (E), Q25.1 (E), Q26.1 (E), Q27.1 (E), Q28.1 (E), Q29.1 (E), Q30.1 (E), Q31.1 (E), Q32.1 (E), Q33.1 (E), R2.1, R5.1, R8.1, R11.1, R14.1, R17.1, R20.1, R23.1, R33.1, R35.1, R37.1, R39.1, R41.1, R43.1, R45.1, R47.1, R57.1, R59.1, R61.1, R63.1, R65.1, R67.1, R69.1, R71.1, R81.1, R83.1, R85.1, R87.1, R89.1, R91.1, R93.1, R95.1, R97.2, R98.2, R99.2, R100.2, U1.16 (VCC), U2.16 (VCC), U3.16 (VCC), U4.16 (VCC), U5.16 (VCC), U6.1 (OUT)
+12V: C1.1, C2.1, D1.1 (K), U6.3 (IN)
A0: J1.5, U2.11 (S0), U3.11 (S0), U4.11 (S0), U5.11 (S0)
A1: J1.6, U2.10 (S1), U3.10 (S1), U4.10 (S1), U5.10 (S1)
A2: J1.7, U2.9 (S2), U3.9 (S2), U4.9 (S2), U5.9 (S2)
A3: J1.8, U1.1 (A0)
A4: J1.9, U1.2 (A1)
A5: J1.10, JP1.1 (A), JP2.3 (B)
Data: J1.12, U2.5 (Y), U3.5 (Y), U4.5 (Y), U5.5 (Y)
E0: U1.15 (~Y0), U2.7 (~OE)
E1: U1.14 (~Y1), U3.7 (~OE)
E2: U1.13 (~Y2), U4.7 (~OE)
E3: U1.12 (~Y3), U5.7 (~OE)
GND: C1.2, C2.2, C3.2, C4.2, C5.2, C6.2, C7.2, C8.2, C9.2, C10.2, C11.2, C12.2, C13.2, C14.2, C15.2, C16.2, C17.2, C18.2, C19.2, C20.2, C21.2, C22.2, C23.2, C24.2, C25.2, C26.2, C27.2, C28.2, C29.2, C30.2, C31.2, C32.2, C33.2, C34.2, C35.2, C36.2, C37.2, C38.2, C39.2, C40.2, J1.3, J1.4, JP1.3 (B), R3.1, R4.1, R7.1, R10.1, R13.1, R16.1, R19.1, R22.1, R25.1, R26.1, R27.1, R28.1, R29.1, R30.1, R31.1, R32.1, R49.1, R50.1, R51.1, R52.1, R53.1, R54.1, R55.1, R56.1, R73.1, R74.1, R75.1, R76.1, R77.1, R78.1, R79.1, R80.1, U1.3 (A2), U1.8 (GND), U2.8 (GND), U3.8 (GND), U4.8 (GND), U5.8 (GND), U6.2 (GND)
IN00: D26.2 (A), J2.1
IN00F: Q26.3 (C), R73.2, U2.4 (I0)
IN01: D27.2 (A), J2.2
IN01F: Q27.3 (C), R74.2, U2.3 (I1)
IN02: D28.2 (A), J2.3
IN02F: Q28.3 (C), R75.2, U2.2 (I2)
IN03: D29.2 (A), J2.4
IN03F: Q29.3 (C), R76.2, U2.1 (I3)
IN04: D30.2 (A), J2.5
IN04F: Q30.3 (C), R77.2, U2.15 (I4)
IN05: D31.2 (A), J2.6
IN05F: Q31.3 (C), R78.2, U2.14 (I5)
IN06: D32.2 (A), J2.7
IN06F: Q32.3 (C), R79.2, U2.13 (I6)
IN07: D33.2 (A), J2.8
IN07F: Q33.3 (C), R80.2, U2.12 (I7)
IN08: D18.2 (A), J2.9
IN09: D19.2 (A), J2.10
IN10: D20.2 (A), J2.11
IN11: D21.2 (A), J2.12
IN12: D22.2 (A), J2.13
IN13: D23.2 (A), J2.14
IN14: D24.2 (A), J2.15
IN15: D25.2 (A), J2.16
IN16: D10.2 (A), J3.1
IN17: D11.2 (A), J3.2
IN18: D12.2 (A), J3.3
IN19: D13.2 (A), J3.4
IN20: D14.2 (A), J3.5
IN21: D15.2 (A), J3.6
IN22: D16.2 (A), J3.7
IN23: D17.2 (A), J3.8
IN24: D2.2 (A), J3.9
IN25: D3.2 (A), J3.10
IN26: D4.2 (A), J3.11
IN27: D5.2 (A), J3.12
IN28: D6.2 (A), J3.13
IN29: D7.2 (A), J3.14
IN30: D8.2 (A), J3.15
IN31: D9.2 (A), J3.16
unnamed: D1.2 (A), J1.1, J1.2
unnamed: C9.1, D2.1 (K), R1.2, R2.2
unnamed: C10.1, D3.1 (K), R5.2, R6.2
unnamed: C11.1, D4.1 (K), R8.2, R9.2
unnamed: C12.1, D5.1 (K), R11.2, R12.2
unnamed: C13.1, D6.1 (K), R14.2, R15.2
unnamed: C14.1, D7.1 (K), R17.2, R18.2
unnamed: C15.1, D8.1 (K), R20.2, R21.2
unnamed: C16.1, D9.1 (K), R23.2, R24.2
unnamed: C17.1, D10.1 (K), R33.2, R34.2
unnamed: C18.1, D11.1 (K), R35.2, R36.2
unnamed: C19.1, D12.1 (K), R37.2, R38.2
unnamed: C20.1, D13.1 (K), R39.2, R40.2
unnamed: C21.1, D14.1 (K), R41.2, R42.2
unnamed: C22.1, D15.1 (K), R43.2, R44.2
unnamed: C23.1, D16.1 (K), R45.2, R46.2
unnamed: C24.1, D17.1 (K), R47.2, R48.2
unnamed: C25.1, D18.1 (K), R57.2, R58.2
unnamed: C26.1, D19.1 (K), R59.2, R60.2
unnamed: C27.1, D20.1 (K), R61.2, R62.2
unnamed: C28.1, D21.1 (K), R63.2, R64.2
unnamed: C29.1, D22.1 (K), R65.2, R66.2
unnamed: C30.1, D23.1 (K), R67.2, R68.2
unnamed: C31.1, D24.1 (K), R69.2, R70.2
unnamed: C32.1, D25.1 (K), R71.2, R72.2
unnamed: C33.1, D26.1 (K), R81.2, R82.2
unnamed: C34.1, D27.1 (K), R83.2, R84.2
unnamed: C35.1, D28.1 (K), R85.2, R86.2
unnamed: C36.1, D29.1 (K), R87.2, R88.2
unnamed: C37.1, D30.1 (K), R89.2, R90.2
unnamed: C38.1, D31.1 (K), R91.2, R92.2
unnamed: C39.1, D32.1 (K), R93.2, R94.2
unnamed: C40.1, D33.1 (K), R95.2, R96.2
unnamed: D34.2 (A), R97.1
unnamed: D34.1 (K), U1.11 (~Y4)
unnamed: D35.2 (A), R98.1
unnamed: D35.1 (K), U1.10 (~Y5)
unnamed: D36.2 (A), R99.1
unnamed: D36.1 (K), U1.9 (~Y6)
unnamed: D37.2 (A), R100.1
unnamed: D37.1 (K), U1.7 (~Y7)
unnamed: JP1.2 (C), U1.5 (~E1)
unnamed: JP2.2 (C), U1.6 (E2)
unnamed: Q2.2 (B), R1.1
unnamed: Q2.3 (C), R3.2, U5.4 (I0)
unnamed: Q3.2 (B), R6.1
unnamed: Q3.3 (C), R4.2, U5.3 (I1)
unnamed: Q4.2 (B), R9.1
unnamed: Q4.3 (C), R7.2, U5.2 (I2)
unnamed: Q5.2 (B), R12.1
unnamed: Q5.3 (C), R10.2, U5.1 (I3)
unnamed: Q6.2 (B), R15.1
unnamed: Q6.3 (C), R13.2, U5.15 (I4)
unnamed: Q7.2 (B), R18.1
unnamed: Q7.3 (C), R16.2, U5.14 (I5)
unnamed: Q8.2 (B), R21.1
unnamed: Q8.3 (C), R19.2, U5.13 (I6)
unnamed: Q9.2 (B), R24.1
unnamed: Q9.3 (C), R22.2, U5.12 (I7)
unnamed: Q10.2 (B), R34.1
unnamed: Q10.3 (C), R25.2, U4.4 (I0)
unnamed: Q11.2 (B), R36.1
unnamed: Q11.3 (C), R26.2, U4.3 (I1)
unnamed: Q12.2 (B), R38.1
unnamed: Q12.3 (C), R27.2, U4.2 (I2)
unnamed: Q13.2 (B), R40.1
unnamed: Q13.3 (C), R28.2, U4.1 (I3)
unnamed: Q14.2 (B), R42.1
unnamed: Q14.3 (C), R29.2, U4.15 (I4)
unnamed: Q15.2 (B), R44.1
unnamed: Q15.3 (C), R30.2, U4.14 (I5)
unnamed: Q16.2 (B), R46.1
unnamed: Q16.3 (C), R31.2, U4.13 (I6)
unnamed: Q17.2 (B), R48.1
unnamed: Q17.3 (C), R32.2, U4.12 (I7)
unnamed: Q18.2 (B), R58.1
unnamed: Q18.3 (C), R49.2, U3.4 (I0)
unnamed: Q19.2 (B), R60.1
unnamed: Q19.3 (C), R50.2, U3.3 (I1)
unnamed: Q20.2 (B), R62.1
unnamed: Q20.3 (C), R51.2, U3.2 (I2)
unnamed: Q21.2 (B), R64.1
unnamed: Q21.3 (C), R52.2, U3.1 (I3)
unnamed: Q22.2 (B), R66.1
unnamed: Q22.3 (C), R53.2, U3.15 (I4)
unnamed: Q23.2 (B), R68.1
unnamed: Q23.3 (C), R54.2, U3.14 (I5)
unnamed: Q24.2 (B), R70.1
unnamed: Q24.3 (C), R55.2, U3.13 (I6)
unnamed: Q25.2 (B), R72.1
unnamed: Q25.3 (C), R56.2, U3.12 (I7)
unnamed: Q26.2 (B), R82.1
unnamed: Q27.2 (B), R84.1
unnamed: Q28.2 (B), R86.1
unnamed: Q29.2 (B), R88.1
unnamed: Q30.2 (B), R90.1
unnamed: Q31.2 (B), R92.1
unnamed: Q32.2 (B), R94.1
unnamed: Q33.2 (B), R96.1
nE: J1.11, U1.4 (~E0)

Notes on the sheet:
Input filter caps are optional.

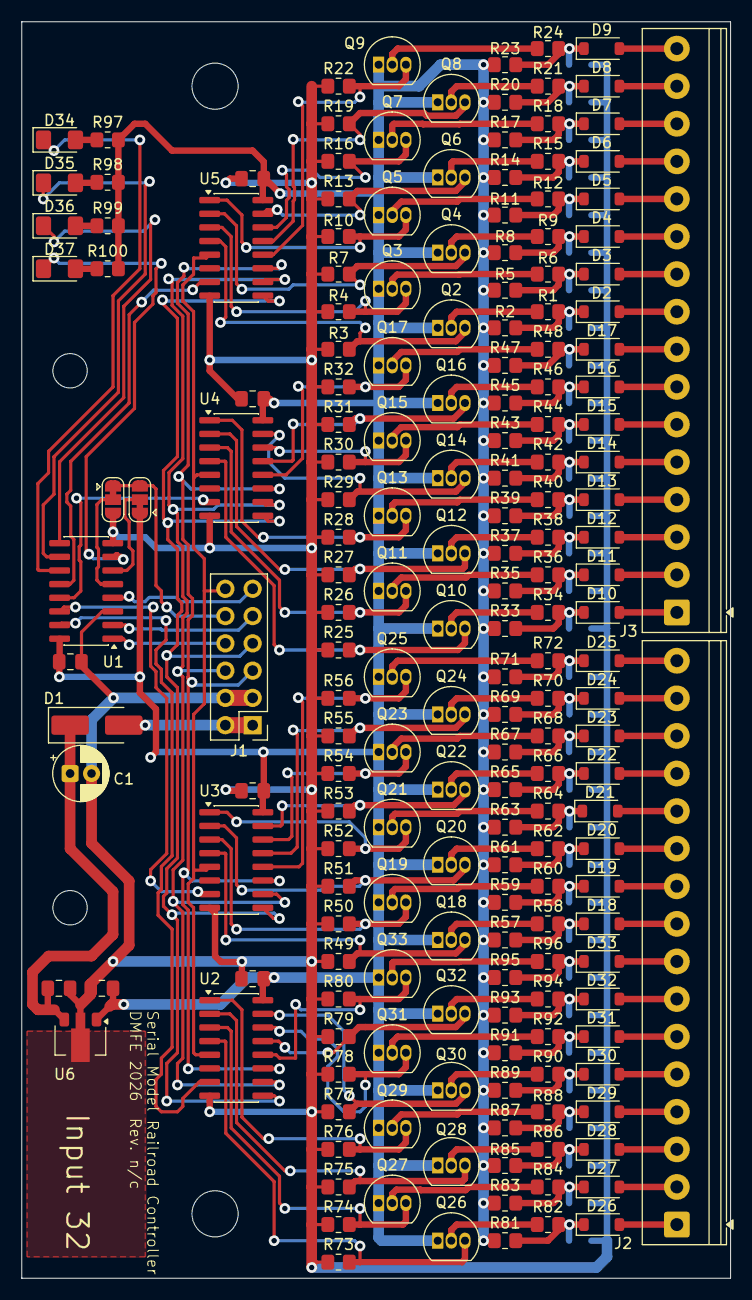
[picture p36: board Input32DC.kicad_pcb from above]

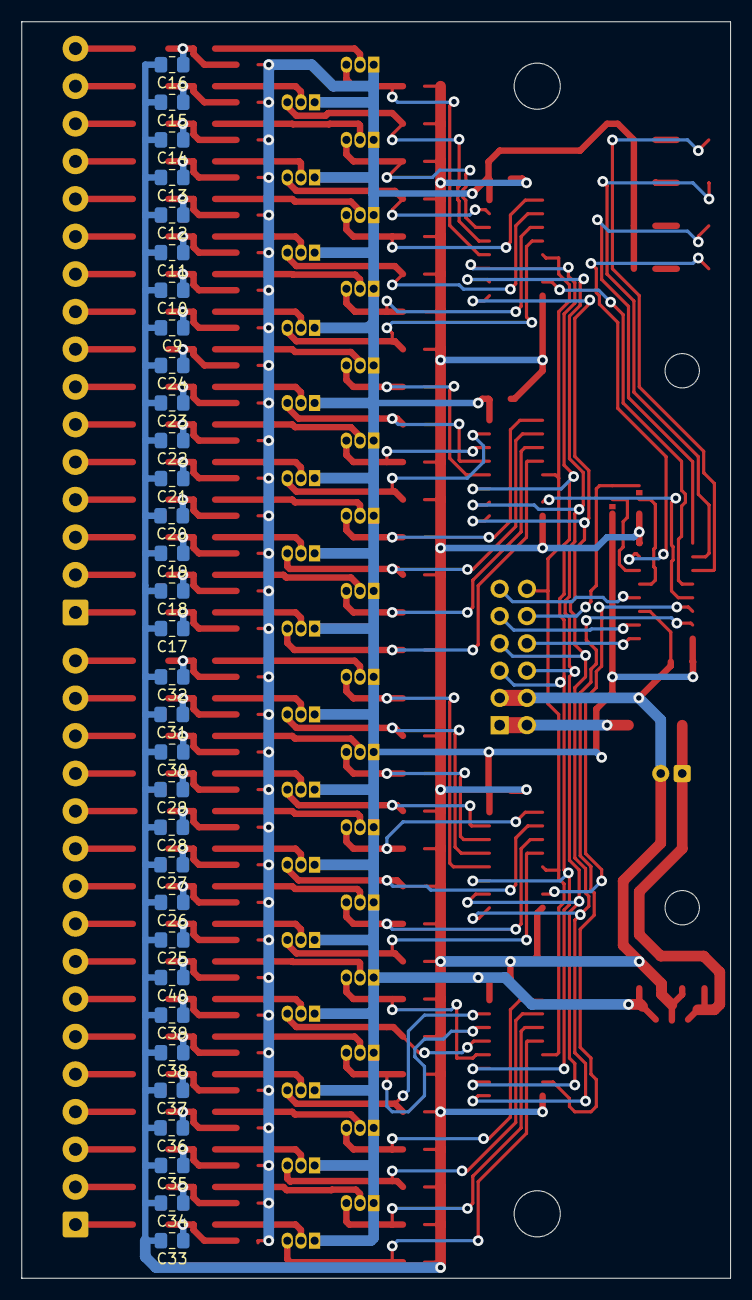
[picture p37: board Input32DC.kicad_pcb from below]

Board: 2 copper layers, 66.0 x 117.0 mm, 224 parts (32 on the bottom side), 154 nets.
