DavidMFlynn/SerialMRRC/Switch Machine PCB/SMRRC_Switch.kicad_pcb

## KiCad design Switch Machine PCB/SMRRC_Switch.kicad_pcb (2026-07-11)

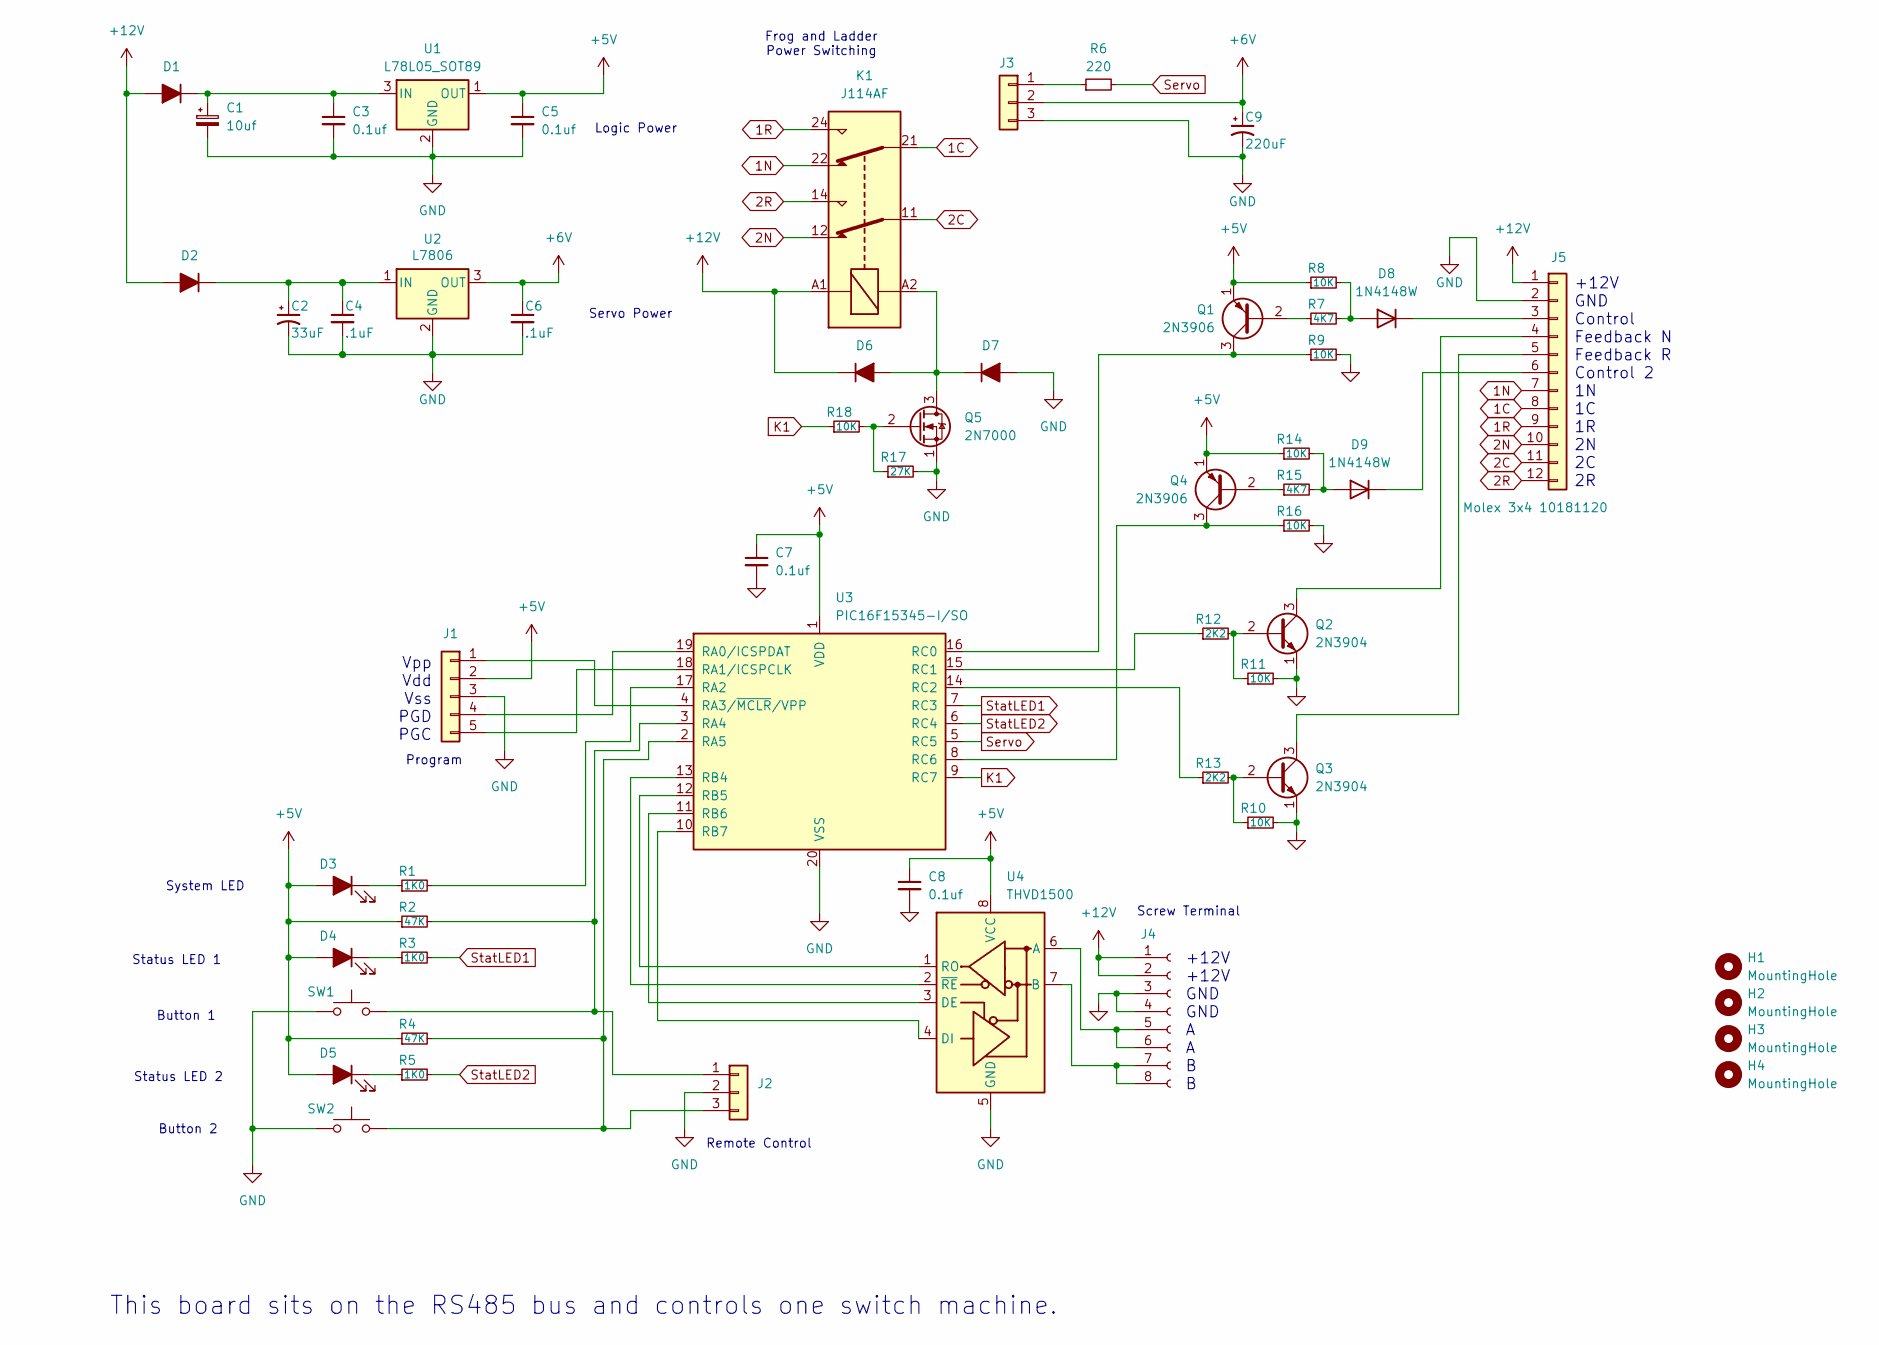
[picture p38: schematic SMRRC_Switch.kicad_sch, Serial Model Railroad Control]

Parts:
C1: 10uf; CP_Radial_D4.0mm_P2.00mm
C2: 33uF; CP_Radial_D5.0mm_P2.00mm
C3, C5, C7, C8: 0.1uf; C_0805_2012Metric_Pad1.18x1.45mm_HandSolder
C4, C6: .1uF; C_0805_2012Metric_Pad1.18x1.45mm_HandSolder
C9: 220uF; CP_Radial_D6.3mm_P2.50mm
D1, D2, D6, D7: SMA; D_SMA_Handsoldering
D3, D4, D5: LED_Filled; D_1206_3216Metric_Pad1.42x1.75mm_HandSolder
D8, D9: 1N4148W; D_SOD-123
H1, H2, H3, H4: MountingHole; MountingHole_3.2mm_M3
J1: Conn_01x05; PinHeader_1x05_P2.54mm_Vertical
J2: Conn_01x03; PinSocket_1x03_P2.54mm_Vertical
J3: Conn_01x03; PinHeader_1x03_P2.54mm_Vertical
J4: Conn_01x08_Socket; TerminalBlock_MaiXu_MX126-5.0-08P_1x08_P5.00mm
J5: Molex 3x4 10181120; Molex10181120
K1: J114AF; Relay_DPDT_Finder_40.52
Q1, Q4: 2N3906; TO-92_Inline
Q2, Q3: 2N3904; TO-92_Inline
Q5: 2N7000; TO-92_Inline
R1, R3, R5: 1K0; R_0805_2012Metric_Pad1.20x1.40mm_HandSolder
R2, R4: 47K; R_0805_2012Metric_Pad1.20x1.40mm_HandSolder
R6: 220; R_0805_2012Metric_Pad1.20x1.40mm_HandSolder
R7, R15: 4K7; R_0805_2012Metric_Pad1.20x1.40mm_HandSolder
R8, R9, R10, R11, R14, R16, R18: 10K; R_0805_2012Metric_Pad1.20x1.40mm_HandSolder
R12, R13: 2K2; R_0805_2012Metric_Pad1.20x1.40mm_HandSolder
R17: 27K; R_0805_2012Metric_Pad1.20x1.40mm_HandSolder
SW1, SW2: SW_Push; SW_SPST_PTS645
U1: L78L05_SOT89; SOT-89-3
U2: L7806; TO-263-2
U3: PIC16F15345-I/SO; SOIC-20W_7.5x12.8mm_P1.27mm
U4: THVD1500; SOIC-8_3.9x4.9mm_P1.27mm

Connections:
1C: J5.8, K1.21
1N: J5.7, K1.22
1R: J5.9, K1.24
2C: J5.11, K1.11
2N: J5.10, K1.12
2R: J5.12, K1.14
+5V: C5.1, C7.1, C8.1, D3.2 (A), D4.2 (A), D5.2 (A), J1.2, Q1.1 (E), Q4.1 (E), R2.1, R4.1, R8.1, R14.1, U1.1 (OUT), U3.1 (VDD), U4.8 (VCC)
+6V: C6.1, C9.1, J3.2, U2.3 (OUT)
+12V: D1.2 (A), D2.2 (A), D6.1 (K), J4.1, J4.2, J5.1, K1.A1
GND: C1.2, C2.2, C3.2, C4.2, C5.2, C6.2, C7.2, C8.2, C9.2, D7.2 (A), J1.3, J2.2, J3.3, J4.3, J4.4, J5.2, Q2.1 (E), Q3.1 (E), Q5.1 (S), R9.2, R10.2, R11.2, R16.2, R17.2, SW1.1, SW2.1, U1.2 (GND), U2.2 (GND), U3.20 (VSS), U4.5 (GND)
K1: R18.1, U3.9 (RC7)
unnamed: C1.1, C3.1, D1.1 (K), U1.3 (IN)
unnamed: C2.1, C4.1, D2.1 (K), U2.1 (IN)
unnamed: D3.1 (K), R1.1
unnamed: D4.1 (K), R3.1
unnamed: D5.1 (K), R5.1
unnamed: D6.2 (A), D7.1 (K), K1.A2, Q5.3 (D)
unnamed: D8.2 (A), R7.2, R8.2
unnamed: D8.1 (K), J5.3
unnamed: D9.2 (A), R14.2, R15.2
unnamed: D9.1 (K), J5.6
unnamed: J1.1, U3.4 (RA3/~MCLR/VPP)
unnamed: J1.4, U3.19 (RA0/ICSPDAT)
unnamed: J1.5, U3.18 (RA1/ICSPCLK)
unnamed: J2.1, R2.2, SW1.2, U3.3 (RA4)
unnamed: J2.3, R4.2, SW2.2, U3.2 (RA5)
unnamed: J3.1, R6.1
unnamed: J4.5, J4.6, U4.6 (A)
unnamed: J4.7, J4.8, U4.7 (B)
unnamed: J5.4, Q2.3 (C)
unnamed: J5.5, Q3.3 (C)
unnamed: Q1.2 (B), R7.1
unnamed: Q1.3 (C), R9.1, U3.16 (RC0)
unnamed: Q2.2 (B), R11.1, R12.2
unnamed: Q3.2 (B), R10.1, R13.2
unnamed: Q4.2 (B), R15.1
unnamed: Q4.3 (C), R16.1, U3.8 (RC6)
unnamed: Q5.2 (G), R17.1, R18.2
unnamed: R1.2, U3.17 (RA2)
unnamed: U3.13 (RB4), U4.2 (~RE)
unnamed: U3.12 (RB5), U4.1 (RO)
unnamed: U3.11 (RB6), U4.3 (DE)
unnamed: U3.10 (RB7), U4.4 (DI)
unnamed: R12.1, U3.15 (RC1)
unnamed: R13.1, U3.14 (RC2)
Servo: R6.2, U3.5 (RC5)
StatLED1: R3.2, U3.7 (RC3)
StatLED2: R5.2, U3.6 (RC4)

Notes on the sheet:
Servo Power
Remote Control
Vpp Vdd Vss PGD PGC
Button 2
Screw Terminal
Program
+12V +12V GND GND A A B B
Status LED 2
Button 1
Frog and Ladder Power Switching
Status LED 1
This board sits on the RS485 bus and controls one switch machine.
Logic Power
System LED
+12V GND Control Feedback N Feedback R Control 2 1N 1C 1R 2N 2C 2R

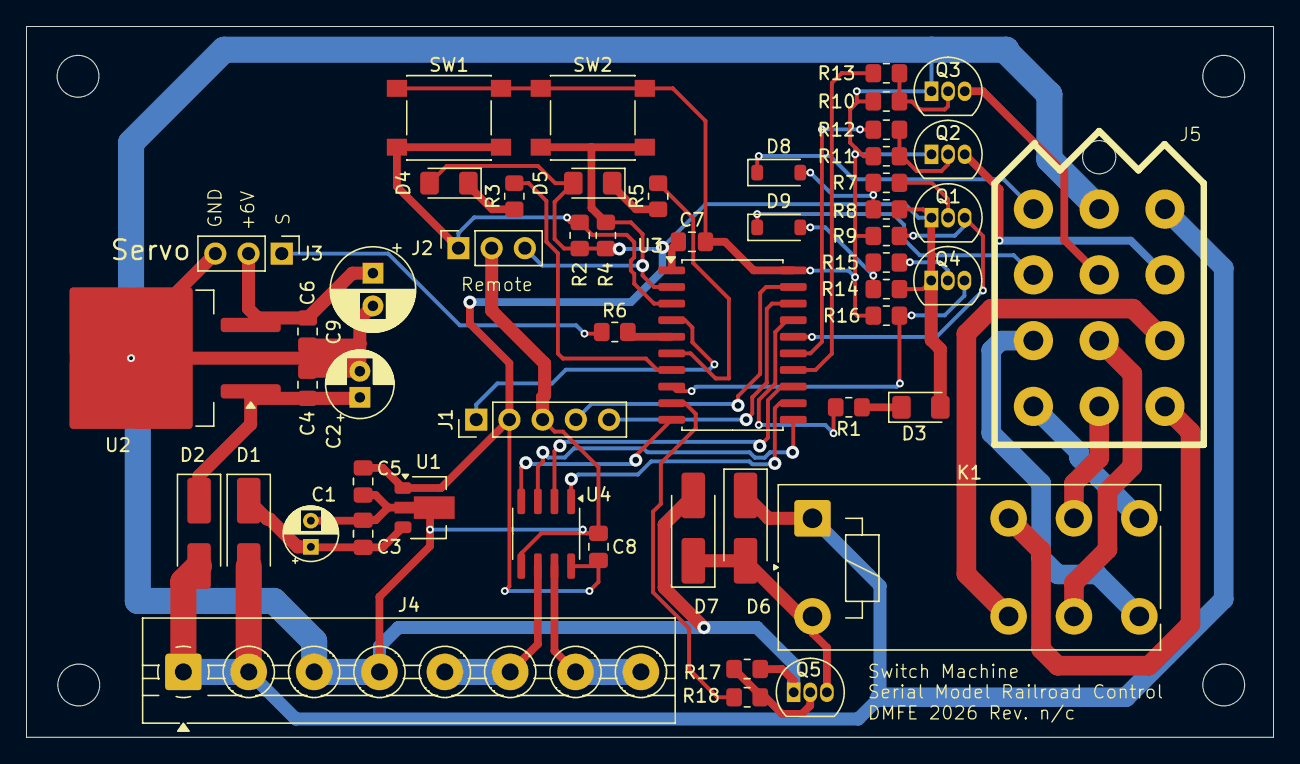
[picture p39: board SMRRC_Switch.kicad_pcb from above]

Board: 2 copper layers, 95.4 x 54.4 mm, 57 parts (0 on the bottom side), 48 nets.
