DavidMFlynn/SerialMRRC/Switch Machine and Signal PCB/SMRRC_SwitchAndSignal.kicad_pcb

## KiCad design Switch Machine and Signal PCB/SMRRC_SwitchAndSignal.kicad_pcb (2025-03-27)

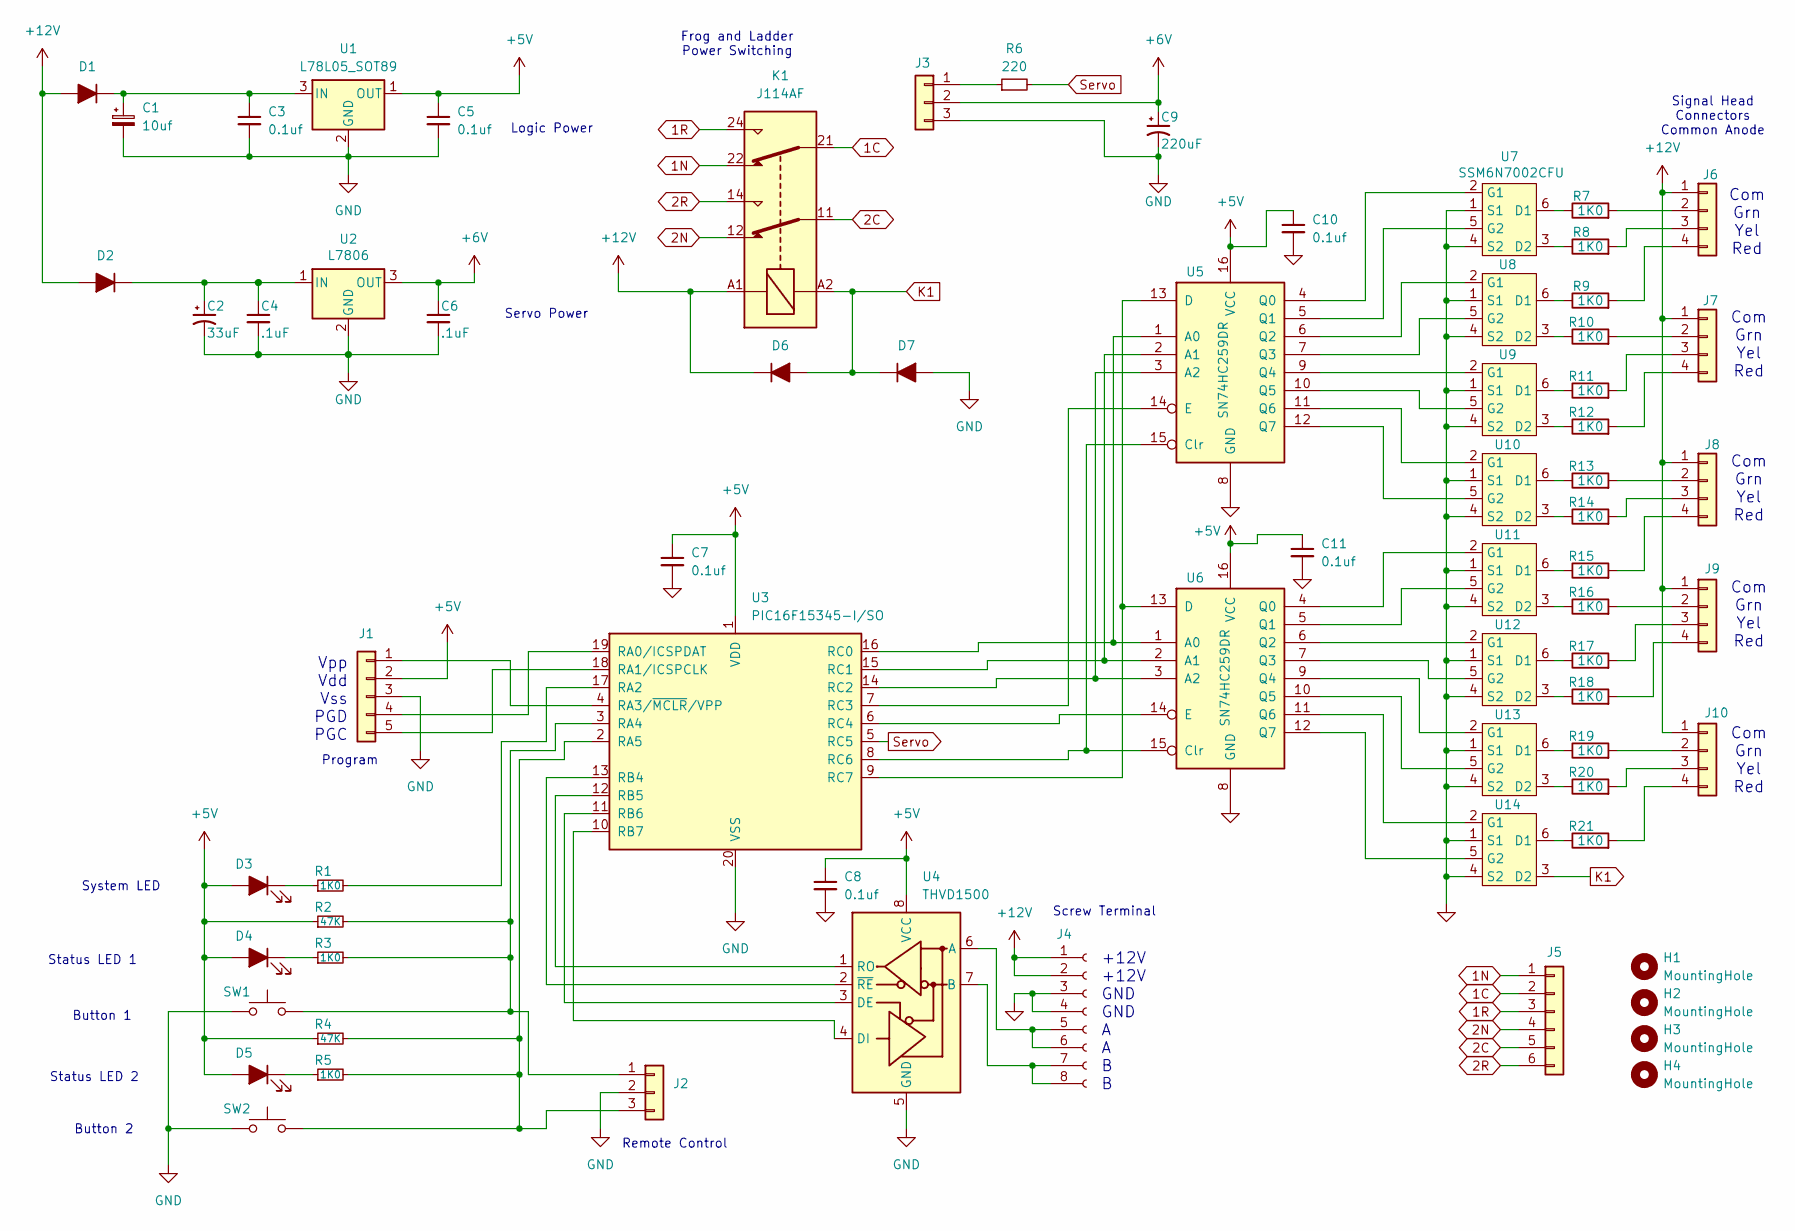
[picture p40: schematic SMRRC_SwitchAndSignal.kicad_sch, Serial Model Railroad Control]

Parts:
C1: 10uf; CP_Radial_D4.0mm_P2.00mm
C2: 33uF; CP_Radial_D5.0mm_P2.00mm
C3, C5, C7, C8, C10, C11: 0.1uf; C_0805_2012Metric_Pad1.18x1.45mm_HandSolder
C4, C6: .1uF; C_0805_2012Metric_Pad1.18x1.45mm_HandSolder
C9: 220uF; CP_Radial_D6.3mm_P2.50mm
D1, D2, D6, D7: SMA; D_SMA_Handsoldering
D3, D4, D5: LED_Filled; D_1206_3216Metric_Pad1.42x1.75mm_HandSolder
H1, H2, H3, H4: MountingHole; MountingHole_3.2mm_M3
J1: Conn_01x05; PinHeader_1x05_P2.54mm_Vertical
J2: Conn_01x03; PinSocket_1x03_P2.54mm_Vertical
J3: Conn_01x03; PinHeader_1x03_P2.54mm_Vertical
J4: Conn_01x08_Socket; TerminalBlock_MaiXu_MX126-5.0-08P_1x08_P5.00mm
J5: Conn_01x06; TerminalBlock_MetzConnect_Type059_RT06306HBWC_1x06_P3.50mm_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
J6, J7, J8, J9, J10: Conn_01x04; TerminalBlock_Phoenix_PT-1,5-4-3.5-H_1x04_P3.50mm_Horizontal
K1: J114AF; Relay_DPDT_Finder_40.52
R1, R3, R5: 1K0; R_0805_2012Metric_Pad1.20x1.40mm_HandSolder
R2, R4: 47K; R_0805_2012Metric_Pad1.20x1.40mm_HandSolder
R6: 220; R_0805_2012Metric_Pad1.20x1.40mm_HandSolder
R7, R8, R9, R10, R11, R12, R13, R14, R15, R16, R17, R18, R19, R20, R21: 1K0; R_Axial_DIN0204_L3.6mm_D1.6mm_P7.62mm_Horizontal
SW1, SW2: SW_Push; SW_SPST_PTS645
U1: L78L05_SOT89; SOT-89-3
U2: L7806; TO-263-2
U3: PIC16F15345-I/SO; SOIC-20W_7.5x12.8mm_P1.27mm
U4: THVD1500; SOIC-8_3.9x4.9mm_P1.27mm
U5, U6: SN74HC259DR; SOIC-16W_5.3x10.2mm_P1.27mm
U7, U8, U9, U10, U11, U12, U13, U14: SSM6N7002CFU; SOT-363_SC-70-6_Handsoldering

Connections:
1C: J5.2, K1.21
1N: J5.1, K1.22
1R: J5.3, K1.24
2C: J5.5, K1.11
2N: J5.4, K1.12
2R: J5.6, K1.14
+5V: C5.1, C7.1, C8.1, C10.1, C11.1, D3.2 (A), D4.2 (A), D5.2 (A), J1.2, R2.1, R4.1, U1.1 (OUT), U3.1 (VDD), U4.8 (VCC), U5.16 (VCC), U6.16 (VCC)
+6V: C6.1, C9.1, J3.2, U2.3 (OUT)
+12V: D1.2 (A), D2.2 (A), D6.1 (K), J4.1, J4.2, J6.1, J7.1, J8.1, J9.1, J10.1, K1.A1
GND: C1.2, C2.2, C3.2, C4.2, C5.2, C6.2, C7.2, C8.2, C9.2, C10.2, C11.2, D7.2 (A), J1.3, J2.2, J3.3, J4.3, J4.4, SW1.1, SW2.1, U1.2 (GND), U2.2 (GND), U3.20 (VSS), U4.5 (GND), U5.8 (GND), U6.8 (GND), U7.1 (S1), U7.4 (S2), U8.1 (S1), U8.4 (S2), U9.1 (S1), U9.4 (S2), U10.1 (S1), U10.4 (S2), U11.1 (S1), U11.4 (S2), U12.1 (S1), U12.4 (S2), U13.1 (S1), U13.4 (S2), U14.1 (S1), U14.4 (S2)
K1: D6.2 (A), D7.1 (K), K1.A2, U14.3 (D2)
unnamed: C1.1, C3.1, D1.1 (K), U1.3 (IN)
unnamed: C2.1, C4.1, D2.1 (K), U2.1 (IN)
unnamed: D3.1 (K), R1.1
unnamed: D4.1 (K), R3.1
unnamed: D5.1 (K), R5.1
unnamed: J1.1, U3.4 (RA3/~MCLR/VPP)
unnamed: J1.4, U3.19 (RA0/ICSPDAT)
unnamed: J1.5, U3.18 (RA1/ICSPCLK)
unnamed: J2.1, R2.2, R3.2, SW1.2, U3.3 (RA4)
unnamed: J2.3, R4.2, R5.2, SW2.2, U3.2 (RA5)
unnamed: J3.1, R6.1
unnamed: J4.5, J4.6, U4.6 (A)
unnamed: J4.7, J4.8, U4.7 (B)
unnamed: J6.2, R7.2
unnamed: J6.3, R8.2
unnamed: J6.4, R9.2
unnamed: J7.2, R10.2
unnamed: J7.3, R11.2
unnamed: J7.4, R12.2
unnamed: J8.2, R13.2
unnamed: J8.3, R14.2
unnamed: J8.4, R15.2
unnamed: J9.2, R16.2
unnamed: J9.3, R17.2
unnamed: J9.4, R18.2
unnamed: J10.2, R19.2
unnamed: J10.3, R20.2
unnamed: J10.4, R21.2
unnamed: R1.2, U3.17 (RA2)
unnamed: U3.13 (RB4), U4.2 (~RE)
unnamed: U3.12 (RB5), U4.1 (RO)
unnamed: U3.11 (RB6), U4.3 (DE)
unnamed: U3.10 (RB7), U4.4 (DI)
unnamed: U3.16 (RC0), U5.1 (A0), U6.1 (A0)
unnamed: U3.15 (RC1), U5.2 (A1), U6.2 (A1)
unnamed: U3.14 (RC2), U5.3 (A2), U6.3 (A2)
unnamed: U3.7 (RC3), U5.14 (E)
unnamed: U3.6 (RC4), U6.14 (E)
unnamed: U3.8 (RC6), U5.15 (Clr), U6.15 (Clr)
unnamed: U3.9 (RC7), U5.13 (D), U6.13 (D)
unnamed: U5.4 (Q0), U7.2 (G1)
unnamed: U5.5 (Q1), U7.5 (G2)
unnamed: U5.6 (Q2), U8.2 (G1)
unnamed: U5.7 (Q3), U8.5 (G2)
unnamed: U5.9 (Q4), U9.2 (G1)
unnamed: U5.10 (Q5), U9.5 (G2)
unnamed: R7.1, U7.6 (D1)
unnamed: R8.1, U7.3 (D2)
unnamed: R9.1, U8.6 (D1)
unnamed: R10.1, U8.3 (D2)
unnamed: R11.1, U9.6 (D1)
unnamed: R12.1, U9.3 (D2)
unnamed: R13.1, U10.6 (D1)
unnamed: R14.1, U10.3 (D2)
unnamed: U5.11 (Q6), U10.2 (G1)
unnamed: U5.12 (Q7), U10.5 (G2)
unnamed: R15.1, U11.6 (D1)
unnamed: R16.1, U11.3 (D2)
unnamed: U6.4 (Q0), U11.2 (G1)
unnamed: U6.5 (Q1), U11.5 (G2)
unnamed: R17.1, U12.6 (D1)
unnamed: R18.1, U12.3 (D2)
unnamed: U6.6 (Q2), U12.2 (G1)
unnamed: U6.7 (Q3), U12.5 (G2)
unnamed: R19.1, U13.6 (D1)
unnamed: R20.1, U13.3 (D2)
unnamed: U6.9 (Q4), U13.2 (G1)
unnamed: U6.10 (Q5), U13.5 (G2)
unnamed: R21.1, U14.6 (D1)
unnamed: U6.11 (Q6), U14.2 (G1)
unnamed: U6.12 (Q7), U14.5 (G2)
Servo: R6.2, U3.5 (RC5)

Notes on the sheet:
Servo Power
Remote Control
Vpp Vdd Vss PGD PGC
Com Grn Yel Red
Button 2
Screw Terminal
Program
+12V +12V GND GND A A B B
Status LED 2
Button 1
Frog and Ladder Power Switching
Status LED 1
Logic Power
System LED
Signal Head Connectors Common Anode

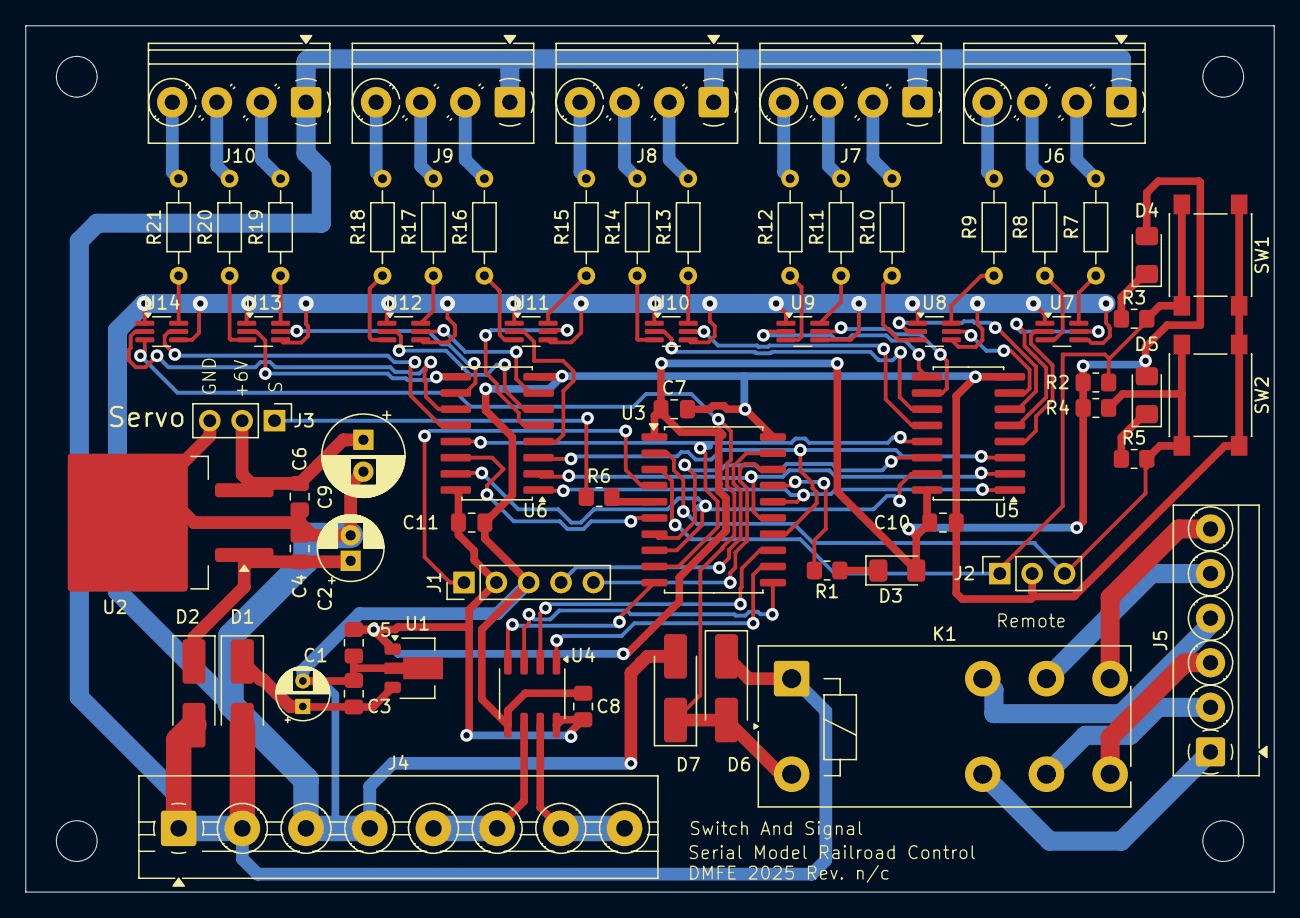
[picture p41: board SMRRC_SwitchAndSignal.kicad_pcb from above]

Board: 2 copper layers, 98.0 x 68.0 mm, 70 parts (0 on the bottom side), 83 nets.
