DavidMFlynn/SerialMRRC/Packet Serial Daughter Board/SMRRC_PacketSerial.kicad_pcb

## KiCad design Packet Serial Daughter Board/SMRRC_PacketSerial.kicad_pcb (2025-03-24)

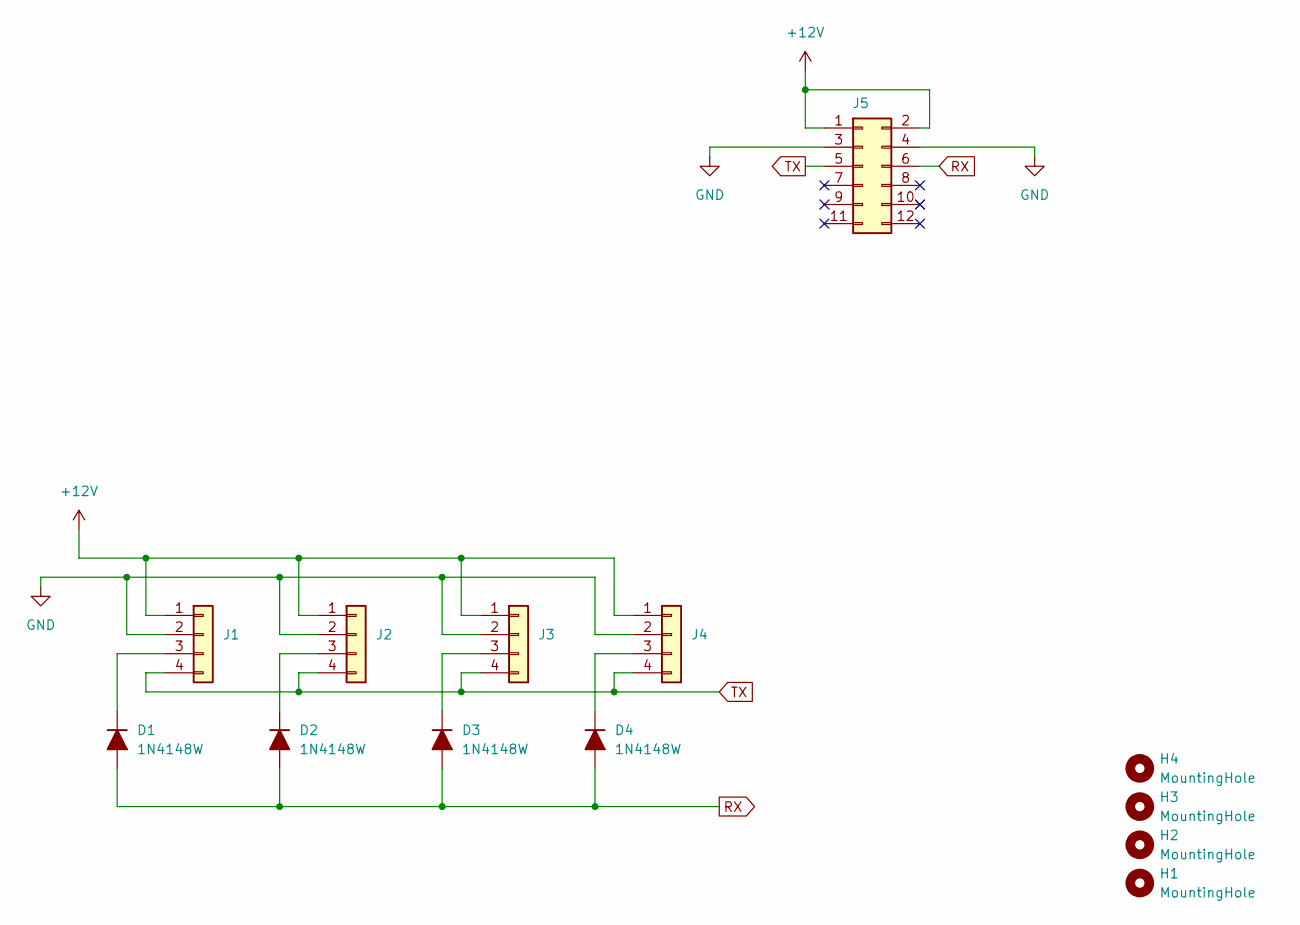
[picture p42: schematic SMRRC_PacketSerial.kicad_sch, Serial Model Railroad Control]

Parts:
D1, D2, D3, D4: 1N4148W; D_SOD-123
H1, H2, H3, H4: MountingHole; MountingHole_3.2mm_M3
J1, J2, J3, J4: Conn_01x04; PinHeader_1x04_P2.54mm_Horizontal
J5: Conn_02x06_Odd_Even; PinHeader_2x06_P2.54mm_Vertical

Connections:
+12V: J1.1, J2.1, J3.1, J4.1, J5.1, J5.2
GND: J1.2, J2.2, J3.2, J4.2, J5.3, J5.4
unnamed: D1.1 (K), J1.3
unnamed: D2.1 (K), J2.3
unnamed: D3.1 (K), J3.3
unnamed: D4.1 (K), J4.3
RX: D1.2 (A), D2.2 (A), D3.2 (A), D4.2 (A), J5.6
TX: J1.4, J2.4, J3.4, J4.4, J5.5

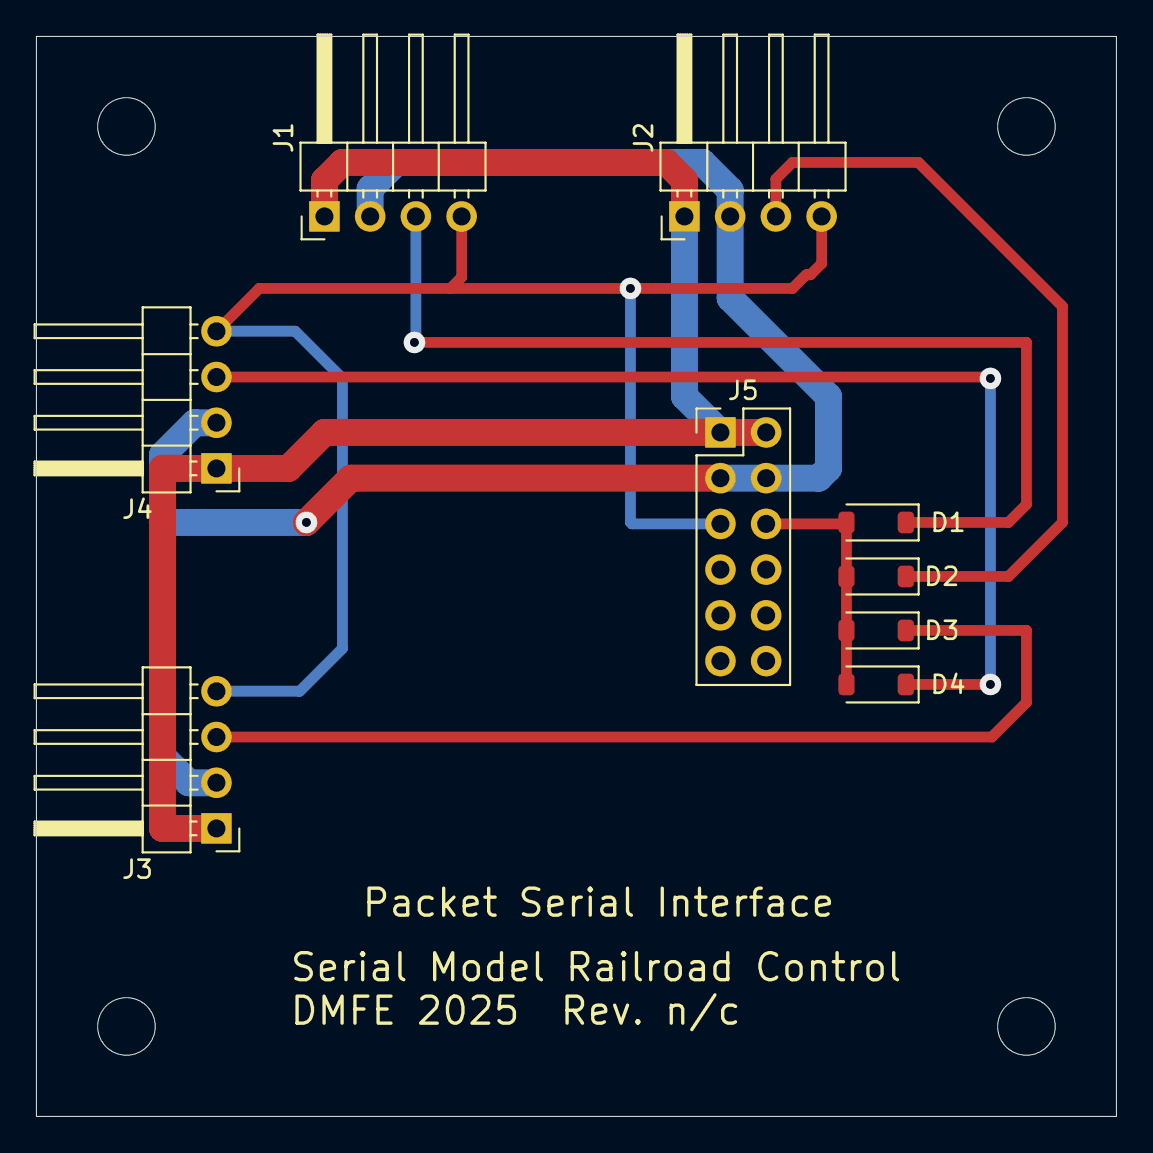
[picture p43: board SMRRC_PacketSerial.kicad_pcb from above]

Board: 2 copper layers, 60.0 x 60.0 mm, 13 parts (0 on the bottom side), 8 nets.
