DavidMFlynn/SerialMRRC/Lights Daughter PCB/Lights.kicad_pcb

## KiCad design Lights Daughter PCB/Lights.kicad_pcb (2025-03-24)

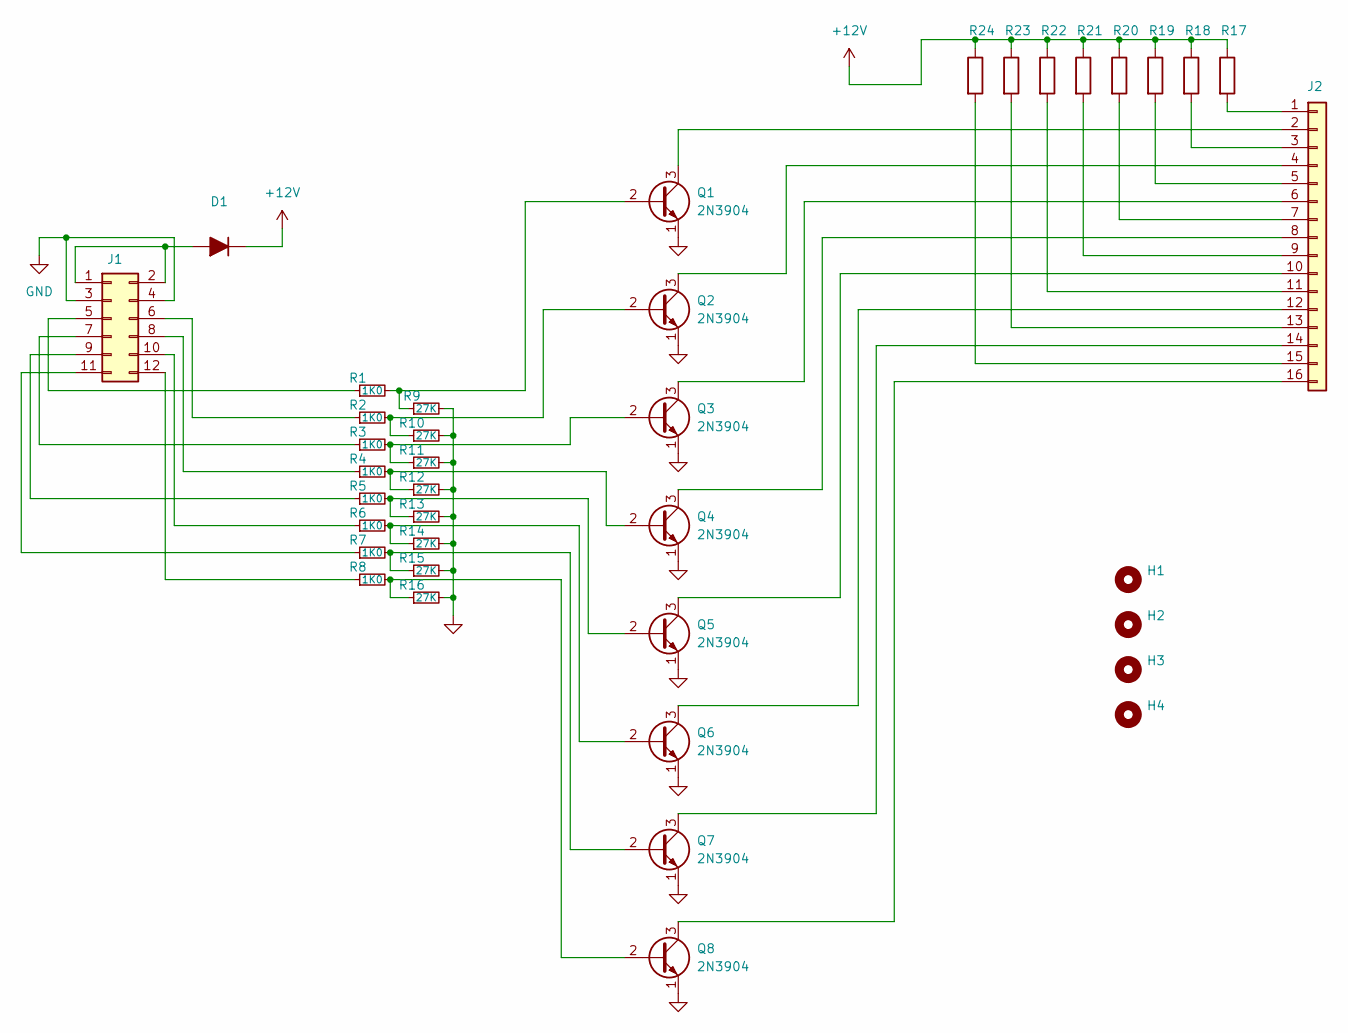
[picture p44: schematic Lights.kicad_sch, Serial Model Railroad Control]

Parts:
D1: SMA; D_SMA_Handsoldering
H1, H2, H3, H4: MountingHole; MountingHole_3.2mm_M3
J1: Conn_02x06_Odd_Even; PinHeader_2x06_P2.54mm_Vertical
J2: Conn_01x16; TerminalBlock_Phoenix_PT-1,5-16-3.5-H_1x16_P3.50mm_Horizont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
Q1, Q2, Q3, Q4, Q5, Q6, Q7, Q8: 2N3904; TO-92_Inline
R1, R2, R3, R4, R5, R6, R7, R8: 1K0; R_0805_2012Metric_Pad1.20x1.40mm_HandSolder
R9, R10, R11, R12, R13, R14, R15, R16: 27K; R_0805_2012Metric_Pad1.20x1.40mm_HandSolder
R17, R18, R19, R20, R21, R22, R23, R24: 1K0; R_Axial_DIN0207_L6.3mm_D2.5mm_P10.16mm_Horizontal

Connections:
+12V: D1.1 (K), R17.1, R18.1, R19.1, R20.1, R21.1, R22.1, R23.1, R24.1
GND: J1.3, J1.4, Q1.1 (E), Q2.1 (E), Q3.1 (E), Q4.1 (E), Q5.1 (E), Q6.1 (E), Q7.1 (E), Q8.1 (E), R9.2, R10.2, R11.2, R12.2, R13.2, R14.2, R15.2, R16.2
unnamed: D1.2 (A), J1.1, J1.2
unnamed: J1.5, R1.1
unnamed: J1.6, R2.1
unnamed: J1.7, R3.1
unnamed: J1.8, R4.1
unnamed: J1.9, R5.1
unnamed: J1.10, R6.1
unnamed: J1.11, R7.1
unnamed: J1.12, R8.1
unnamed: J2.1, R17.2
unnamed: J2.2, Q1.3 (C)
unnamed: J2.3, R18.2
unnamed: J2.4, Q2.3 (C)
unnamed: J2.5, R19.2
unnamed: J2.6, Q3.3 (C)
unnamed: J2.7, R20.2
unnamed: J2.8, Q4.3 (C)
unnamed: J2.9, R21.2
unnamed: J2.10, Q5.3 (C)
unnamed: J2.11, R22.2
unnamed: J2.12, Q6.3 (C)
unnamed: J2.13, R23.2
unnamed: J2.14, Q7.3 (C)
unnamed: J2.15, R24.2
unnamed: J2.16, Q8.3 (C)
unnamed: Q1.2 (B), R1.2, R9.1
unnamed: Q2.2 (B), R2.2, R10.1
unnamed: Q3.2 (B), R3.2, R11.1
unnamed: Q4.2 (B), R4.2, R12.1
unnamed: Q5.2 (B), R5.2, R13.1
unnamed: Q6.2 (B), R6.2, R14.1
unnamed: Q7.2 (B), R7.2, R15.1
unnamed: Q8.2 (B), R8.2, R16.1

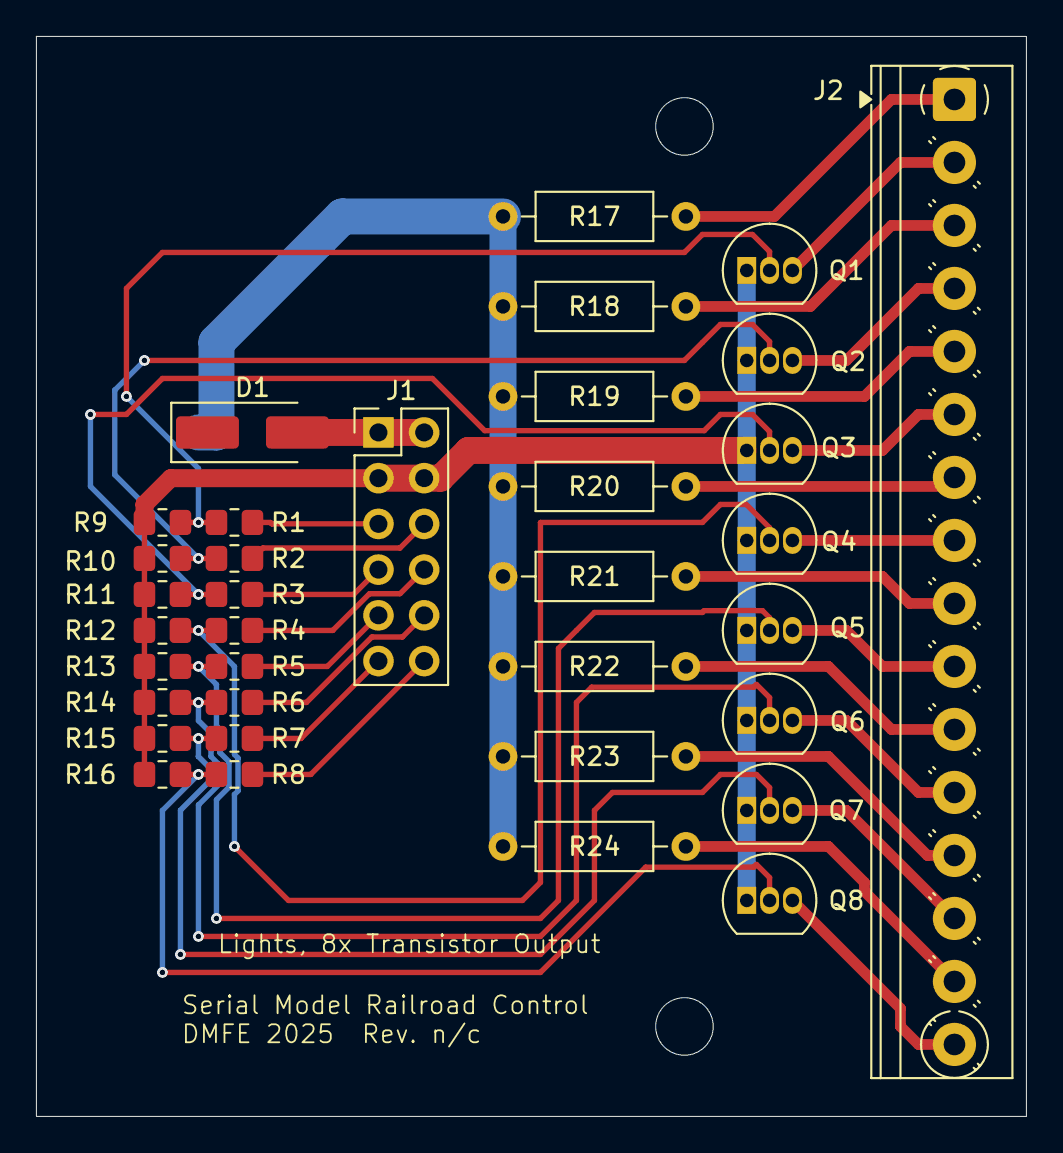
[picture p45: board Lights.kicad_pcb from above]

Board: 2 copper layers, 55.0 x 60.0 mm, 37 parts (0 on the bottom side), 35 nets.
