DavidMFlynn/SerialMRRC/(commit log)

2025-03-23 Main Schematic
    [8-bit PIC MCU-2025-03-23.csv, SMRRC.kicad_pcb, SMRRC.kicad_sch]
2025-03-24 packet serial intf added
    [SMRRC_PacketSerial-B_Cu.gbr, SMRRC_PacketSerial-B_Mask.gbr, SMRRC_PacketSerial-Edge_Cuts.gbr, SMRRC_PacketSerial-F_Cu.gbr, SMRRC_PacketSerial-F_Mask.gbr, SMRRC_PacketSerial-F_Silkscreen.gbr, SMRRC_PacketSerial-job.gbrjob, SMRRC_PacketSerial.drl]
2025-03-25 worked on switch machine pcb
    [SMRRC_SwitchAndSignal.kicad_pcb, SMRRC_SwitchAndSignal.kicad_sch]
2025-03-27 Switch and Signal
    [SMRRC_SwitchAndSignal-B_Cu.gbr, SMRRC_SwitchAndSignal-B_Mask.gbr, SMRRC_SwitchAndSignal-B_Silkscreen.gbr, SMRRC_SwitchAndSignal-Edge_Cuts.gbr, SMRRC_SwitchAndSignal-F_Cu.gbr, SMRRC_SwitchAndSignal-F_Mask.gbr, SMRRC_SwitchAndSignal-F_Silkscreen.gbr, SMRRC_SwitchAndSignal.drl]
2025-03-29 signal leds
2025-03-31 Signal Head
    [SignalHead3-B_Cu.gbr, SignalHead3-B_Mask.gbr, SignalHead3-B_Silkscreen.gbr, SignalHead3-Edge_Cuts.gbr, SignalHead3-F_Cu.gbr, SignalHead3-F_Mask.gbr, SignalHead3-F_Silkscreen.gbr, SignalHead3.drl]
2026-07-09 Working on SM control
    [SMRRC.kicad_pcb, SMRRC.kicad_sch, SMRRC_Switch.kicad_pcb, SMRRC_Switch.kicad_sch, SMRRC_SwitchAndSignal.kicad_sch, ServoSM.scad, SignalHead3.kicad_sch]
2026-07-11 Switch machine PCB done
    [SMRRC_Switch.kicad_pcb, SMRRC_Switch.kicad_sch]
2026-07-14 Input 32 sent to fab
    [Input32DC.kicad_pcb, Input32DC.kicad_sch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]
2026-07-15 Worked on Output 32
    [Input32DC.csv, Output32DC.kicad_sch]
2026-07-15 Output 32 sent to fab
    [Output32DC.kicad_pcb]
2026-07-15 added to readme
    [SMRRC_PacketSerial-B_Cu.gbr, SMRRC_PacketSerial-B_Mask.gbr, SMRRC_PacketSerial-Edge_Cuts.gbr, SMRRC_PacketSerial-F_Cu.gbr, SMRRC_PacketSerial-F_Mask.gbr, SMRRC_PacketSerial-F_Silkscreen.gbr, SMRRC_PacketSerial-job.gbrjob, SMRRC_PacketSerial.drl]
2026-07-25 Good test of USB to RS485
    [SMRRC.kicad_pcb, SMRRC.kicad_sch, SMRRC_Servo8.kicad_pcb, SMRRC_Servo8.kicad_sch, SMRRC_Switch.csv, SMRRC_USB.kicad_pcb, SMRRC_USB.kicad_sch]
2026-09-27 Block Relay Schematic
    [BlockRelay.kicad_pcb, BlockRelay.kicad_sch]
2026-09-28 worked on block relay pcb
    [BlockRelay.kicad_pcb, BlockRelay.kicad_sch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]
2026-10-02 Block Relay ready to print
    [BlockRelay.kicad_pcb, BlockRelay.kicad_sch]
2026-10-02 reorg dirs
    [DCC_Detector.kicad_pcb, DCC_Detector.kicad_sch]
